nyanko3141592/pendant-recorder/firmware/README.md

# Firmware authority

現行製品ファームの正本は [`stm32/`](stm32/) です。

このディレクトリ直下の `platformio.ini`、`include/`、`src/` は初期XIAO ESP32S3評価用の履歴スタブで、現行PCB、製造書込み、回帰試験の入力ではありません。ビルド、発注、動作判定に使用しないでください。
