nyanko3141592/pendant-recorder/mechanical/rounded-v6/README.txt

丸み付き v6 / 外観・サイズ・持ち心地の印刷試作

外形: 26 x 31 x 14 mm（v5と同じ）
四隅: R5 mm、表裏の縁: R3 mm。紐穴は丸めた縁を避けて内側へ移動。
USBの位置を示す浅い凹み付き。これは完成ケースではなく中実の外観ダミー。

おすすめ印刷:
print/rounded_front_half_print_flat.3mf
print/rounded_back_half_print_flat.3mf
上記2点を100%・mmで印刷。モデルは分割面をベッド側、Z=0に配置済み。
0.2mm積層、3周程度の壁、15%程度のインフィルを初期目安に、スライサーで確認。
平面同士を合わせ、紐穴を揃えて薄い両面テープ等で仮固定する。
2枚の厚さ合計14mm。テープ厚は追加される。嵌合ピン・爪はない。
USB凹みの上面はブリッジになるのでスライサーで確認。

一体版: print/rounded_whole_26x31x14.stl / .3mf
一体版は下側の丸みにサポートが必要になる場合がある。
3MFは形状データで、プリンター固有の印刷設定やG-codeは含まない。

収納検討:
公称0.8mm壁を想定した簡易断面包絡のチェックでは、電池とUSB以外の部品包絡は内側。
ただし現行24x27mm基板の角は最大約1.46mm侵入する。USBは専用開口が必要。
基板の角丸化には銅箔・配線の再設計とDRC再検証が必要で、このv6では回路を変更していない。
包絡チェックは完成部品STEPによる厳密干渉検査ではない。
このモデルには電池・基板を収納できない。v5の収納模型と混同しない。
16時間駆動、電池NTC/ハーネス、部品公差、固定方法は従来どおり未確認。

比較画像: 青が今回のv6、灰が旧v5。同じ26x31x14mm。
STL3点の閉メッシュ、接続成分1、正体積、面向き、寸法、Z=0を検証済み。
実印刷、全三角形の自己交差検査は未実施。
