nyanko3141592/pendant-recorder/mechanical/compact-ab/README.md

# A/B SolidCraft study — not a production release

See [review](../../docs/compact-ab-review.md). Run `python3 mechanical/compact-ab/generate.py` then `analyze.py` from the repository. Render JSON using solidcraft-cli run/snapshot. STEP and solidcraft files are generated models, not supplier component CAD. All 75 KiCad footprint envelopes are represented.
