nyanko3141592/pendant-recorder/hardware/rev-e/README.md

# Rev E0 — XE完成電池への回路・配置変更

発注不可。D1.1から別版を作成。J2をMolex0781710003の3ピンに変更（1 BAT、2 BAT_TS、3 GND）。基板NTC TH1を除き、完成電池DTP401525-XEのNTCを利用する回路ドラフト。NTC定数、充電温度適合が未解決であり、BQ25101を採用確定したものではない。

25×31×0.8mm、6層を仮継承、75フットプリント。主要部品はD1.1の配置を基板中心座標へ変換して継承した初期案。**未配線**。回路図はERC0、配置DRC0（未接続を別集計）。配線完成や電気品質の保証ではない。J2の実装調達・全品番の受理・USB帰路・発振・電源を継続レビューする。製造ファイルは出力していない。

`generate.py`はこのE0を再生成し、Eの手編集・配線を上書きする。D1.1は変更しない。生成にはKiCad同梱Pythonを使用する。現時点でEを製造リリースへ昇格させない。
