nyanko3141592/pendant-recorder/mechanical/structure-d1/README.md

# D1 円形ケース・円形基板の構造モデル

2026-10-24。ユーザーの「再設計して再度比較出せ、モデリングも済ませろ」に対応。SolidCraftの組立/分解モデル、STEP、画像を作成した。**製造用筐体の完成ではなく、実配置に基づく構造検討の完成。**

- [同縮尺比較：正面と側面](comparison-scale.png) / [SolidCraft上面比較](comparison.png)
- [分解モデル](exploded.png) / [透過モデル](cutaway.png) / [USB側外観](usb-side.png)
- [実フットプリント配置](placement.png)
- [組立STEP](assembled.step) / [分解STEP](exploded.step)
- [組立SolidCraft](assembled.solidcraft) / [分解SolidCraft](exploded.solidcraft)

## 寸法

| 項目 | 旧C0 | 角丸D0 | 円形D1 | Omi参照 |
|---|---|---|---|---|
| ケース | 23.8×34×14mm | 25.5×25.5×14.5mm | **直径25.5×厚14.5mm** | 直径25.5×厚15mm |
| 基板 | 21×31mm | 23×23mm | **直径23mm** | 今回は比較対象外 |
| 外形体積概算 | 11.28cm³ | 9.28cm³ | **7.41cm³** | 円柱近似7.66cm³ |

D1はD0比約20.2%減、C0比約34.4%減。Omiと直径が同じで厚さは0.5mm小さい設計枠。Omiの実際の曲面/装着部形状とは異なるため「実製品より小さい」とは断定しない。比較図の500円玉は径26.5mmのスケール参照。

## 構造と仮定

基板の全部品位置は `hardware/omi-fit-d1/placement.json` と共通。旧案を円形に切り取った絵ではなく、全76参照を再配置した。U9を小型UQFNへ変更し、USB-Cボディを基板端から張り出させた。USB開口と簡略ソケット口もモデルに含む。

金色はD17×6.1mmの**完成パック目標包絡**。メーカー保証済み完成品ではない。オレンジは保護回路/配線の予約、青緑の小片はPCB実装NTC用の絶縁熱伝導パッド候補。線材予約とC15が当たる配置を修正し、予約位置を(9.4,4.0)mmへ移した。完成ハーネス全体の配線経路は未確定。

基板下面9.1mm/上面9.9mm、電池上面7.3mm、蓋下面13.5mm。裏面部品1.5mmとしたとき電池との名目隙間0.3mm、USB高さ3.2mmとしたとき蓋まで0.4mm。部品は簡略包絡で、全品のメーカーSTEP/公差/はんだフィレットを再現していない。モデルのPCBに全穴を彫り込んだものでもない。

固定爪/ねじ、装着部、マイク音道、LED導光、ボタン延長、実際の電池膨らみ・線材・嵌合は未検証。従って装着部込みの製造外形は未確定、STLをそのまま発注できる段階ではない。

## 電池持ち

[感度分析](runtime.png)は前案と同じ150mAhの仮定。使用可能容量70%・平均5mAで21h、6mAで17.5h。円形化そのものを省電力効果として加算しない。電池・ファーム実測、SPICE、熱シミュレーションは未実施。

## 再生成

`generate.py` → SolidCraft CLIで `assembled.json` / `exploded.json` をrunし、`.solidcraft`とSTEPを保存。`compare.py`は比較CAD、`plots.py`は配置・同縮尺図・稼働時間感度を生成。現状は `hardware/omi-fit-d1/order-status.json` に従い発注不可。
