nyanko3141592/pendant-recorder/mechanical/xe-minimal/home-case-slice-review/README.txt

角丸接着ケース候補・PLA造形検討用（完成設計ではありません）
A1 mini / 0.4mm / Generic PLA / 0.16mm。上下別々、開口を上に配置。
公式プロファイル継承を展開してスライス成功。実際のフィラメント銘柄とプレート設定は使用前に確認。
STLと3MFは現行候補の形状確認用。マイク筒の押出経路、接着面、電池の元配線とプラグ、実物公差は未確認。
上下合計のスライサー推定使用量約2.95g。実測ではありません。プリンタ送信・印刷はしていません。
