nyanko3141592/pendant-recorder/hardware/compact-b/routing-v2/README.md

# Rejected route-only trial

Original placement, longer routing pass budget. Final KiCad9violations,6unconnected,0parity. Not promoted. See electrical-placement-v3 for the improved result.
