nyanko3141592/pendant-recorder/hardware/omi-fit-d1/routing/README.md

# D1配線試行 — 発注不可

2026-10-24。配置だけのD1から4層の配線を試行。現在の正本は上位の `omi-fit-d1.kicad_pcb`。Freerouting 2.5.0の最初の試行を採用し、0.1mm未満のネックダウンを0.1mmに修正した。後続refine試行は未接続が増えたため不採用。

KiCad 10で回路図等価性を含めDRCを実施：未接続53件、違反8件（USB NPTHとの銅箔間隔4件、末端配線4件）、等価性問題0件。`../order-status.json` はPCBハッシュを含む。876というtracks値はビアを含むKiCadオブジェクト数で、完成率ではない。

プロジェクトの最小線幅/クリアランスを0.10/0.10mmへ変更した。検査除外は追加していない。穴クリアランス0.20mmは維持し、現状0.1944mmのUSB違反を残した。JLCPCBの公開多層板能力は0.09/0.09mmだが、この設計のPCBA受理・歩留まりを保証するものではない。

出典（確認2026-10-24）：https://jlcpcb.com/capabilities/Capabilities

自動配線が通った部分も、電源電流・デカップリング経路・USB差動対・水晶・マイククロック・GND帰路をレビューしていない。単なるDRC通過を設計完了にしない。回路の機能検証も未了。現在の部品配置は幾何的収納を優先したもので、電気的な再配置が必要になる可能性がある。

`route.py` のexportは旧試行条件を書き戻すため、正本に無条件で再実行しない。`place.py` も配線を失う。試行ファイルは再現・比較用で製造入力ではない。

孤立ビア4個を除去した結果、接続先を持たない末端配線4件が残る。未接続の経路を確定してから処理する。
