nyanko3141592/pendant-recorder/hardware/xe-minimal/preorder-20261029/release-review-20261029-aligned/first-prototype/README.md

# 初号試作の入口 — 2026-10-29

**採用する設計は一つ。回路・基板は b3cdfc064b43…の27.5mm角4層、固定DTP401525-XE 110mAh、保存MKDV8GIL-AST。C30のみ同定格のFH 0402CG500J500NT/C501830へBOM変更。ケースは配線端部を広げた約30.8×37.5×14.2mm。** 注文・支払・製造upload・業者連絡・実印刷は実施していない。

## 1. 成立見込みと手配判断

[部品別の計算値と感度](performance.json)では、室温の条件付き平均3.863mA、110mAhの70%使用可能という仮定で19.93時間、60%なら17.09時間。MCUは16MHzで常時Runの典型1.3mAを使用し、Sleep dutyによる有利な削減を入れない。周辺回路0.5mAとその他0.05mAは設計上の仮定。コア典型値を実ファームの保証値と呼ばない。

保存電流40mA/standby0.13mAは**採用部品自身のSD4wire/50MHz/25℃の値**であり、SPI4MHzへ適用できるとの保証はない。10秒周期の活動時間0.35秒を置く。このうちpayloadの線上時間は0.162344秒、残り0.187656秒をFAT・directory・busy等へ見込む。活動0.5秒なら約4.461mA/17.26時間、1秒なら約6.454mA/11.93時間（いずれも70%容量仮定）。0.35秒でも周辺回路が見積りより1mA多ければ約15.84時間。**16時間を狙う試作には合理性があるが、達成確率や最悪条件を証明したものではない。** 平均4.4mAは配分目標で、机上合格に置き換えない。

保存は10秒81,172byte、30時間payload876,657,600byte。FAT32/4KiB・3session端数・最大TMP/次ファイル等を含む必要data領域929,787,904byte。FAT等は別領域。合成媒体の現FatFs試験は既存証拠を利用し、実媒体容量は初回format時に読んで検査する。

[5台費用・購入先・数量](cost-and-supply.json)：部品と計画予備分約$375.34、全体予算**$695～1,045（換算仮定154円/USDで約10.7～16.1万円）**。正式見積ではない。全36電子部品行に単価を割り当て、工程、基板小径孔加算、書込み/format/治具/X-ray、税送料、5個の開発用電池、ケース材料、接着・絶縁材、紐を別枠で含めた。手持ち測定器・PC・プリンタを使用する想定。人件費と新規測定器は含まない。販売価格5,000円の達成は主張しない。

U1/U12/J1はJLCの通常Pre-orderを採用する。初期計画数は7/11/12個、最終必要数は実装ロス計算で置換する。部品支給・個別交渉・購入者のはんだ付けを前提としない。在庫/価格/納期は確約ではなく、**必要部品の入庫を確認してから基板注文**という実行条件。C30は在庫不足だったYAGEOから同じ50pF/50V/C0G/±5%/0402へ変更し、公開実装可能45,731個を確認した。新部品の外形上限をゲージへ追加した。

製造は一般4層・0.8mm・両面Standard PCBA・通常through via。0.15mm孔6本は公開多層能力内の追加料金対象として残す。**初号試作には有償の全経路90Ω認定を要求せず、90Ωを配線目標にした非認定試作**を選ぶ。根拠とリスクは[電気・製造判断](electrical-and-execution.md)。量産USB適合とは別。

## 2. ケースと組立

[同版機構](../mechanical-first-prototype/)に編集用生成スクリプト、STEP/STL、5物体3MF、組立/分解STEP、分解図、組立手順を揃える。旧30.8mm角ケースは保全し、純正配線を除外した旧結果を現物の完成証拠には使わない。

今回の配線モデルは12/15/18mmを対象に、半径約2.89mmのU字通路と根元の直線部分を確保。被覆外径0.8mm・片側余裕0.2mm、線出口/嵌合位置は保守的な**設計仮定**でありメーカー保証値ではない。15±3mmを全て自由曲げ長さにしていない。赤い複数曲線は通路のサンプルで、全長の線を同時に入れるものではない。公式ヘッダの無効STEPは使用しない。

電池は面で底受けし、側方ガイドとキャリアで保持。キャリア裏へ総厚0.10mmの絶縁材を工場貼付し、最大パック上に0.4mmの成長予約を残す。膨張を許容する安全認定値ではない。蓋は6か所の深さ0.15mm接着ポケットと既存の位置決め/停止面を併用し、接着層によって蓋を持ち上げない。PETGと接着剤の実強度はダミーケースで試験する。

## 3. 同期・検証と残条件

[検証結果](verification.json)に基板hash、回路/ERC/DRC、ファーム40試験の現source一致、BOM一致、CAD干渉、3MF寸法、slice結果を集約する。ファームは未変更なので40試験を無目的に繰り返さない。既存ARM出力はNOT-FOR-FLASH fixtureのまま。

| 区分 | 判定 |
|---|---|
| 採用構成・条件付き性能・費用範囲 | 設計判断を記載済み。仮定の実機確認は試作後 |
| 回路/基板/CAM/BOM/CPL | 同版。C30のBOM置換を反映。業者placement preview/DFMは注文時の実行条件 |
| 配線込み機構設計・接着方法・実寸キット | 一案に具体化。寸法仮定内のCAD確認。純正現物の適合は未確認 |
| 実機・安全・16h・30h・3OS・装着・強度 | 未測定。初号試作の評価項目 |
| 書込み済み完成品/製造開始 | **未完**。正式USB ID、初期通電とcutoff設定、実媒体format/identity、工場工程の確定が必要 |

したがって、**条件付きの初号試作設計パッケージであり、直ちに発注できる書込み済み製品パッケージ、物理性能保証、量産releaseではない。** 足りない実物やIDを捏造して全体完成とはしない。必要な次工程は[実行手順](electrical-and-execution.md)にまとめた。

同縮尺の[Omi比較](../mechanical-first-prototype/omi-reference-comparison.png)と比較STEPも同梱。公開2.5×1.5cmから直径25×厚さ15mmと解釈した参考包絡で、製品CADや付属ケース込み寸法は確定していない。本案は平面寸法でOmiより大きい。
