nyanko3141592/pendant-recorder/docs/validation/2026-10-24-rev-c0-design.md

# Rev C0設計検証記録 — 2026-10-24

対象: USB-C、連続録音16h以上、小ささ優先、無線なしの再設計。V1はdocs/v1-scope.md。

|確認|結果|
|---|---|
|KiCad回路図と接続表|76参照、232接続ピン、22 NC、49ネット一致|
|ERC|0|
|PCBと回路図のKiCad等価性|差分0（ネット階層名と基板接点BOM属性を同期）|
|PCB物理パッド所属|260パッド、254論理ピン一致|
|配置|実フットプリント、21×31×0.8mm、4層両面|
|配線|未完了。DRC 5、未接続67。発注不可|
|収納|23.8×34×14mmのCAD案。PH嵌合/未加工線材/音道/NTC/固定/公差は未検証|
|16h録音・36h保存|未実施|
|充電・温度・電源断|未実施|
|暗号化・3 OS同期|本番ファーム/CLI未実装|
|JLC実装受理・購入|未実施|

`hardware/tools/verify_design.py <kicad-cli> rev-c` と KiCad Pythonの `check_rev_c.py` を実行。後者は未達のためexit 2で発注不可を返す。結果・原本SHA256はhardware/rev-c/order-status.json。図面ができたことを実機試験合格と扱わない。

配線試行2回目はルータが違反を報告したため原本へ取り込まず、初回配線＋GND整備・孤立銅除去の版を保持。完全性確認前のGerber/CPLの発注ZIPは出力していない。

次の改版は、USB/電源とデカップリングを手動で再配置・配線、全ピン/公差/部品受理、完成パック・治具・ケースの実寸収納を確認してから進める。現Rev Bと比較して面積を減らした代わりに厚さを増やしたことを残す。
