nyanko3141592/pendant-recorder/hardware/xe-minimal/fabrication-review-d0c7ca1c4a31/drill-report.txt

Drill report for pendant-xe-minimal.kicad_pcb
Created on 2026-10-28T17:00:15

Copper Layer Stackup:
    =============================================================
    L1 :  F.Cu                      front
    L2 :  In1.Cu                    in1
    L3 :  In2.Cu                    in2
    L4 :  In3.Cu                    in3
    L5 :  In4.Cu                    in4
    L6 :  B.Cu                      back

Drill file 'pendant-xe-minimal-PTH.drl' contains
    plated through holes:
    =============================================================
    T1  0.150mm  0.0059"  (220 holes))
    T2  0.200mm  0.0079"  (7 holes))
    T3  0.600mm  0.0236"  (4 holes)  (with 4 slots)

    Total plated holes count 231

Drill file 'pendant-xe-minimal-NPTH.drl' contains
    unplated through holes:
    =============================================================
    T1  0.650mm  0.0256"  (2 holes))
    T2  0.800mm  0.0315"  (1 hole)

    Total unplated holes count 3
