nyanko3141592/pendant-recorder/hardware/omi-fit-d1/manufacturing-review/drill-report.txt

Drill report for omi-fit-d1.kicad_pcb
Created on 2026-10-25T00:14:27

Copper Layer Stackup:
    =============================================================
    L1 :  F.Cu                      front
    L2 :  In1.Cu                    in1
    L3 :  In2.Cu                    in2
    L4 :  In3.Cu                    in3
    L5 :  In4.Cu                    in4
    L6 :  B.Cu                      back

Drill file 'omi-fit-d1-PTH.drl' contains
    plated through holes:
    =============================================================
    T1  0.150mm  0.0059"  (121 holes))
    T2  0.600mm  0.0236"  (4 holes)  (with 4 slots)

    Total plated holes count 125

Drill file 'omi-fit-d1-NPTH.drl' contains
    unplated through holes:
    =============================================================
    T1  0.600mm  0.0236"  (1 hole)
    T2  0.650mm  0.0256"  (2 holes))
    T3  0.991mm  0.0390"  (3 holes))

    Total unplated holes count 6
