nyanko3141592/pendant-recorder/hardware/mini-rect-v15/input-control-pa2-pb5/manufacturing-review/drill-report.txt

Drill report for usb-reference-power.kicad_pcb
Created on 2026-10-26T14:46:47

Copper Layer Stackup:
    =============================================================
    L1 :  F.Cu                      front
    L2 :  In1.Cu                    in1
    L3 :  In2.Cu                    in2
    L4 :  In3.Cu                    in3
    L5 :  In4.Cu                    in4
    L6 :  B.Cu                      back

Drill file 'usb-reference-power-PTH.drl' contains
    plated through holes:
    =============================================================
    T1  0.150mm  0.0059"  (5 holes))
    T2  0.200mm  0.0079"  (131 holes))
    T3  0.600mm  0.0236"  (4 holes)  (with 4 slots)

    Total plated holes count 140

Drill file 'usb-reference-power-NPTH.drl' contains
    unplated through holes:
    =============================================================
    T1  0.650mm  0.0256"  (2 holes))
    T2  0.800mm  0.0315"  (1 hole)
    T3  0.991mm  0.0390"  (3 holes))

    Total unplated holes count 6
