nyanko3141592/pendant-recorder/hardware/xe-minimal/electrical-panel-candidate-v3/fabrication-review-09330db63317/drill-report.txt

Drill report for panel.kicad_pcb
Created on 2026-10-27T08:34:01

Copper Layer Stackup:
    =============================================================
    L1 :  F.Cu                      front
    L2 :  In1.Cu                    in1
    L3 :  In2.Cu                    in2
    L4 :  In3.Cu                    in3
    L5 :  In4.Cu                    in4
    L6 :  B.Cu                      back

Drill file 'panel-PTH.drl' contains
    plated through holes:
    =============================================================
    T1  0.150mm  0.0059"  (1518 holes))
    T2  0.600mm  0.0236"  (24 holes)  (with 24 slots)

    Total plated holes count 1542

Drill file 'panel-NPTH.drl' contains
    unplated through holes:
    =============================================================
    T1  0.500mm  0.0197"  (72 holes))
    T2  0.650mm  0.0256"  (12 holes))
    T3  0.800mm  0.0315"  (6 holes))
    T4  2.000mm  0.0787"  (3 holes))

    Total unplated holes count 93
