nyanko3141592/pendant-recorder/hardware/xe-minimal/preorder-20261029/release-review-20261029-aligned/drill-report.txt

Drill report for pendant-review.kicad_pcb
Created on 2026-10-29T13:47:25

Copper Layer Stackup:
    =============================================================
    L1 :  F.Cu                      front
    L2 :  In1.Cu                    in1
    L3 :  In2.Cu                    in2
    L4 :  B.Cu                      back

Drill file 'pendant-review-PTH.drl' contains
    plated through holes:
    =============================================================
    T1  0.150mm  0.0059"  (6 holes))
    T2  0.200mm  0.0079"  (139 holes))
    T3  0.600mm  0.0236"  (4 holes)  (with 4 slots)

    Total plated holes count 149

Drill file 'pendant-review-NPTH.drl' contains
    unplated through holes:
    =============================================================
    T1  0.650mm  0.0256"  (2 holes))
    T2  0.800mm  0.0315"  (1 hole)

    Total unplated holes count 3
