nyanko3141592/pendant-recorder/hardware/xe-minimal/preorder-20261029/release-review-20261029-aligned/evidence/xe-integrated-16h-budget.md

# DTP401525-XE 統合16時間電流予算

状態: **配分値は未実測。初号試作の条件付き見積りは first-prototype/performance.json。実機性能合格とは別。**

## 配分値の扱い（初号試作判断は別の部品別見積りを参照）

DTP401525-XE（110mAh）と要件は維持する。最終機の録音中平均電池電流を **4.4mA以下**、かつ本体充電後から録音停止電圧までに使える容量を **70.4mAh以上**にできれば16時間に届く。ただし現状の2.8mA非ストレージ値は配分仮説で、完成品の保守的上限計算はない。CPUをMSIS 16MHz、SPIをPCLK2へ移して録音中の不要なHSI16常時動作を削除したが、削減量と16時間は未実測である。

| 境界 | 値 | 扱い |
| --- | ---: | --- |
| 公称容量だけの理想上限 | 6.8750mA | 劣化・低温・終止電圧等を含まず設計値にしない |
| 70%使用可能仮定の上限 | 4.8125mA | 計画上限、未保証 |
| 採用する平均電流目標 | 4.400mA | 16hで70.4mAh |
| 完成パック瞬時電流上限 | 110mA | パルス超過を認めない |

## 録音・暗号化・保存

16kHz・モノラル、10秒ごとにage v1で暗号化し、現行codec実行で81,172byte/10秒を確認。30時間の暗号化payloadは876,657,600.0byte。選定MKDV8GIL-ASTは8Gbit＝1GB公称。3 sessionの端数・4KiB割当・ディレクトリ・中断/次ファイル余裕を含む必要data領域は929,787,904byteで、FAT等は別に必要。実媒体の全容量・電流・起動ピークは未認定。旧20%余裕の数値は現設計の合格条件に使わない。

## 4.4mAの配分

| 負荷 | 配分/下限 (mA) | 証拠の強さ |
| --- | ---: | --- |
| 非ストレージ基礎枠 | 2.800000 | 配分仮説、未実測 |
| └ 公開最大値を明示できたマイク・充電IC・比較器 | 0.386500 | 各資料の限定条件。完成品全条件の上限ではない |
| └ MCU・IMA・age・レギュレータ・スイッチ等の残余枠 | 2.413500 | 実ファームで測定必須 |
| 温度guard・BOR | 0.100725 | 回路上の予備枠 |
| 表示LED（通常録音） | 0.000000 | 自動表示無効のリリース構成。故障表示は別状態 |
| ストレージ総枠 | 1.499275 | 完全な10秒周期で積分して判定 |
| └ payload転送だけの条件付き下限 | 未確定 | CSNP32は別部品のため現部品の根拠に使わない |
| └ command/metadata/busy等の残枠 | 未確定 | 現MKDV8GIL-ASTの全周期積分が必要 |

2.8mAを実測値として扱わない。最終判定は電池側の全セッション積算を正とし、内訳測定は原因分離に使う。

## 試作合格ゲート

1. 本体充電から開始した完全な16時間録音で電池側積算70.4mAh以下、かつ16時間を通して録音継続。
2. 温度・電池個体・経時条件を含む最悪条件でも16時間合格。満たさなければ平均電流を下げ、容量要件は変更しない。
3. 電池電流は常時110mA以下。保存起動・書込みでリセット、音声欠落、破損なし。
4. 全10秒区間を復号・連結検査し、連番欠落と時刻連続性を確認。
5. 選定保存部品をほぼ満杯・断片化状態でも30時間、電源断復旧を含めて合格。

詳細な機械可読値と出典hashは `xe-integrated-16h-budget.json` に記録した。
