nyanko3141592/pendant-recorder/THIRD_PARTY_NOTICES.md

# Third-party materials

本リポジトリの独自コード・設計ソース・ドキュメントはルートのMITライセンスで公開します。第三者のファイルと権利表示は上書きしません。

- `reference/omi/`: BasedHardware/omiからの参照資料。元の通知は `reference/omi/LICENSE-omi-root.txt`、取得元・対応は `reference/omi/README.md` を参照。改変していない参照資料です。
- KiCad標準フットプリントをPCBへ埋め込み、標準3Dモデルを外部参照しています。ルートMITをKiCadライブラリそのものへ再適用しません。配布時は使用ライブラリのライセンス・例外・必要通知を確認します。
- Whisper実装・モデル重み・将来の要約モデルのライセンスは各配布元に従います。モデル重みは現リポジトリに同梱していません。アプリ同梱・商用配布前にモデルごとに権利と通知を確認します。
- データシートへのリンクは設計根拠です。メーカーの資料・商標をこのプロジェクトのMITで再許諾するものではありません。

依存物全体のライセンス監査は未完了です。新たな第三者素材を追加する際は、出典、バージョン、ライセンス、変更有無をここに追記してください。
