nyanko3141592/pendant-recorder/docs/density-study.md

# 非円形の高密度配置 — 履歴検討

> **履歴資料・発注禁止。** Rev A1、20×34mm、24時間、旧充電設定は失効済み。現行候補は [`requirements.md`](requirements.md) と [`hardware/xe-minimal/active-design.json`](../hardware/xe-minimal/active-design.json)を正本とする。

> 最新: [既製電池の調達を起点に最小化](battery-sourcing.md)。DTP401525(PHR) 110mAhを第一候補とし、外形24×24×14mm・基板21×21mmへの固定を解除。メーカー最大充電55mAに対する現回路50mAの公差確認は未完了。

2026-10-24: ユーザー指示「円形じゃなくてもいいよ、密度上げて」。円形基板・円形ケースの制約を解除する。Omi相当の小ささ、連続24時間録音、USB-C直挿し、充電のみ、全インジケーター、個人での最終組立は維持する。

## 初期配置枠

外観を先に固定せず、角丸四角を第一の配置検討枠とする。以下は寸法予算であり、実部品の配置・配線で成立を確認したサイズではない。

| 比較 | 外形の検討寸法 | 正面面積 | 外形容積の概算 |
|---|---|---:|---:|
| 以前の円形案 | 直径25.5×厚さ15mm | 約511mm² | 約7.66cm³ |
| 第一検討: 角丸四角 | 24×24×厚さ14mm、平面の角R4 | 約562mm² | 約7.87cm³ |
| 比較: 角丸長方形 | 22×26×厚さ14mm、平面の角R3 | 約564mm² | 約7.89cm³ |

四角案は円形案とほぼ同じ外形容積で、幅・高さが24mm、厚さが1mm減る予算。角に基板領域を確保できる。面積は `幅×高さ−(4−π)×角R²`、容積はその面積×厚さ。表面の丸み、紐取付部などは含まない。容積が同程度でも装着感が同じになるとは限らない。

基板の第一検討枠は**21×21mm、角R3、4層、両面実装可**。面積約433mm²で、以前の直径22mm基板の約380mm²に対して約14%多い。これは配線可能面積の保証ではなく輪郭面積の比較。USB・固定・音孔・部品間隔で実際の有効面積は減る。

## 密度を上げる実装方針

1. MCU、SD NAND、電源、マイクを単一基板にまとめ、モジュール間コネクタを設けない。MCUの実装面積は本体だけでなくランド・配線引出しまで含めて比較する。
2. 部品は両面へ配置可能とする。電池下の高い部品を避け、電池のタブ・保護回路・絶縁を含めた立体配置で検討する。
3. USB-Cは一辺に置き、ケーブル根元と固定脚の空間を最初に確保。マイク音孔と音響シール、LED遮光、操作ボタンは残り隙間へ無理に押し込まない。
4. 書込み端子はSWDパッドと外部ポゴ治具。測定点もパッド化し、常設ピンヘッダは装着用に載せない。通電後に測定できる位置を確保する。
5. 抵抗・コンデンサは現回路の0402級を基本に業者実装。0201やHDIで無理に縮める前に配置とパッケージ選択を詰める。MCU小型化は端子・SDMMC・通常ビアでの引出し・業者対応を確認して決定する。
6. ケースはシンプルな3Dプリント。角丸輪郭は内部配置から調整し、固定部と電池の余裕を削って密度を稼がない。

最新目標は連続24時間。平均2.0mA以下・100mAh級を初期候補に80〜150mAhを比較する（[電力予算](runtime-target.md)）。16mm径の既存セル候補を比較基準として残すが、角形パウチも調達・容量・保護付きパック寸法を調べて比較する。**角形にしただけで容量や録音時間が増えるとは扱わない。** 210mAh・24mm径の比較セルはこの24mm外形には収まらないので、旧28mm径案と同様に外形拡大が必要。

## 次の設計ゲート

実部品のフットプリントとパック図面を確定→21×21mm枠で両面配置→USB・音孔・固定部を含む3D干渉確認→配線・DRC→小ロット実装可否の確認。LQFP64の現回路ドラフトがこの枠に収まることはまだ確認していない。

本書は形状制約と配置予算の更新。PCBの配置・配線は未実施であり、実装密度を実測・実CADで改善済みという意味ではない。

## 薄型化の追加要件（2026-10-24）

ユーザー指定により、Omi相当の厚さを上限にする。Omi公式の2.5cm×1.5cm表記に基づき、暫定の完成厚さ上限を15.0mmとする。製品外装・蓋・突出部を含め、旧構造説明モデルの15.2mm案は採用しない。設計目標は12〜13mm、成立未確認。公式: https://www.omi.me/pages/product

薄型化はケースだけを薄くするのではなく、以下の配置変更を検討する。

1. 電池直上の基板裏面を部品禁止領域にし、裏面部品のための高さを削る。部品は表面と電池周囲へ集める。現在の自動配置には適用されていない。
2. PH端子・挿入済みプラグを厚さの支配部品として実寸監査する。電池と重ねず端部に置く案は長さが増えるため、外形容積も比較する。付属100mm配線を省略・切断して成立扱いにしない。
3. LQFP64は本体10mm角でパッドを含め約13.45mm角を使う。SDMMCを備えた小型パッケージへの変更で、デカップリング込みの表面集約を検討。新パッケージの端子・調達・JLC実装受理を確認するまで採用確定しない。
4. 電池最大4.2mm＋基板0.8mm＋表面部品最大高さ＋底/蓋＋絶縁・膨張・組立余裕で厚さを積算する。裏面部品をなくすだけで、現モデルの基板下1.8mmの一部を削れる。ただし電池上の余裕はゼロにしない。

24時間録音と手はんだゼロは維持。12〜13mmは新たな設計目標であり、未配線A1や現3Dモデルが成立した寸法ではない。

### A2モデル追加

[薄型構造モデル](../mechanical/structure-a2/README.md)を作成。PH端子を電池の端に並べ、90部品の表面配置枠を確保する機械案。仮外形24.8×41.5×12.8mm。厚さ15.8%減・外接容積4.9%減、平面面積12.9%増。A1回路・未配線PCBは変更していない。完成厚さや電池プラグ/配線収納の成立は未確認。
