nyanko3141592/pendant-recorder/docs/open-questions.md

# 未決事項

> **履歴資料。** 以下は初期XIAO/ESP32/Rev A検討時の質問で、現行候補の未決一覧ではない。現行の未確認事項は [`validation/xe-release-evidence-matrix.json`](validation/xe-release-evidence-matrix.json) と [`prototype-v1-order-decision.json`](prototype-v1-order-decision.json)を正本とする。
1. 実際の平均電流: ESP32S3で低いクロック＋声の検知にしたとき、平均がいくつになるか（目標30mA以下）
2. 電池の容量と重さ: 何mAh・何gまでなら首から下げて苦にならないか
3. 常時録音か、声の検知か: 検知で言葉の頭が切れないか（前後に1〜2秒残すバッファが必要）
4. マイクの音質: 服にこすれる音、歩くときの揺れ、会議室での相手の声の拾い方
5. USB MSCのコピー速度: 1日分（約1.8GB）にかかる時間。遅ければカードを抜く運用にするか
6. 時刻: Macから時刻を渡す方式で十分か、外付けRTCを入れるか
7. ESP32S3のVBUS検知ピンと、電池電圧を読むピンの有無（XIAOの回路図で確認）
8. nRF52840へ移るかの判断基準（例: 実測で平均40mA超なら移る）
9. 録音の同意とプライバシー: 職場・家族・外出先での扱い、録音中を示す表示
10. SDのデータの暗号化をするか（落としたときの対策）
11. Mac側: どの要約モデルを使うか、Notionのどのデータベースに保存するか

## Omi-cloneパス追加分（2026-10-24）
12. Bパス（XIAO nRF52840 Sense）で録音＋SD書き込み時の平均電流（Omiに公開の実測値なし）
13. 保存形式: WAV か Opus（Omiは32kbps CELT）か。Opusならコンテナ（Ogg）をどうするか
14. Zephyr USB MSC と SPI SD の組み合わせのコピー速度（DK2はSPI 24MHz）
15. T5838のAAD（音で起動）をXIAO構成に後付けするか
16. DK2の「offline storage は実験的」部分の安定性（Omi firmware/readme.md の注意書き）
17. Omi DK1の電池容量・XIAO内蔵マイクの型番（Omi側資料に記載なし）
18. 本番基板: nRF5340を使うか nRF52840 で十分か（BLE/Wi-Fiは不要）

## カスタム基板の追加分（2026-10-24, 要件確定後）
19. STM32U535の録音中の実平均電流（ADF＋LPDMA＋間欠SDMMC）。目標1.5mA、上限3mA
20. nRF52840カスタム基板との差は実測でどれくらいか（差が小さければOmiコード流用のnRF52840へ切替）
21. ADPCM（4bit）が kotoba-whisper の精度に影響するか（PCMと同じ音で比較）
22. USB FS MSC の実効速度（1日分0.46GBが10分以内か）。足りなければUSB HS内蔵のSTM32U5上位品を検討
23. USB接続中の充電電流とシステム電流の配分（BQ25101はパワーパスなし）
24. SD NAND の待機150µAを、ロードスイッチで切って再初期化する方が得か
25. 小型ボタン型LiPo（70〜100mAh）の入手先と重さ
26. T5838 を1個か2個か（こすれ音・相手の声）
27. STM32U5 で ADF の音声検知と T5838 AAD のどちらを使うか
28. ファームを STM32Cube（USBX）で書くか Zephyr で書くか（Zephyr ならOmiの構成知識を流用しやすい）
