nyanko3141592/pendant-recorder/docs/v1-scope.md

# 小型USBレコーダーのV1範囲

現在の要件は[製品要件](requirements.md)へ一本化しました。電池を販売せず、購入者が指定の市販完成電池を別途買い、問い合わせ・配線加工なしで組み立てられることを必須とします。

旧版は[履歴](history/v1-scope-before-user-battery-20261026.md)へ保存しています。旧版を現在の動作・寸法・販売範囲の根拠にしないでください。
