nyanko3141592/pendant-recorder/docs/compact-fit-check.md

# A/B 組立フィット確認キット — FC1 / 2026-10-25

樹脂ダミーを個別に印刷し、ケースへ挿入して取り外し式の蓋を開閉するためのデータ。電気的に動作する試作ではない。元の外形模型は `mechanical/compact-ab/print-size` に保持し、今回のZIPにも `original-size` として同梱する。

成果物: `mechanical/compact-ab/fit-check`。A/B各フォルダの **body・lid・pcb_components・battery** が必須4点。各STLと3MFは同じ形状で、どちらか一方を選ぶ。`harness_reservation` は任意の配線空間ゲージ。組立STEP/PNG、分解STEP/PNG、75部品の寸法CSV、出典スナップショット、検証JSON、再生成スクリプトを添付。

## 寸法と変更理由

|項目 mm|A 横並び|B 積層|
|---|---:|---:|
|元の比較用外形|38×39×8.9|20×39×14.5|
|今回のケース＋閉じた蓋|40×41×10.8|22×41×16.4|
|元との差（幅・長さ・厚さ）|+2・+2・+1.9|+2・+2・+1.9|
|ケース本体高さ|9.6|15.2|
|壁・底・蓋板|1.2|1.2|
|蓋の内側差込みリム高さ／幅|1.2／0.8|1.2／0.8|
|リムとケース内壁の片側隙間|0.3|0.3|
|基板素板|18×33×0.8|18×33×0.8|
|基板下面Z（ケース底外面を0）|3.2|9.0|
|電池ダミー|15.5×27×4.2|15.5×27×4.2|
|電池底Z／上面Z|1.5／5.7|1.5／5.7|
|USB仮包絡の上面Z|7.56|13.36|
|USB包絡〜蓋板下面|2.04|1.84|
|USB包絡〜リム最下面のZ差※|0.84|0.64|

※XYの重なりを無視した保守的な高さ比較。単なる高さ差を最短3D距離とは呼ばない。

FDMで扱える壁、基板を載せる支持部、蓋リム、取り出し隙間を確保するため拡大した。元の外形寸法で収納成立したという結果ではない。蓋は持ち上げて完全に外せる差込み式。爪でロックするスナップ蓋・ヒンジ・首掛け強度の設計ではなく、ケースを水平に置いて繰り返し開閉する確認治具。保持が必要なら外側に仮止めテープを使う。USB開口は包絡を見るための開口で、実ケーブルの樹脂モールド挿入を保証しない。マイク音道、光学部品、紐固定部はこの治具では再現していない。

## 基板と部品の根拠

最新配置 `hardware/compact-b/electrical-placement-v3/compact-b.kicad_pcb` を `source/compact-b-v3.kicad_pcb` に固定コピー。元の基板を変更せず、保存されたPCBからKiCad APIで75フットプリントを再抽出した。`source/provenance.json` にSHA-256、基準コミット6e84b9a、抽出方法を記録。以後の回路改訂を自動追従しない。

部品のXYは `GetBoundingBox(False,False)` の軸平行包絡であり、ランド・図形等を含む。メーカーの樹脂ボディ寸法でもメーカーSTEPでもない。最新配置の両面部品位置を反映するが、高さは全75点とも未資格化の仮定。標準0.6mm、U系1.2mm、U4/U6 1.5mm、J1 3.56mm、J2 1.4mm、SW1 1.6mm、J3/TP系0.05mm。高さ表は `component-envelopes.csv`。はんだ、部品最大公差、嵌合後コネクタは含まない。

基板と75部品の包絡は印刷しやすい一つの連結ダミーへブーリアン結合した。基板と部品間の0.01mm重なりは連結用で、外側の名目高さは増やしていない。基板ダミーをケースや電池と一体化していない。75個の微小部品を別々に印刷するキットではない。

電池の15.5×27×4.2mmは既存調査で確認したDTP401525-XE完成パックの最大寸法。現物測定値ではない。参考資料は既存記録の [XE仕様書](https://www.aska-elt.jp/wp-content/uploads/DTP401525-XE.pdf)。電池ダミーに膨張・ラベル・線の出口・端子の精密形状は加えていない。

## 印刷

単位mm、100%。STLには単位メタデータがないので読み込み時に必ずmmを選ぶ。3MFはmillimeterを指定済みだが、プリンタ別プロファイルやサポート設定は含まない。

- ケース本体: 底外面Z=0を下、開口を上。0.4mmノズル、0.15〜0.20mm層、壁3周以上を出発点とする。USB開口上端は約11.6mmのブリッジになるため、ブリッジ品質が不足する機械では開口だけサポートする。底付き支持柱と電池位置決め部は本体と一体。
- 蓋: 配布姿勢のまま広い外面を下、差込みリムを上。サポート不要を想定。組立時は上下を反転。
- 電池: 15.5×27mm面を下。サポート不要。外周を研磨した場合は再計測する。
- 基板＋部品: 配布形状は両面部品があるので、そのまま平置きでサポートなしに印刷しない。推奨はスライサでX軸90°回転し、Y=0の18mm辺を下にして底面へ配置、5〜8mmブリム、両面の張出し部にサポート。精細ダミー用に0.25mmノズル／0.10mm層を推奨。0.4mmノズルでも概形確認はできるが、0.05mmのTP/J3や細部は再現されない。除去痕で包絡が変わるためノギスで確認する。導電・電気接続用ではない。
- ハーネス予約ゲージ／12・15・18mm長さゲージ: 平面を下。予約ゲージは配線の空間を見るための硬いU字形で、実ハーネスの代用品ではない。

PLAまたはPETGで試す。蓋保持力や素材間の摩擦は未試験。初層の象足はリムと電池を太らせるので、スライサ補正を使い、無理に押し込まない。基準は各部品の重要寸法を±0.10mm以内へ校正すること。リムと電池位置決め部の片側名目0.30mmは、両側がそれぞれ0.10mm内側へずれても0.10mm残る予算。未校正プリンタにこの精度を保証しない。噛む場合は拡大縮小で全寸法を変えず、リムの局所補正と再測定を行う。

## 組立と取り出し

ケースを底面から見た座標はX=幅方向、Y=長さ方向、Z=上方向。USB開口がY=41側。図と厳密な変換は `dimensions-and-assembly.json` を参照。

1. ケース内部のサポート材と糸引きを除き、電池ダミーを金色の図示位置へ入れる。AはX=2/Y=6、BはX=3.25/Y=6。底の0.3mm台へ載せる。
2. 基板ダミーはUSBの大きな包絡を開口側へ向け、真上から挿入。Aは基板左前端X=20/Y=5、BはX=2/Y=5。Bでは電池の上に載る。両側の4支持面で素板下面を受け、部品で支えない。
3. 任意のU字ハーネス予約ゲージを前端側に置いて空間を見る。固定脚はないので、指定Z位置に手で保持するか一時スペーサを使う。これを落とし込むだけで実配線が再現されるわけではない。
4. 蓋を反転してリムを下に向け、真上から差し込む。外面がケースと平行に着座するか、押さえなくても浮かないか確認する。指掛かりから持ち上げて外す。
5. 取り出しは蓋→任意ゲージ→基板→電池の順。Bの電池は先に基板を外す。部品包絡をこじって折らない。

## ハーネスの未確定部分

リード15±3mm、Molex781720003→基板0781710003は既存調査値。基板側はフットプリント包絡だけを再現し、プラグの嵌合体積は未資格化。線出口・線長の測定起点・最小曲げ半径・被覆径・抜差し空間が未確認なので、U字ゲージを「実ハーネスの収納合格」と読まない。

U字ゲージは幅1.2×高さ1.2mmの仮通路を直角に折った空間プローブ。実線の急な90°曲げを指示するものではない。Aの仮出口（電池前端中央）とJ2包絡中心の水平差だけでも13.875mmあり、最短12mmリードより長い。従ってAの無加工接続は引き続き未成立。Bも上下の立上り・実端子起点を含めた接続確認が必要。`gauges` の3本は端から端の長さ比較用であり、実端子や柔らかいリードを再現しない。実ハーネスで張力なく曲げられるかを次の判定に残す。

## 検証と合否の範囲

`mesh-validation.json` は各STLの閉鎖辺、向き、単一連結、正体積、退化三角形、実寸、Z=0、および3MFのmm単位を検査する。A/Bの `interference-results.json` は閉じた組立位置で5つの別体のCAD干渉を確認。`withdrawal-validation.json` は蓋→ゲージ→基板→電池の上方取り出しを、各8位置（0.2/0.5/1/2/5/10/20/40mm）で検査した結果。接触する支持面や蓋の着座面は意図したゼロ隙間接触。

検査済みのモデル範囲と数値は同梱JSONを正本とする。連続移動の掃引体積証明、全三角形の自己交差検査、スライサの実経路、実機印刷、実物収納、材料強度、保持力は未検証。回路の検査0件と、機械的な実物適合を混同しない。樹脂ダミーの確認後にも、部品メーカー最大寸法・完成電池・実ハーネス・最終基板で再検証が必要。

発注・支払い・メーカー送信なし。製造リリースではない。

## FC1 検査結果

2026-10-25: 新規13組のSTL/3MFの閉鎖性・向き・連結性・体積・寸法・底面・mm指定が合格。A/Bそれぞれ5別体の閉じた組立で干渉0件・未検査ペア0。上方取り出し32位置ずつも干渉0件。検査スクリプトは生成物へ実行済み。`verification-summary.json` に集約した。元の外形模型2組は別枠で同梱する。

基板スナップショットSHA-256: `bb008b24a45a0788baf1db2e281330f52219dc80b245e856f60debf003f03427`。

## Bambu用1ファイル版

`fit-check/Pendant_AB_FC1_Bambu_single-plate.3mf` にA/Bの必須各4点、U字ゲージ各1点、12/15/18mm長さゲージを独立した13オブジェクトとして配置。元の外形模型はこのプレートから除外。mm・100%、配置は180×180mm範囲内、全品Z=0、部品XY包絡間5mm以上。基板2点はX90°回転済み。Bambu Studio 02.07.01.62のCLIで13オブジェクトがmanifoldとして読み込めることを確認。実機スライスと印刷は未実施。

使用プリンタ・ノズル・フィラメントを選択し、基板にサポートと5〜8mmブリムを設定してからスライスする。プリンタ固有設定やG-codeを含めていない。部品ごとの設定を維持するため、13点を一つの固体に結合しない。配布先: https://drive.google.com/file/d/1XfIcfcTPnIoFeG9OYn47Z07OAXaiqqtG/view
