nyanko3141592/pendant-recorder/docs/procurement/xe-five-unit-current-estimate.md

# XE prototype v1 — 5台分の現行価格算術

> **正式見積りではない。発注禁止。** 公開部品ページと公開実装料金による部分算術で、完全着地額は未取得。

| 項目 | 5台分 USD | 扱い |
|---|---:|---|
| 実装数×公開単価（部品のみ） | 318.31 | PCBA課金を示す見積りではない |
| 実装数算術＋部分実装 | 463.43～474.14 | 公開単価と36/44 feeder仮定 |
| 部品ライブラリ事前購入＋部分実装 | 723.81～734.52 | 公開最低購入数を全行へ適用した保守シナリオ |
| 完全着地額 | **未取得** | 70mmキャリア5枚、POFV、JLC出荷前パネル除去・エッジ検査、書込み、電池、ケース、送料、税等が未算入 |

| 購入者側候補 | 5台分 JPY（税込） | 扱い |
|---|---:|---|
| RNST04BK safety-breakaway cord ×5 | 1,910～2,905 | 国内3販売経路の公開単価。穴適合・離脱試験前なのでUSD総額へ未算入 |

公開価格の大きい項目:

| MPN | JLC | 実装数 | 公開課金数量 | USD |
|---|---:|---:|---:|---:|
| CSNP32GCR01-BOW | C5440134 | 5 | 5 | 200.83 |
| STM32U585CIU6 | C5271026 | 5 | 5 | 61.42 |
| IM69D130V01 | C536262 | 5 | 5 | 20.43 |
| NCP360SNT1G | C603707 | 5 | 19 | 9.52 |
| BQ25185DLHR | C19725033 | 5 | 6 | 9.31 |
| TLV7042DDFR | C2867856 | 5 | 11 | 9.29 |
| TPS22917DBVT | C2680344 | 5 | 25 | 9.25 |
| B3U-1000P | C231329 | 5 | 49 | 9.20 |

`公開課金数量`は公開ページの最低購入数を反映した保守的算術で、PCBA BOMツールの正式課金とは限らない。RNST04BKは単一候補であり採用済みではない。完全額がnullの間は発注可と解釈しない。
