nyanko3141592/pendant-recorder/docs/procurement/xe-production-readiness-2026-10-28.md

# XE量産準備監査 — 2026-10-28

## 結論

**HOLD（発注不可）**。回路・PCBの電気検査はクリーンだが、上位要件を満たした完成品として発注できる状態ではない。注文、支払い、製造データのアップロード、業者連絡は行っていない。

旧 `fabrication-review-1d4b19d9e46e/order-candidate-2026-10-28` は、削除済みUSB制御部品と旧マイク調達経路を含むため全面的に失効している。再利用・アップロード禁止。

## この監査で確定した変更

- U8を手配前提の `IM69D130V01XTSA1 / C9900015304` から、同じ3.3V PDM・5端子構成の通常カタログ候補 `IM69D130V01 / C536262` へ変更した。2026-10-28観測在庫は246、未予約。
- 抵抗・コンデンサは原則としてJLCの通常在庫型番へ固定した。正確なMPN、LCSC番号、対象リファレンスは `xe-production-bom-2026-10-28.csv` を正本とする。
- J3とTP1/2/3/5/6は実装部品ではなく基板パッドなので、調達対象から除外した。
- 固定電池DTP401525-XEのP2白線が内蔵10kΩ NTCであることを公開仕様から確認し、J2 pin2からハードウェア温度比較器へ直結した。TH1と熱伝導パッドを削除し、ユーザー作業とケース依存の熱経路をなくした。
- D6は通常在庫の `TJ-S1005SW4TGLC9Y-A5 / C273600`、R42は130kΩの `RC0402FR-07130KL / C93946`、R10は30kΩの `RC0402FR-0730KL / C138008` へ固定した。充電電圧と終端電流を安全側へ修正し、さらに `NCP360SNT1G / C603707` をU14としてUSB-C直後へ、`TPS2552DBVR-1 / C140331` をU13としてその後段へ統合した。ILIMはINへ直結し、保証50～100mAのラッチオフ制限とする。U13直近のC31/C32各1µF、NCP360入力C33=`GRT155R6YA105KE13D / C6628588`（1µF、35V）を維持する。6/9/12/20V異常入力遮断、電流制限・過渡応答・発振・熱遮断・復帰は未測定。
- NTC配線の通常B.Cu経路を確保するため基板上端を0.5mmだけ拡張し、正本外形を27.5×27.5mmへ変更した。追加の特殊viaはない。ERC/DRC/未接続/回路図パリティは全0。実温度遮断試験前なので充電既定無効を維持する。
- 現行基板ハッシュからローカルCAMレビュー `fabrication-review-d422d8bd227c` を再生成した。68実装位置、PTH 231穴・NPTH 3穴、USB-C固定スロット4箇所、27.5×27.5mm外形、4 POFVを照合済み。これはレビュー資料であり、ZIP化、アップロード、発注許可は行っていない。
- U10をDSBGA-4の `TPS22916CYFPR` から、リード付きSOT-23-6の `TPS22917DBVT / C2680344` へ変更した。CTは未接続、QODはSD_V3へ接続。正本基板は27.5×27.5mm、ケースはcase v4へ同期済みで、ERC/DRC/未接続/回路図パリティは全0。旧24mmケースと旧パネルは失効し、製造パネルはリリース条件合格後にだけ再生成する。
- 正本BOMを再照合し、基板上74リファレンスのうち68をJLC実装部品、J3とTP1/2/3/5/6を部品不要のPCBパッドとして一意に対応させた。基板部品の購入者調達、部品支給、はんだ、圧着、配線加工、熱伝導パッドは不要。ただし固定電池DTP401525-XEはJLC実装境界外であり、現構成では購入者がその正確なコネクタ付き電池を別途調達して無加工で挿す。購入者最終組立は電池、case v4、2～3mm紐である。`check_production_bom_boundary.py`はこの電池例外を明示し、基板部品が境界外へ出た場合を失敗扱いにする。

## 未解決の発注ブロッカー

0. **充電電圧・電流・USB入力制限はCAD統合済み、実機認定待ち** — BQ25185はR42=130k（4.1V公称、保証上限4.1205V）、R10=30k（9–11mA、終端上限1.1mA）。前段の `TPS2552DBVR-1 / C140331` はILIM=INで保証50～100mA、短絡時ラッチオフ、USB電源再投入復帰とする。C31（IN）とC32（OUT）の1µFをU13直近へ配置した。ERC/DRC/未接続/回路図パリティは全0だが、コンデンサ実効容量、異常入力ピーク、過渡応答、発振、USBサスペンド、空電池復帰、電流制限、ラッチ、熱遮断を実機確認するまで充電有効化、製造リリース、発注を行わない。

1. **MCU実機認定・通常在庫未確認** — 正本は `STM32U585CIU6 / C5271026`。同じ非SMPS UFQFPN48、2MB flash/786KB RAM、JLC Economic/Standard実装対応、ST volume production・10年longevityを確認した。ただし現行JLC公開ページは在庫数非表示・Extended扱いで、過去観測在庫37を現行在庫とはみなさない。U585 RNG/OTG_FS/DWC2を含むfull-moduleとconfigured-applicationの非実機リンク成功、DWC2 vendor hash一致、CAD/BOM/firmware target同期、ERC/DRC/parity 0まで確認した。実機USB/PDM/電力と5台EVTは未確認。
2. **電池NTC実機認定** — 電池自身の10kΩ NTCへ直結済みだが、B定数・公差・ロット差は未公表。0/10/25/35/45℃の受入測定と、open/short、冷温・高温停止、復帰、チャタリングを5台で確認するまで充電を有効化しない。
3. **ケース物理試験・製造パネル未同期** — 正本PCB 27.5×27.5mmとpack-NTC統合モデルに合わせてcase v4を生成し、lower/upper/lugの名目内部交差は全0。USB datumは維持し、完成外形は約29.91×36.35×12.98mm。単体基板のローカルCAMレビューは現行版へ再生成済みだが、実印刷、電池・3極ハーネス・実USB・吊下げ・紐疲労は未確認で、製造パネルは未生成。
4. **在庫スナップショット** — 主要IC、コネクタ、スイッチはカタログ一致済みだが、発注直前の通常在庫・実装種別を全行再取得する必要がある。在庫は保証・予約ではない。USBLC6-2P6とB3U-1000PはEconomic/Standard対象、USB4105-GF-AもEconomic/Standard対象だがJLC表示上の実装難度High。基板NTCのNCU18XH103F60RBは現行BOMから削除済み。
5. **POFV実物受入** — 現正本をKiCadのeffective pad shapeで再監査した結果、hole-over-padはU13.5/VBUS_OVP、U1.40/PDM_DATA、U1.10/VBUS_N、U3.9/CHG_Nの4か所。通常viaへの局所再配線はDRC0を維持できず不採用。4本はいずれも0.15mm drill、0.35mm diameter、filled/capped指定で、JLCPCBが6層ENIG向けに公開する樹脂充填・平坦化・銅キャップPOFVの寸法条件と一致する。公開能力との一致は確認済みだが、実基板の平坦度、はんだボイド、open/short、歩留まりは5台EVTまで未確認。
6. **工場ファーム書込み** — JLCPCBのStandard PCBA Programming optionは公開されており、J3の5-pad SWD interfaceも正本PCBで検査済み。共通ファーム、初回HID公開鍵登録、read-only MSC、検証済みID範囲の本体側削除は非実機試験まで実装済み。正式USB VID/PIDと、DTP401525-XE 5個を4.4mA平均・110mA peak以上の模擬負荷で評価して選定した停止電圧の証拠を両方要求するEVTイメージ生成器を追加した。どちらかが欠けるとBIN/ELF/MAPを生成しない。生成後は同じ最終イメージで完成5台の16時間EVT Cが別途必須。Flash書込み中電源断、BOR4 readback手順の実行証跡、JLCの対応審査、実pogo接触は未確認。購入者書込み、購入者別バイナリ、未書込みPCBAへfallbackしない。

## 物理試験ブロッカー

- DTP401525-XE 110mAhで16時間連続録音：計算上の設計目標のみ。実機で未測定。
- 36時間暗号化保存：合成データ試験のみ。実ストレージ・実機で未測定。
- 充電温度保護：電池内蔵NTCへ直結済み。抵抗閾値計算と論理試験のみで、実NTCのR-T、遅れ、冷温・高温遮断、復帰は未測定。
- USB-C：ケース開口は拡張済みだが、複数の実ケーブル、抜き差し荷重、充電・データ同時利用を未試験。
- 紐受け：穴軸は上面視90度回転済みでlower一体だが、実印刷の引張・疲労・摩耗を未試験。

## 価格スナップショット

現行の機械生成表は [`xe-five-unit-current-estimate.md`](xe-five-unit-current-estimate.md)。2026-10-28再取得時点で、実装数×公開単価の部品算術はUSD 318.31、これに公開実装料金の部分算術を加えたシナリオはUSD 463.43～474.14。全36行で部品ライブラリ事前購入数量を適用する保守シナリオはUSD 723.81～734.52。どちらもPCBA見積りではない。RNST04BK紐は5本JPY 1,910～2,905の公開価格を分離表示したが、穴適合と離脱荷重の実測前なので採用済みではない。PCB、4 POFV、検査、工場書込み、電池、ケース、送料、税等が未取得なので、完全着地額はnullであり発注判断には使用できない。

ストレージが1台約USD 40で原価の最大要因だが、4GB容量は36時間の暗号化音声見積り約1.29GB（20%余裕込み）を満たす。容量を落とす代替は、消費電力・連続書込み・供給性を同じ条件で確認できるまで採用しない。

U11の供給継続候補として、同じ32Gbit・LGA-8（6.2×8mm）・SPI/SD掲載の `CSNP32GCR01-AOW / C2841139`（在庫468、広温度版）と `ZDSD32GLGEAG / C5188571`（別メーカー）を特定した。ただし公開カタログだけではピン互換とコマンド互換を証明できないため、自動代替は禁止する。`xe-storage-second-source-review-2026-10-28.json`のピン配置、ファーム、16時間電流、36時間保存、電源断試験を通した型番だけを同一版のBOMへ採用する。

## 発注許可条件

すべて満たした時だけ新しいCAM/BOM/CPLを同一ハッシュで再生成する。

1. 発注直前にU585が部品支給や個別問い合わせなしで通常在庫にあることを再確認する。
2. 電池内蔵NTCのR-T受入範囲とopen/short故障基準を確定し、5台の実温度遮断・復帰試験に合格する。
3. U10をリード付き通常実装へ置換した版でERC/DRC/接続に合格済み。残る立上り・放電・逆流実測と27.5 mm基板用ケース検査に合格する。
4. 製造データをアップロードする許可が得られた後、JLC自動フローが4本のPOFVと全実装部品を個別問い合わせなしで受理し、5台で実装検査に合格する。
5. 5台EVTで過充電・過放電・短絡・USB異常・温度異常の試験に合格。
6. 5台EVTで16時間連続録音、36時間保存、三OS取り込み・復号に合格。
7. ケース、紐、USB、電池接触、熱応答の物理試験に合格。
8. 回路、BOM、PCB、製造データ、ファーム、ケースの版とハッシュが一致。
9. 製品用VID/PIDを固定し、初回HID公開鍵登録を含む共通reproducible firmwareをJ3 SWDで書込み、flash verify、BOR4 readback、MCU UID、USB列挙、充電既定無効を全5台で記録する。購入者の公開鍵・秘密鍵を製造提出物へ含めない。
