nyanko3141592/pendant-recorder/docs/procurement/preorder-v4.md

# v4 発注準備・金額確認（2026-10-25）

現行対象は `hardware/charge-guard-v4`。発注可能にはまだ到達していない。基板18×33×0.8mm、6層、87フットプリント中80点実装・40種類。ケース別チャットのv3形状原本は変更しない。旧 `preorder.md` / `budget.json` のD1.1/D2予算は本版の見積りではない。

## NTCと電池仕様

[メーカー仕様書（Aska公開）](https://www.aska-elt.jp/wp-content/uploads/DTP401525-XE.pdf) と [千石公開仕様書](https://www.sengoku.co.jp/item/pdf/Spe-01-401525-XE-NTC-110mah-3.7V-en-1.pdf) は2020-07-20 Rev1.0。JOINSET製0603・10kΩの記載だけでは温度を確定できない。R25公差、B値の温度区間/公差、R-T表、現行ロットへの適用は未確認。他製品に使われるJOINSETのB3435等を本品に流用しない。

充電0～45℃、最大110mA、4.20V、終止0.01Cの記載を確認。ただし標準充電「0.2C(2mA)」は110mAhと不整合。4.20V±1%充電器の最大4.242Vと約2.18mA終止が許容されるか、PCMしきい値とDW01+記載の整合もメーカー照会事項。仮のNTC範囲による既存ガード計算は実部品の保証にならない。

[Data Power公式窓口](https://www.dtpbattery.com/contact.html) の info@dtpbattery.com 宛に `../sourcing/dtp401525-xe-inquiry-en.txt` を作成。仕様と完成パック5個/10個の見積り照会。**未送信、送信許可待ち**。住所・決済情報は含めない。

## 調達と見積りファイル

`hardware/charge-guard-v4/quotation/` にGerber/ドリルZIP、BOM CSV、CPL CSV、元位置表とSHA256 manifestを出力。BOMとCPLの実装参照80点が一致。部品候補は `sourcing-current.json`。

- 電池用J2 Molex 0781710003は、先頭0を省く781710003として[LCSC C564183](https://www.lcsc.com/product-detail/C564183.html) に掲載。カタログ候補を解決したが、JLC在庫と実装受理は未確認。
- U12はTLV7032DDFR / C2871498。TLV7042へ自動置換しない（POR時出力方式が異なる）。
- MCU C22454224、ストレージ C5440134、マイク C7230692、レベル変換 C22430532等を含め、80点を全実装する見積りが必要。欠品をDNP扱いして総額を安く見せない。
- J3とTP1～6は基板ランドなので実装BOMから除外。CPLの回転角はKiCad出力で、業者プレビューによる向き確認は未了。
- 手はんだ不要条件を維持。EZ3セットに付属する未実装ヘッダーをユーザーにはんだ付けしてもらう方式は不可。

## 現時点で確認できた金額

JLCPCBの公開見積り画面に寸法/6層/0.8mm/ENIG/0.15mmビア/製造ファイル確認ありを入力。FR4 TG155と4-wire Kelvin testは0.15mm穴で自動適用。日本向けUPS Worldwide Express Saverを選択。Gerberアップロード前の**基板単体の非拘束見積り**で、部品・実装・パネル費等は含まれない。製造8～9日、配送表示2～4営業日。納期保証ではない。

| 項目 | 5枚/5個 | 10枚/10個 |
|---|---:|---:|
| 基板のみ | $102.98 | $118.29 |
| 日本向け送料の表示見積り | $9.75 | $9.75 |
| 確認済みUSD小計 | $112.73 | $128.04 |
| 電池（千石掲載価格、税込¥1,500/個） | ¥7,500 | ¥15,000 |
| 部品・実装・治具・最終送料/諸費用 | 未取得 | 未取得 |
| **支払総額** | **未確定** | **未確定** |

[千石DTP401525-XE商品ページ](https://www.sengoku.co.jp/mod/sgk_cart/detail.php?code=EEHD-5VAC) の税込価格を採用。5/10個の確保可能在庫、送料、現行ロットのNTC保証は未確認。古いセール価格は使わない。外貨の円換算を固定160円で実際の支払額として提示しない。輸入時税・通関手数料・カード為替手数料も最終総額に必要。

証拠は `evidence-v4/jlc-5-bare-pcb.png` と `jlc-10-bare-pcb.png`。機械可読値は `quote-v4.json`。画面の初期送料は米国向けだったため、日本に変更後の金額だけを採用した。最終実装重量/届け先で再計算が必要。

JLCへのアップロードはユーザーが許可し、Gerber取込み成功。18×33mm・6層として認識された。表37点/裏43点の両面実装はStandardが必要で、JLC側は製造用余白を加え70×71mmへ変更。分割済み納品と部品配置確認あり/自動承認なしを選択した。以前の基板単体価格は実装向け余白費を含まない。BOM/CPLは未アップロード、実装総額は未取得。次工程の実装サービス規約同意は確認待ち、アカウントは未ログイン（ログイン画面を保持）。Data Powerへのメールは今回のJLC選択では許可と解釈せず未送信。注文・支払い・予約在庫購入は行っていない。

## 発注前に解決する事項

1. 現行電池のNTC/充電電圧/終止仕様を確定し、ガードしきい値を再計算。比較器の電源範囲・誤差、MOS漏れを含む回路レビューを完了。
2. 80点全実装の品番/在庫/代替禁止条件、実装向き、6層スタックアップ、0.10mm配線/0.15mm穴とUSB加工のDFM受理。
3. はんだ不要の書込み・電源試験治具と、初回起動でCHG_ALLOWをLowに保つファーム/手順。未検証状態で実電池を充電しない。
4. 部品/実装/パネル/予備部品/送料/税/決済費/電池/治具を含む5台/10台の金額と納期を提示し、ユーザーが数量・総額を承認。

## 実機到着後に検証する事項

これらは最初の技術試作基板を注文する前に実測できないため、発注前項目とは分ける。ただし実電池充電の開始・製品完成判定には必要。

- 電流制限電源と電池シミュレータで、起動/瞬断/リセット/NTC断線短絡/温度判定/漏れ/ヒステリシスを測定。波形で確認。
- 実際の充電最大電圧・電流・終止、熱結合と温度遅れを確認してから規定範囲で実パック試験。
- USB挿抜でも録音継続、16時間連続録音、36時間分の暗号化保存、取り出し/復号/完全性検証。
- ケースの嵌合、配線余裕、引張、マイク音道、蓋/紐保持と装着感。

試験条件の詳細は `hardware/charge-guard-v4/bench-plan.md`。ERC/DRCのゼロ件はこれらの実測合格を意味しない。
