nyanko3141592/pendant-recorder/docs/decisions/0008-selection-e.md

# 0008: 次版Eの設計基準と計算結果

2026-10-25。ユーザーから計算・選定・シミュレーションの指示。設計基準として以下を選ぶ。製造用全BOMの確定とは区別する。回路/CADはこの文書だけでは変更されない。

| ブロック | 設計基準 | 理由と残件 |
|---|---|---|
| 電池 | DATA POWER DTP401525-XE（購入セットDTP401525(EZ3)）110mAh | 国内単品販売、保護・NTC・完成3線コネクタ。150mAh海外品より国内調達を優先 |
| 基板側電池接続 | Molex 0781710003 | 業者実装。現SH2ピンとは非互換、JLC調達受理/フットプリント・極性確認前 |
| MCU | STM32U535CEU6維持 | 現設計・低消費電力方針を継承。JLC欠品の解消/調達受理は未確定 |
| マイク/レベル変換 | T5838 / TXS0104ERUTR維持 | 現回路を継承。実効消費電流・波形未測定 |
| 保存 | CSNP32GCR01-BOW、4GB SPI SD NAND維持 | 36h ADPCM本体約1.040GB。アイドル/busy電流が稼働時間の重要条件 |
| USB | GCT USB4105-GF-A維持 | USB-C充電＋同期。ランドDFM残件は継続 |
| 充電 | BQ25101を最終採用扱いにしない | パック温度仕様/NTC定数と45〜60℃充電の整合が未成立。充電IC選定は未完 |
| 外形 | 長方形電池に合わせた角丸形を検討 | 丸形固定解除。完成寸法・層数は未確定 |

## 電池の確認結果

千石のXE品掲載: 15.5×27×4.2mm、Molex781720003、P1赤＋/P2白NTC/P3黒−、NTC10k。マルツのEZ3はXEと0781710003のセット、1個税込1,252円、確認時即納32個。5個6,260円（送料別）。価格/在庫は予約ではない。線長/公差/膨張/NTC B値と熱結合/充電温度・電流は当該版メーカー仕様で照合する。PH版の仕様書をそのまま適用しない。NTC線があることだけで適切な充電停止温度になるわけではない。

- https://www.marutsu.co.jp/pc/i/2228265/
- https://www.sengoku.co.jp/mod/sgk_cart/detail.php?code=EEHD-5VAC
- 比較150mAh: https://tinycircuits.com/products/lithium-ion-polymer-battery-3-7v-150mah

## 稼働時間の感度分析

再現: `python3 hardware/power-study/selection-e/simulate.py`。120条件のCSV、結果JSON、runtime.svgを保存。これは電池容量/平均電流の算術的パラメータ掃引で、SPICE、実機動作、電池放電曲線のシミュレーションではない。

| 電池端平均電流 | 110mAh・使用可能70% | 150mAh・使用可能70% |
|---|---:|---:|
| 3.5mA | 22.0h | 30.0h |
| 4.0mA | 19.25h | 26.25h |
| 4.5mA | 17.11h | 23.33h |
| 5.0mA | 15.4h（未達） | 21.0h |
| 6.0mA | 12.83h（未達） | 17.5h |

110mAhで使用可能率が60%なら4mAでも16.5h、4.5mAでは14.67h。したがって平均4mA以下を開発目標に置く。これは達成予測ではない。現3.3V LDOの終止電圧/ピーク負荷、劣化、温度により実効容量は変わる。

処理負荷の例も計算: 常時0.8mA、CPU増分8mAを10%、SD増分30mAを5%動かす仮定で平均3.1mA。SD稼働率が12%なら5.2mAへ増え、110mAh/70%で14.81hへ低下する。これら電流/稼働率は測定値や部品の保証値ではなく感度を見る入力。都合のよいシナリオを16h成立の証拠にしない。

## 収納計算の限界

電池単体の掲載直方体は1.758cm³。仮に壁各1mm・側方余裕各0.5mmなら電池だけの外形下限は18.5×30mm。基板/USB/線/コネクタ/紐部を含まないため製品寸法に使えない。

厚さの仮積上げは壁2＋電池4.2＋基板0.8＋上部USB包絡3.56＋下部部品1.0＋絶縁/余裕1.0 =12.56mm。NTCが電池内蔵でも実部品・配線干渉、公差、電池膨張を未解決なので、13mm成立を保証しない。最初の配置検討枠を22×34×14mmに置くが、完成寸法ではない。これは旧円形D25.5×14.5mmの包絡約7.4cm³より直方体包絡約10.5cm³で大きい。形を変えるだけで小さくなるとは言わない。

## 費用と選定完了の境界

電池は5個6,260円の市販経路が見えた。その他の部品、PCBA初期費用、層数の正式見積りは未確定。電池変更だけで前の試作費全体が大幅減になるとは計算できない。

今回、次版設計基準の電池と主要録音系を選んだ。充電IC、JLC部品調達、完成配線収納が未解決なので、製造用選定は未完。実施していない電気SPICE/熱/3D干渉解析や新PCB配線を完了扱いしない。D1.1は原本保持、order_ready=false。
