nyanko3141592/pendant-recorder/mechanical/structure-a2/viewer.html

# Pendant Recorder / A2 薄型検討

内部構造の検討モデル · ケース仮寸法 24.8 × 41.5 × 12.8 mm · 基板 22 × 38.5 × 0.8 mm

製造用ではありません。A1の90部品を表面へ再配置、PH端子とNTCを裏面へ。未配線。高さ・嵌合プラグ・配線収納は未検証。

旧案比：厚さ −15.8% / 外形体積 −4.9%。幅 +0.8mm、長さ +3.5mm。薄さを優先した案で、平面の最小化は未達。

🟨 電池 15.5 × 27 × 4.2 mm🟩 両面基板⬜ USB-C / PH電池端子 🟧 配線収納予約（実配線ではない）◼ ケース・蓋

分解 視点を戻す ケース表示

ドラッグで回転、ホイールで拡大縮小。USB側の壁を省いた断面説明用ケースです。完成外形・配線成立・24時間動作を保証するモデルではありません。
