nyanko3141592/pendant-recorder/mechanical/xe-minimal/case-envelope-vs-omi-covers-study.pdf

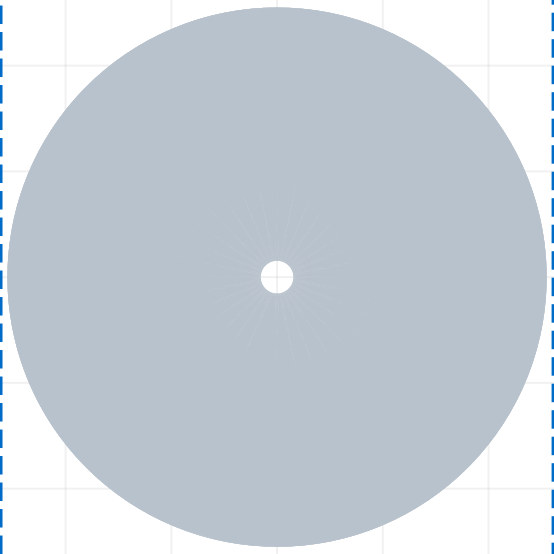
[picture p9: figure]

−15 | −10 | −5 | 0 | 5 | 10 | 15
| | | mm

−15

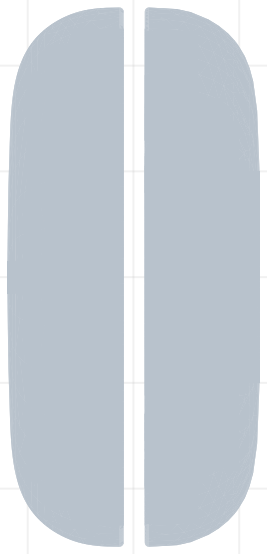
[picture p10: figure]

−10

−5

0

5

10

15

mm

## Front / case envelope overlay

Provisional case: 26.2 x 29.6 mm
−15 | −10 | −5 | 0 | 5 | 10 | 15
| | | mm

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
## Side / case envelope

## Provisional case envelope versus Omi public cover STEP files

Grey: Omi covers centered together by their combined bounds. Blue: centered provisional case envelope. Our envelope includes pack/board/separator but cables, closure and tolerances remain unresolved. Omi file assembly/version association remains unconfirmed; wrapper and attachment excluded.
