nyanko3141592/pendant-recorder/mechanical/xe-minimal/pcb-vs-omi-covers-study.pdf

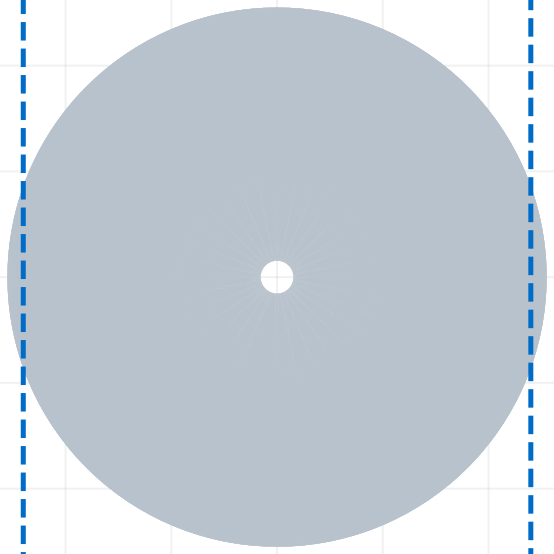
[picture p11: figure]

−15 | −10 | −5 | 0 | 5 | 10 | 15
| | | mm

−15

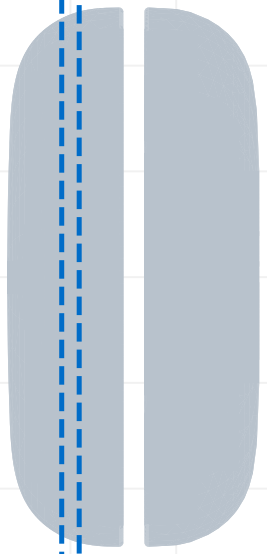
[picture p12: figure]

−10

−5

0

5

10

15

mm

## Front / PCB outline overlay

Current bare PCB: 24 x 27 mm
−15 | −10 | −5 | 0 | 5 | 10 | 15
| | | mm

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
## Side / bare board only

## Design study: current PCB versus Omi public cover STEP files

Grey: Omi cover geometry in source coordinates. Blue: centered bare PCB. Battery, components, leads and our case are NOT included. This is NOT a finished-product comparison. Omi file assembly/version association remains unconfirmed; wrapper and attachment excluded.
