nyanko3141592/pendant-recorder/mechanical/xe-minimal/evidence/DMM-PA12-SLS-rev023.pdf

Design Guideline | REV023

## PA12｜SLS

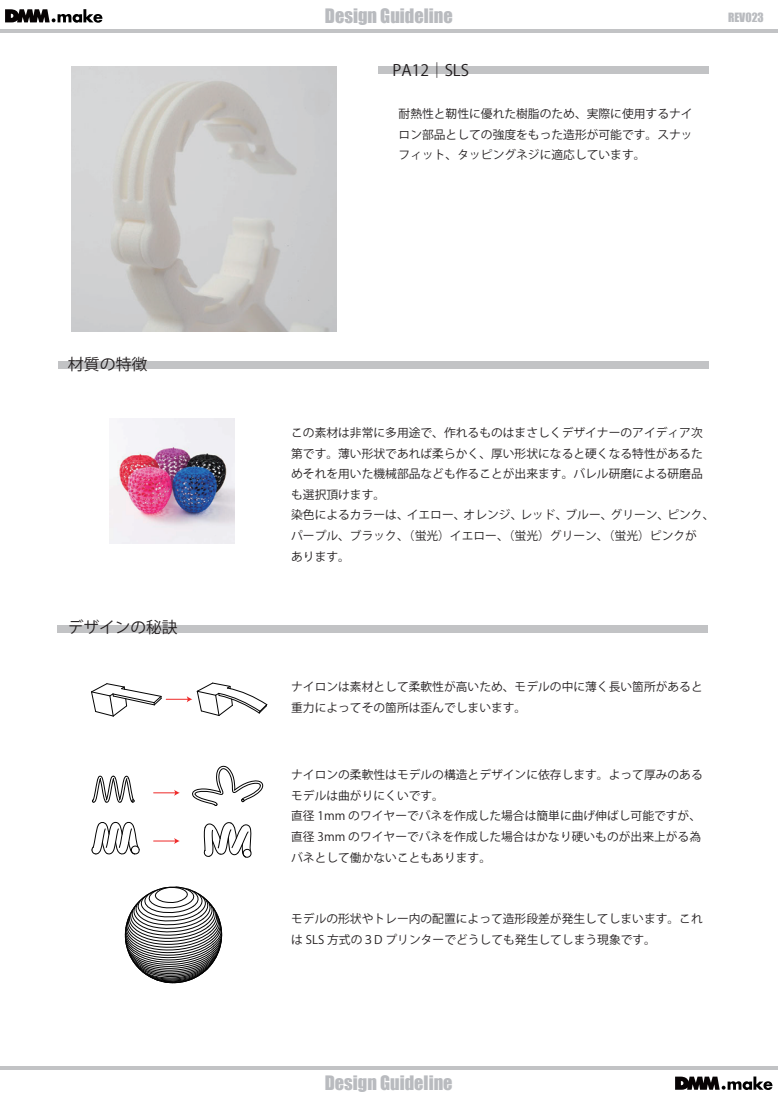
[picture p22: page 1]
Design Guideline; 耐熱性と靭性に優れた樹脂のため、実際に使用するナイ ロン部品としての強度をもった造形が可能です。スナッ フィット、タッピングネジに適応しています。; 材質の特徴; ナイロンは素材として柔軟性が高いため、モデルの中に薄く長い箇所があると 重力によってその箇所は歪んでしまいます。; ナイロンの柔軟性はモデルの構造とデザインに依存します。よって厚みのある モデルは曲がりにくいです。 直径 1mm のワイヤーでバネを作成した場合は簡単に曲げ伸ばし可能ですが、 直径 3mm のワイヤーでバネを作成した場合はかなり硬いものが出来上がる為 バネとして働かないこともあります。; モデルの形状やトレー内の配置によって造形段差が発生してしまいます。これ は SLS 方式の３D プリンターでどうしても発生してしまう現象です。; デザインの秘訣

この素材は非常に多用途で、作れるものはまさしくデザイナーのアイディア次
第です。薄い形状であれば柔らかく、厚い形状になると硬くなる特性があるた
めそれを用いた機械部品なども作ることが出来ます。バレル研磨による研磨品
も選択頂けます。
染色によるカラーは、イエロー、オレンジ、レッド、ブルー、グリーン、ピンク、
パープル、ブラック、（蛍光）イエロー、（蛍光）グリーン、（蛍光）ピンクが
あります。

## デザインの秘訣

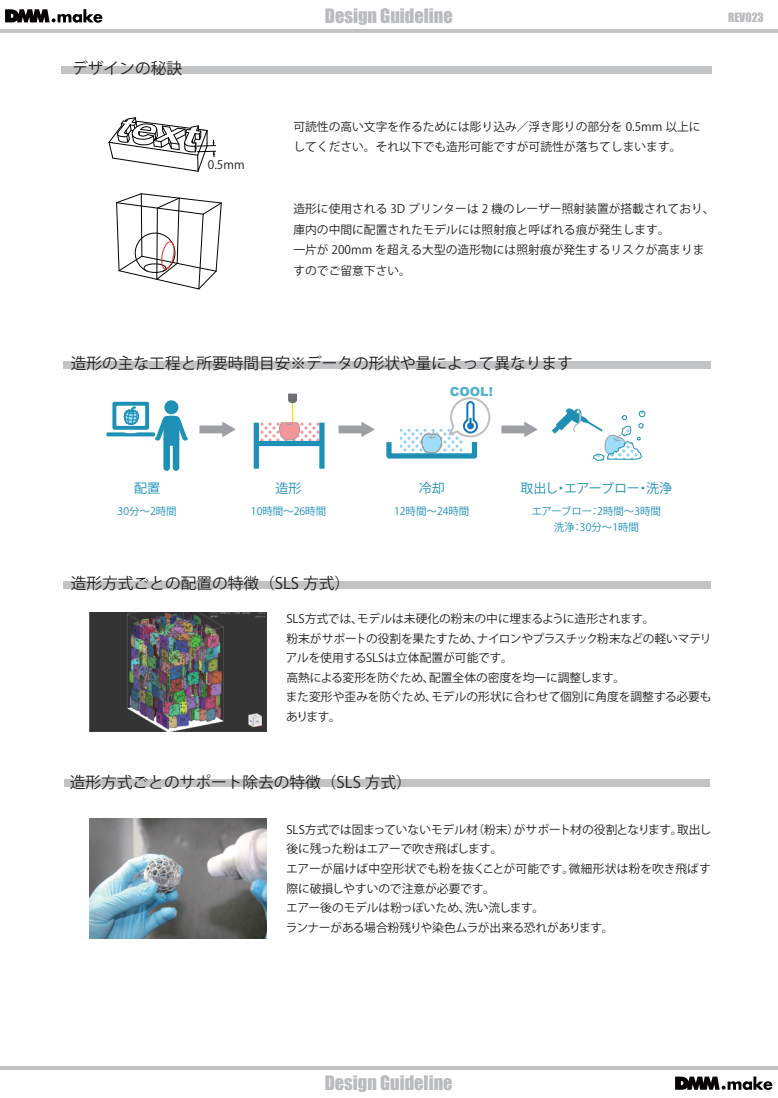
[picture p23: page 2]
造形の主な工程と所要時間目安※データの形状や量によって異なります; SLS方式では、モデルは未硬化の粉末の中に埋まるように造形されます。 粉末がサポートの役割を果たすため、ナイロンやプラスチック粉末などの軽いマテリ アルを使用するSLSは立体配置が可能です。 高熱による変形を防ぐため、配置全体の密度を均一に調整します。 また変形や歪みを防ぐため、モデルの形状に合わせて個別に角度を調整する必要も あります。; 取出し・エアーブロー・洗浄; エアーブロー：2時間～3時間; COOL!

可読性の高い文字を作るためには彫り込み／浮き彫りの部分を 0.5mm 以上に
してください。それ以下でも造形可能ですが可読性が落ちてしまいます。

造形に使用される 3D プリンターは 2 機のレーザー照射装置が搭載されており、
庫内の中間に配置されたモデルには照射痕と呼ばれる痕が発生します。
一片が 200mm を超える大型の造形物には照射痕が発生するリスクが高まりま
すのでご留意下さい。

造形方式ごとの配置の特徴（SLS 方式）

造形方式ごとのサポート除去の特徴（SLS 方式）

SLS方式では固まっていないモデル材（粉末）がサポート材の役割となります。取出し
後に残った粉はエアーで吹き飛ばします。
エアーが届けば中空形状でも粉を抜くことが可能です。微細形状は粉を吹き飛ばす
際に破損しやすいので注意が必要です。
エアー後のモデルは粉っぽいため、洗い流します。
ランナーがある場合粉残りや染色ムラが出来る恐れがあります。

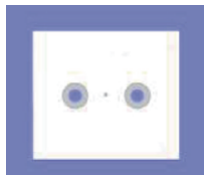
[picture p24: figure]

## 最大造形可能サイズ

## 最小造形可能サイズ

PA12｜SLS
665mm x 355mm x 535mm
PA12カラー｜SLS
200mm x 200mm x 200mm
PA12（磨き）｜SLS
100mm x 100mm x 200mm

ナイロン12（SLS）
X + Y + Z ≧ 7.5mm
ナイロン12（SLS）(カラー) ・（磨き）
X + Y + Z ≧ 25.0mm

PA12｜SLS の最大造形可能サイズはプリンターの造形可能領域で決定されてい ます。
モデルのサイズはこの範囲内に収まっていなければなりません。複数のモデル が１つのファイルに含まれている場合も、すべてのモデルを含めたバウンディ ングボックスのサイズをこの範囲内に収めてください。
もし作成したモデルがこの範囲に入らない場合、「モデルのスケールを小さく変 更する」「不必要な部位を取り除く」等の修正を検討、もしくはより大きなモデ ルが造形可能なマテリアルの使用を検討して下さい。

ナイロン 12（SLS）の最小サイズはプリンターが造形できる最小寸法で決定さ れています。
造形可能とする為にモデルのサイズは最小造形可能サイズより大きくして下さ い。複数のモデルが１つのファイルに含まれている場合も、それぞれのモデル がこのサイズより大きくなければ造形できません。
もし作成したモデルがこの大きさより小さい場合、「モデルのスケールを大きく 変更する」「厚みを増やす」「結合が可能な部位は結合する」「パーツや各部位を 大きくする」などの修正を検討、もしくはより小さなモデルが造形可能なマテ リアルの使用を検討して下さい。

## 当社が定める造形方向と造形方向指定について

造形時の配置方向により製造負荷が高まる場合、装置の寿命低下と歩留まりに大きく影響がございます。その為、当社が 定める造形方向は装置への負担を低下させることを基本としています。 上記条件の中で最大限変形が抑制される配置方向を検討し造形を行なっておりますが、お客様のご利用目的によって本 内容が即さない場合は造形方向指定オプション(有料)をご依頼ください。 造形方向の指定は製造負荷が上がってしまう為、その分の費用をご負担頂く事をあらかじめご了承ください。 造形が不可能な方向でご指定頂いた場合、方向指定をお断りさせていただく可能性がございます。また、お客様のご希望 の方向で造形した場合でも、歪みや変形を起こす可能性がございますことをご了承ください。 造形方向指定を頂いていない場合のサポート箇所に由来する再造形はお受けしておりません。

## SLS 方式の円形状と造形方向について

SLS方式プリンターにおいて、穴形状は楕円になる可能性が 高くなります。
造形方向指定オプションサービスをご利用いただくことで真 円に近づける対応が可能ですが、すべての方向の再現性を 保証するものではないことをご了承ください。
データの形状 | 造形モデルの形状

## 支えられていない壁の最小肉厚

## 支えられた線形状部の最小肉厚

## 支えられていない線形状部の最小肉厚

" 支えられていない壁 " とは１つの側面のみが他の壁に接続されている壁のこ とを言います。
" 支えられていない壁 " の最小肉厚は粉状のサポート材からモデルを取り外し、 クリーニングする際の難易度で決められています。壁が薄すぎるとこの処理中 に破損してしまいます。
また短辺が長辺の 10% 以下の長さになると歪みが大きくなります。 （磨き）は研磨剤の圧力で破損する可能性があります。

" 支えられた線形状部 " とは両端が壁で支えられた " 線形状部 " のことであり、 " 線形状部 " とは長さが幅の 5 倍以上ある部位のことです。
" 支えられた線形状部 " の最小肉厚は粉状のサポート材からモデルを取り外し、 クリーニングする際の難易度で決められています。線が細すぎるとこの処理中 に破損してしまいます。
また短辺が長辺の 10% 以下の長さになると歪みが大きくなります。 （磨き）は研磨剤の圧力で破損する可能性があります。

" 支えられていない線形状部 " とは１つの端のみが壁で支えられた " 線形状部 " のことあり、ナイロン素材における " 線形状部 " とは長さが幅の 5 倍以上ある 部位のことです。
" 支えられていない線形状部 " の最小肉厚は粉状のサポート材からモデルを取 り外し、クリーニングする際の難易度で決められています。線が細すぎるとこ の処理中に破損してしまいます。
また短辺が長辺の 10% 以下の長さになると歪みが大きくなります。 （磨き）は研磨剤の圧力で破損する可能性があります。

## 支えられた壁の最小肉厚

" 支えられた壁 " とは２つ以上の側面が他の壁に接続されている壁のことを言 います。
" 支えられた壁 " の最小肉厚は粉状のサポート材からモデルを取り外し、クリー ニングする際の難易度で決められています。壁が薄すぎるとこの処理中に破損 してしまいます。
PA12｜SLS：t = 0.8mm | また短辺が長辺の 10% 以下の長さになると歪みが大きくなります。 PA12｜SLS（磨き）：t=2.0mm

PA12｜SLS：t = 0.8mm
PA12カラー｜SLS：t = 0.8mm
PA12（磨き）｜SLS：t=2.0mm

PA12｜SLS：t = 0.8mm
PA12カラー｜SLS：t = 0.8mm
PA12（磨き）｜SLS：t=2.0mm

PA12｜SLS：t = 1.0mm
PA12カラー｜SLS：t = 1.0mm
PA12（磨き）｜SLS：t=2.0mm

## 浮き彫りのディティールの最小値

## 彫り込みのディティールの最小値

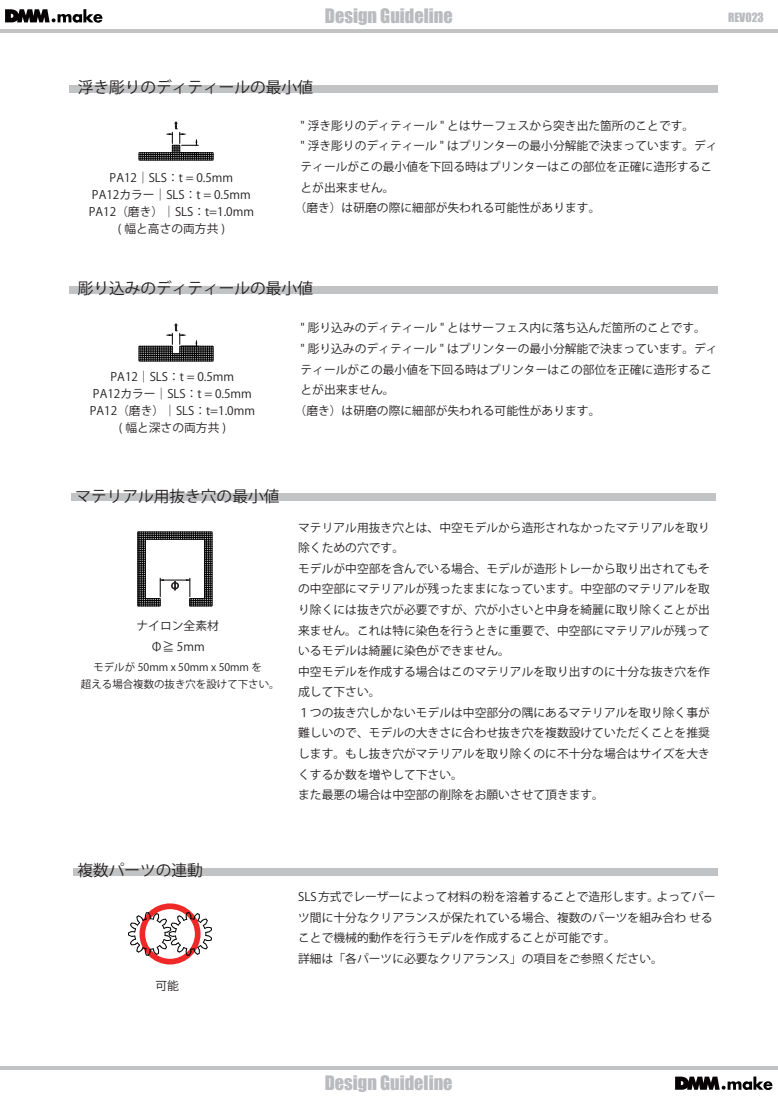
[picture p25: page 5]
マテリアル用抜き穴の最小値; 複数パーツの連動; ナイロン全素材 Φ≧ 5mm モデルが 50mm x 50mm x 50mm を 超える場合複数の抜き穴を設けて下さい。; PA12｜SLS：t = 0.5mm PA12カラー｜SLS：t = 0.5mm PA12（磨き）｜SLS：t=1.0mm ( 幅と高さの両方共 ); PA12｜SLS：t = 0.5mm PA12カラー｜SLS：t = 0.5mm PA12（磨き）｜SLS：t=1.0mm ( 幅と深さの両方共 )

" 浮き彫りのディティール " とはサーフェスから突き出た箇所のことです。
" 浮き彫りのディティール " はプリンターの最小分解能で決まっています。ディ
ティールがこの最小値を下回る時はプリンターはこの部位を正確に造形するこ
とが出来ません。
（磨き）は研磨の際に細部が失われる可能性があります。

" 彫り込みのディティール " とはサーフェス内に落ち込んだ箇所のことです。
" 彫り込みのディティール " はプリンターの最小分解能で決まっています。ディ

マテリアル用抜き穴とは、中空モデルから造形されなかったマテリアルを取り
除くための穴です。
モデルが中空部を含んでいる場合、モデルが造形トレーから取り出されてもそ
の中空部にマテリアルが残ったままになっています。中空部のマテリアルを取
り除くには抜き穴が必要ですが、穴が小さいと中身を綺麗に取り除くことが出
来ません。これは特に染色を行うときに重要で、中空部にマテリアルが残って
いるモデルは綺麗に染色ができません。
中空モデルを作成する場合はこのマテリアルを取り出すのに十分な抜き穴を作
成して下さい。
１つの抜き穴しかないモデルは中空部分の隅にあるマテリアルを取り除く事が
難しいので、モデルの大きさに合わせ抜き穴を複数設けていただくことを推奨
します。もし抜き穴がマテリアルを取り除くのに不十分な場合はサイズを大き
くするか数を増やして下さい。
また最悪の場合は中空部の削除をお願いさせて頂きます。

SLS 方式でレーザーによって材料の粉を溶着することで造形します。よってパー
ツ間に十分なクリアランスが保たれている場合、複数のパーツを組み合わ せる
ことで機械的動作を行うモデルを作成することが可能です。
詳細は「各パーツに必要なクリアランス」の項目をご参照ください。

## 各パーツに必要なクリアランス

クリアランスとは各パーツ間の間隔のことです。
SLS 方式でレーザーによって材料の粉を溶着することで造形します。もし各パー ツ間の距離が近すぎる場合、部分的に溶着した粉がその間で固まってしまいま す。これは機械部品の動きを妨げるか、意図して設けた間を埋めてしまう可 能性があります。
造形不良をさけるためにパーツ間のクリアランスを最小クリアランス以上にし てください。
また、1 ファイル内に複数パーツを配置する場合は「1 ファイル内に複数パー ツを配置する場合の注意事項」をご参照ください。

以下の点にご注意下さい
●防水ではありません。
●食べると危険です。口に含む様な用途としてご利用になれません。 ●リサイクル出来ません。
●耐熱温度は 80℃です。
それ以上の温度になると材質の特性が大きく変わってしまいます。

±0.30mm かつ 長軸方向に ±0.15%
※（磨き）は寸法精度が出ません。
※モデルにより寸法精度は異なるため、上記の公差は精度目安となります。

高い

## 精度の目安

## 購入後の取り扱いについて

## 反り、歪みについて

PA12｜SLS
dim ≧ 0.5mm

冷却時に反り、歪みが生じる場合がございます。
特に板状のモデルで発生しやすい現象ですが、SLS 方式の 3D プリンターでは 発生しうる現象となりますのでご留意下さい。

## １ファイル内に複数シェルを配置する場合の注意事項

シェルの間隔と密度に関して
可動部品以外で1ファイルに複数のシェルが含まれている場合、シェルは最低 5mm以上の間隔を開けてください。
複数のシェルが含まれたモデルは直方体に納めたときのバウンディングボックス 容積とモデル容積の割合を10%未満とさせていただきます。 密度が高すぎる場合 は装置故障の原因となる為、キャンセルさせていただく 可能性があります。

ランナー不可に関して
同一形状のモデルのランナー接続はサポート除去時に不具合や破損を生じる可 能性があるためキャンセルさせて頂く可能性があります。

シェルの重なりに関して
データ作成時はシェル同士が重ならないようにご注意ください。重なっているデー タはシェルが結合した状態で造形されます。

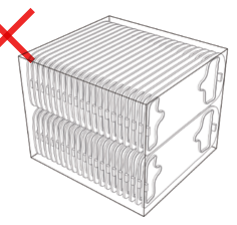
[picture p26: figure]

造形方式ごとの複数シェル配置の方法に関して
造形方式ごとに、モデルを立体的に配置できる方式と平面的にしか配置できない 方式がございます。方式に応じた配置でない場合はキャンセルさせていただく可 能性があります。
詳細は「造形方式ごとの配置の詳細」をご参照ください。

造形方式ごとのサポート除去に関して
造形方式ごとに造形時のサポート方法とその除去方法が異なります。除去不能な 形状の場合はキャンセルさせていただく可能性があります。 詳細は「造形方式ごとのサポート除去の詳細」をご参照ください。

造形時の配置方向に関して
製造時の装置の不具合および造形時の破損を回避するため、お客様がアップロー ドされた際の3Dデータの配置と製造時の配置は異なる可能性があります。 詳細は「当社が定める造形方向と造形方向指定について」をご参照ください。

複数シェル時の納期に関して
大量に配置されている場合等、条件に応じて納期は変動する可能性があります。

t ≧ 5.0mm

t ＜ 5.0mm

## 1 ファイル内の複数シェル

100 シェル

3D プリンター内でモデルが立体的に配置される為、最大造形サイズに収まる範囲で パッキングしてください。
詳細は「1ファイル内に複数パーツを配置する場合の注意事項」並びに「造形方式ご との配置の詳細」をご参照ください。

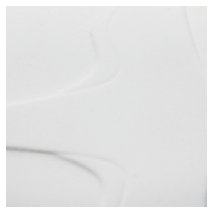
[picture p27: figure]
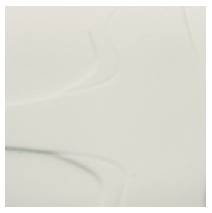
[picture p28: figure]

ナイロン造形は複数の３D データを立体配置し同時に造形して います。
その為、造形時の配置により装置内の温度が均一になりません。 庫内の温度分布によってナイロン造形物は本来の色味である白 から若干黄色に変色する場合がございます。
SLS 方式の３D プリンターでは発生し得る現象となりますので ご留意ください。

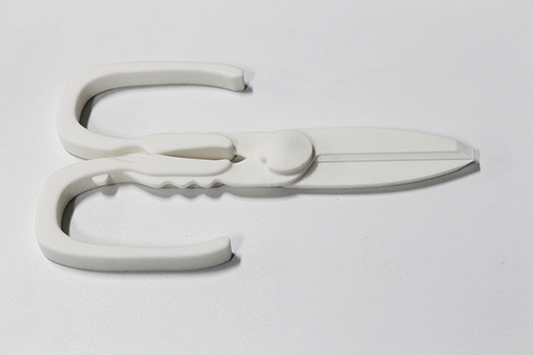
[picture p29: figure]

白い色味が強い状態
同時造形数が少なく、内部温度が低い状況型持たれている場合 は左の画像の様に白い色味となります。

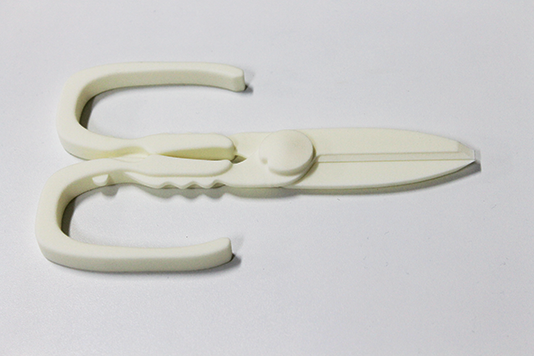
[picture p30: figure]

黄色い色味が強い状態
同時造形数が多く、内部の温度が高い場合は左の画像の様に黄 色い色身となります。

## 色味について

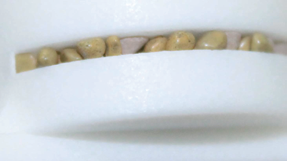
[picture p31: figure]

## うまく磨けるモデルの参考例

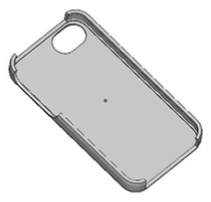
[picture p32: figure]
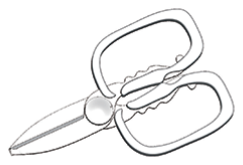
[picture p33: figure]

## うまく磨けないモデルの参考例

t = 1mm

内部は研磨されません

t = 1mm

（磨き）を選択頂く事で SLS 造形特有のざらついた表面を滑らかな質感にする事が可能です。 本素材はバレル研磨機で処理している為、エッジの再現性は低下します。 衝撃に弱い形状、また鋭角な部位や細長い形状は本ガイドラインに記載してある最小肉厚以上でも研磨中に破壊され る可能性があります。
形状によりキャンセルさせて頂く事がある事を予めご留意ください。

※エッジ再現性にこだわりがない場合や破損をご了承頂ける場合はご対応致します。お手数をお掛けしますが、以下 の弊社問い合わせフォームよりご連絡下さい。
https://www.dmm.com/help/-/inquiry/=/category=make/

## 特に注意すべき点

研磨は表面のみとなります。入り組んだ形状や壁に囲まれた内部には研磨用の メディアが入らない為に磨かれません。

高さが1mm以上の浮き彫りは破損のリスクが高くなります。またモデルとモデ ル間を接続する様なランナー形状は破損してしまいます。

円筒形状の中身は磨けません。また最低1mmの厚みが必要です。

中空構造のモデルは研磨時に内部に研磨剤が詰まって除去 できない場合があります。
研磨剤を除去するためには直径10ミリ以上の穴が必要です。 ※形状によって複数箇所必要になります

## 磨きについてご注意いただきたいこと

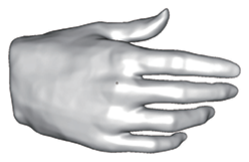
[picture p34: figure]
