nyanko3141592/pendant-recorder/mechanical/README.md

# SolidCraftによる寸法検討

> 最新: [A2 薄型構造モデル](structure-a2/README.md)。24.8×41.5×12.8mmの機械配置案。旧案から厚さ15.8%減、外接容積4.9%減、平面は拡大。未配線・製造不可。

> 現行基板の[Rev A1 内部構造3Dモデル](structure-a1/README.md)を追加。回転・分解ビューア、SolidCraft、STEPを用意。24×38×15.2mmは構造説明用の仮外形。

> 最新追記: 円形制約を解除。Omi相当の小ささで密度を優先し、24×24×14mm角丸外形・21×21mm両面基板を第一の検討枠とする。未配置・未検証。以下の円形寸法は従来の比較案として保持。[最新方針](../docs/density-study.md)。

> v1の外観検討は保留。基板配置と電池確定後に、シンプルな角丸・ネジ留めケースを作る。以下の26mmモデルは将来用の寸法検討として保持する。 詳細: [v1製作方針](../docs/v1-build.md)

SolidCraft公式 v0.21.0 を `/Applications/SolidCraft.app` に導入。CLIは `~/.local/bin/solidcraft-cli`。ダウンロードは https://github.com/tangency-labs/solidcraft/releases/tag/v0.21.0 。APIのSHA-256とローカルファイルが一致した。

- macOS DMG: `f6d0b02e3142e4a966114467c89824a1a42e7042bf92a0f3d1299634244cf68c`
- CLI ZIP: `b86e19b128c0dcffd5e4365beaf991f98d1a176ed1734a3ae5fabba7e750c6ea`

`pendant-fit-study.solidcraft` は編集可能な4ボディのモデル、STEPは交換用、`fit-study.json`は再生成用の履歴。26mm径、12mm厚、1.2mm壁、22×0.8mm基板ダミー、16×4.5mm電池ダミーを配置。USB開口は仮寸法。Omiの円形外形と電池を基板裏に置く構成を参考にしている。

**製造用筐体ではない。** 電池型番と22mm基板は未確定で、Rev AのLQFP64試作は30mm角が前提。このモデルは小型化版の寸法予算だけを示す。マイク底面音孔/シール、ボタン、LED、吊り下げ、蓋の固定、公差、電池膨張余裕、USB実部品との干渉はまだ設計していない。基板配置後にOmiのSTEPも照合して仕上げる。

```sh
solidcraft-cli run mechanical/fit-study.json --save mechanical/pendant-fit-study.solidcraft --out mechanical/pendant-fit-study.step
```

## 外観デザインの候補

Mori/Limitless/Omiを参照した[4案の比較と画像](concepts/README.md)。全案で本体直挿しUSB-Cを維持。まだCADへ反映していない外観コンセプト。
