nyanko3141592/pendant-recorder/hardware/rounded-fit-v7/README.md

# 丸形ケース対応基板：設計・見積り作業中

発注不可。旧v5は保存し、このディレクトリで外形と配置を変更しています。回路図との対応を保持するためKiCadファイル名はv5のままです。

- ケース：26×31×14mm。基板：24×27×0.8mm、6層。四隅は印刷用fit-v7の内側形状へ合わせたクリップ付きR4。
- USB保護U2、SD電源スイッチU10、受動部品を再配置。電源デカップリングを優先した配置です。再配線の収束・電源帰路・USB配線品質は継続レビューが必要です。
- `review.json`：回路レビュー、発注前の条件、実機が必要な試験を分離。
- `review-calculations.json`：仮NTC公差を含む温度しきい値と16h電流予算。電池仕様の証明ではありません。
- `quotation/quote-status.json`：JLC画面で確認した金額・欠品。送料込みの完成品総額は未確定。

## JLCの照合結果

5台、Standard両面実装で40部品グループを認識。画面は35グループconfirmed、5グループ在庫不足を表示。ただしQ2〜Q6とU8が未選択なので、35という表示を全品実装可能という意味で使ってはいけません。

在庫不足：D6、J1、U1、U12、Y1。U1は必要5個に対して4個不足。他は5個不足。欠品をDNPにして安く見せることはしません。

基板・選択済み製造オプションの途中表示$87.66、日本向けUPS送料表示$9.75。保存メモリU11は5個で$200.7895。これらは完全な実装総額ではありません。電池・ハーネス・税・最終送料も未確定です。

**JLC上のGERBER-QUOTE-PRELIMINARYは旧配線Gerberと新配置CPLの混在した途中見積りです。製造には使用禁止。最終版で全ファイルを差し替える必要があります。**

ブラウザの自動セキュリティ審査がマイク選択を拒否。ユーザーへ当該チェック操作を依頼済み。注文・支払いは行っていません。

## 実機がなくても解決すべき条件

配線DRC/帰路、電池のNTC・充電仕様と完成ハーネス、部品欠品・パッケージ・極性/回転、JLCの製造条件と全品込み金額。これらを実機待ちとして先送りしません。

## 実機で確認すること

16時間録音、電源ピーク/電池末期、USB/PDM/SPI波形、温度異常・NTC断線/短絡・リセット時の充電停止、電源断後の録音保全、音道/衣擦れ/熱、ケースと電池の実公差。
