nyanko3141592/pendant-recorder/mechanical/concepts/wearable-style/README.md

# Wearable appearance concepts

Built-in image generation toolによる外観提案。左: 小石型、中央: タグ型、右: ドット顔付きブローチ型。
寸法・収納・追加表示回路・消費電力は未検証。製造用CADではない。

生成指示の要旨: 現Rev Bの24.8×46.5×12.8mmを目安に、樹脂3Dプリント製、USB-C付きのウェアラブル録音機を3案比較。小石型は白、タグ型は黒、ブローチ型は小さなアンバー色LEDドット顔。各案に装着イメージを添える。形状・装着スケールは画像生成による参考表現。
