nyanko3141592/pendant-recorder/docs/history/requirements-before-user-battery-20261026.md

# 現行要件 — V1（追記の最新決定を優先）

## 2026-10-25 最新：5,000円以下のおしゃれな専用レコーダー

ユーザー指定の製品目標は「5,000円以下でおしゃれな専用レコーダー」。価格の対象は未指定のため、当面は完成品の税込販売価格5,000円以下として厳しめに検討する。販売送料の扱いと生産数量は未確定。試作5台の初期費用込み単価、量産時の製造原価、販売価格を混同しない。開発・測定道具・再試作費は別記する。

- USB-Cで充電・有線取出し、接続時のPC自動取込み、連続16時間録音、36時間以上保存、登録鍵による紛失保護、無線なし、専用台なしを維持する。16時間は未実測の必須目標であり達成済みではない。
- 外観は角と辺を丸めたスクエア。落ち着いたマット仕上げ、正面の表示を最小限にし、継ぎ目・固定部・USB開口・マイク穴を一体で設計する。外観案は未製造・未評価。
- 現行23×25×14.4mmの組立模型を比較基準として保持する。薄さ15mm以下を維持しつつ、極端な高密度化より価格・調達性との両立を評価する。大型化を確定した扱いにしない。
- 現行R6の高価な4GB実装メモリを量産前提に固定しない。標準microSD＋ソケットと、安価な実装ストレージを比較する。容量だけでなく待機・書込み・起動電流、完成外形、供給継続性を確認して選ぶ。raw NANDならECC/不良ブロック管理/電源断対策の開発費も計上する。
- 4層化、特殊ビア回避、実装面・部品品種の削減を検討する。成立は未確認。温度監視や電池保護を価格目的で削除しない。
- 量産時の部品・基板実装・電池・ケース・組立検査を合計2,000〜2,500円に収めることを暫定の逆算予算とする。これは見積りではなく設計配分。残額から税、梱包、物流、販売手数料、不良・保証対応、利益を積算し、販売成立性を判定する。

R6は比較用試作候補として保存し、5,000円製品の発注確定版とは扱わない。現行見積りの取得のみでは新価格要件を達成したことにならない。採用部品・新回路・モデルの改版はまだ未実施。

2026-10-24。[V1の範囲と合格条件](v1-scope.md)が現行仕様。方針は**小さく身につけ、音声を録り、USBで自分のPCへ取り出す**。

|項目|必須要件|
|---|---|
|録音時間|充電なし連続16時間以上。無音も保存。実機未達|
|保存量|16kHz mono以上の圧縮音声36時間以上。電池持ちとは別|
|充電・同期|USB-C。接続時は充電のみで録音状態維持。明示操作時だけ同期|
|ローカル取出し|macOS/Windows/Linuxで登録秘密鍵により復号し通常PCM16 WAVを保存|
|紛失保護|本体は公開鍵のみ、平文音声の本体ストレージ保存禁止|
|電源断|標準形式の短い独立区間を逐次確定。確定分を回収。不完全分は検出・保全|
|削除|PC保存・復号・完全性・永続化検証済みの一致録音だけ自動削除。満杯時の未同期上書き禁止|
|表示|概算残量・充電・録音・同期・異常。2 LED＋1ボタン案。画面なし|
|実装|JLC等の業者実装。完成電池・治具を使い手はんだ/リード加工/圧着なし|
|無線|任意。Rev Cは非搭載。将来無線は別基板改版|
|サイズ|上記を満たす範囲で最小化。現収納ドラフト23.8×34×14mm、成立保証ではない|

## 状態遷移の契約

- 電源接続は録音開始/停止、SD所有権を変更しない。充電器でもPCでも同じ。
- 同期の明示要求で録音停止→ファイル確定→FS解放→MSC公開。MSC中はファームがSDに触れない。
- 正常な取外し・USB切断後、MSC要求を止めてからFSを再取得し、同期前の録音状態に戻る。異常抜去時はFSと区間を点検して復旧する。
- 同期先がない電源だけの場合はMSC成立を待ち続けず、安全に元の録音状態へ戻す。タイムアウト/取消操作はファーム設計時に確定。
- 短押しは状態確認のみ。録音/同期を意図せず切り替えない。長押し録音ON/OFF、USB時の2回押し同期は暫定案。
- 概算残量はADC電圧・校正に基づく段階表示。ゲージSOCや正確な残り時間として見せない。CHGだけで満充電と断定しない。
- USB列挙前/suspend/電流制限/異常温度では安全な給電・停止条件を優先し、通常充電中録音の動作と区別して試験する。

## 保存・公開範囲

音声は標準IMA-ADPCM WAV、短区間ごとの標準age v1暗号化を評価。独自音声形式や独自暗号コンテナを新設しない。実装・実機電源断試験前に最大損失秒数を保証しない。詳細はprotocol/配下を参照。

回路・機構・ファーム・最小ホストCLIを公開。文字起こし・要約・Notion・課金・クラウドはV1必須外。独自成果物MIT、第三者ライセンス保持。

## 設計状況と履歴

[Rev C回路](../hardware/rev-c/README.md)、[発注状態](../hardware/rev-c/order-status.json)、[決定0006](decisions/0006-size-first-16h.md)を参照。16h動作・36h保存・暗号同期・無加工組立は未検証。旧24h/無線搭載必須/5 LED/MAX17048要件は撤回済み。[旧要件記録](history/requirements-pre-c0.md)は履歴として保持する。

## ペンダント装着の設計条件（2026-10-24追加）

ユーザーの「ペンダント型にすることも考慮」を明示要件として記録。円形本体を首から下げて使う前提で、次の機構設計へ反映する。

- 紐固定部を含めた完成外形・厚さ・重量でOmiと比較する。現D1のD25.5×14.5mmは装着部未設計の本体寸法であり、ペンダント完成寸法ではない。
- 外付けの大きな耳を足す前に、ケース上部/背面へ紐通しを収める構造を優先検討。電池・基板・絶縁・壁厚との干渉がある場合は外形への影響を数値で示す。現寸法内に収まるとは未検証で保証しない。
- 固定位置を重心より上に置き、正面が安定して身体へ向く構成を検討する。背面の肌当たり、角、揺れ、反転、衣擦れを装着試験で評価する。
- マイク入口は身体/衣服/紐で塞がれにくい位置へ。衣擦れ対策と音道を機構に含め、首掛け状態で録音評価する。
- 紐固定部とUSB-Cケーブルの干渉を避け、充電時に紐を外さなくてよい構成を目指す。USBを下側、紐を上側にする向きを第一候補とし、現基板の回転も含めて検討する。
- 樹脂プリントの積層方向と固定部断面を決め、紐の引張り・繰返し荷重・落下で破損を検証する。首紐には引っ掛かり時に外れる市販部材を候補とする。安全性を未試験で保証しない。
- ケースと紐は工具やはんだ作業なしに取り付けられる完成部材を優先する。

この追記ではCADを改版していない。紐固定部・音道・重心・装着強度の実設計/検証は未完了。

## 2026-10-25 印刷後の優先順位（ユーザー再確認）

最優先の差別化は、本体USB-CでPCと有線接続し、録音を書き出せること。同じ端子で充電する。Bluetooth/Wi-Fi等の無線通信は不要。有線データ通信は必須なので「通信不要」をUSBデータ機能の削除と解釈しない。外観表示は電池インジケーターで十分とされたため、従来の録音/同期等の専用LED数は固定要件から外す。コンパクトなら形状は自由。連続16h、専用充電台なし、厚さOmi以下、電池の調達性/コスト重視は保持する。

Omi充電台のローカル原本reference/omi/hardware-consumer/charger-schematic.pdfではPP1=VOUT_5V、PP2=GNDの2接点。USBデータ転送経路はない。主基板の書込/検査端子と充電接点を混同しない。USBデータ線2本自体の面積より、本体USB-Cコネクタの実寸・固定・開口と配置制約の影響が大きい。無線の省略による消費電流削減量は未測定。現候補も無線ICを搭載していないため、今後無線を削除するだけで小型化するという説明はしない。

## 2026-10-25 小型廉価比較案 mini-usb-v9

今回印刷したfit-v7を比較基準として固定。小型化の比較は旧印刷モデル・新案・Omi寸法目安を同縮尺で行う。USB-C書き出し＋充電/16h/無線なし/電池表示を保持し、機能と部品の削減を優先。設計案は`hardware/mini-usb-v9/README.md`。新案26×28×14mmと68実装点は配置・仮包絡の結果であり配線/実機/調達の成立保証ではない。512MiBへの縮小、PDM低電力モード、4層化は評価候補。16h目標や温度保護を緩和した扱いにしない。

## 2026-10-25 角丸四角を優先

ユーザーは円形の空間効率を疑問視し、四角い外形への変更を希望。Omiの円形を模倣することより、四角い電池と回路の収納効率・小型さを優先する。辺と角は丸める。mini-rect-v10の23×25×14mmは同一部品・電池の未配線配置および仮包絡模型の結果で、製造寸法の確定ではない。

## 2026-10-25 自動取込み・mini-rect-v11（最新）

ユーザーはUSBメモリとしての公開とPC側接続検知による自動取込みを承認。従来の「同期は毎回明示操作」をこの範囲で変更する。USBデータ接続の成立後に録音区間を確定し、ファイルシステムを解放してMSCに渡す。電源だけの充電器接続では録音を続ける。PC側は登録鍵でコピー・復号・完全性確認・永続化を自動実行する。PCがマウントしただけで同期完了とせず、MSC中は本体が同じ保存領域へアクセスしない。取り込み中の録音停止と安全な取り外し後の復帰を明示する。

mini-rect-v10の23×25×14mm角丸スクエアを比較原本に保持し、次版mini-rect-v11を開発する。16h連続録音、36h保存を維持する。512MiB案は36h保存に不足するため修正必須。省電力は無音を捨てず、DMA・まとめ書き・周辺回路休止と処理効率化で追求する。ケースはマイク音道・開口とUSB開口・継ぎ目を設計する。回路と配置配線、ファーム/PC同期、組立モデル、JLC部品照合・製造データ・送料込み見積りを完成させることを作業目標とし、注文支払いは行わない。発注判定正本はhardware/mini-rect-v11/order-status.json。

## 2026-10-26 現行の寸法・電池と発注前後の確認範囲

完成外形の許容上限はユーザー確認済みの **30×32×15mm**。300mAhを使う大型案は比較用に留める。市販・別売り・保護回路と完成コネクタ付き電池を優先し、DTP401525-XE（110mAh）を現行の設計候補とする。配線出口・曲げ・嵌合を含む収まりは未確認で、採用確定ではない。手はんだ・圧着を購入者に要求しない。

最新の基板候補は `hardware/mini-rect-v15/input-control-pa2-pb5/usb-reference-power.kicad_pcb`。ケースは複数の比較案があり、接着パッドを含む案も未採用。角・辺の仕上げ、ペンダント装着、配線、蓋固定、熱接触と音響の条件を一つの組立案にまとめる必要がある。古いV13/V14の寸法・電池・見積りは現行の成立根拠にしない。

発注前には、寸法と電気仕様の整合、採用部品、同じ版の製造データ、組立・検査手順、5台分の費用と残るリスクを揃える。連続16時間、実カードの電流・遅延、USB実機動作、音質・落下等は試作後の合格条件として扱う。これらを未達のまま達成済みとは書かないが、試作する前に実測合格を要求するものでもない。36時間保存と5,000円製品目標は維持し、試作費と販売価格は分ける。

## 2026-10-26 Omiサイズへの再検討（最新）

ユーザーは30×32mm案を大きいと評価し「Omiサイズにはできんか？」と再指定。30×32×15mmは過去の許容回答として保持するが、現在の設計目標達成とは扱わない。形状自由の既決定を維持し、完成外形の小型化を電池選定から再検討する。16h連続・36h暗号化保存・本体USB-Cデータ/充電・専用台なし・無線なし・別売り保護/完成コネクタ付き電池・購入者のはんだ/圧着/線切断なしを維持。

Omi公式mechanical資料は直径25.5mmと記す一方wrapper OD28.61mmも併記しており、完成品全体の実寸検証は未完。25.5mmは比較目安で、円形必須とも完成外形保証とも扱わない。V15/XE110案は比較原本として残し、小型案の成立根拠に転用しない。最新候補比較はdocs/sourcing/omi-size-battery-rescreen.json。基板実装メモリーへの変更は検討候補で、採用/容量/消費電流未確定。
