nyanko3141592/pendant-recorder/docs/decisions/0004-hardware-first-v1.md

# 0004 — ハードウェア中心のv1と同期後の自動整理

2026-10-24。最新ユーザー指定。以前の「自動削除は初期値オフ」「無線MCUは比較のみ」を、以下の範囲で更新する。

## 提供する価値

小型で装着しやすく、長時間の音声を欠落しにくい形で記録し、登録鍵を持つPCへ取り出せるハードウェアを販売する。回路・機構・ファーム・相互運用仕様を公開する。AI機能や用途別アプリを囲い込まない。公式は最低限の同期/復号/音声出力CLIと互換性試験を提供し、第三者アプリを使えるようにする。

## v1の仕様案（測定済み製品仕様ではない）

| 項目 | 要件/目標 |
|---|---|
| 電池 | 無充電で連続24時間超を必須合格条件。30〜36時間は努力目標。既製保護付き110mAhを維持してまず評価 |
| 保存 | 圧縮音声36時間以上。4GBを第一候補。16kHz mono IMA-ADPCMで36h約1.04GB＋標準暗号化/ファイル管理分 |
| 同期 | USB-C。接続直後は充電のみ、明示操作で録音を止めてMSCへ。鍵付きPCで復号し通常PCM WAVへ出力 |
| 暗号 | 既存形式・既存実装。標準WAV＋age v1の独立短区間を評価。難読化/拡張子変更を保護の代替にしない。未実装 |
| 自動削除 | 正式な同期処理でPC側保存/復号/検証が完了した対象だけ本体から自動削除。失敗/未完了/未検証は残す |
| ファイル区切り | 電源断対策の短区間保存と、利用者向けの無音区切りを分離。無音で区切れなくても上限時間で分割。無音保存省略は既定にしない |
| 状態表示 | 電源/録音状態と概算残量を簡潔に表示。充電/同期/異常は必要時に同じ表示で識別する。LED数は再検討、既存5点を必須固定しない |
| 外観 | スタイリッシュで小型、厚さ15mm上限・12〜13mm目標。樹脂3Dプリントで初期から装着検討。現モデル外形は確定値ではない |
| 本体に載せない処理 | 文字起こし、要約、ノイズ除去、クラウド/API連携、録音の意味解釈 |

## Bluetoothと新回路

ユーザーはBluetooth対応MCUへの設計変更を許可。新Rev BはnRF52840を第一候補にUSB/PDM/SPI SD/暗号化を設計する。具体パッケージと電源構成は部品調達・必要端子・電流・面積の照合で確定する。STM32 Rev Aを上書きして同じ回路と扱わない。

アンテナ方針は[決定0005](0005-integrated-antenna.md)で更新。v1ハードからアンテナ内蔵Bluetoothモジュールを実装する。ソフトv1は無線停止・USB同期、ソフトv2で同じハード上のBluetooth同期を目指す。無線動作・通信距離・同期速度は未検証。

新回路への変更で、SDMMC→SPI、クロック、電源、書込み治具、マイク接続、暗号実装、RAM/Flashを再監査。既存の2mAは目標であり、nRFで達成した電流ではない。既存A1のERC合格をRev Bへ流用しない。

## 同期後削除の条件

1. 対象の録音ID・元暗号文ハッシュ・サイズを記録してPCへコピーする。
2. 登録鍵で標準形式の認証/復号を完了し、有効サンプル数を含むWAV検査を行う。
3. PCの最終出力へ確定し、読み戻し/ハッシュ確認、OSの永続化処理の成功を確認して受領記録を保存する。保存先が平文であることを説明する。PC自体の故障まで保護する独立バックアップではない。
4. 現在マウントしている正しい本体上で、録音ID・内容が一致するファイルだけ削除する。ディレクトリ一括削除・名前だけの一致・サイズだけの一致・シェルワイルドカード削除は禁止。
5. MSC中はホストだけがFSを操作。FWが同時に削除しない。切断後に容量とFS状態を再取得し、同期前の録音状態へ戻す。

中断時は保存記録と内容を再照合し、再実行で安全に続ける。復号鍵なし、改ざん、ディスク満杯、未完了録音は自動削除しない。全件削除/古い順上書きは今回の許可に含めない。満杯では表示して停止し、未同期録音を勝手に上書きしない。手動ファイルコピーでは受領を確認できないため、自動削除しない。公式CLIと第三者ツールに同じ条件を公開する。

## 区切りと録音継続

無音で区切る目的は、後段で扱いやすい音声にすること。無音と判定した音を捨てることではない。録音中は前後サンプルを保持し、区切り境界で欠落/重複がないことを検証する。短い電源断対策区間は従来通り独立して確定し、PCへの取出し時に無音区切りのWAVへまとめる方式を第一評価案にする。区切りの判定は軽量でよく、ノイズ除去や意味解析は行わない。

区切り長・無音閾値・無音継続時間・最大出力長は未確定。検証用の固定時間分割を必ず残す。PC側での無音区切りは取り出し時の任意設定とし、複雑な処理を必須にしない。
