nyanko3141592/pendant-recorder/docs/decisions/0002-encryption-and-industrial-design.md

# 0002 — 紛失時の録音保護と初期からの外観設計

> 最新指定: 独自保存形式を作らない。[既存形式と電源断回収](../protocol/power-loss-recovery.md)を優先。独自暗号コンテナ案は撤回。短い標準WAV＋独立した標準ageファイルを評価候補にする。未実装・未採用確定。

日付: 2026-10-24 / 状態: 要件確定、方式は実装・検証前

## 紛失時の最低限の保護

登録したPC側に復号鍵がなければ、拾った本体や内蔵ストレージから録音内容を読み出せないことをv1要件にする。端末名・USB識別子の照合、アプリだけのパスワード画面では代用しない。秘密鍵を本体に恒久保存しない公開鍵方式を第一案とする。

基本フロー:

1. 初回USB接続でMacアプリが鍵を生成。秘密鍵はMacのKeychainに格納し、本体には公開鍵と鍵IDのみ登録。初回登録には本体ボタンで物理的な確認を要求する。無線ペアリングではない。
2. 本体は録音ファイルごとに乱数から一時的なデータ鍵を生成。音声と詳細メタデータを認証付き暗号で逐次暗号化し、SDには暗号文だけ保存。データ鍵はMacの公開鍵で包み、ファイルと共に保存。平文データ鍵はRAMに限り、ファイル終了時に消去する。
3. USB接続直後は従来通り充電のみ。明示同期時にMSCを公開するが、中身は暗号化ファイル。未登録PCでも暗号文をコピーできる可能性はあるが、録音内容は復号できない設計とする。
4. Macは暗号文をコピー/検証し、Keychainの鍵で復号してローカル文字起こしする。平文の恒久保存は初期値オフを目標とし、処理中の一時ファイル・文字起こし・要約も保存先と保持方針を明示する。OSのスワップやバックアップまで無条件に保護できると主張しない。
5. 未登録・鍵異常・乱数異常時は平文録音へフォールバックしない。録音不可を表示する。鍵のバックアップ/復元手順を初回セットアップに含める。鍵紛失時に過去録音を復旧できる管理者用の裏口は作らない。

Macを第一対象にする。将来のモバイル/別PCは鍵移行・追加登録で対応を検討するが、v1でスマホ連携やBLEを追加しない。

## 方式候補と未確定項目

既存ライブラリの認証付きストリーム暗号＋公開鍵による鍵包装を使い、独自暗号を作らない。例としてlibsodiumのsecretstreamとsealed boxを評価するが、STM32への移植性・RAM/Flash・乱数初期化・電力・速度を確認してから採用する。sealed box単体では送信者の真正性を証明しないため「正規本体で録音された証拠」には使わない。

ファイル形式はバージョン付き暗号化コンテナを新たに定義する。復号後はADPCM/PCM WAV。ファイルヘッダー・鍵ID・ブロック順序・終端を認証対象にし、改ざん/誤鍵を拒否する。途中電源断では認証済みの完結ブロックまで回復可能にし、欠けた終端は未完了と表示する。欠落を正常終了扱いにしない。nonce/鍵再利用を起こさない。ファイル名は識別子を使い、詳細時刻は暗号化する案を評価するが、ファイル数・サイズ・FAT更新時刻等のメタデータは残り得る。

公開鍵はUSB上のファイルを置くだけで勝手に更新できない設計にする。鍵変更は既存鍵による認証付き手続き＋本体操作を基本とし、認証プロトコルは未設計。鍵喪失時の再登録は物理操作と警告を必要とし、過去暗号文は消去せず保持する。新規登録で過去録音が読めるようになってはならない。追加PCへの過去録音アクセスは既存Macから安全に鍵を移行する方式を先に評価する。

MSC上で従来のWAVを直接再生する仕様は取り下げる。専用OSSアプリか公開仕様に沿った復号ツールが必要。TIME.TXTは制御入力として分離し、厳密な形式検証を行う。時刻改変への耐性は録音内容の暗号化とは別の課題。

## 保護範囲とv1試験

最初の対象は紛失後のUSB読出し・SDのコピー。専門的なRAM解析、録音中の物理攻撃、改造ファーム、登録Macの侵害、悪意ある販売者に対する完全な保護は保証しない。MCUデバッグ保護・ファーム更新検証は開発時SWD復旧との両立を設計してから導入し、開発中に不可逆なロック設定を行わない。

- 正しい鍵で復号、誤鍵/未登録PCで失敗。バイナリの全SDイメージに平文音声や平文鍵が残らないことを確認。
- 暗号文の変更・ブロックの並替え・切詰め・誤ったヘッダーを検出。
- 録音中の電源断から完結済みブロックを回復し、未完了を明示。
- 再起動・連続録音で鍵/nonce再利用を防止。乱数源故障時は録音停止。
- 鍵のバックアップ/復元、別Macへの移行、再登録後の旧録音保持を確認。
- 暗号化を有効にして24時間連続録音し、電池端平均電流とRAM/Flash使用量を測定。従来の2mAは目標のまま、達成を仮定しない。

旧ファーム/hostスタブは平文WAV前提であり、この保護を実装していない。実装・試験完了までは機密録音に使用できる製品と表示しない。

## 外観と開発順序

初期から装着時の見た目・薄さ・触感を主要要件にする。「外観の磨き込みを後回し」は撤回。ただし外観モデルで電気的成立を偽装しない。

二つを並行して進める: (a) 業者実装基板で暗号化録音/同期/充電の挙動を成立させる、(b) 実電池・コネクタ・配線・音路・LED・ボタン・首紐/固定を含めた、装着して比較できる樹脂3Dプリント外装を初期から作る。外装とPCBの位置関係を固定する前に、両者を擦り合わせる。

v1は樹脂3Dプリント製ケース。内部保持部（基板/電池/絶縁/NTC接触/マイクシール）と外装の役割を分離し、将来金属外装に変更できる構造を目指す。部品数増加や厚さ増大が大きければ一体化を比較し、二重殻を必須にはしない。

金属化は同じSTLの材質変更だけでは済ませない。製法ごとの肉厚・公差・支持/粉抜き・ネジ・後加工・表面仕上げを再設計し、重量、熱伝導による電池/NTCへの影響、導電外装の絶縁・ESD・USBシールド、音響、皮膚に触れる表面を検証する。金属造形業者/材質は未選定。樹脂段階で内部の固定基準・外装境界・音孔位置を文書化して移行を容易にする。

## 参照

- https://libsodium.gitbook.io/doc/secret-key_cryptography/secretstream
- https://libsodium.gitbook.io/doc/public-key_cryptography/sealed_boxes
- https://developer.apple.com/documentation/security/keychain-services

## 後続決定: ホストの最小範囲

ユーザーが公式ツールの責務を同期して音声を取得するまでに限定したため、通常syncは登録鍵で復号したWAVを指定PCフォルダへ保存する仕様に更新。上記の「平文の恒久保存は初期値オフ」の案は、この明示同期によるWAV出力について置き換える。本体は暗号化保存を維持し、PC上の平文音声の保存先を説明する。文字起こし・要約は必須機能から外す。
