nyanko3141592/pendant-recorder/docs/decisions/0005-integrated-antenna.md

# 0005 — アンテナ内蔵モジュールとソフトの段階分け

2026-10-24、ユーザー指定「アンテナ内蔵がいいな」。0004のアンテナ省略許容を撤回する。

## 確定した方針

- v1ハードはBluetooth MCUとアンテナを内蔵したモジュールを業者実装する。外付けアンテナの差込み、ケーブル引回し、手元のRF部品実装は不要とする。
- ソフトv1は無線を停止し、録音・暗号化保存・USB-C充電・登録鍵を持つPCへの有線同期を検証する。
- ソフトv2は同じ基板でBluetooth同期を実装する計画。無線プロトコル、速度、電流、更新方法は未実装であり、ソフト更新のみでの成立は試験前に保証しない。
- 24時間超の録音、36時間以上の保存、厚さ15mm以下、手はんだゼロの条件は維持する。無線停止時の消費電流も実測する。

## 回路設計の第一候補

Raytac **MDBT50Q-1MV2**。nRF52840、チップアンテナ内蔵、メーカー公称 **10.5 × 15.5 × 2.05mm**。USB・PDM・SPIを備える。これはモジュール単体の寸法で、アンテナ周囲の必要空間や完成ケース寸法ではない。

内蔵アンテナ方式は確定。具体品番は、全端子・電源・USB・必要部品・推奨配置・JLCでの調達/実装受理を照合して確定する。類似名のATファーム製品や外付けアンテナ版を同等品として置換しない。メーカー販売リンクはJLCでの実装受理の証明ではない。

## 配置・検証条件

1. アンテナ端を基板外周側に向ける。メーカーの設計ガイドに従い、全層の銅箔、配線、部品の禁止領域をPCBに設定する。具体的な禁止寸法は資料照合後に確定する。
2. 電池、電池線、USBシールド、留め具、金属外装がアンテナ周囲を覆わない構造とする。電池直上への重ね置きで小型化したと扱わない。
3. 樹脂ケースで装着状態の通信を検証する。将来の金属ケースにはアンテナ位置の樹脂窓等が必要となる可能性があり、全面金属への単純置換を前提にしない。
4. ソフトv1が無線停止でも、試験用ファームで初回基板のRF動作を確認する。無線部の不良や配置問題をソフトv2まで放置しない。
5. 書込み治具とファーム更新経路をnRF用に選定する。Rev AのSTM32用治具をそのまま流用可能とは扱わない。

## 現状

Rev Bは設計入力段階。回路図、配線、モジュール実装受理、筐体寸法、電池持ち、RF性能は未確定。既存Rev AのERC結果や構造モデルはRev Bの検証結果ではない。

## 出典

- [Raytac MDBT50Q-1MV2 製品仕様・データシート・設計ガイド](https://www.raytac.com/product/ins.php?index_id=24)（2026-10-24確認）。モジュール認証の記載を完成製品の認証完了とは扱わない。
