nyanko3141592/pendant-recorder/docs/procurement/preorder.md

# D1.1 / D2 発注準備台帳

2026-10-25。5台の技術試作を予算の基準とする（数量の購入確定ではない）。**まだ発注不可。** 支払いだけで進められる状態には達していない。費用は [cost.md](cost.md)。

## 照会へ渡すファイル

- 回路・基板: `hardware/omi-fit-d1/`。D23mm、6層、0.8mm、69実装参照。
- Gerber / drill / BOM / CPL: `hardware/omi-fit-d1/DFM-REVIEW-NOT-FOR-ORDER.zip`。照会用のみ。
- ケース: `mechanical/structure-d2/` の STEP / SolidCraft。D25.5×14.5mmの予約外形、電池未確定。
- 電池照会: `docs/sourcing/grepow-inquiry.txt`。未送信。
- 基板照会: `docs/sourcing/jlc-inquiry.txt`。未送信。
- 電気指摘: `docs/d1-electrical-review.md`。

## リリース判定表

| ID | 完了させること | 必要な証拠 | 現在 |
|---|---|---|---|
| E1 | 電源、USB帰路、発振、デカップリングのレビュー | 指摘ごとの修正/根拠、最新ERC/DRC/等価性検査 | 接続検査0のみ。品質レビュー未完 |
| B1 | 完成保護パック、SHハーネス極性、最大外形の確定 | メーカー品番・完成図面・充電温度・MOQ・正式見積り | 未回答 |
| B2 | BQ25101の温度制御と電池条件の整合 | 45〜60℃の充電可否。不可なら回路改版と再レビュー | 未解決 |
| P1 | 6層0.8mm、0.35/0.15mmビア、USBランドの製造受理 | 業者DFM、確定積層、パネル/分割仕様 | 未受理 |
| P2 | 全69部品の調達、フットプリント、極性・回転 | 品番固定、CPLプレビュー確認、欠品/ロス数量・代替承認 | 候補37品種、未確定 |
| M1 | 完成電池・実部品高さを含むケース干渉確認 | 公差込み断面、印刷材料、固定・音道・ボタン/光路 | 未完 |
| J1 | 無はんだ組立・書込み・測定セット | 購入品番、完成ハーネス、保持治具図、挿入空間 | 未完 |
| Q1 | 費用と納期の確定 | 基板/実装/電池/ケース/輸送の正式見積り | 予算枠のみ |
| R1 | 最終出力の一致と製造承認 | 基板ハッシュ一致、上記証拠、組立図・受入検査手順 | 未リリース |

基板だけ先に発注すると、電池の温度条件や外形によって改版が必要になり得る。B1/B2を先に解決する。照会回答の前に「充電ICはこのままでよい」「ケースが成立」「無はんだで揃う」と確定しない。

## JLC入力条件の転記用メモ

Standard PCBA / 両面 / 5台を基準、10台との差額も照会。円形23mm、6層、厚さ0.8mm、最小線幅/間隔0.10/0.10mm、最小ビア径0.35mm・穴0.15mm。表面処理、銅厚、インピーダンス、積層、パネル、分割方法、治具穴は業者受理後に確定する。クーポンや最低価格広告を製造費に採用しない。全69実装参照を業者実装し、J3/TP1〜6の7接点群は部品実装から除外する。

部品位置確認ではUSB、電池ヘッダ、MCUの1番、マイク音孔、DSBGA、ダイオード、LEDの極性を表裏で照合する。基板内へのメーカー識別印・治具穴の自動追加は小型基板の音道/接点/配線と衝突しないことを確認する。

## 受領後の最初の試験

電池を付ける前に外観/極性/短絡を検査し、電流制限付き給電で3.3V/1.8VとSWD疎通を確認。充電試験は確定した電池条件と温度測定の下で行う。その後、マイク→圧縮→暗号化→保存→USB取出しのファームを実装・試験する。16h連続録音、36h保存、電源断復旧、OS別同期は実機合格まで未達。組立品が届いた時点で完成録音機になるわけではない。

照会送信・購入・支払いは行っていない。外部回答が得られたらこの表に回答資料と日付を追記し、回路/CADを反映してから最終製造ファイルを生成する。
