nyanko3141592/pendant-recorder/mechanical/structure-a1/viewer.html

# Pendant Recorder / Rev A1

内部構造の検討モデル · ケース仮寸法 24 × 38 × 15.2 mm · 基板 20 × 34 × 0.8 mm

製造用ではありません。部品位置はA1基板から取得、形状・高さは簡略化。付属電池配線・固定・音響経路は未検証。

🟨 電池 15.5 × 27 × 4.2 mm🟩 両面基板⬜ USB-C / PH電池端子◼ ケース・蓋

分解 視点を戻す ケース表示

ドラッグで回転、ホイールで拡大縮小。USB側の壁を省いた断面説明用ケースです。完成外形・配線成立・24時間動作を保証するモデルではありません。
