nyanko3141592/pendant-recorder/docs/procurement/xe-q3-land-comparison.png

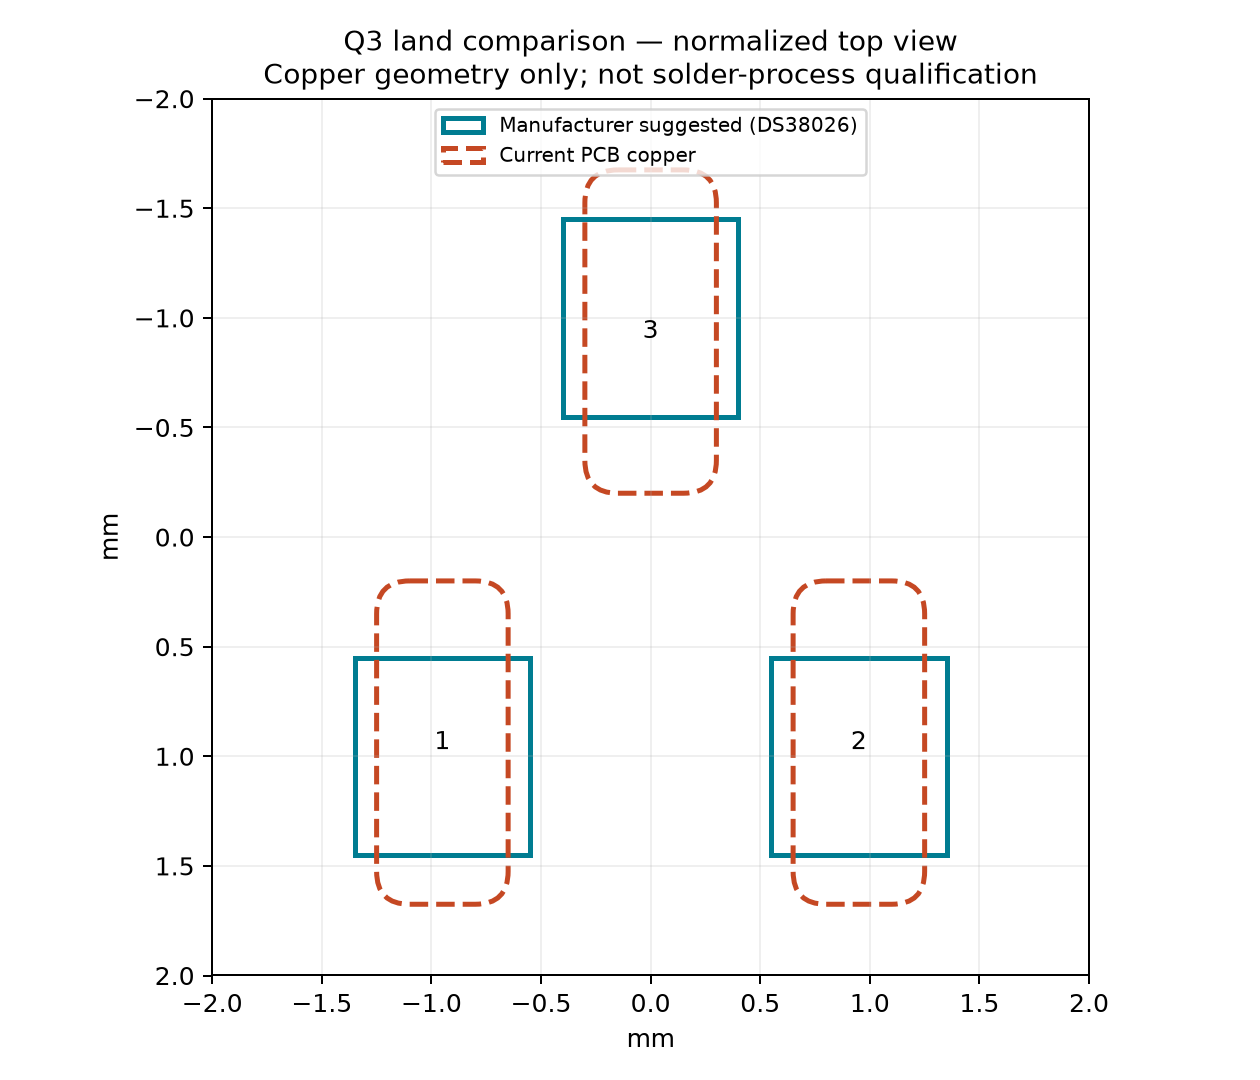
docs/procurement/xe-q3-land-comparison.png
