nyanko3141592/pendant-recorder/hardware/power-study/xe-charger/evidence/NCU18XH103F60RB-2023-page1.png

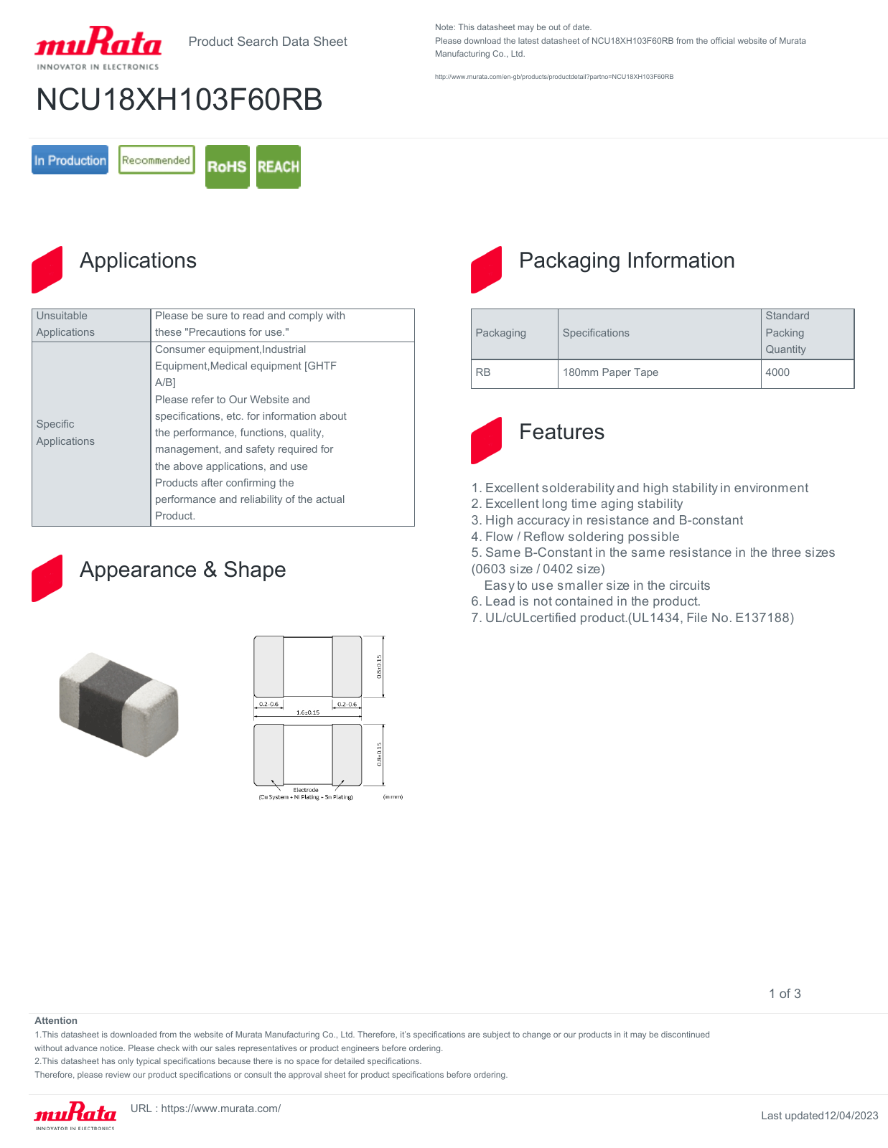
hardware/power-study/xe-charger/evidence/NCU18XH103F60RB-2023-page1.png
