nyanko3141592/pendant-recorder/hardware/rounded-fit-v7/MIC_WAKE-obstacles.png

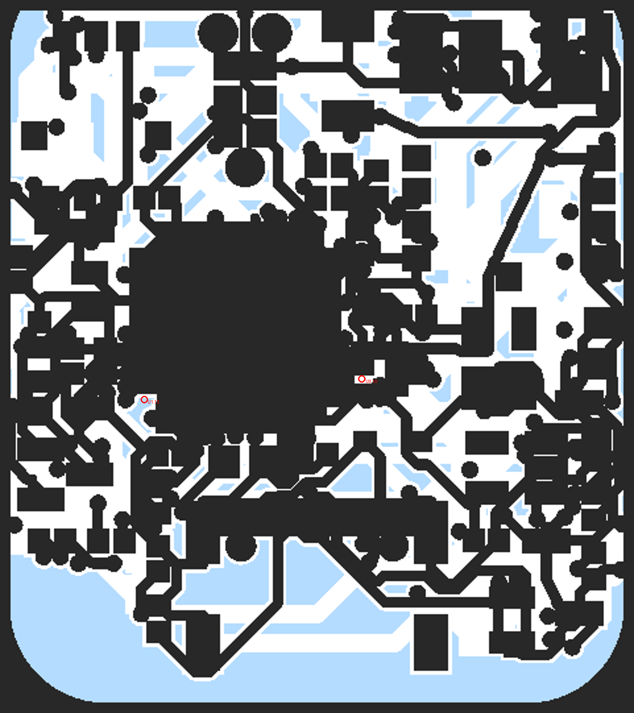
hardware/rounded-fit-v7/MIC_WAKE-obstacles.png
