nyanko3141592/pendant-recorder/hardware/xe-minimal/costdown/HW-V1.4-EVT-4LAYER-27P5/route/hw-v1.4-4layer-top.png

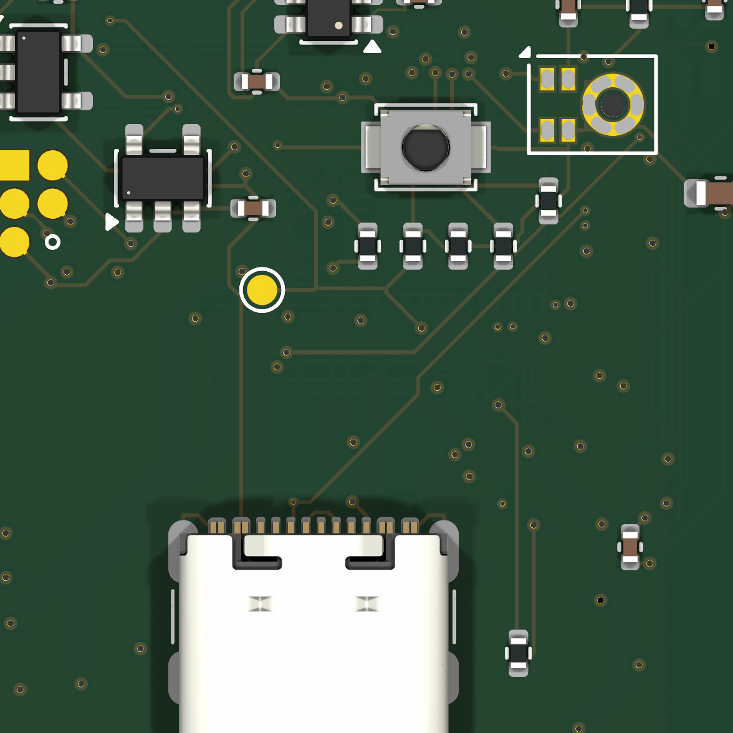
hardware/xe-minimal/costdown/HW-V1.4-EVT-4LAYER-27P5/route/hw-v1.4-4layer-top.png
