nyanko3141592/pendant-recorder/hardware/xe-minimal/electrical-panel-candidate-v3/fabrication-review-ac715808f9dc/silk-cleanup-proposal/panel-B_Silkscreen.png

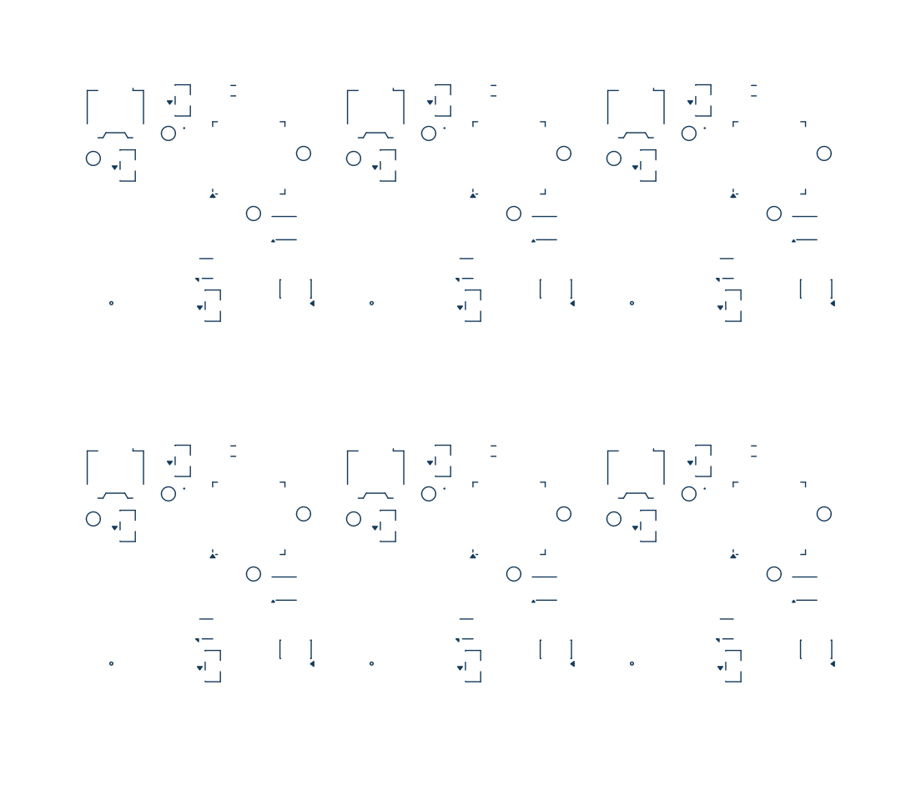
hardware/xe-minimal/electrical-panel-candidate-v3/fabrication-review-ac715808f9dc/silk-cleanup-proposal/panel-B_Silkscreen.png
