nyanko3141592/pendant-recorder/hardware/xe-minimal/evidence/DMN52D0U-page1.png

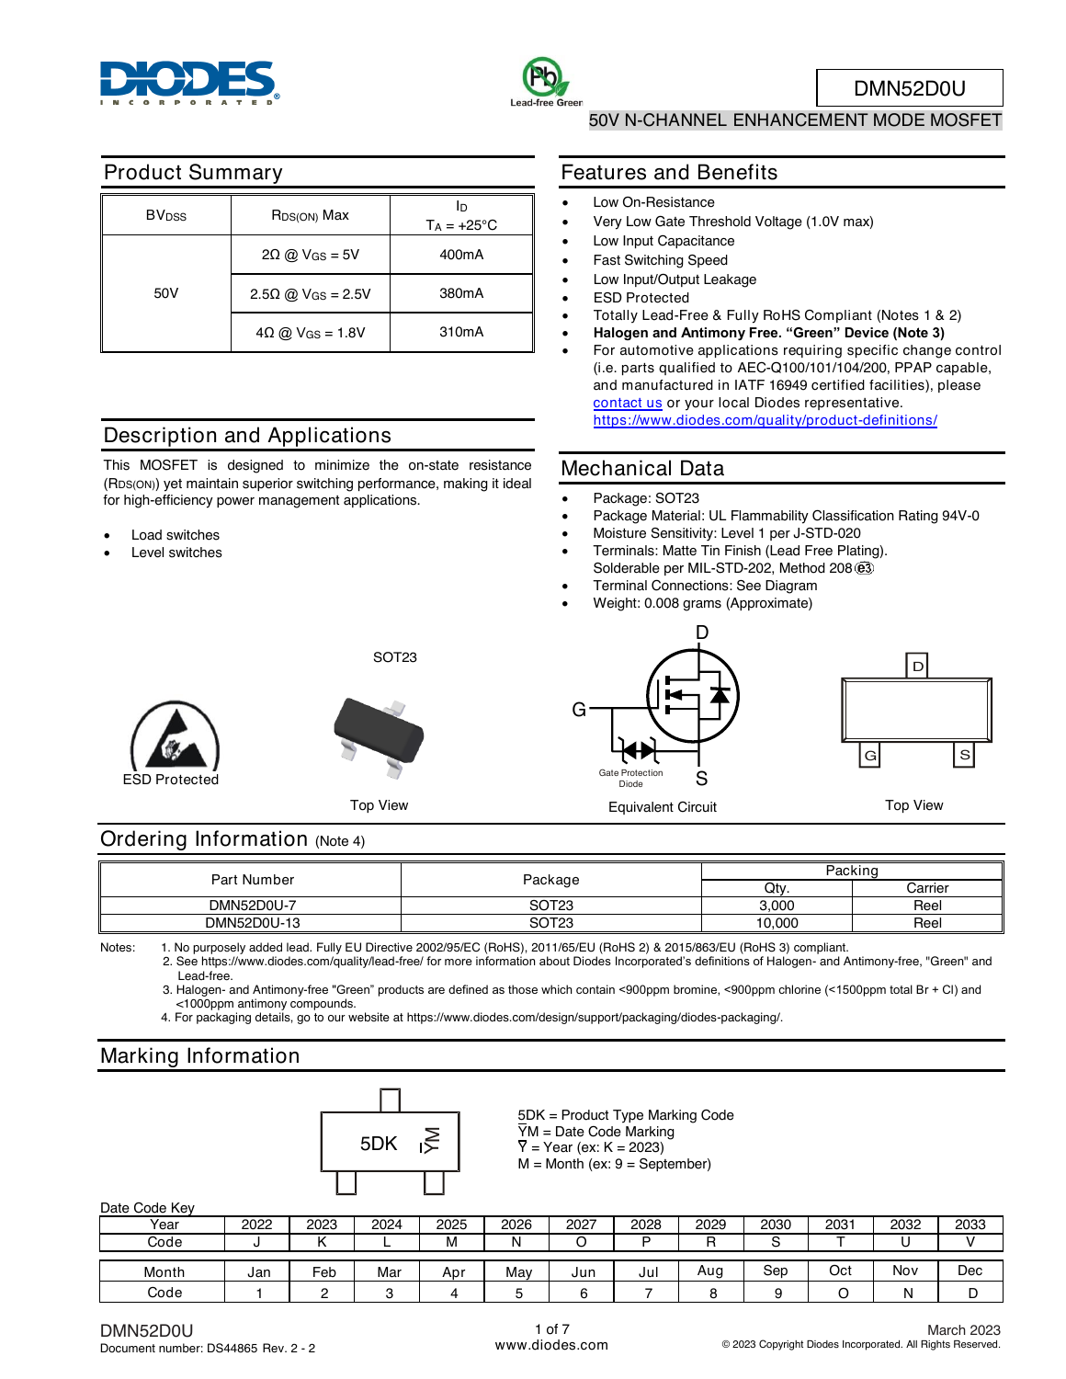
hardware/xe-minimal/evidence/DMN52D0U-page1.png
