nyanko3141592/pendant-recorder/hardware/xe-minimal/evidence/DMN52D0U-page2.png

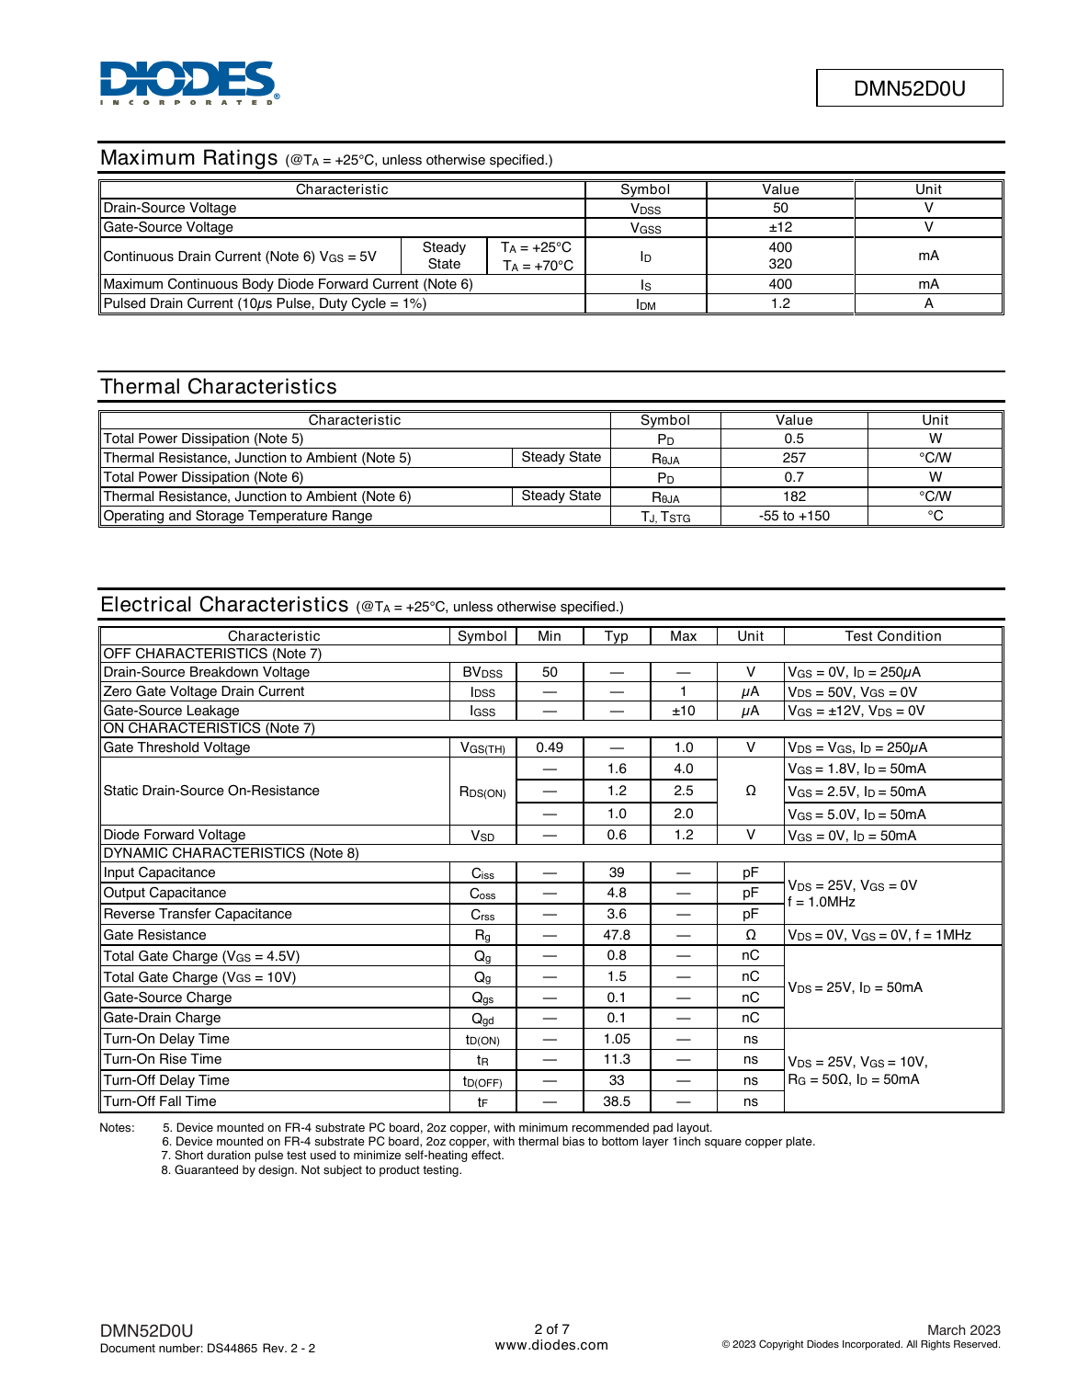
hardware/xe-minimal/evidence/DMN52D0U-page2.png
