nyanko3141592/pendant-recorder/hardware/xe-minimal/evidence/DMN63D8L-page1.png

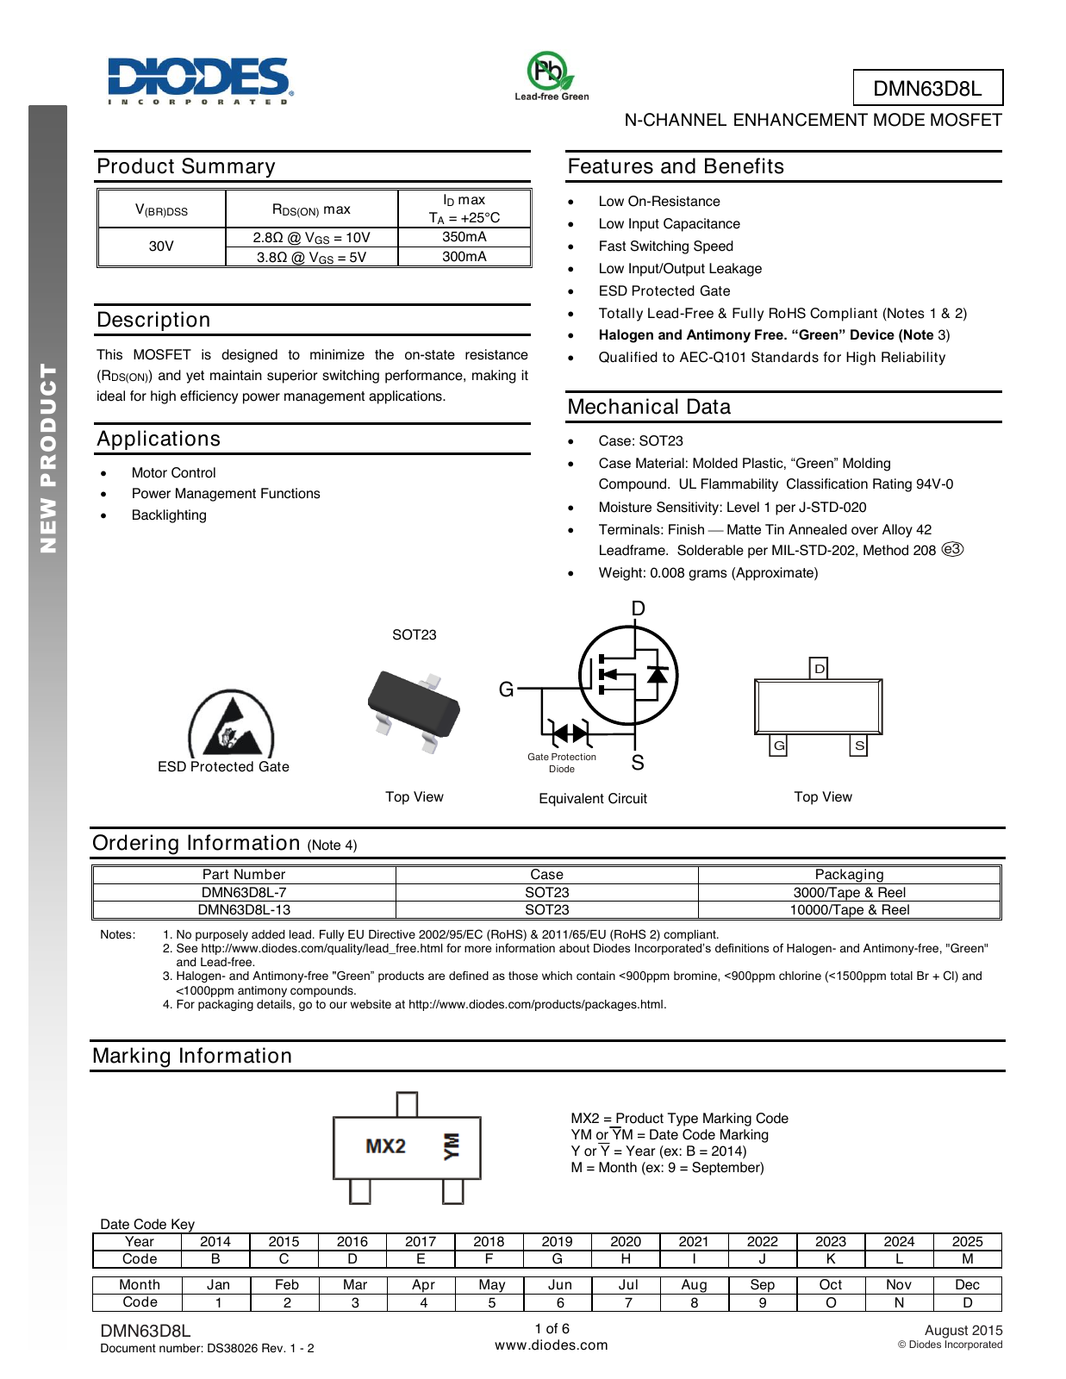
hardware/xe-minimal/evidence/DMN63D8L-page1.png
