nyanko3141592/pendant-recorder/hardware/xe-minimal/evidence/TLV7042-SLVSE13J-page9.png

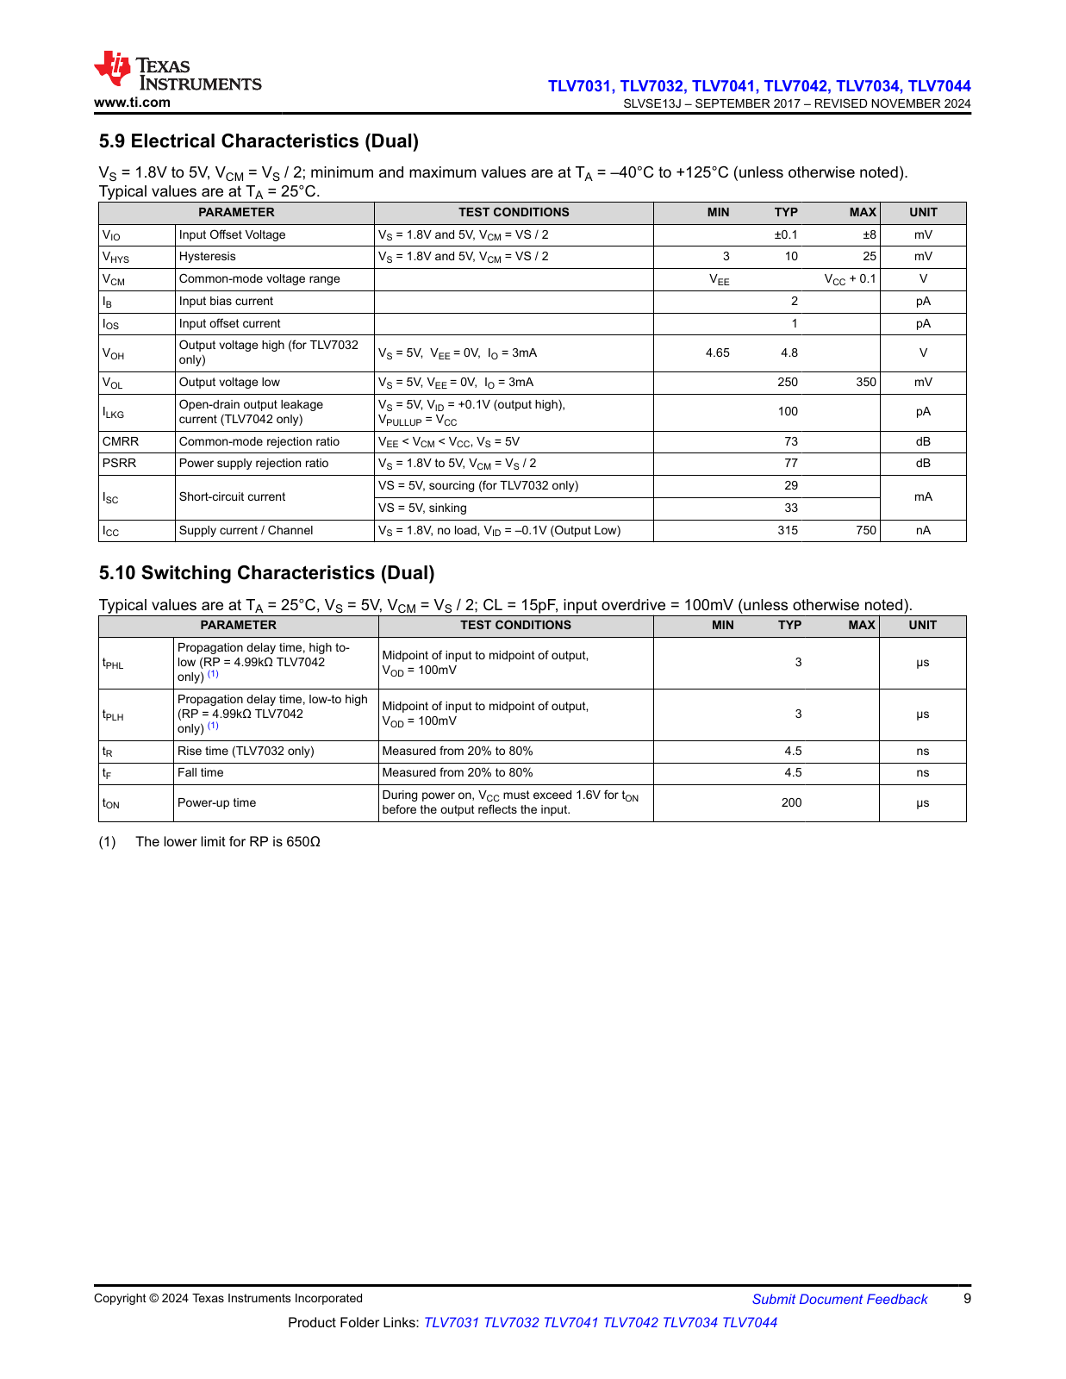
hardware/xe-minimal/evidence/TLV7042-SLVSE13J-page9.png
