nyanko3141592/pendant-recorder/hardware/xe-minimal/evidence/TPS22916-mask-page25.png

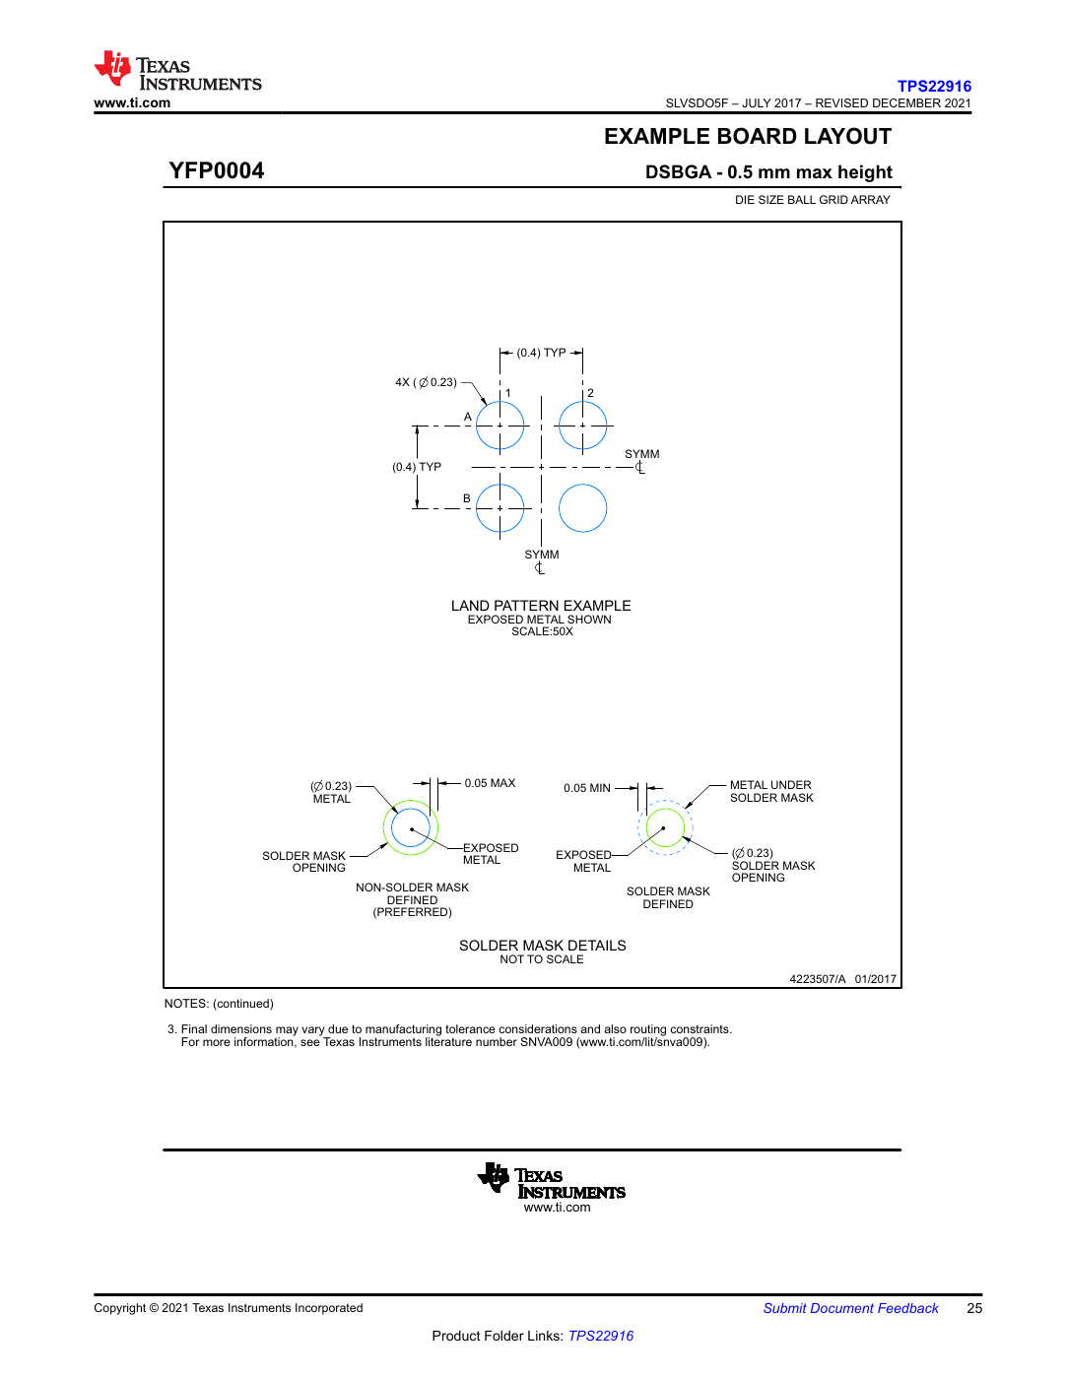
hardware/xe-minimal/evidence/TPS22916-mask-page25.png
