nyanko3141592/pendant-recorder/hardware/xe-minimal/evidence/TPS22916-stencil-page26.png

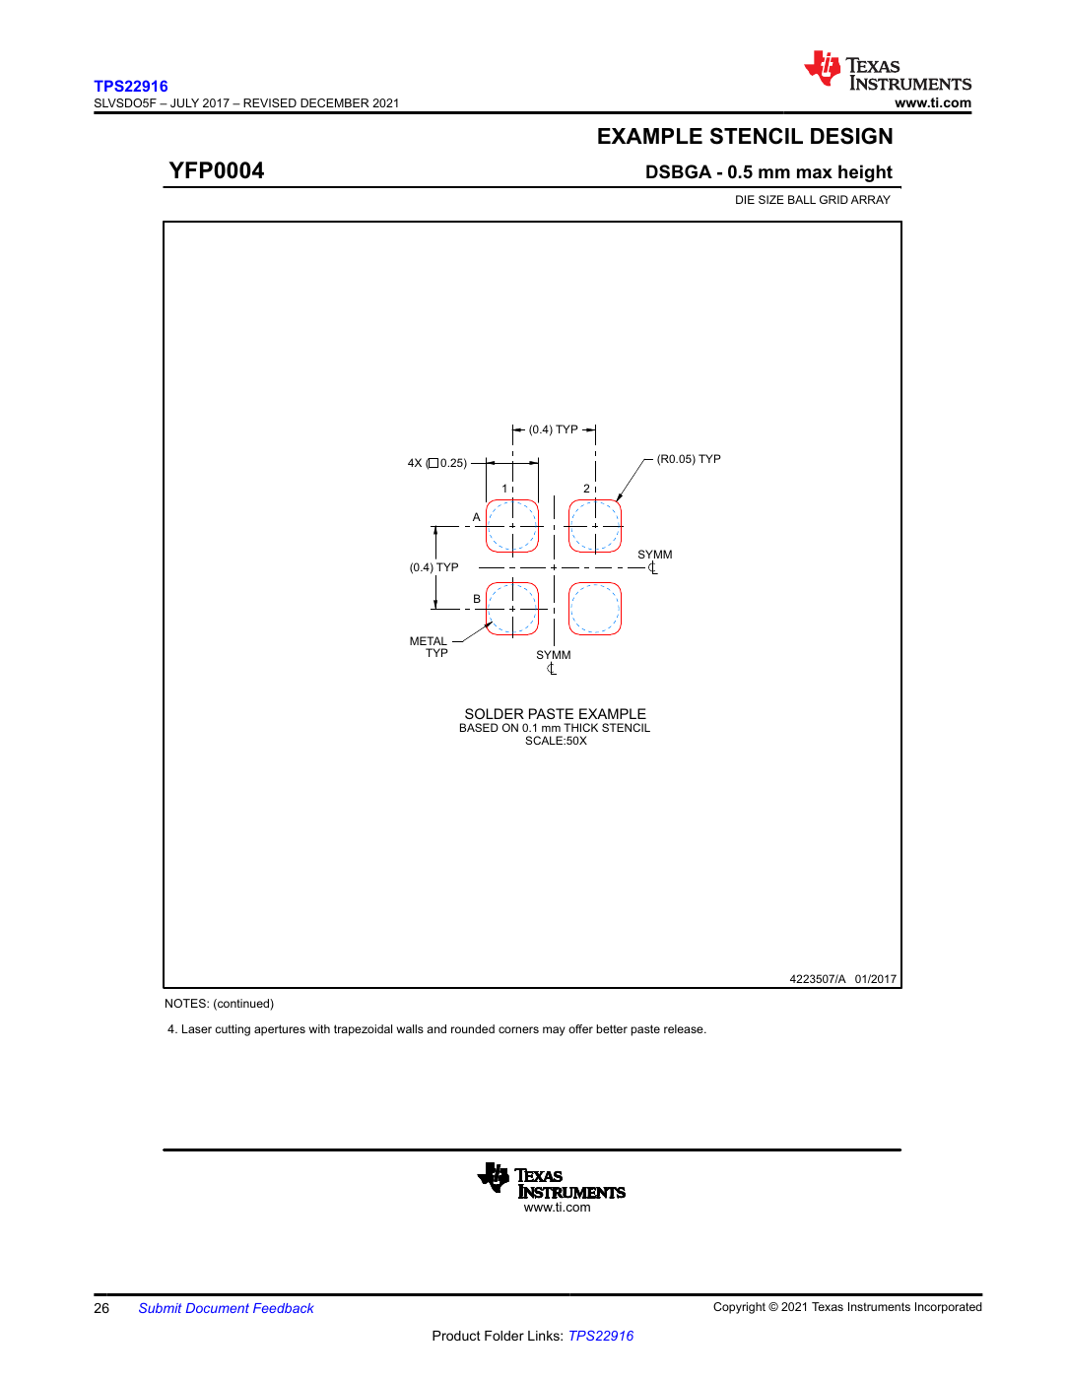
hardware/xe-minimal/evidence/TPS22916-stencil-page26.png
