nyanko3141592/pendant-recorder/hardware/xe-minimal/film-lap-pad-placement-study-1/guarded-power-reference-review.png

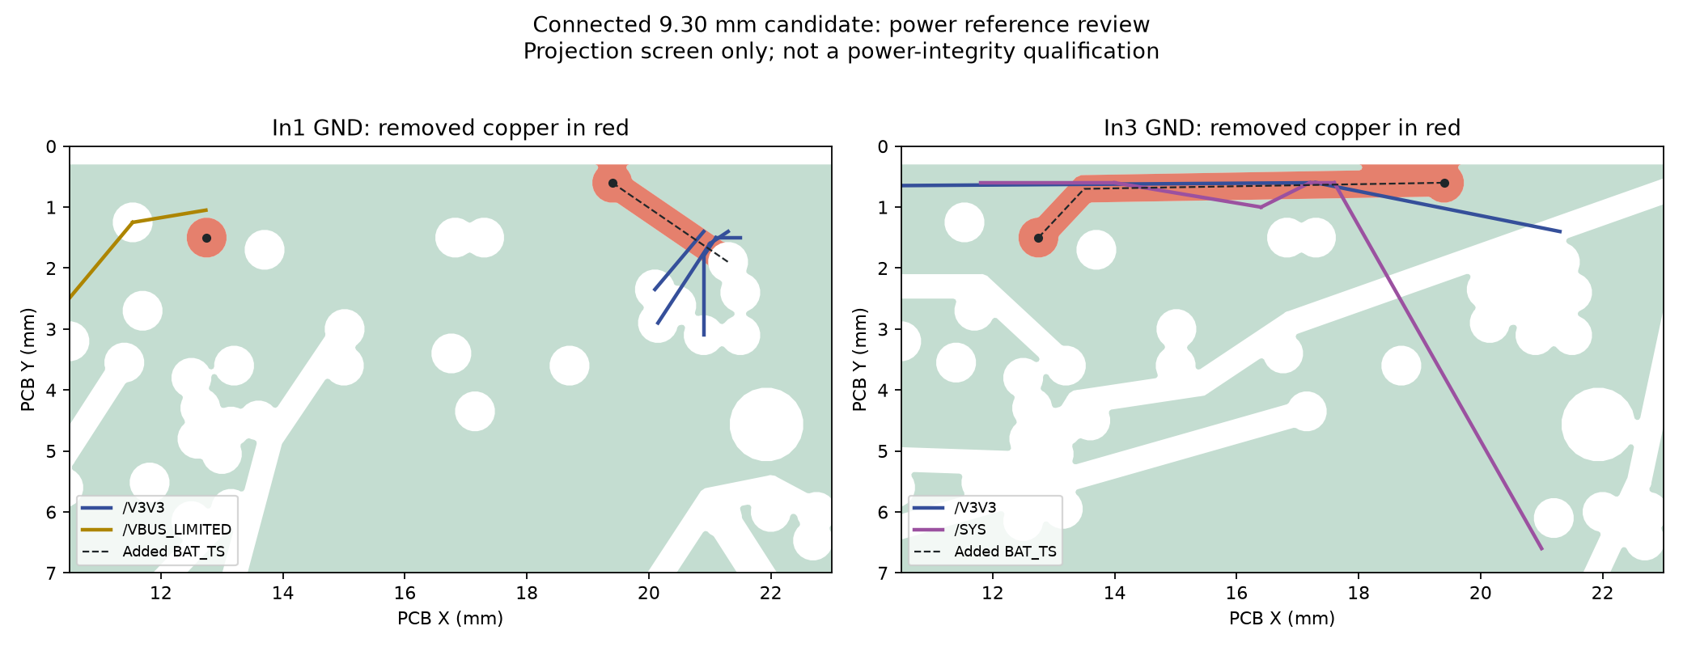
hardware/xe-minimal/film-lap-pad-placement-study-1/guarded-power-reference-review.png
