nyanko3141592/pendant-recorder/hardware/xe-minimal/film-lap-pad-placement-study-1/reference-plane-delta-review.png

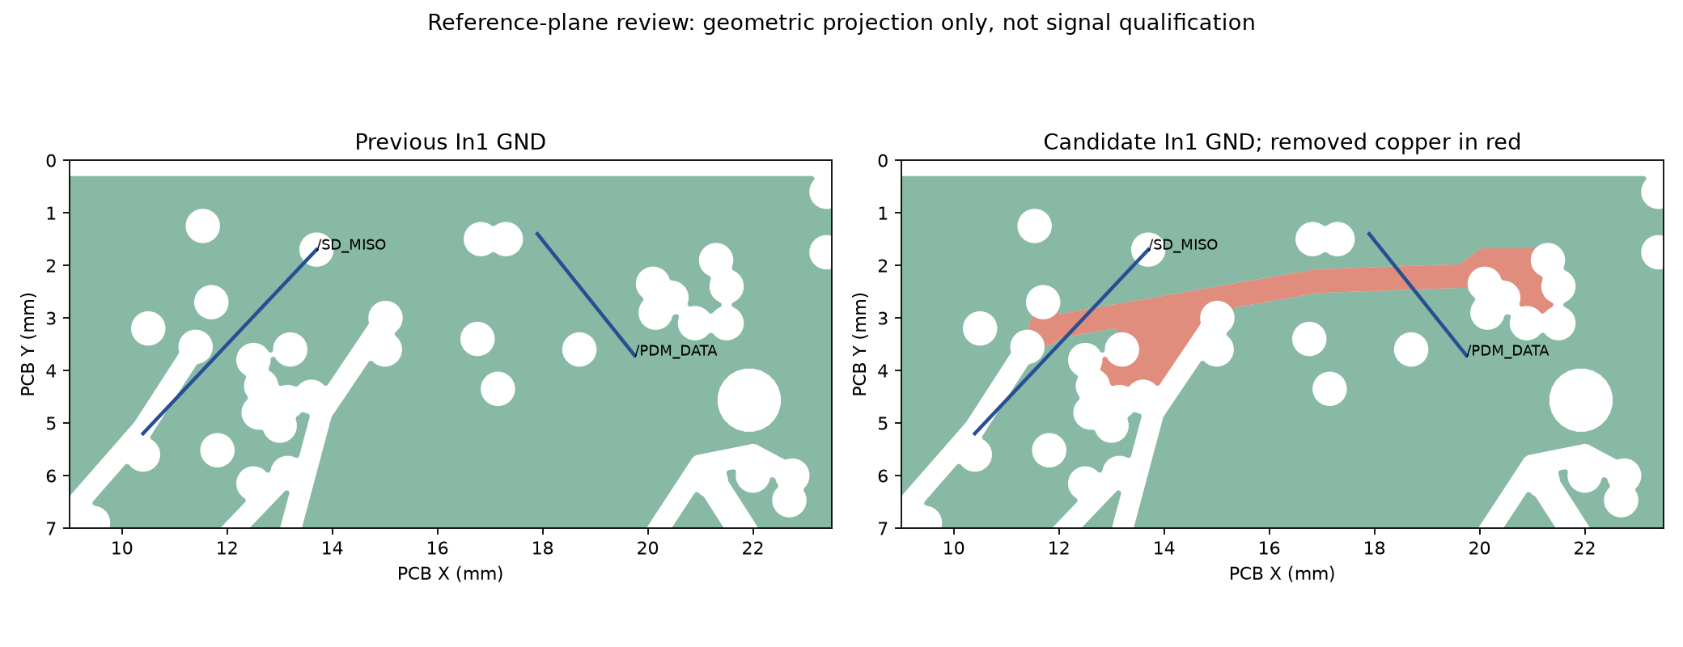
hardware/xe-minimal/film-lap-pad-placement-study-1/reference-plane-delta-review.png
