nyanko3141592/pendant-recorder/hardware/xe-minimal/fixed-usb-limit-trial/usb-reference-region.png

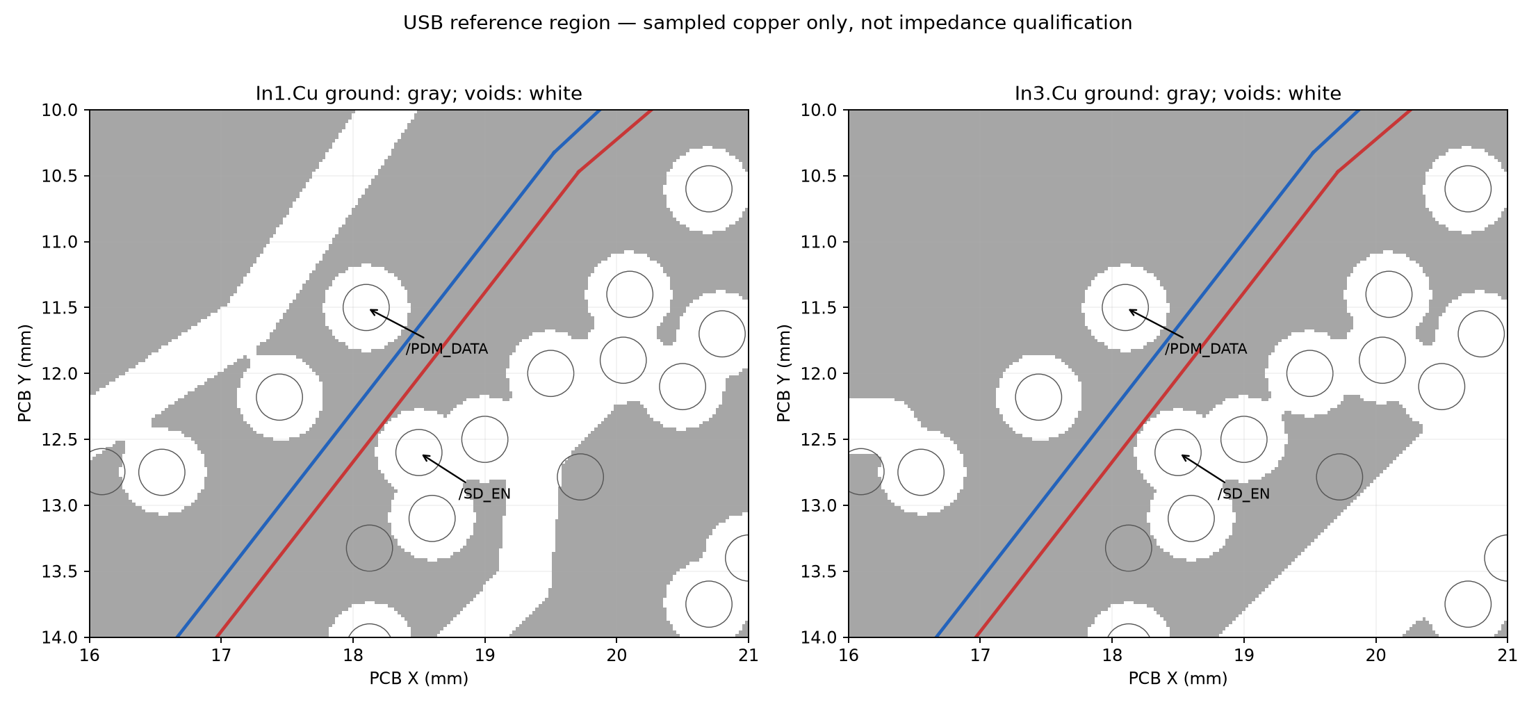
hardware/xe-minimal/fixed-usb-limit-trial/usb-reference-region.png
