nyanko3141592/pendant-recorder/hardware/xe-minimal/preorder-20261029/escape-miso.png

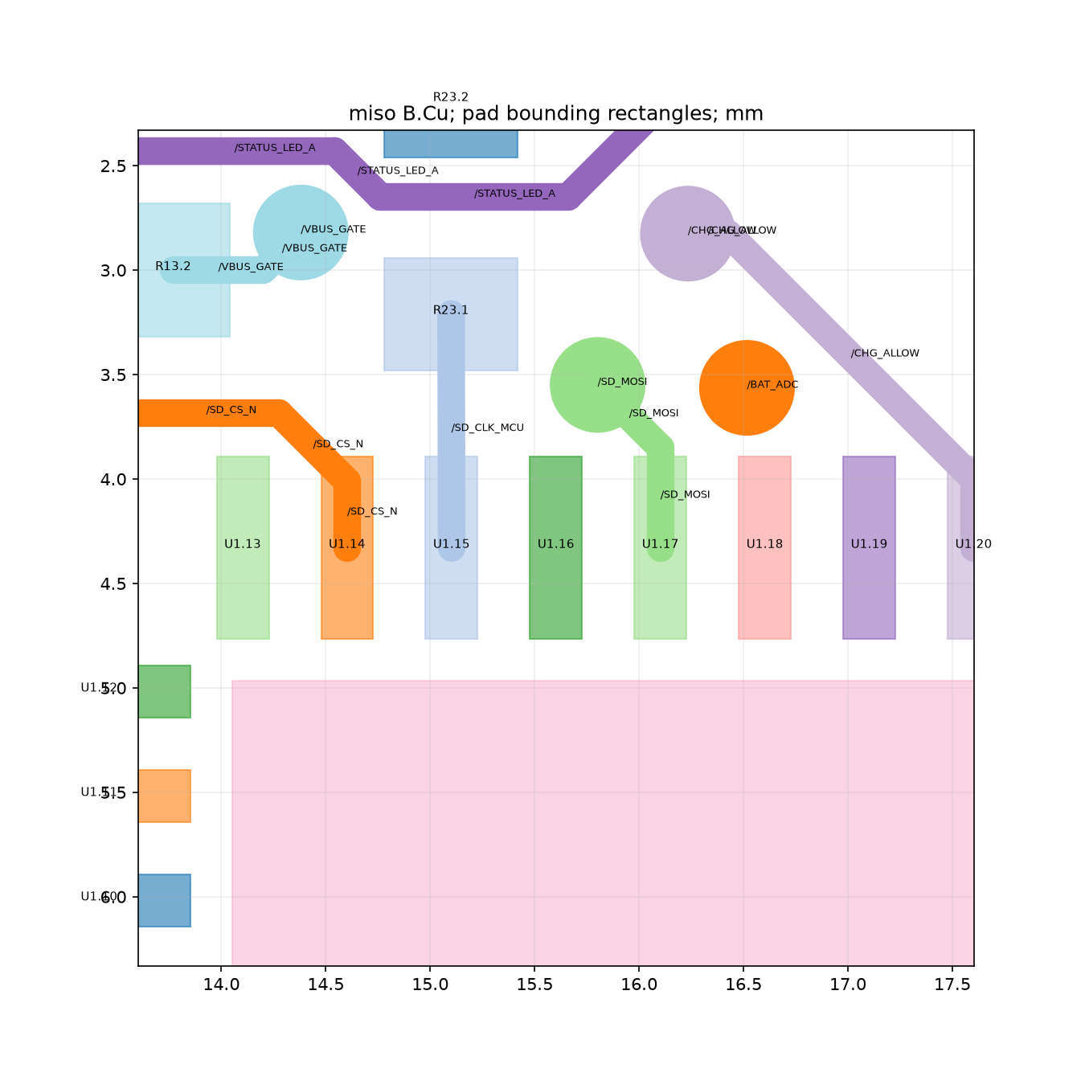
hardware/xe-minimal/preorder-20261029/escape-miso.png
