nyanko3141592/pendant-recorder/hardware/xe-minimal/preorder-20261029/release-review-20261029-aligned/fit-kit/j2-drawing-sheet2.png

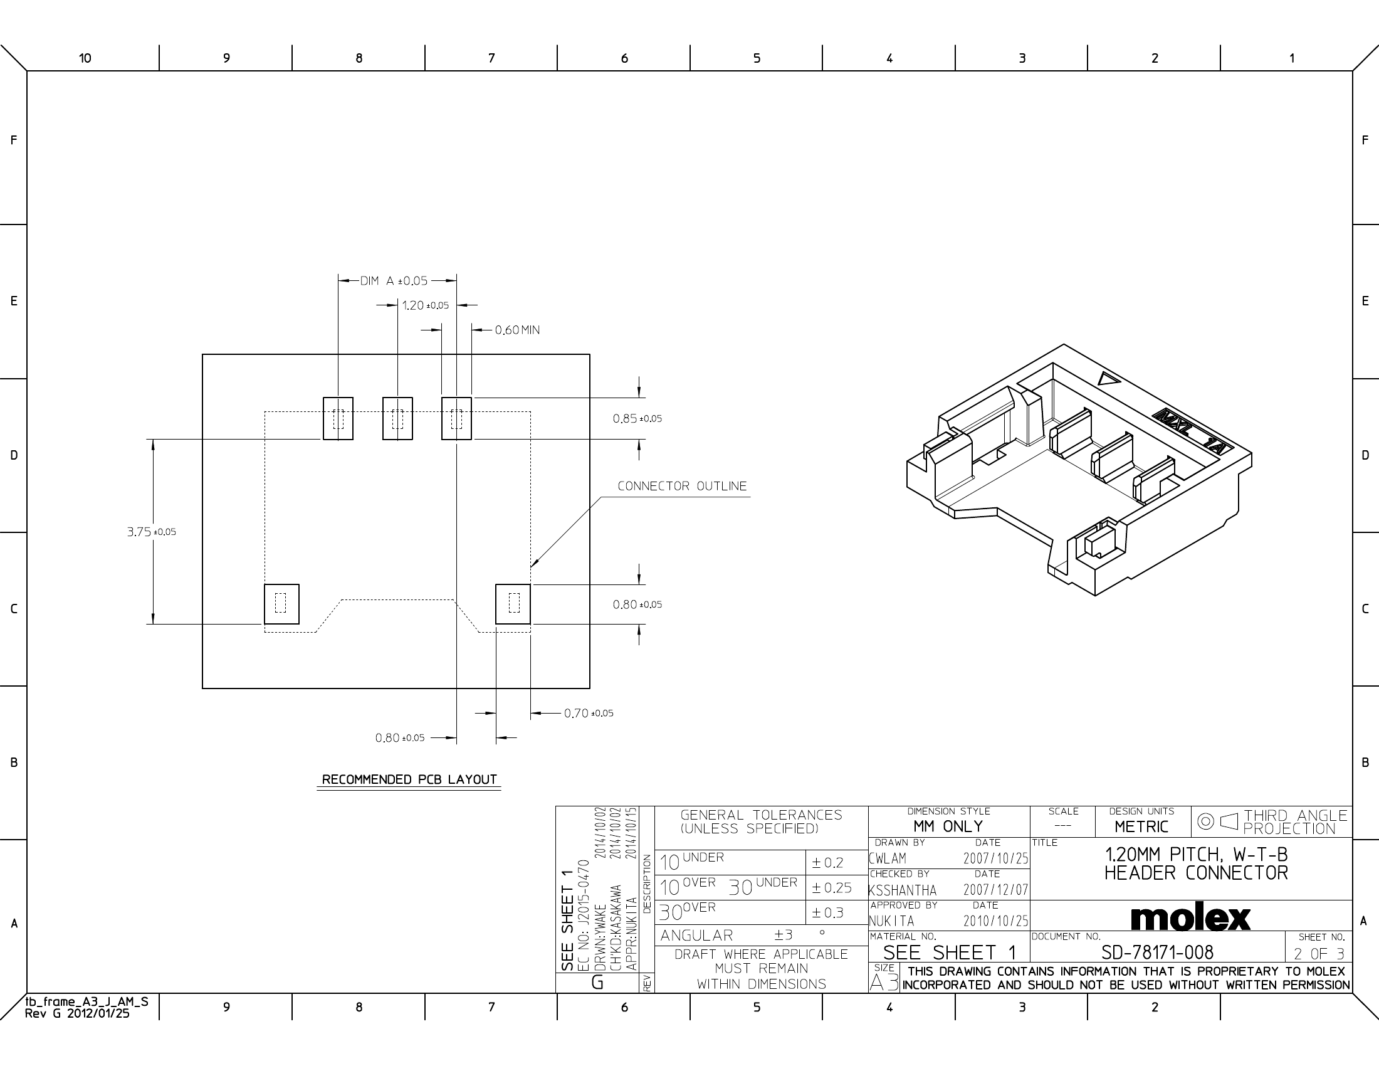
hardware/xe-minimal/preorder-20261029/release-review-20261029-aligned/fit-kit/j2-drawing-sheet2.png
