nyanko3141592/pendant-recorder/hardware/xe-minimal/preorder-20261029/usb-island-map.png

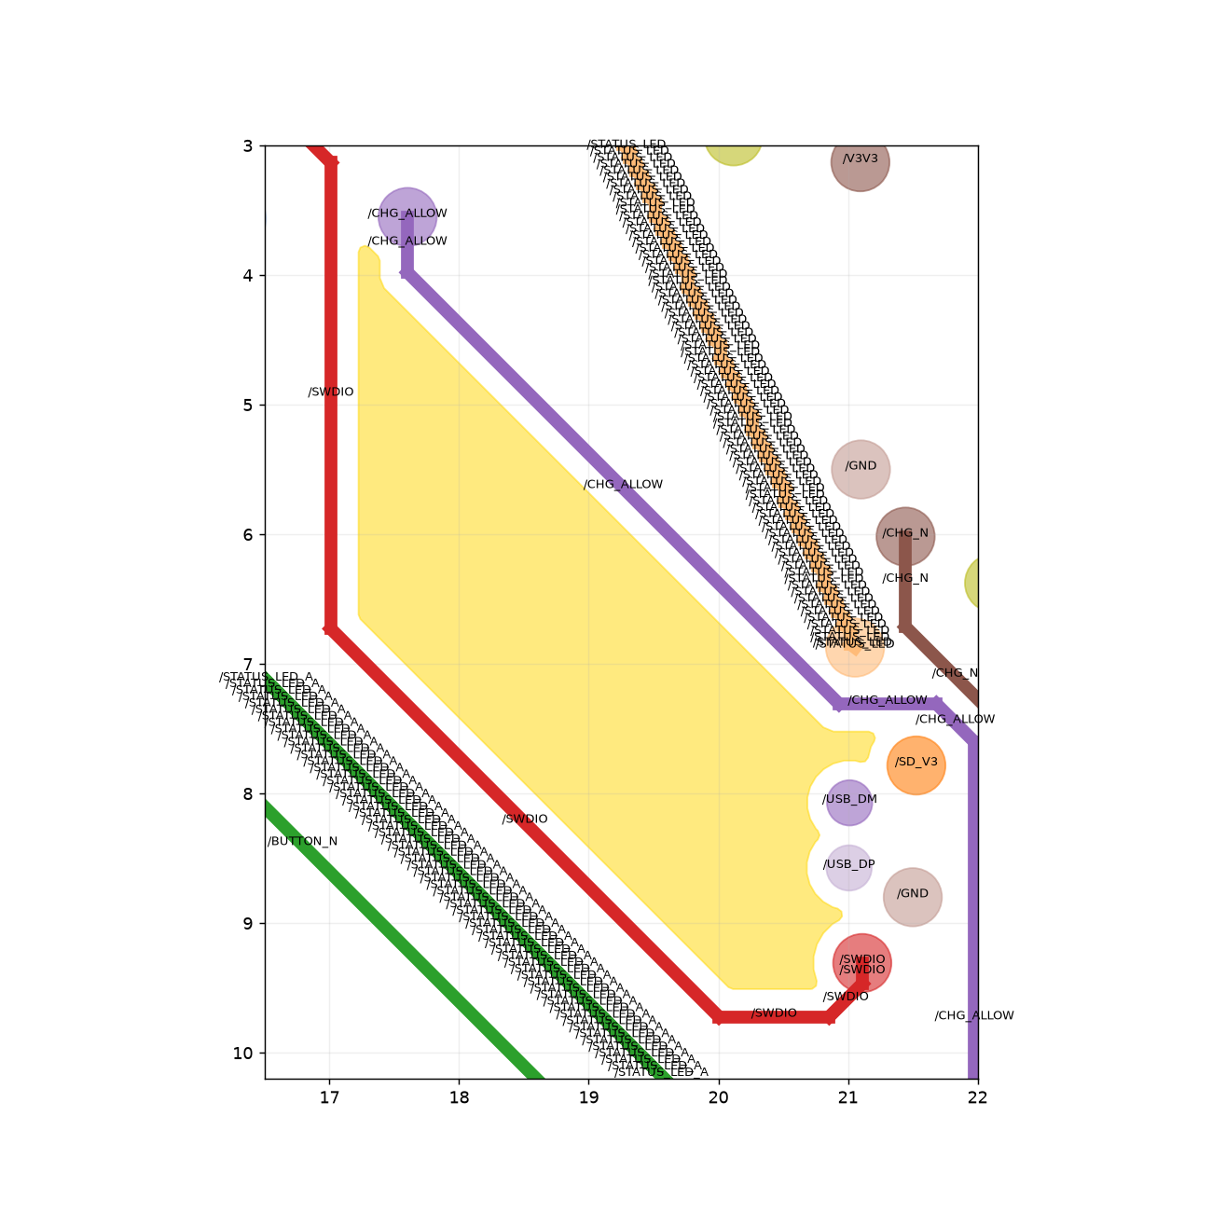
hardware/xe-minimal/preorder-20261029/usb-island-map.png
