nyanko3141592/pendant-recorder/hardware/xe-minimal/single-unit-carrier-study.png

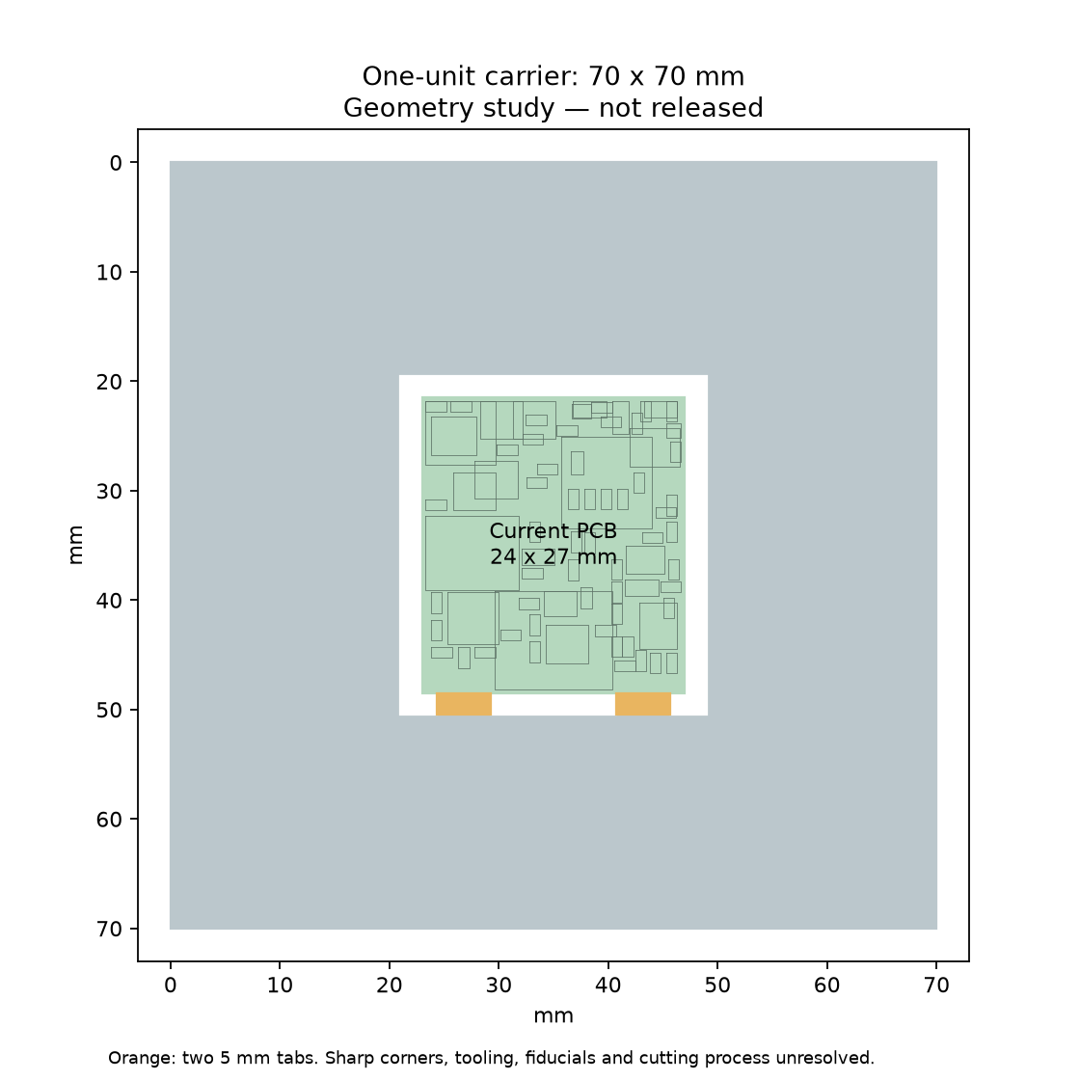
hardware/xe-minimal/single-unit-carrier-study.png
