nyanko3141592/pendant-recorder/hardware/xe-minimal/supported-panel-topology-study.png

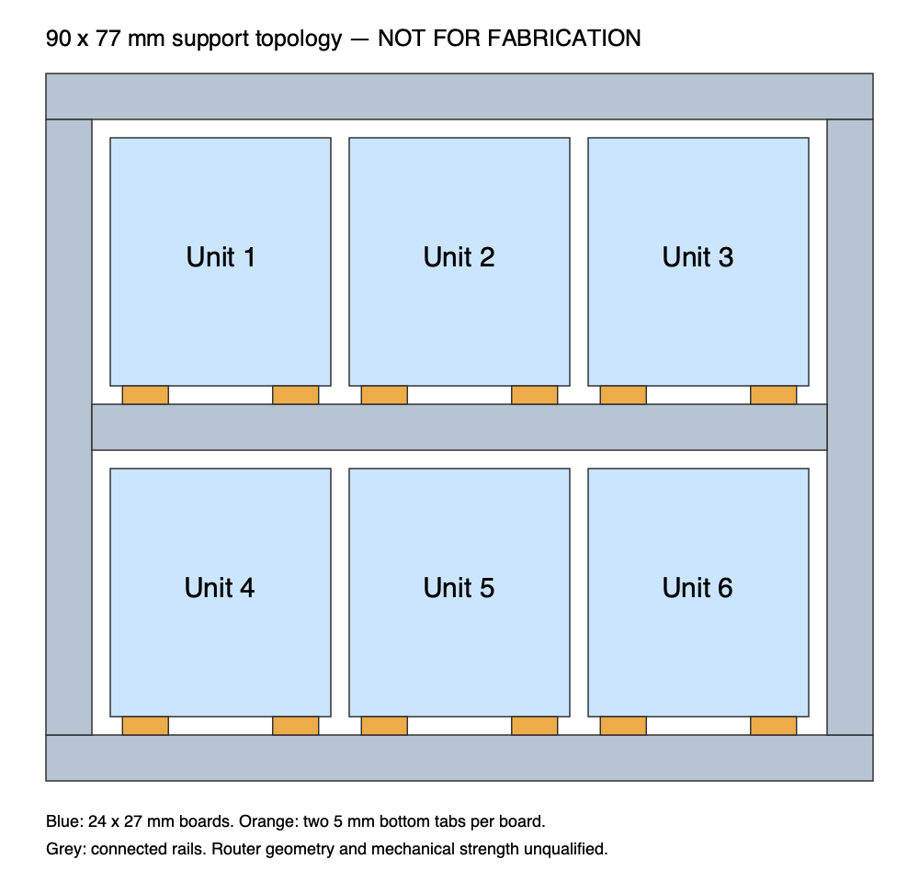
hardware/xe-minimal/supported-panel-topology-study.png
