nyanko3141592/pendant-recorder/hardware/xe-minimal/u10-sot23-candidate/adopted-bottom.png

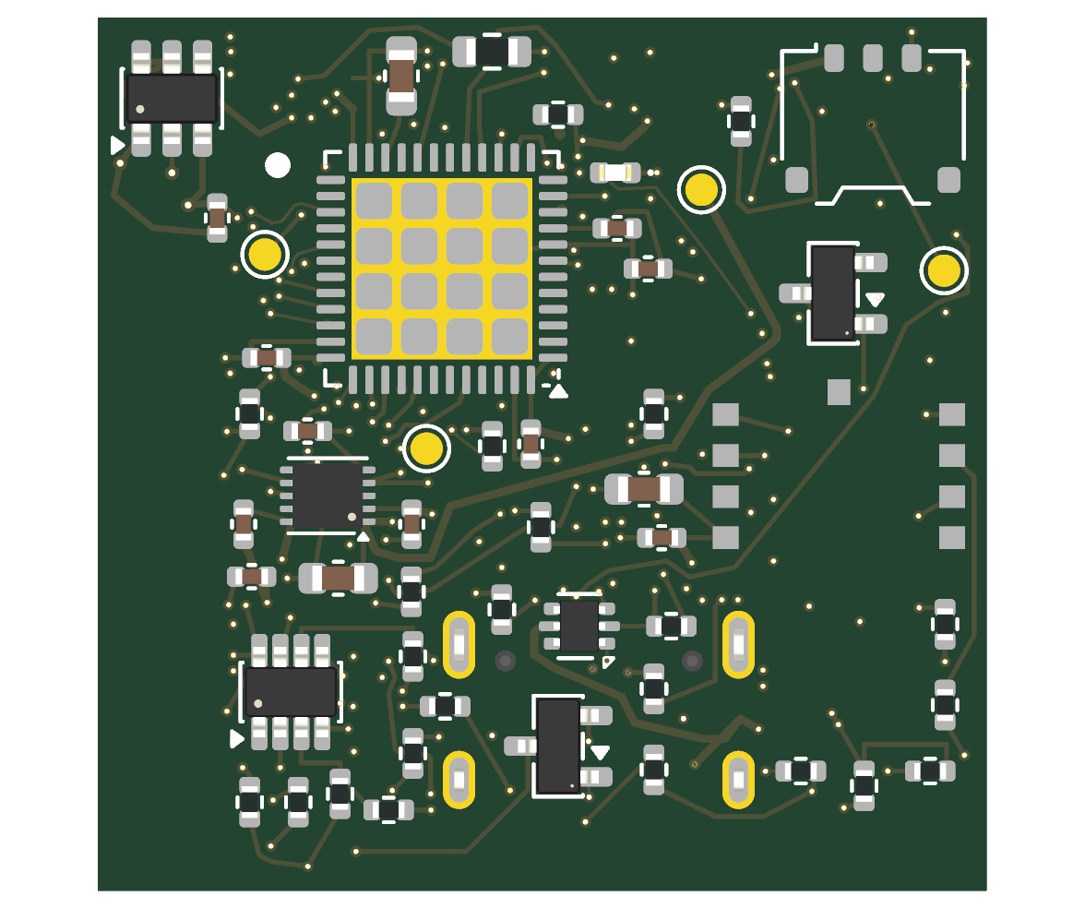
hardware/xe-minimal/u10-sot23-candidate/adopted-bottom.png
