nyanko3141592/pendant-recorder/hardware/xe-minimal/u10-sot23-candidate/layout.png

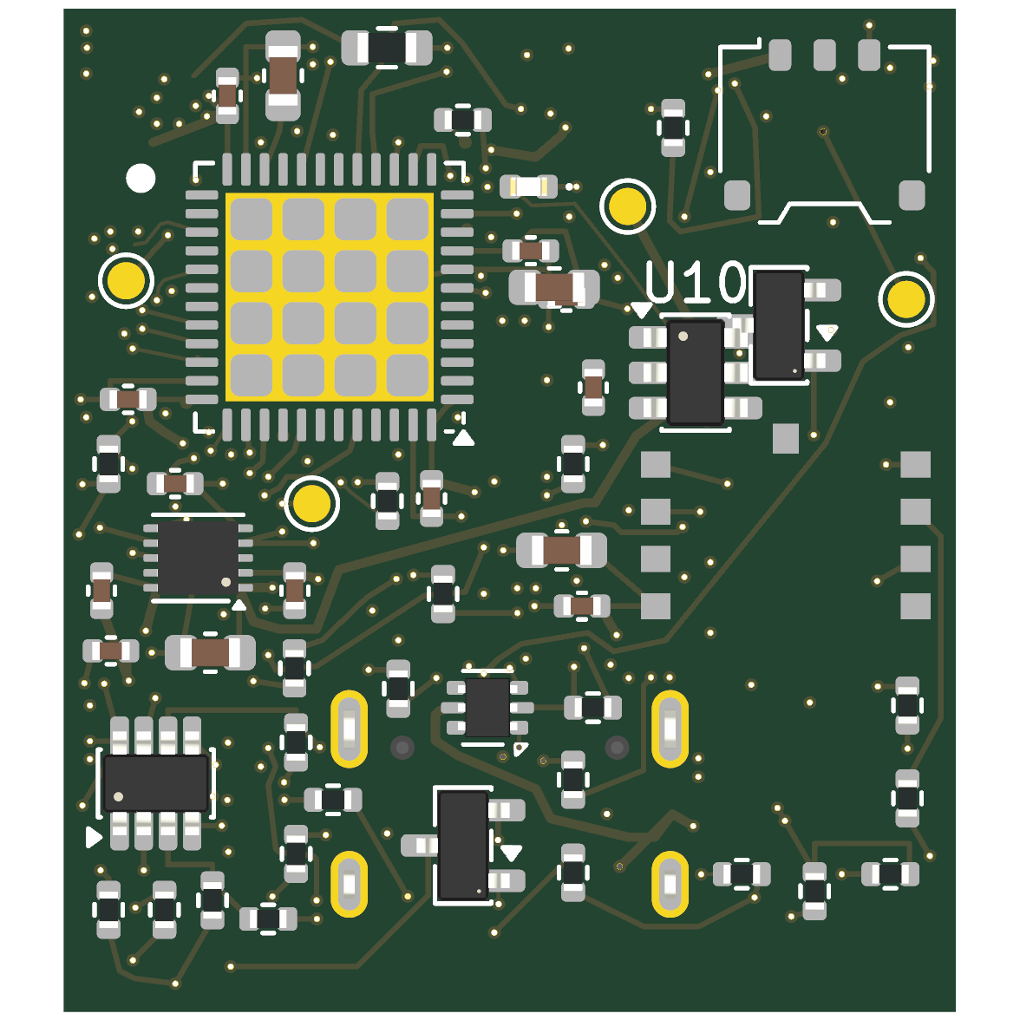
hardware/xe-minimal/u10-sot23-candidate/layout.png
