nyanko3141592/pendant-recorder/mechanical/compact-100-v5/exploded.png

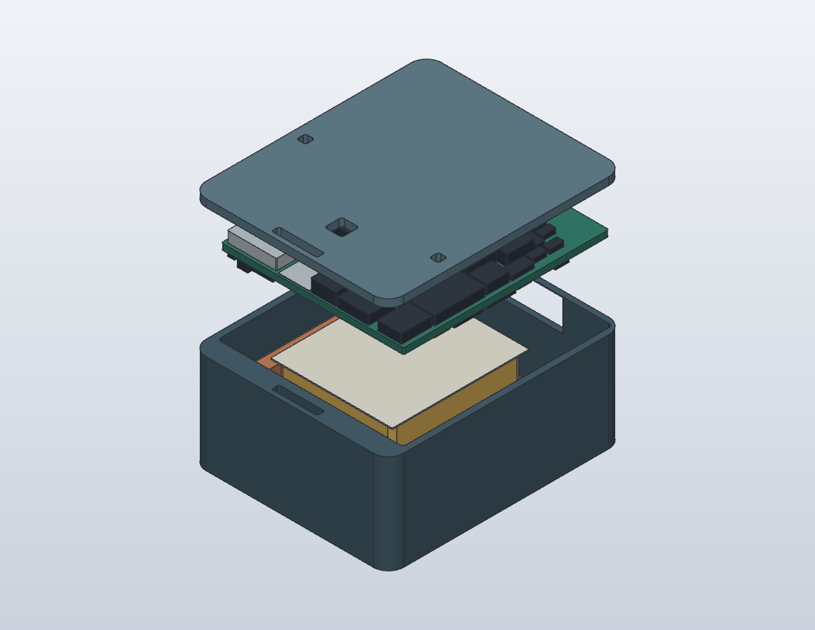
mechanical/compact-100-v5/exploded.png
