nyanko3141592/pendant-recorder/mechanical/compact-ab/fit-check/A/exploded.png

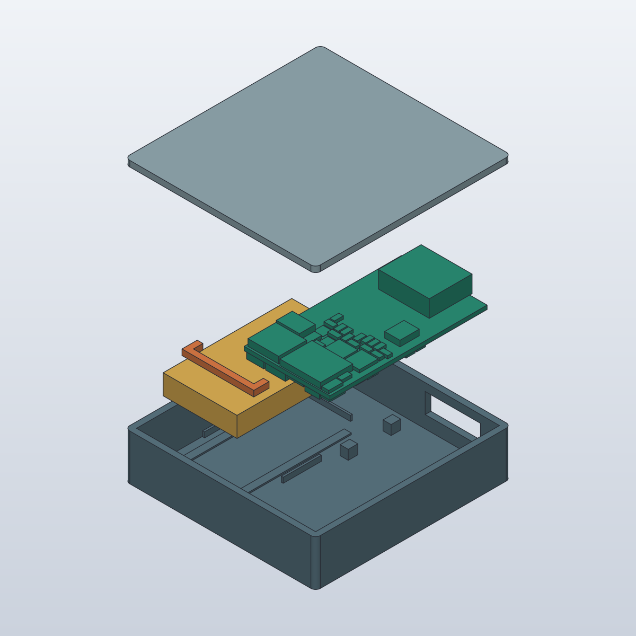
mechanical/compact-ab/fit-check/A/exploded.png
