nyanko3141592/pendant-recorder/mechanical/compact-ab/fit-check/B/exploded.png

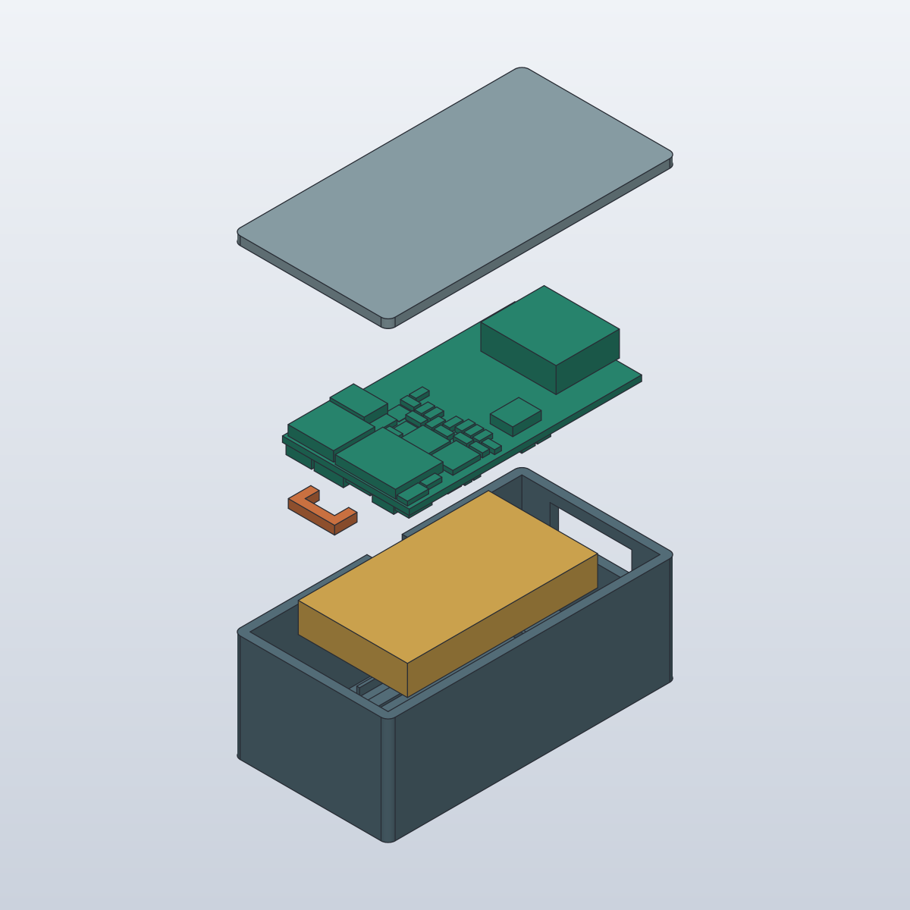
mechanical/compact-ab/fit-check/B/exploded.png
