nyanko3141592/pendant-recorder/mechanical/concepts/wearable-style/three-concepts.png

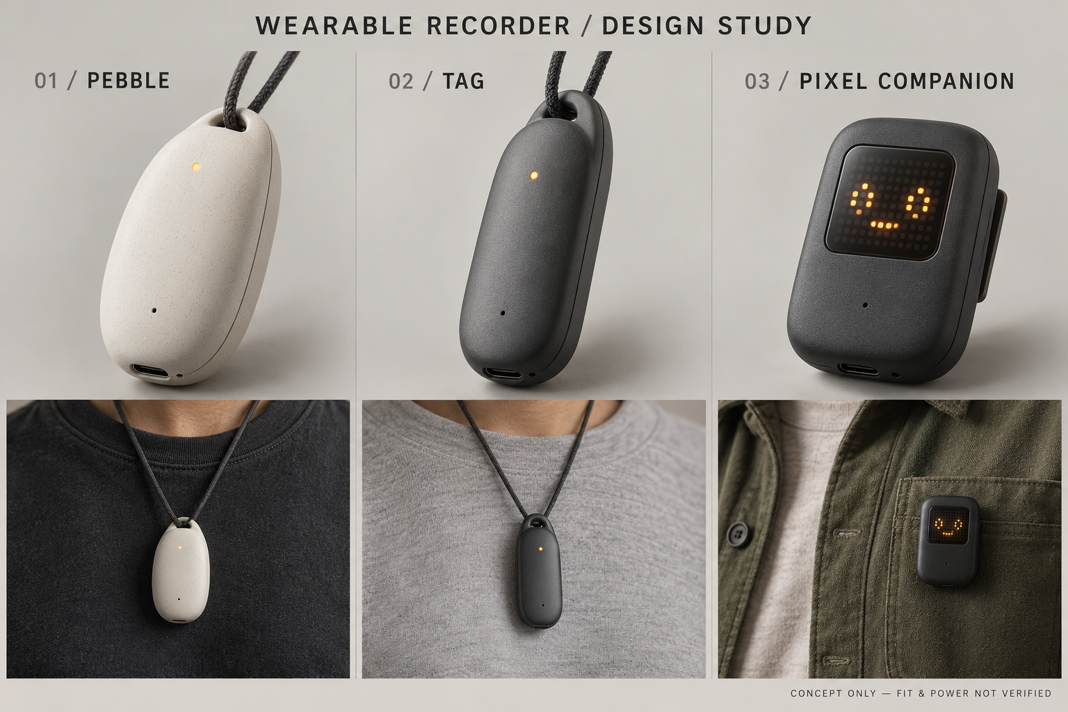
mechanical/concepts/wearable-style/three-concepts.png
