nyanko3141592/pendant-recorder/mechanical/fit-study.png

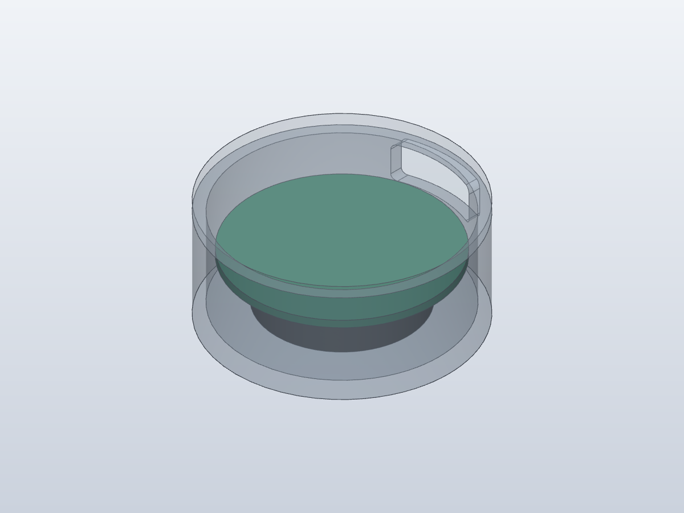
mechanical/fit-study.png
