nyanko3141592/pendant-recorder/mechanical/mini-rect-v15/evidence/Molex-SD-78171-008-RevG-sheet1.png

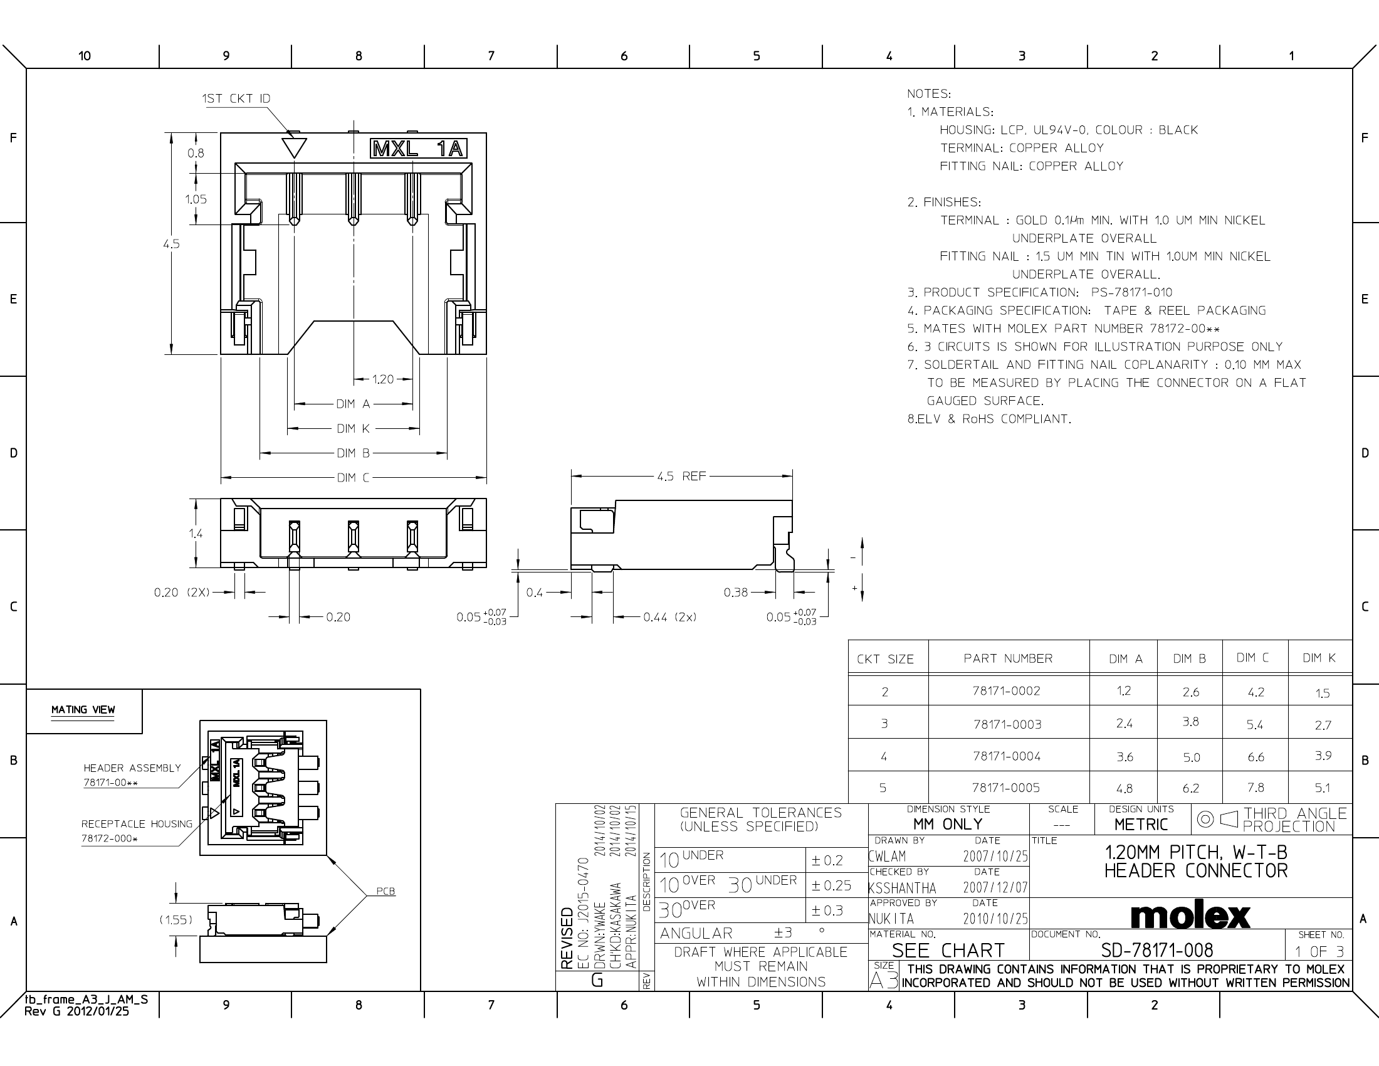
mechanical/mini-rect-v15/evidence/Molex-SD-78171-008-RevG-sheet1.png
