nyanko3141592/pendant-recorder/mechanical/mini-rect-v15/evidence/XE-pack-drawing-page9.png

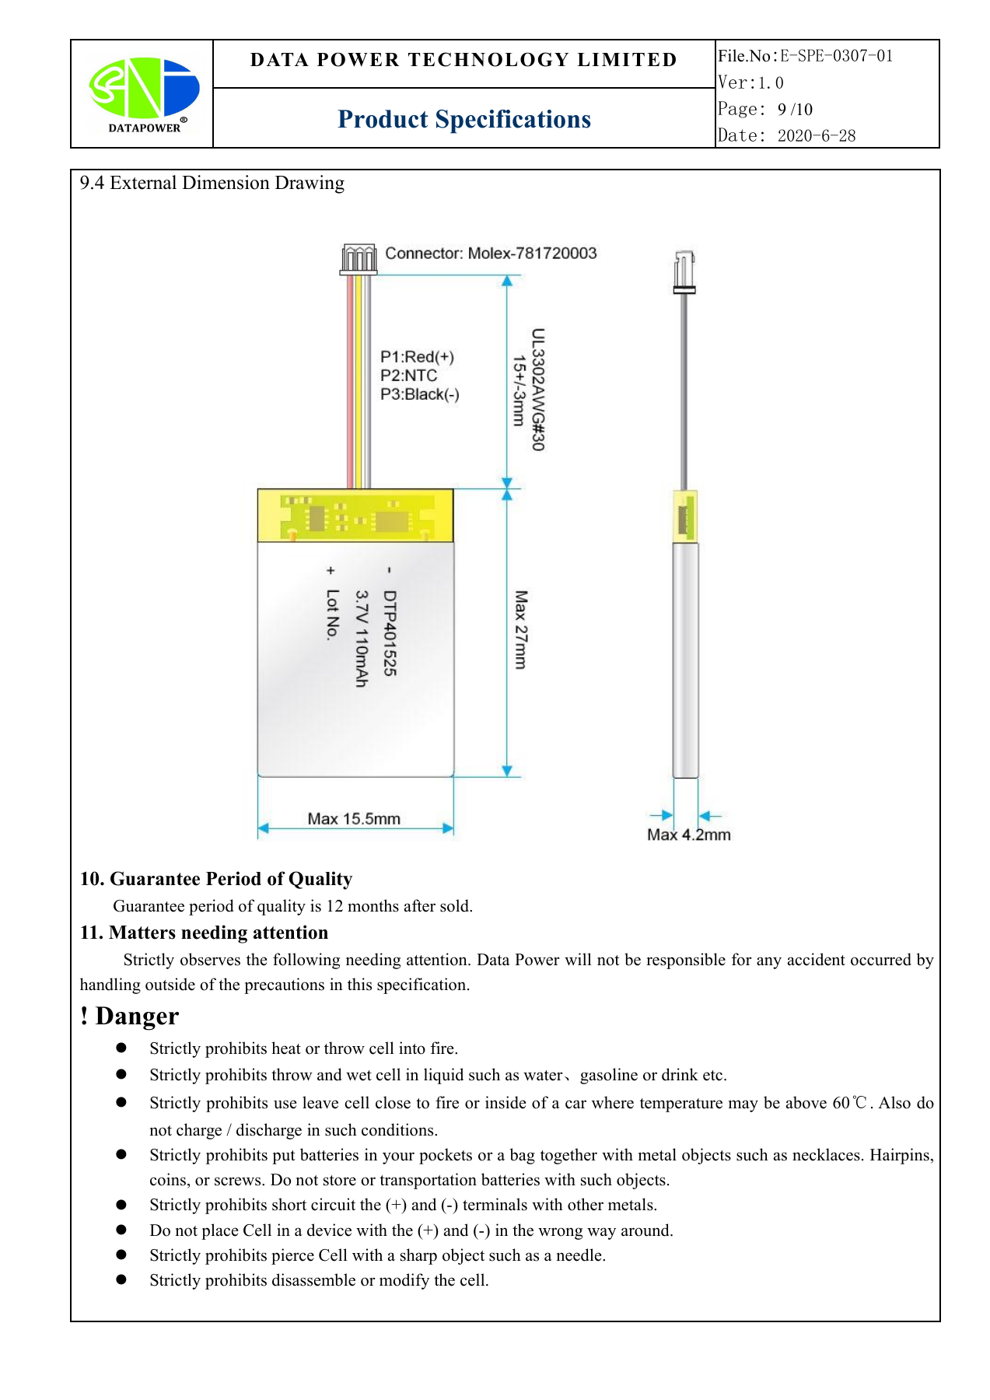
mechanical/mini-rect-v15/evidence/XE-pack-drawing-page9.png
