nyanko3141592/pendant-recorder/mechanical/rounded-v6/comparison.png

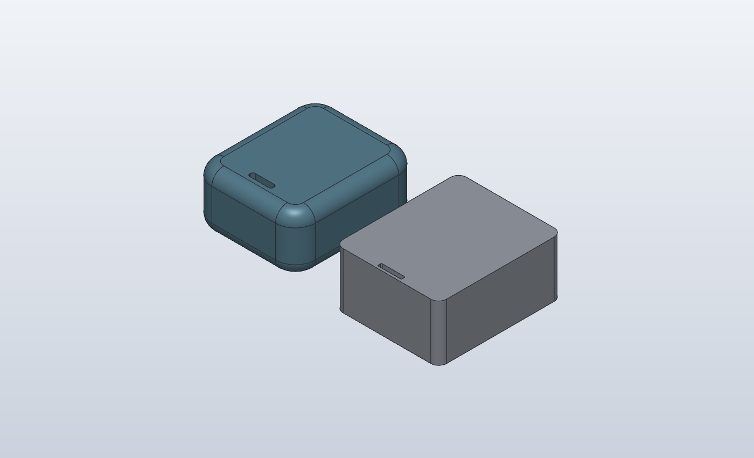
mechanical/rounded-v6/comparison.png
