nyanko3141592/pendant-recorder/mechanical/rounded-v6/rounded.png

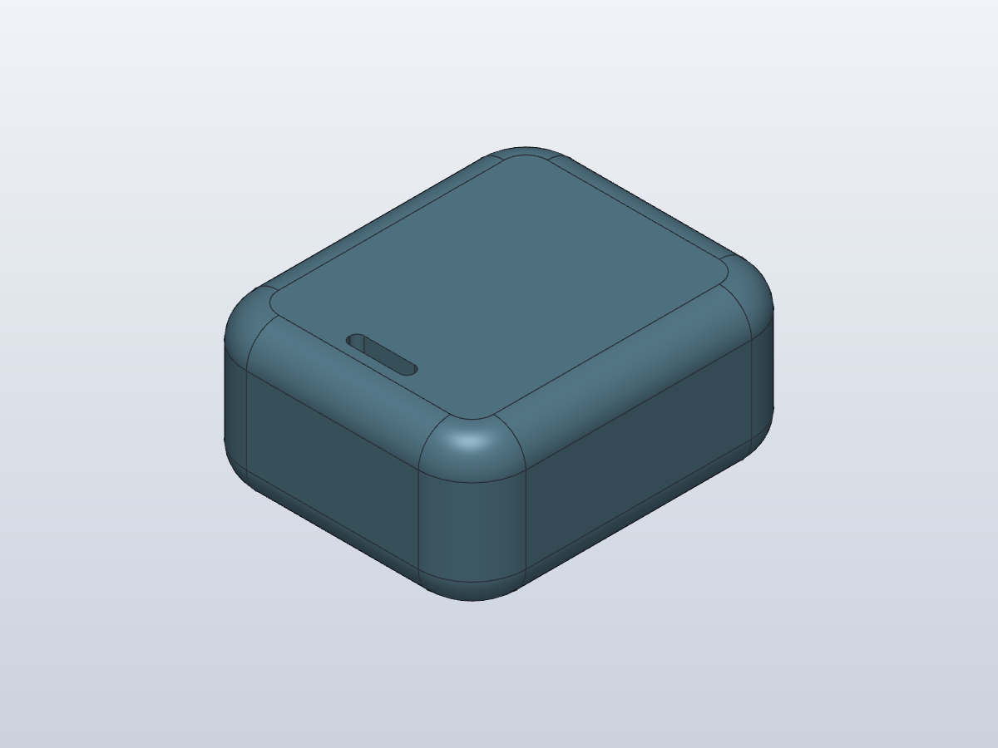
mechanical/rounded-v6/rounded.png
