nyanko3141592/pendant-recorder/mechanical/size-comparison-c0/top.png

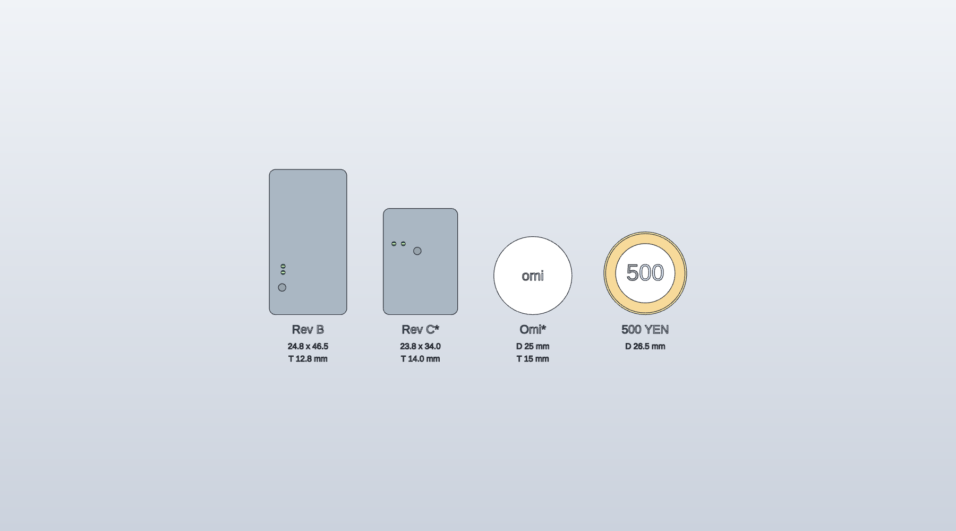
mechanical/size-comparison-c0/top.png
