nyanko3141592/pendant-recorder/mechanical/structure-b0/interior.png

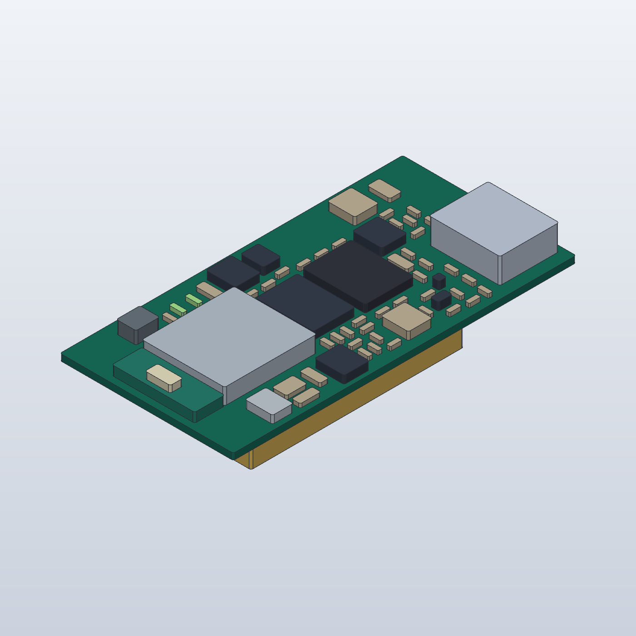
mechanical/structure-b0/interior.png
