nyanko3141592/pendant-recorder/mechanical/structure-d1/comparison-scale.png

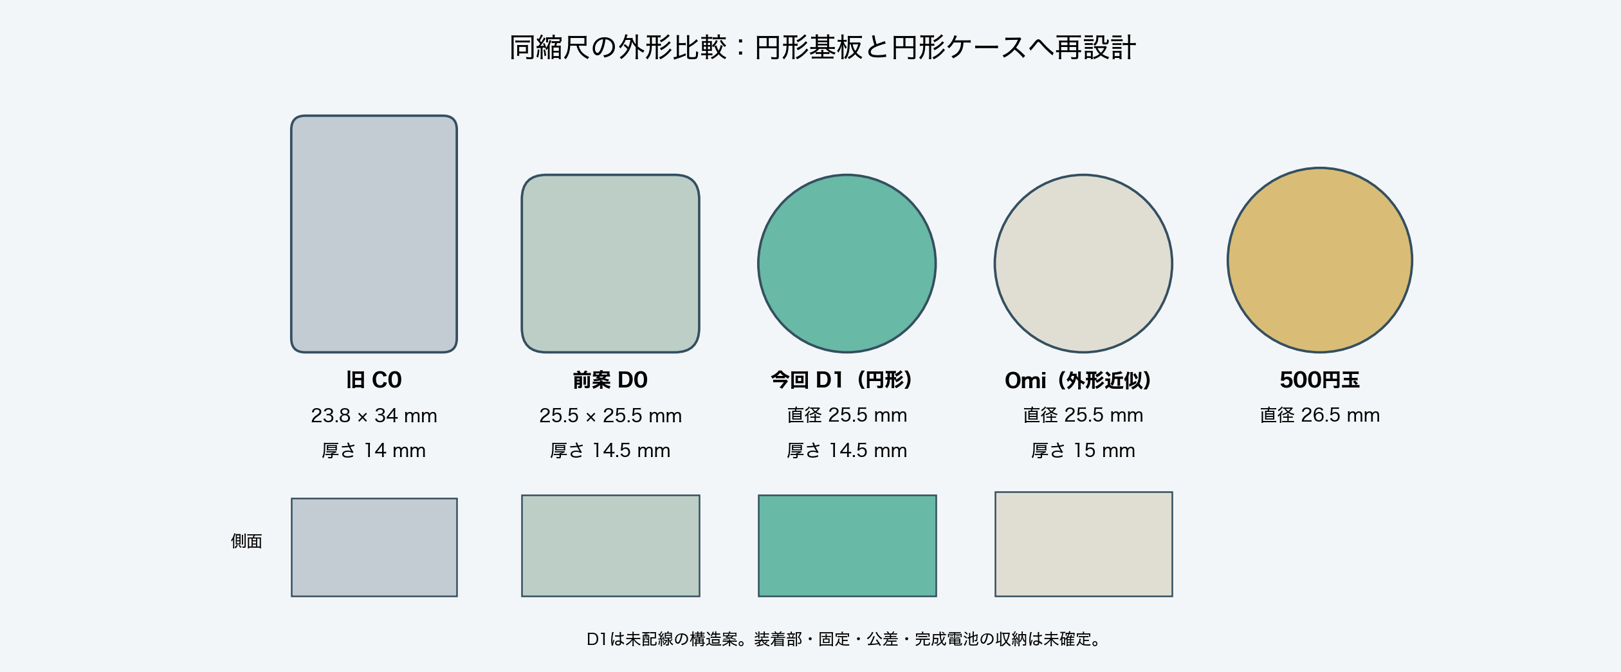
mechanical/structure-d1/comparison-scale.png
