nyanko3141592/pendant-recorder/mechanical/structure-d1/comparison.png

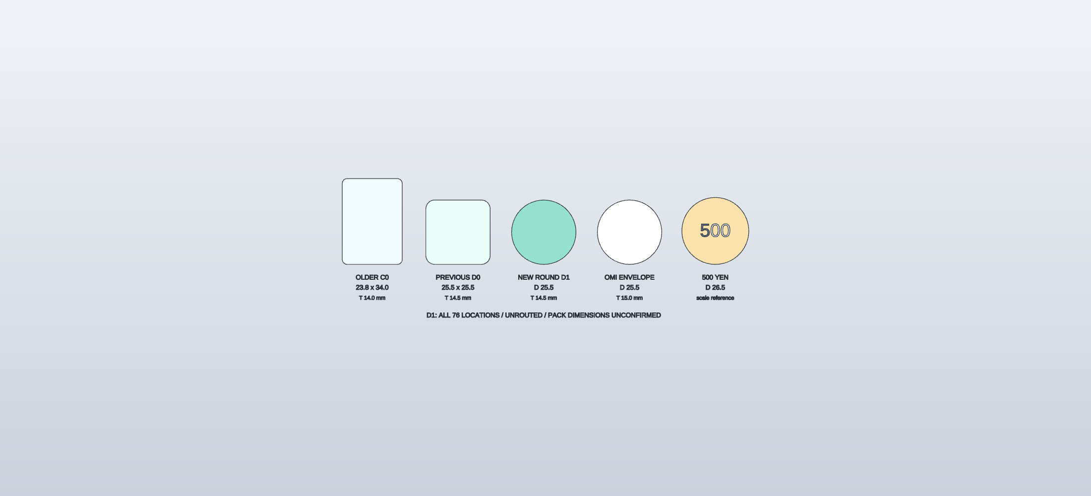
mechanical/structure-d1/comparison.png
