nyanko3141592/pendant-recorder/mechanical/structure-d1/cutaway.png

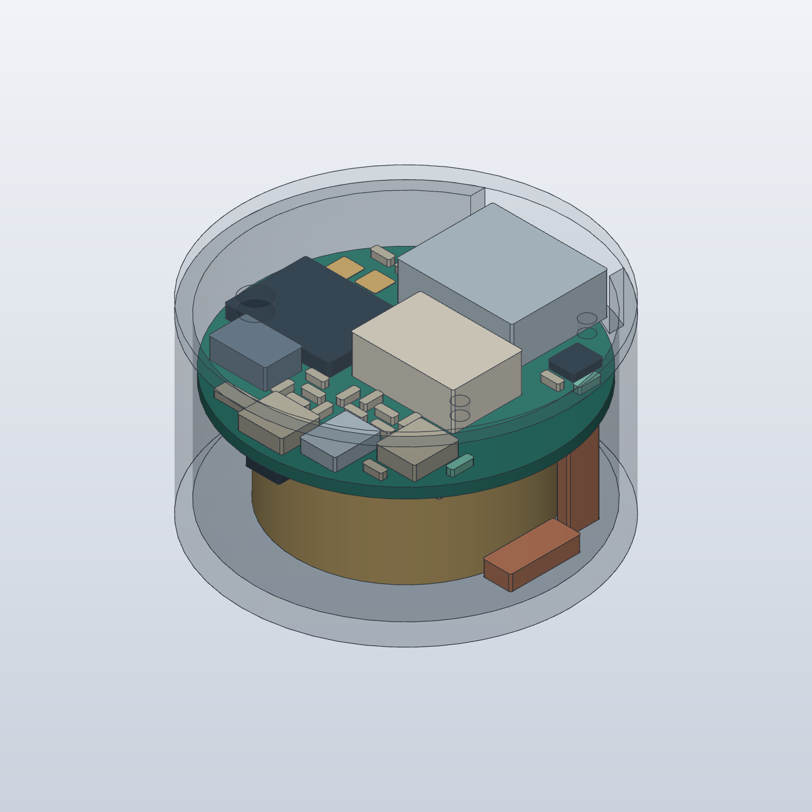
mechanical/structure-d1/cutaway.png
