nyanko3141592/pendant-recorder/mechanical/structure-d1/exploded.png

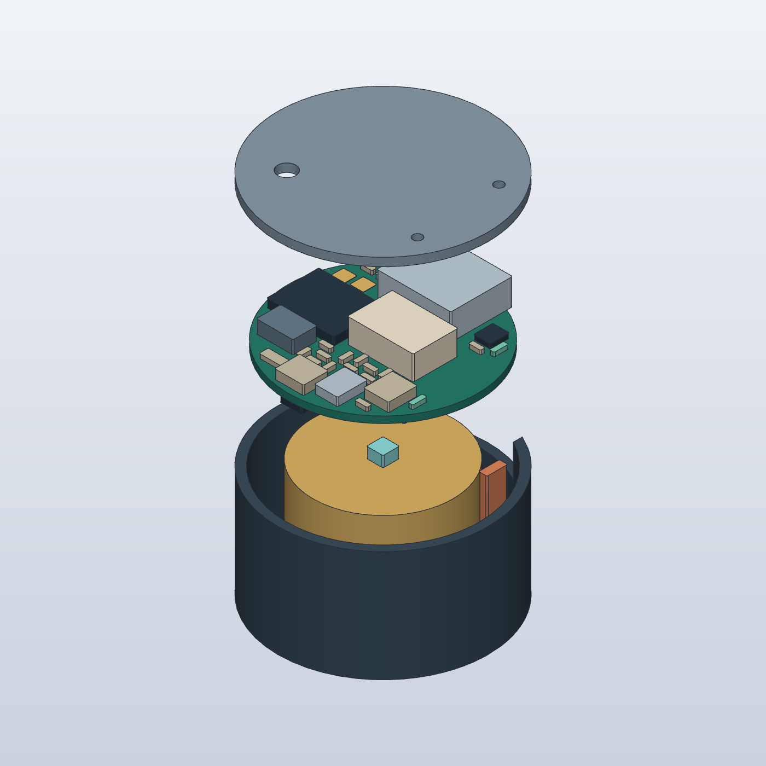
mechanical/structure-d1/exploded.png
