nyanko3141592/pendant-recorder/mechanical/structure-d1/exterior.png

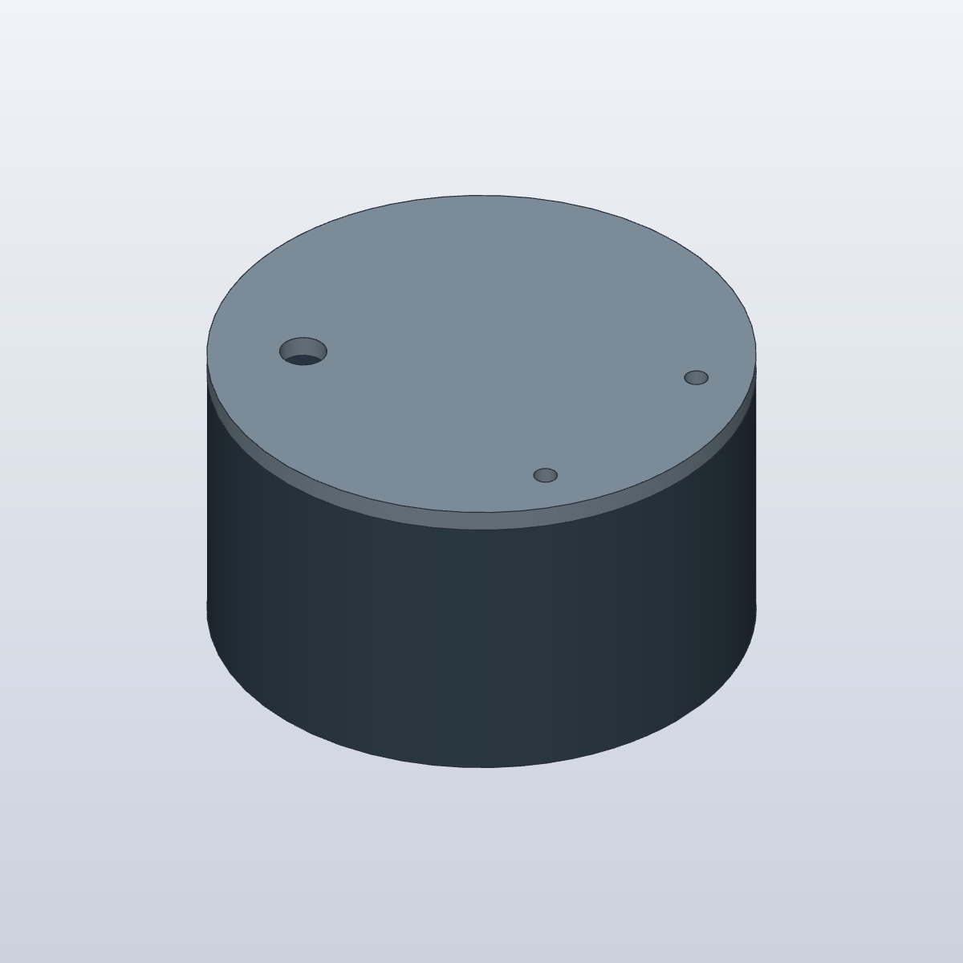
mechanical/structure-d1/exterior.png
