nyanko3141592/pendant-recorder/mechanical/structure-d1/placement.png

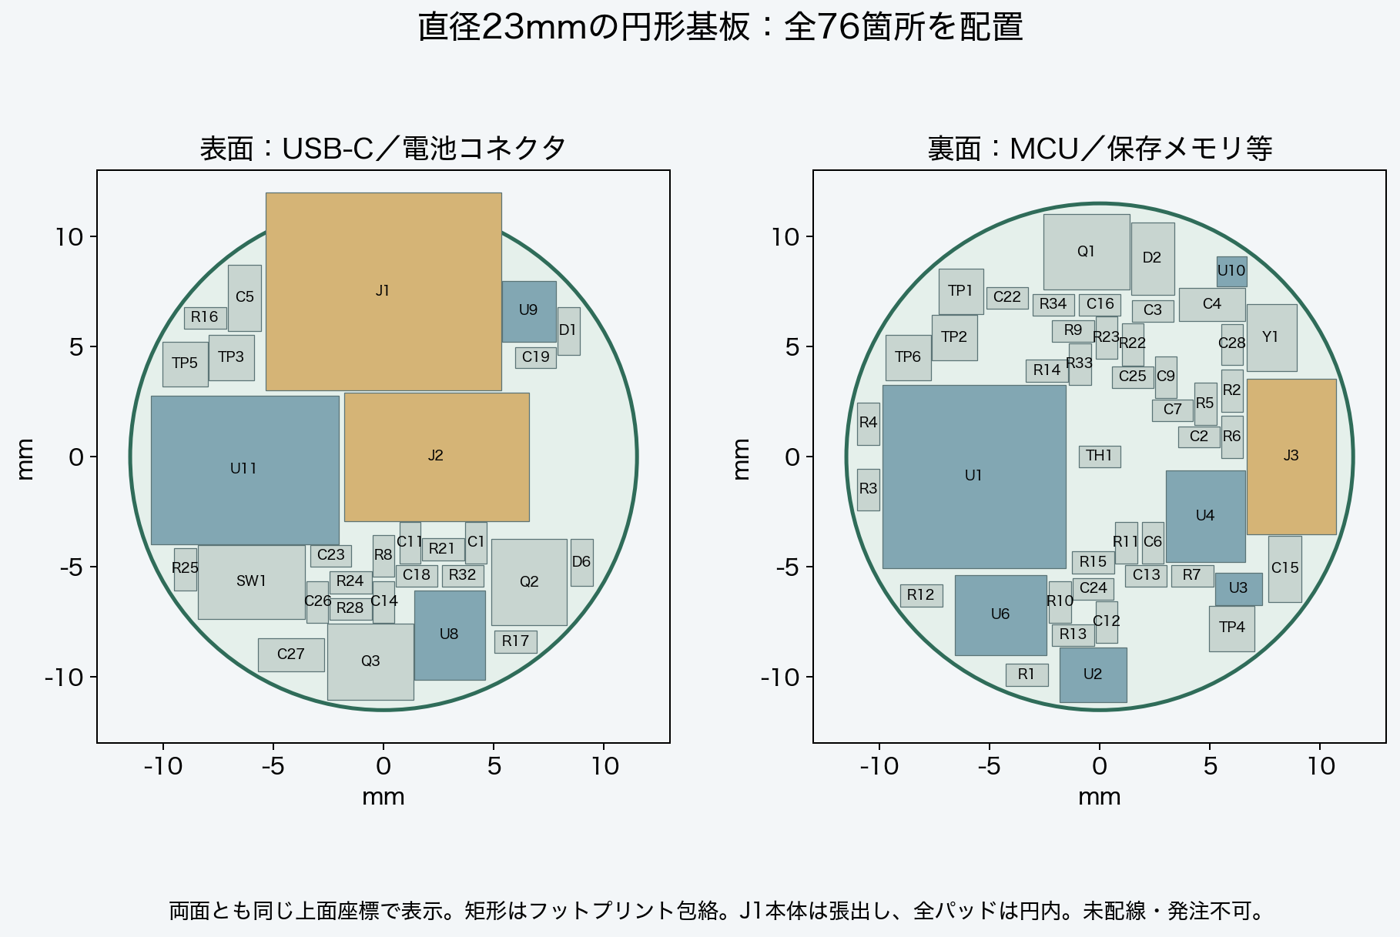
mechanical/structure-d1/placement.png
