nyanko3141592/pendant-recorder/mechanical/structure-d1/runtime.png

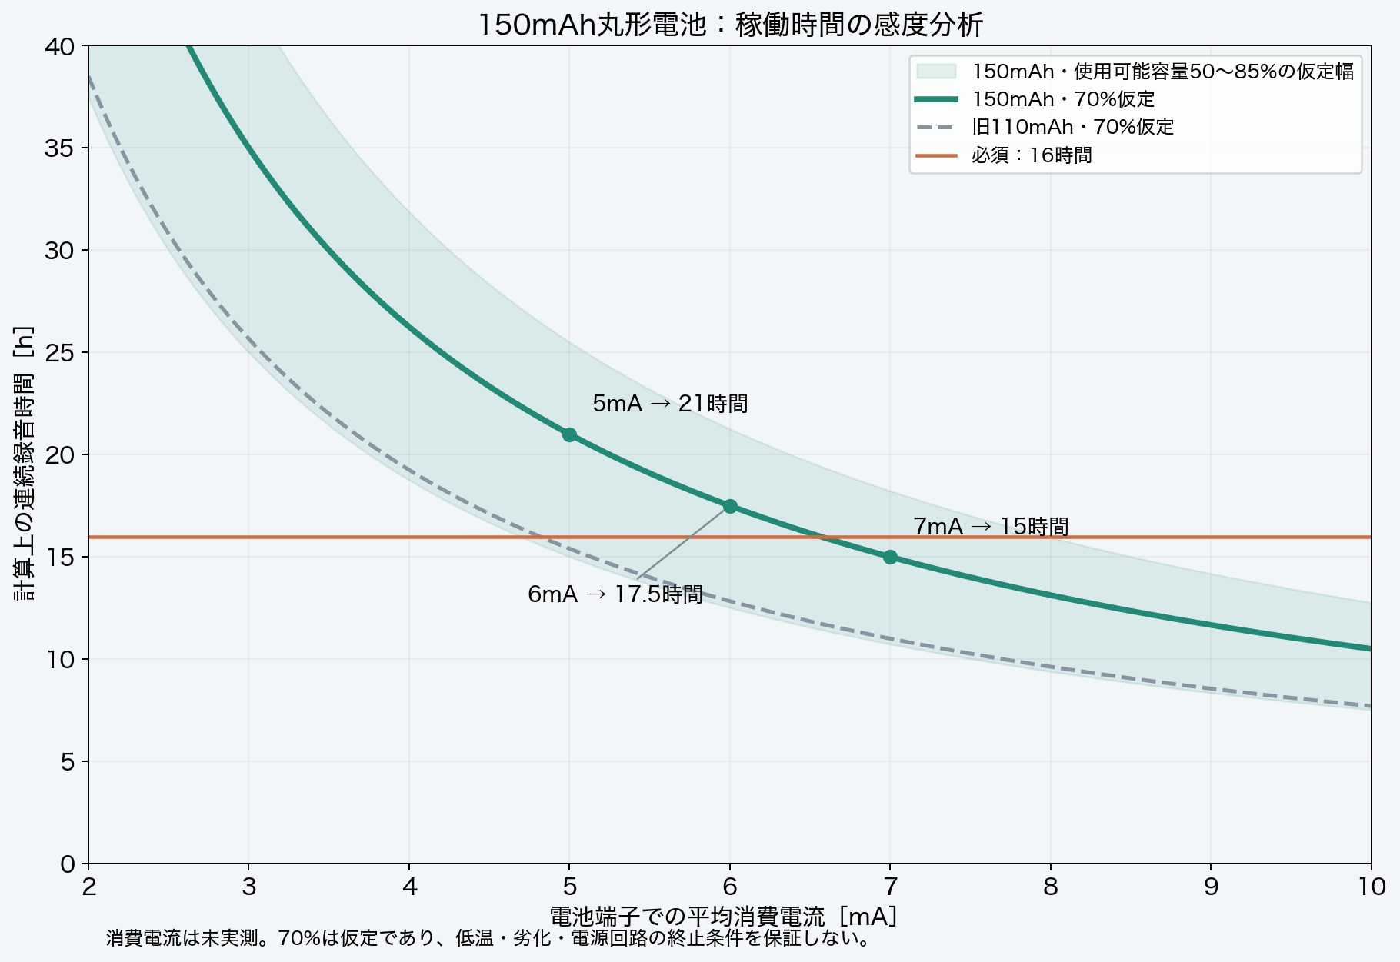
mechanical/structure-d1/runtime.png
