nyanko3141592/pendant-recorder/mechanical/structure-d1/usb-side.png

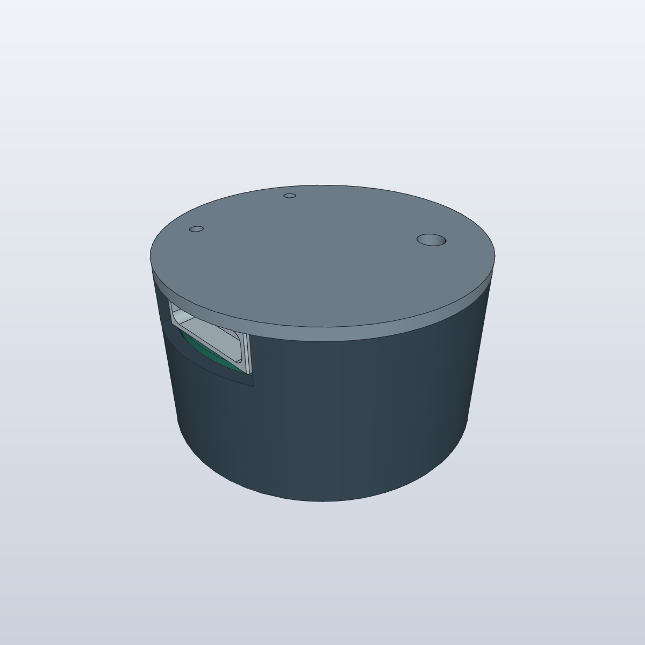
mechanical/structure-d1/usb-side.png
