nyanko3141592/pendant-recorder/mechanical/structure-d2/cutaway.png

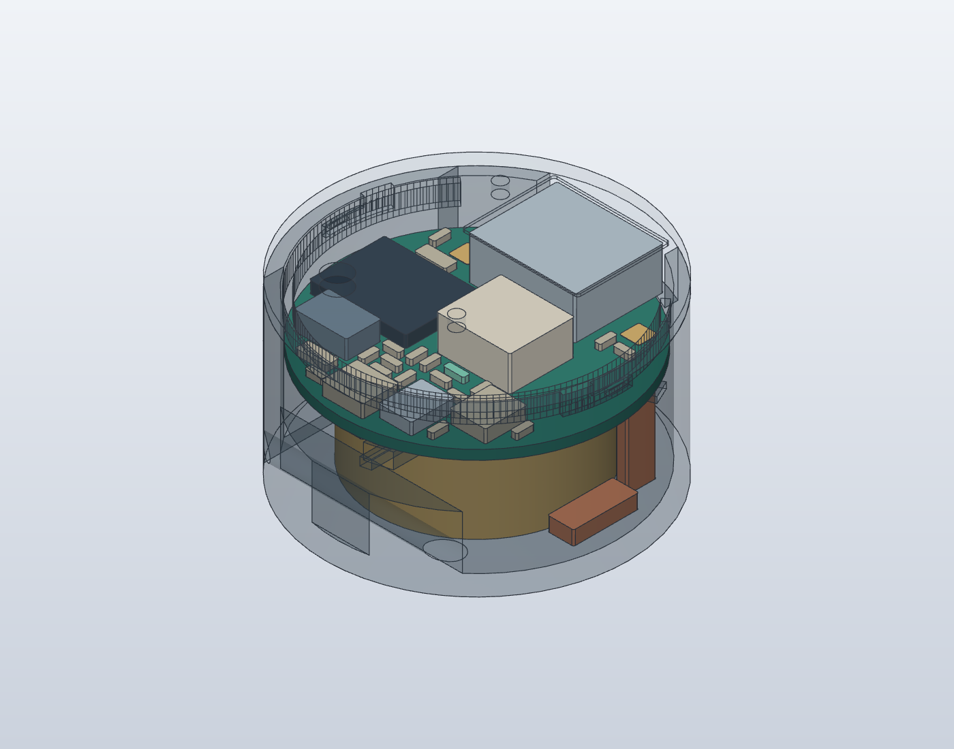
mechanical/structure-d2/cutaway.png
