nyanko3141592/pendant-recorder/mechanical/structure-d2/exploded.png

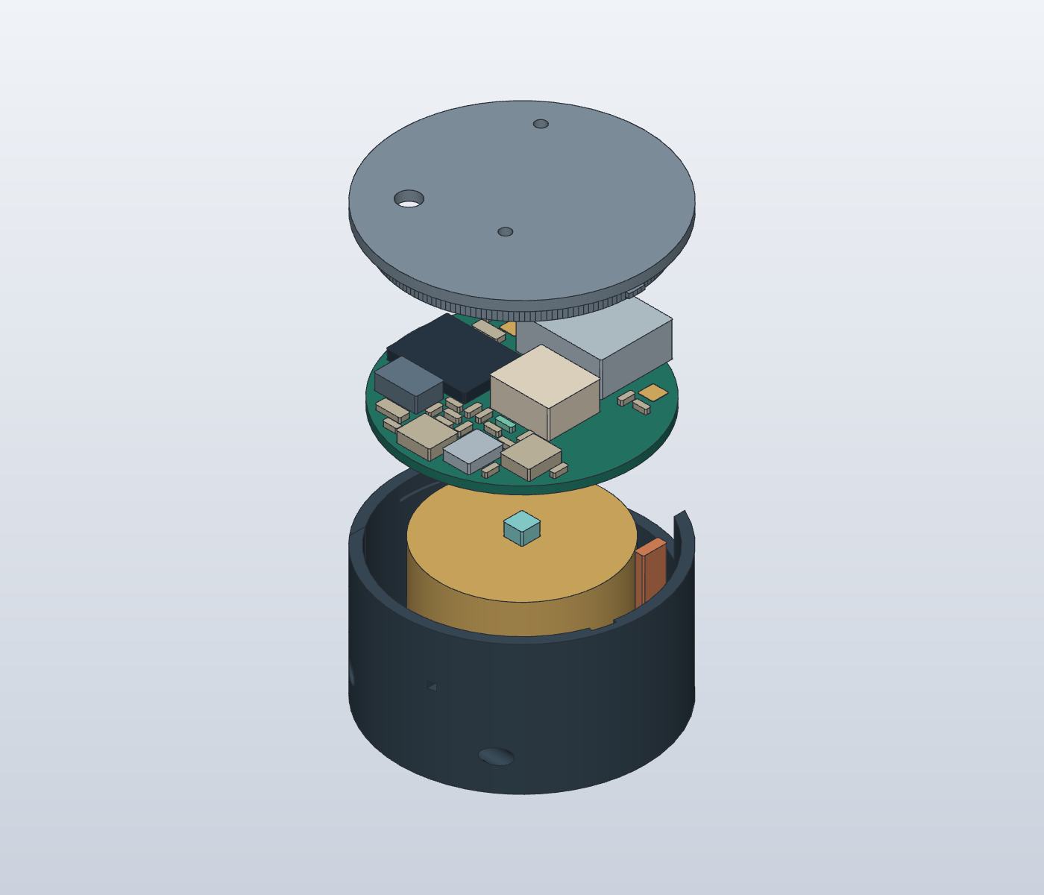
mechanical/structure-d2/exploded.png
