nyanko3141592/pendant-recorder/mechanical/xe-minimal/battery-stack-sections.png

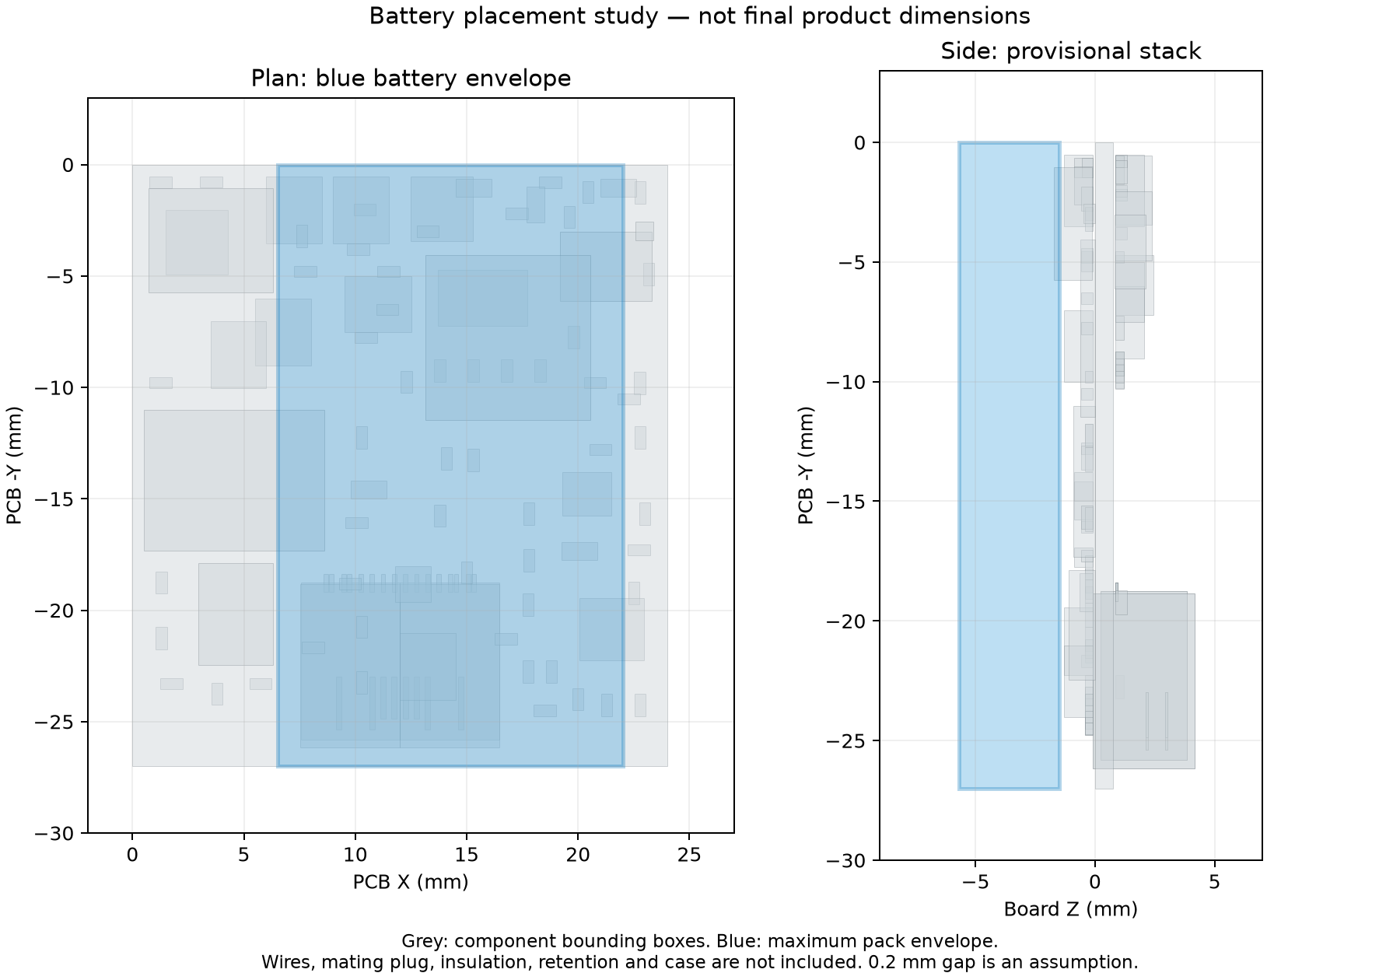
mechanical/xe-minimal/battery-stack-sections.png
