nyanko3141592/pendant-recorder/mechanical/xe-minimal/buttonless-candidate-exploded-review.png

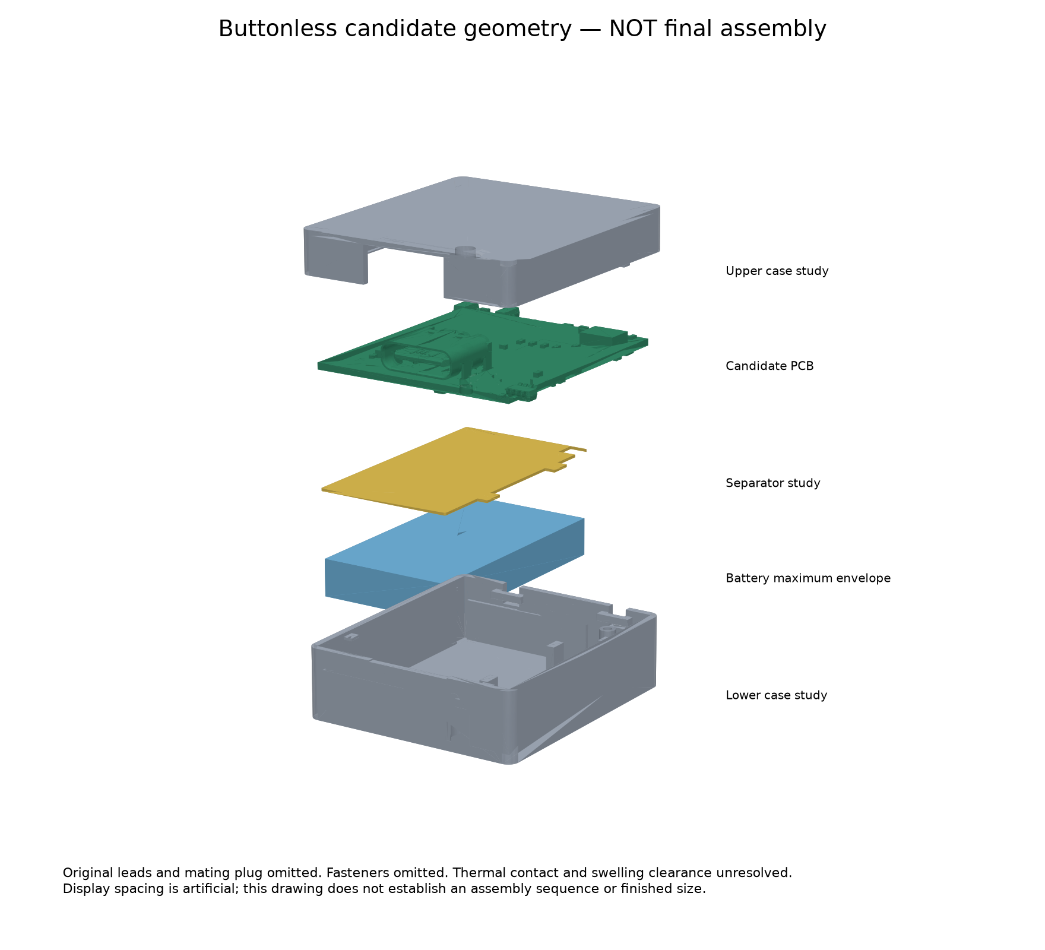
mechanical/xe-minimal/buttonless-candidate-exploded-review.png
