nyanko3141592/pendant-recorder/mechanical/xe-minimal/buttonless-dimension-comparison.png

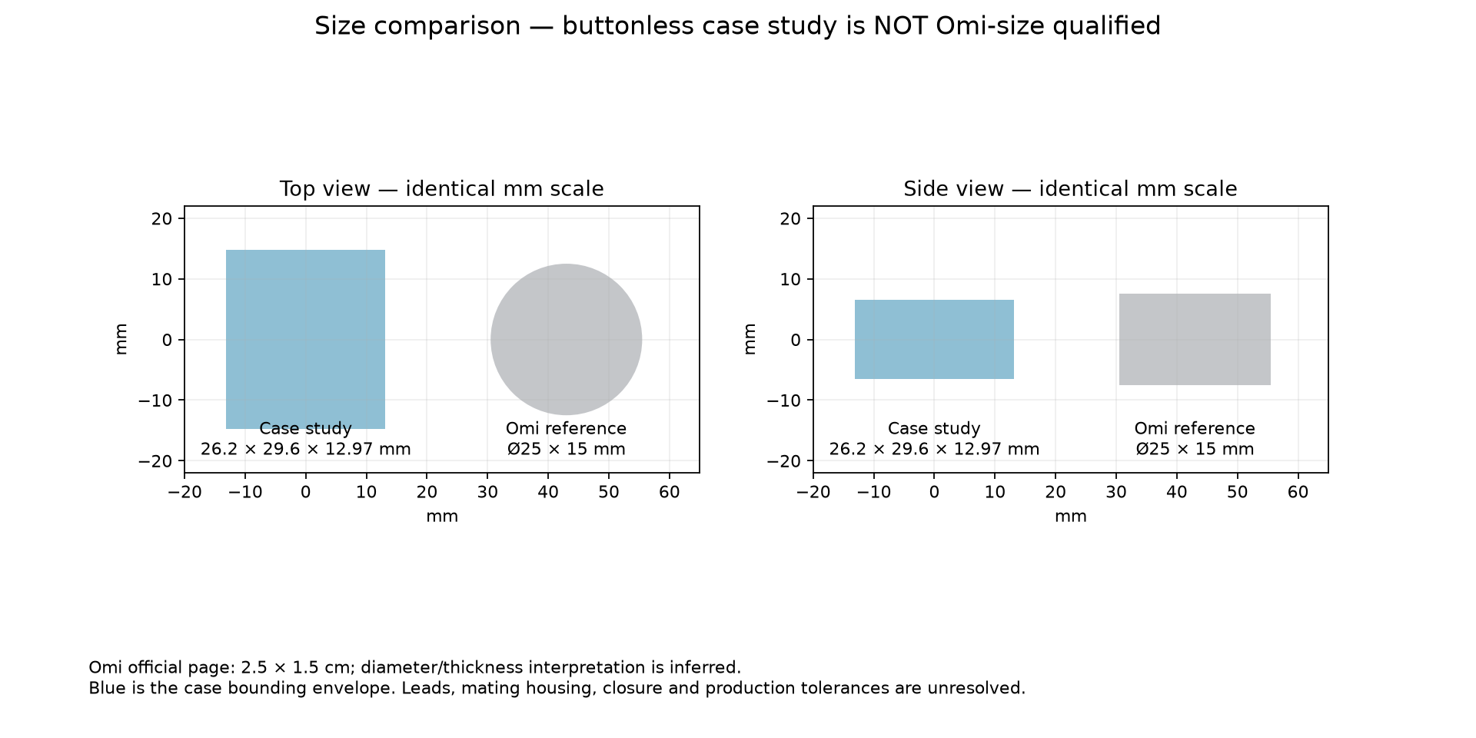
mechanical/xe-minimal/buttonless-dimension-comparison.png
