nyanko3141592/pendant-recorder/mechanical/xe-minimal/case-envelope-vs-omi-covers-study.png

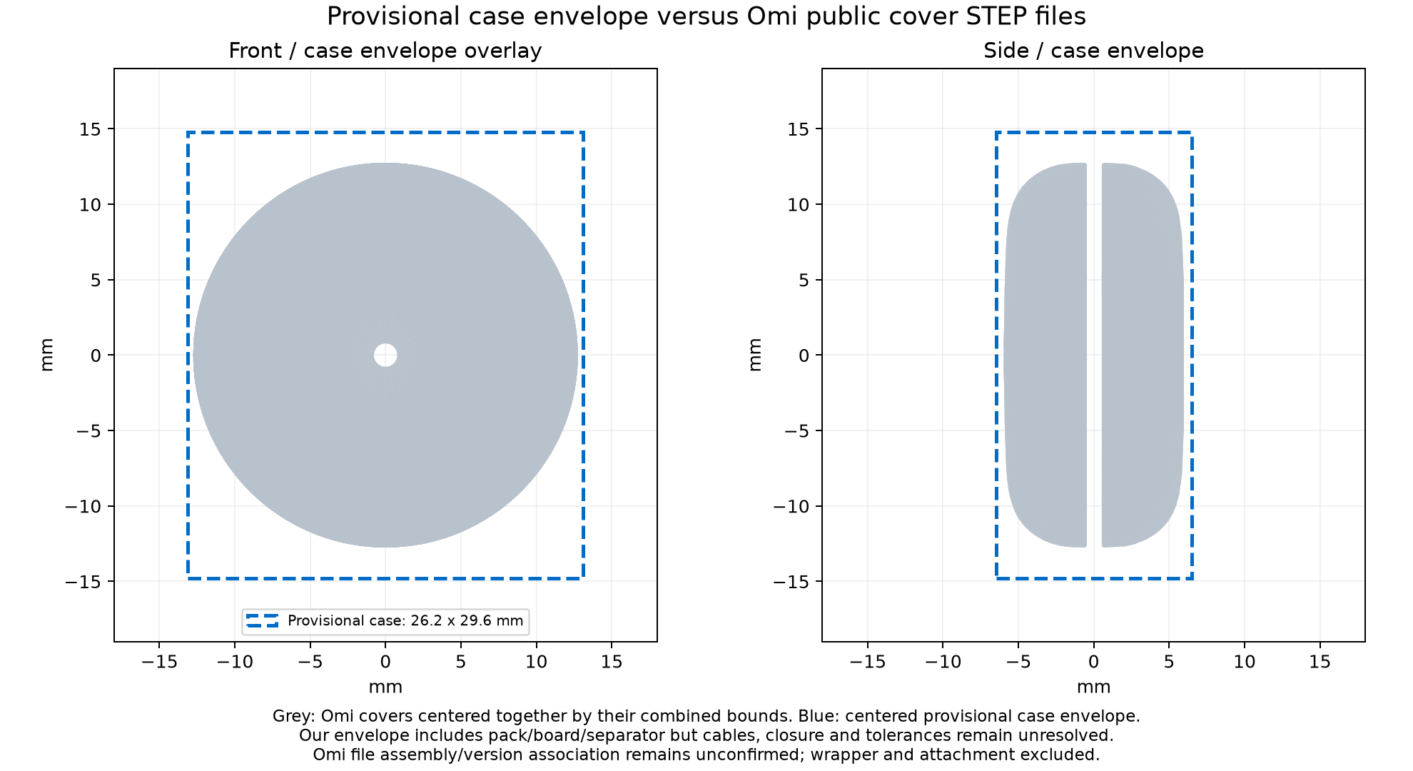
mechanical/xe-minimal/case-envelope-vs-omi-covers-study.png
