nyanko3141592/pendant-recorder/mechanical/xe-minimal/diagonal-retainer-design-review.png

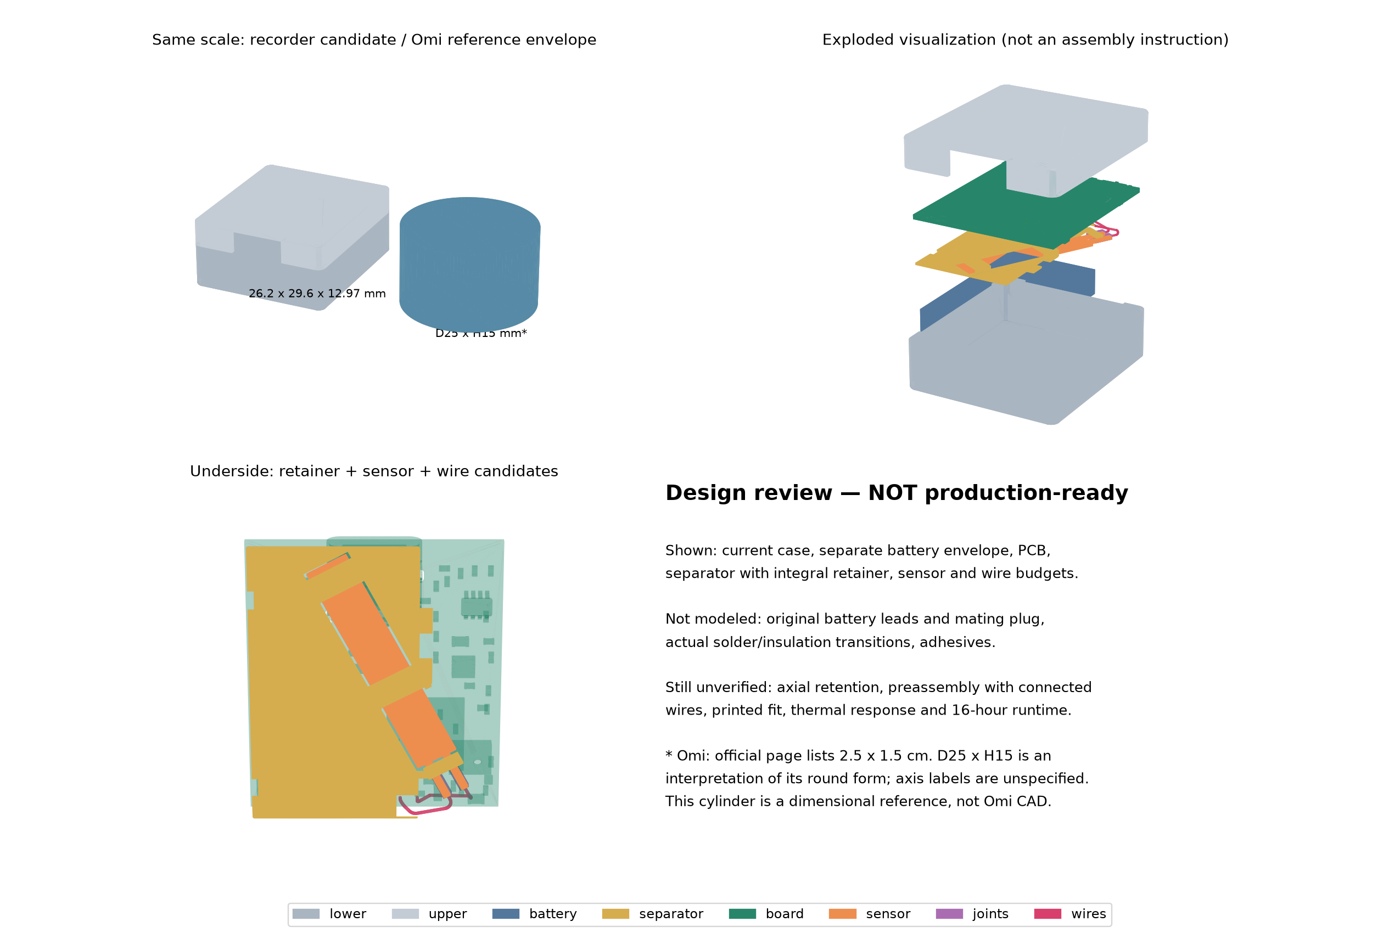
mechanical/xe-minimal/diagonal-retainer-design-review.png
