nyanko3141592/pendant-recorder/mechanical/xe-minimal/film-current-integration-design-review.png

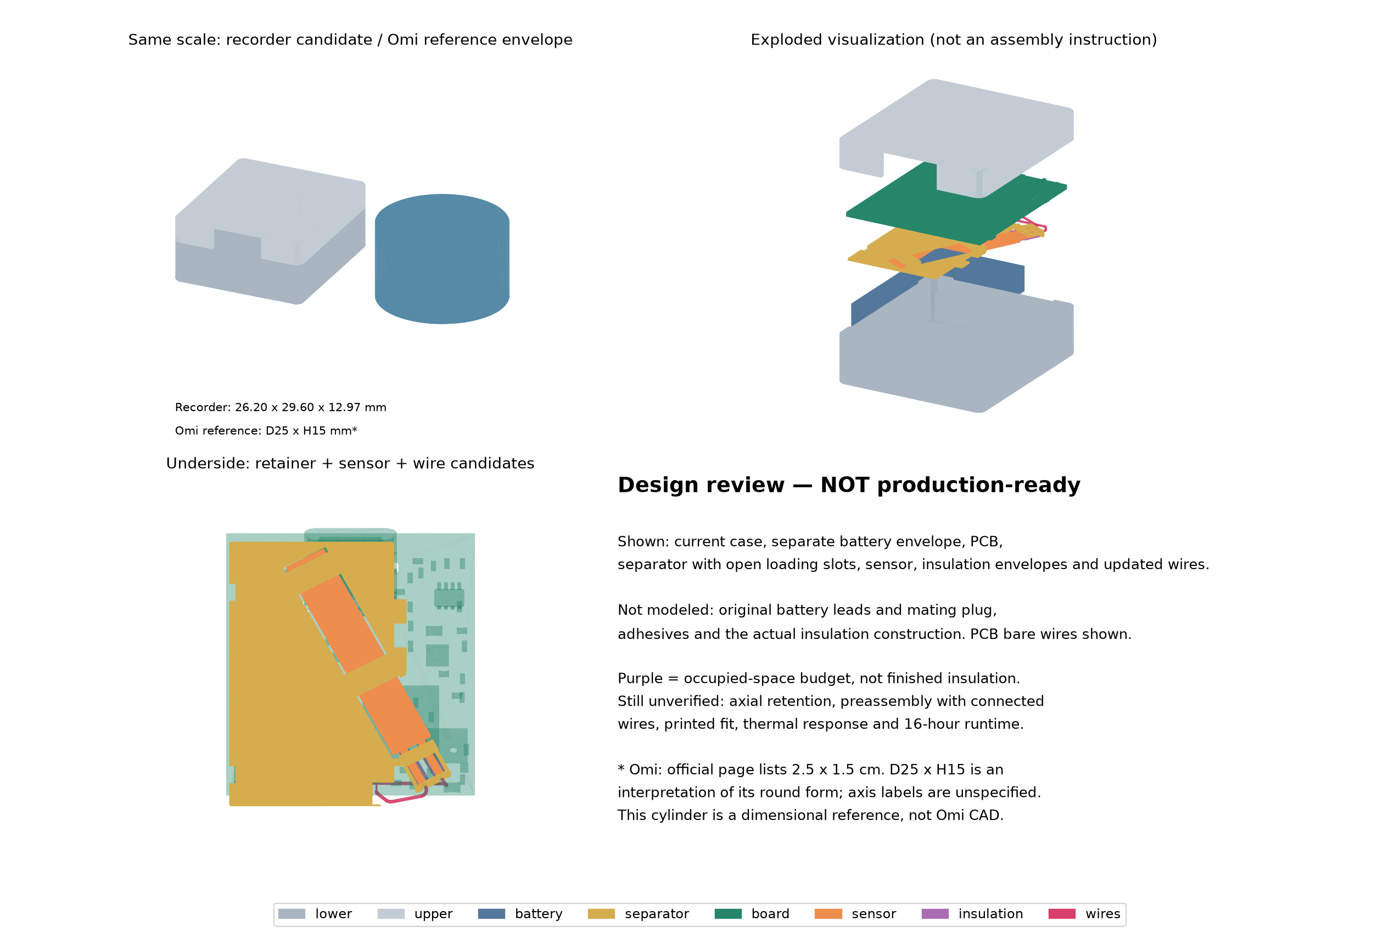
mechanical/xe-minimal/film-current-integration-design-review.png
