nyanko3141592/pendant-recorder/mechanical/xe-minimal/film-slot-separator-review.png

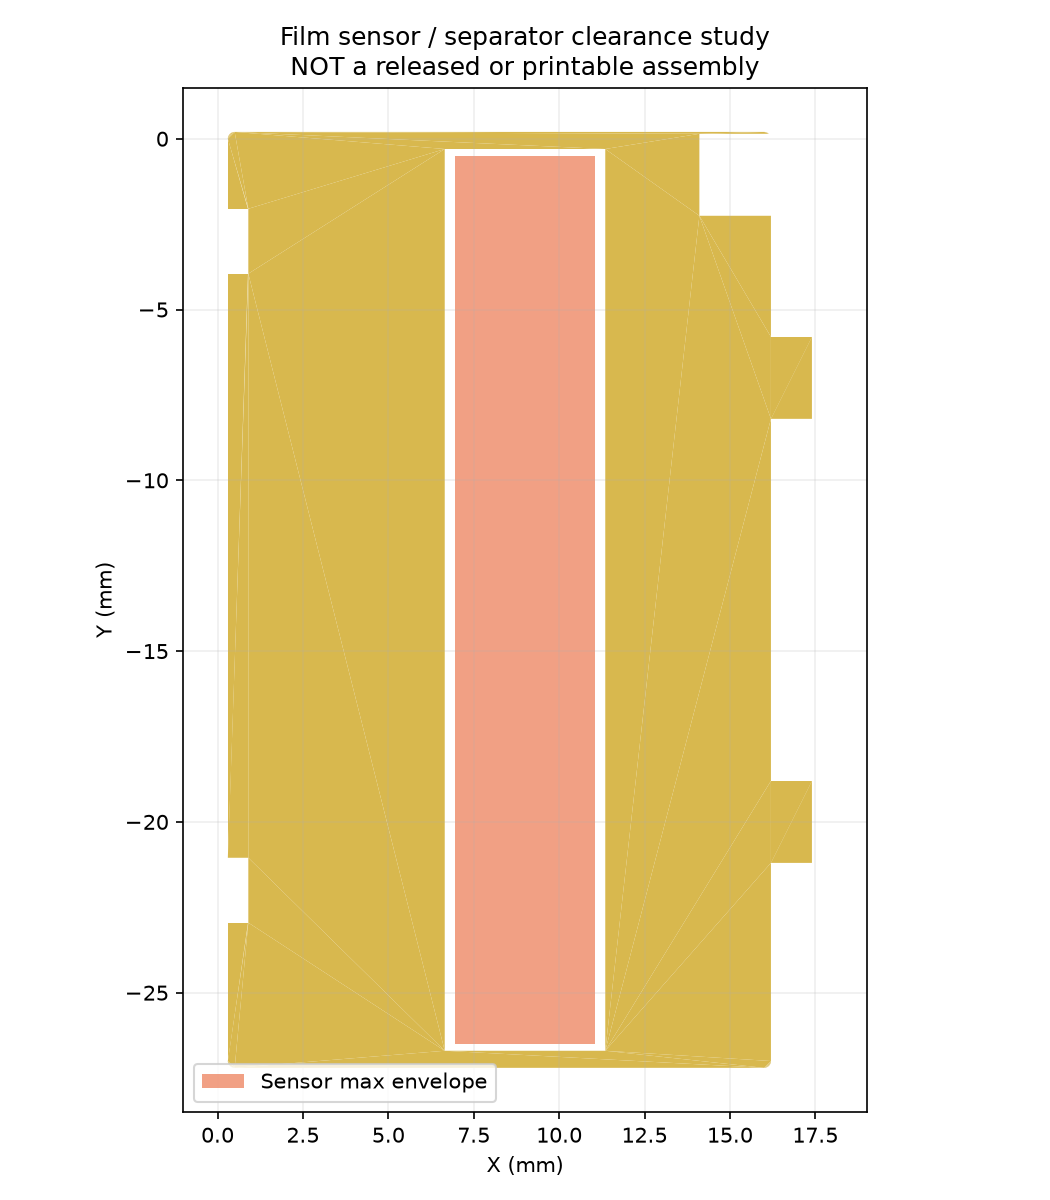
mechanical/xe-minimal/film-slot-separator-review.png
