nyanko3141592/pendant-recorder/mechanical/xe-minimal/home-case-slice-review/adhesive-pocket-aligned/top-layers.png

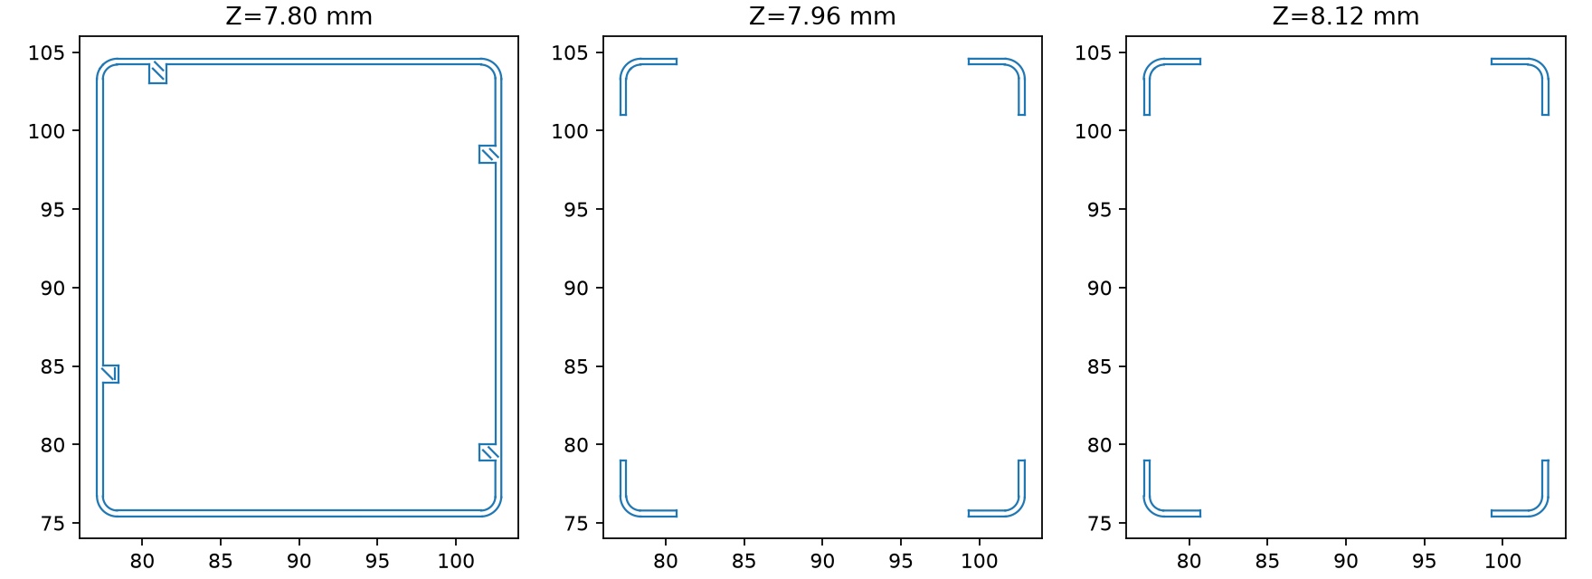
mechanical/xe-minimal/home-case-slice-review/adhesive-pocket-aligned/top-layers.png
