nyanko3141592/pendant-recorder/mechanical/xe-minimal/home-case-slice-review/arachne-four-wall-lower/cross-section-review.png

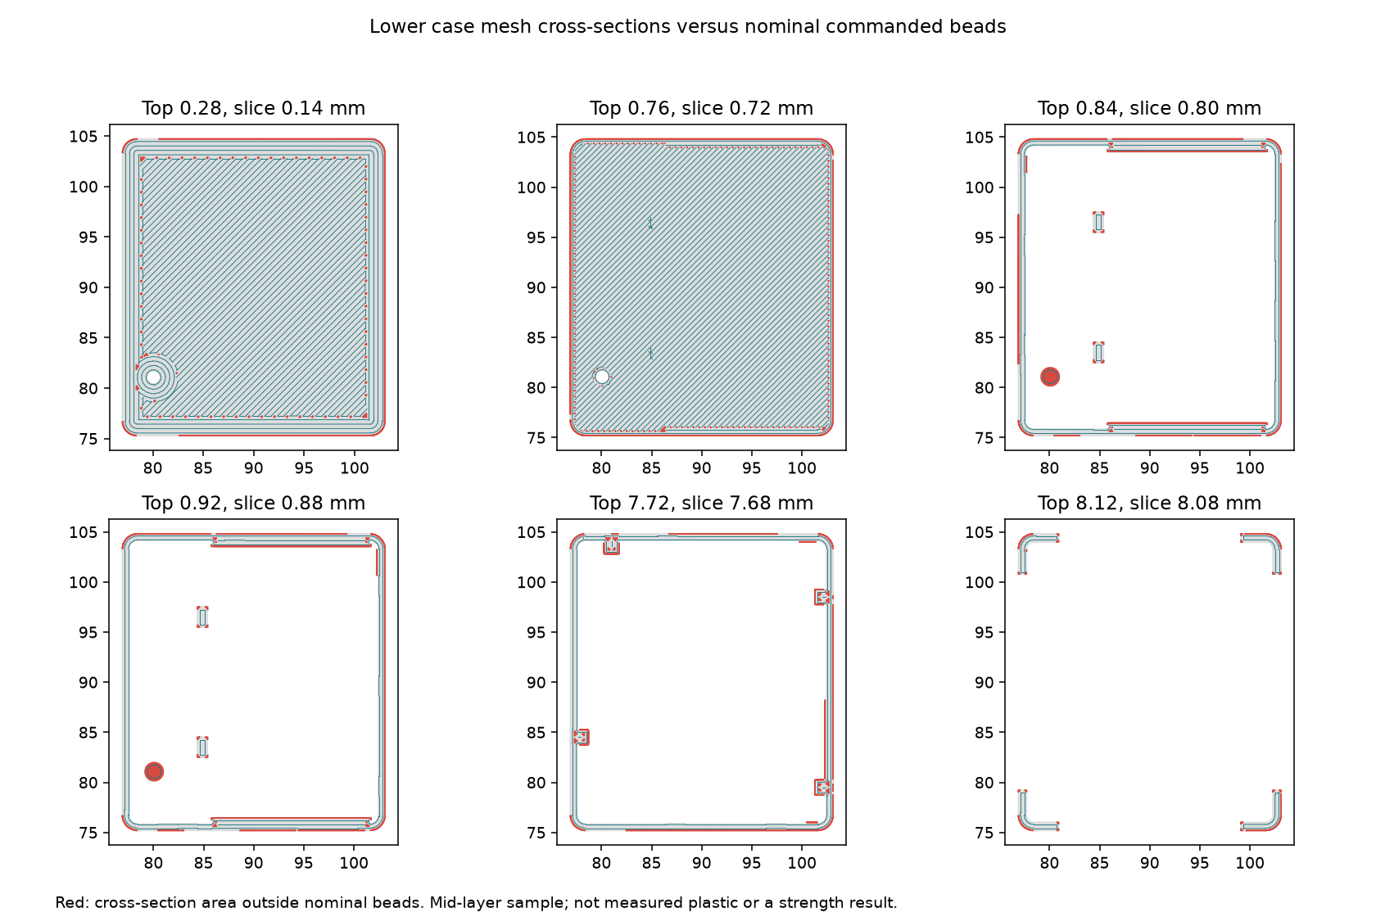
mechanical/xe-minimal/home-case-slice-review/arachne-four-wall-lower/cross-section-review.png
