nyanko3141592/pendant-recorder/mechanical/xe-minimal/home-case-slice-review/current-lower/cross-section-review.png

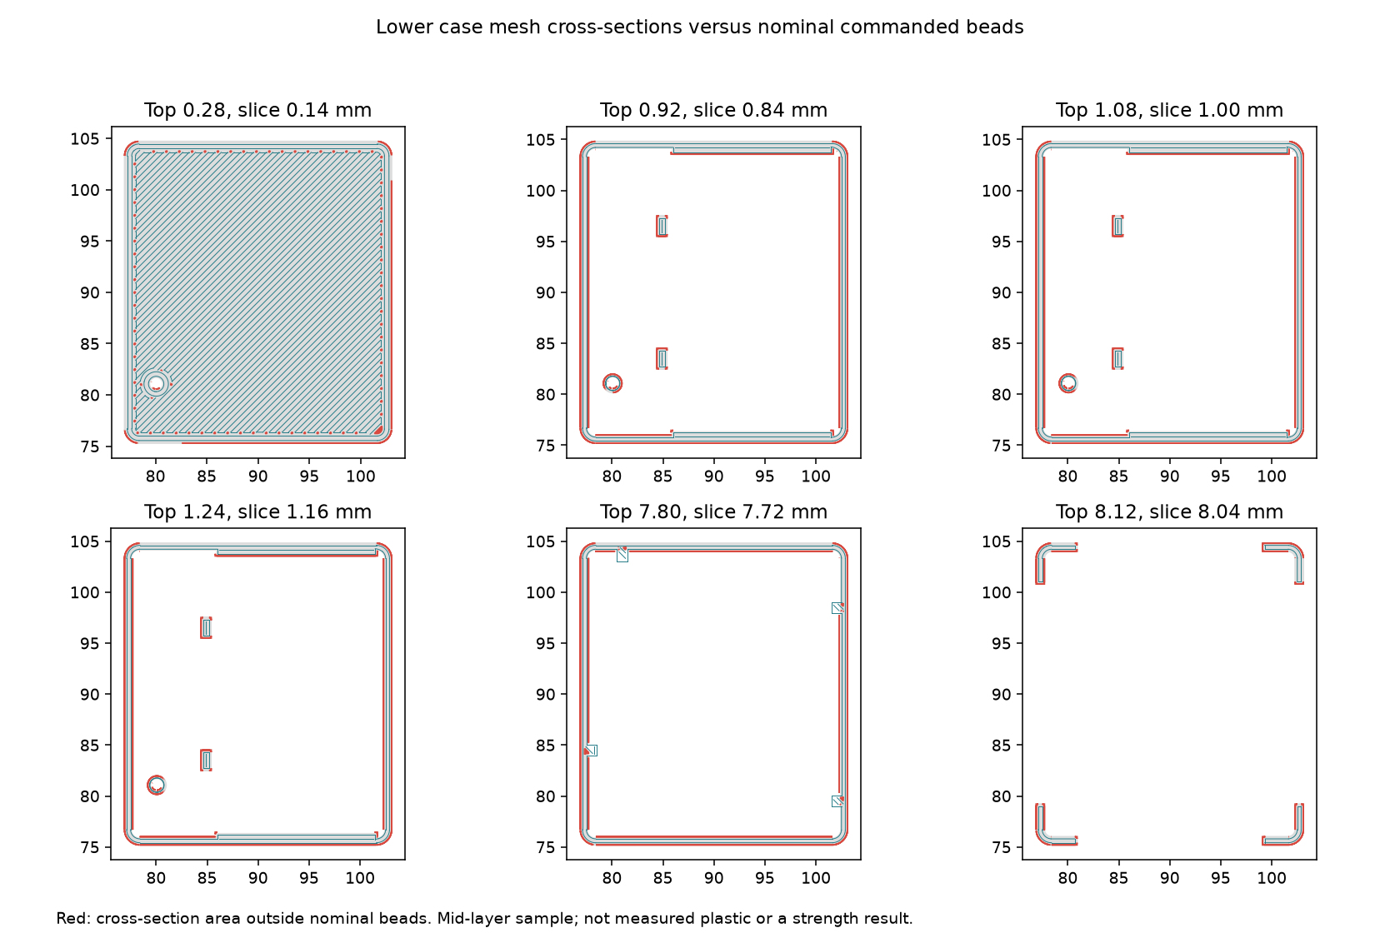
mechanical/xe-minimal/home-case-slice-review/current-lower/cross-section-review.png
