nyanko3141592/pendant-recorder/mechanical/xe-minimal/home-case-slice-review/current-lower/wall-toolpath-review.png

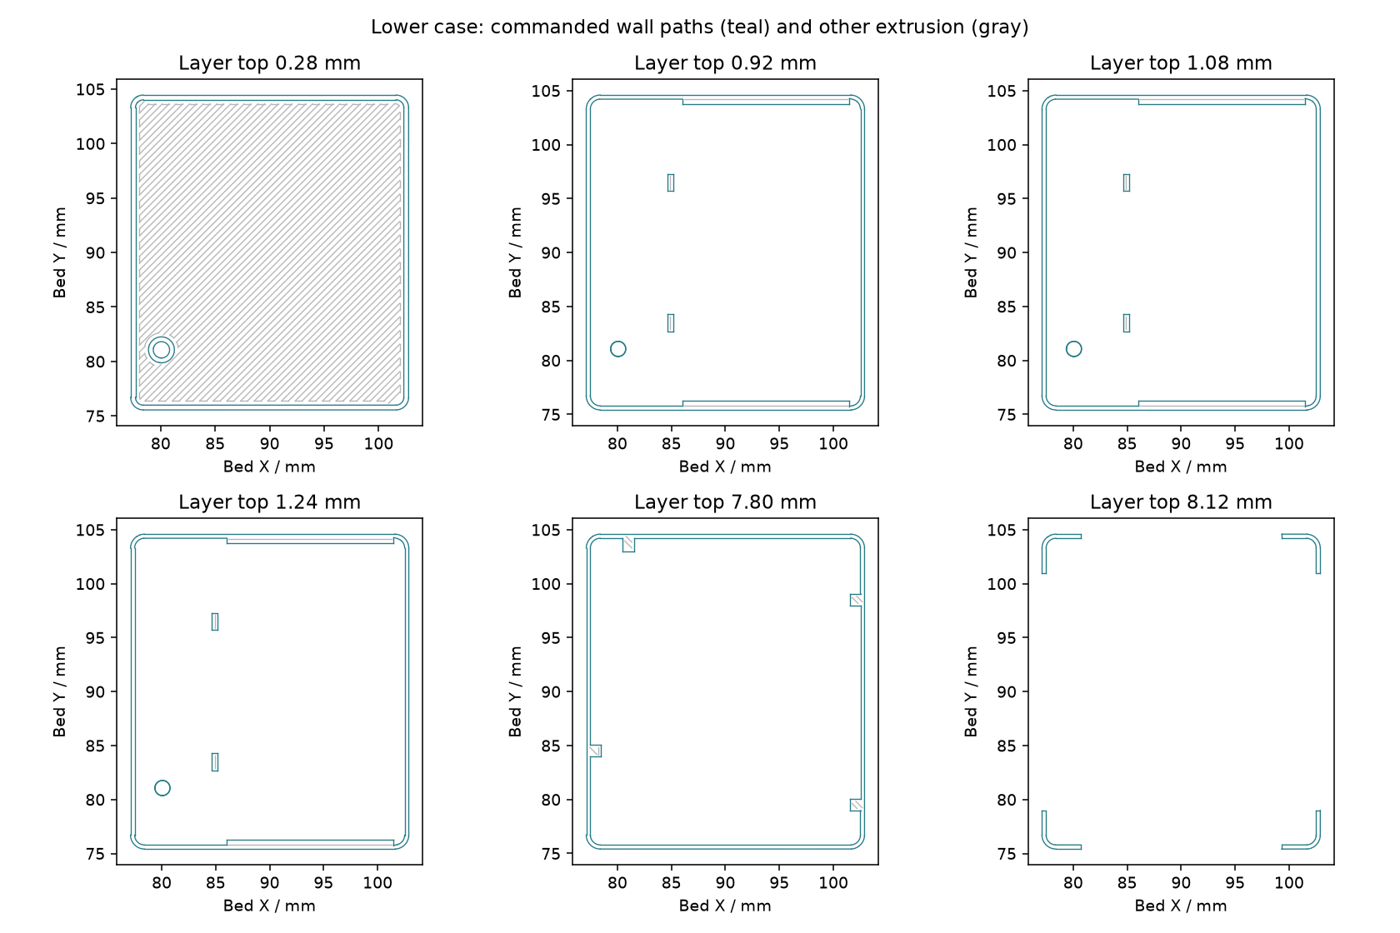
mechanical/xe-minimal/home-case-slice-review/current-lower/wall-toolpath-review.png
