nyanko3141592/pendant-recorder/mechanical/xe-minimal/home-case-slice-review/current-separator/toolpath-review.png

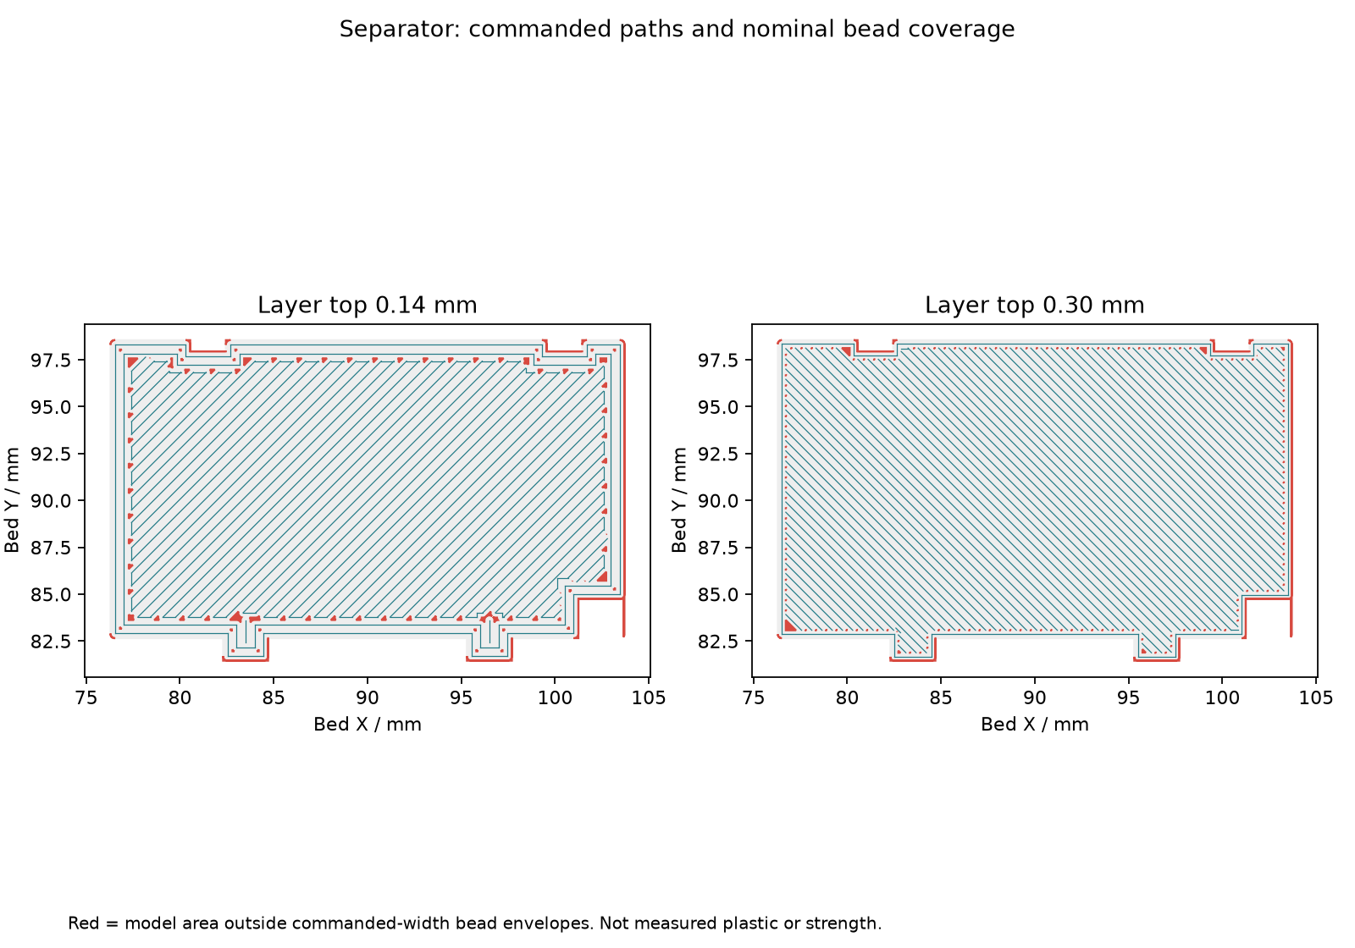
mechanical/xe-minimal/home-case-slice-review/current-separator/toolpath-review.png
