nyanko3141592/pendant-recorder/mechanical/xe-minimal/home-case-slice-review/diagonal-bridge-separator/rib-toolpath-review.png

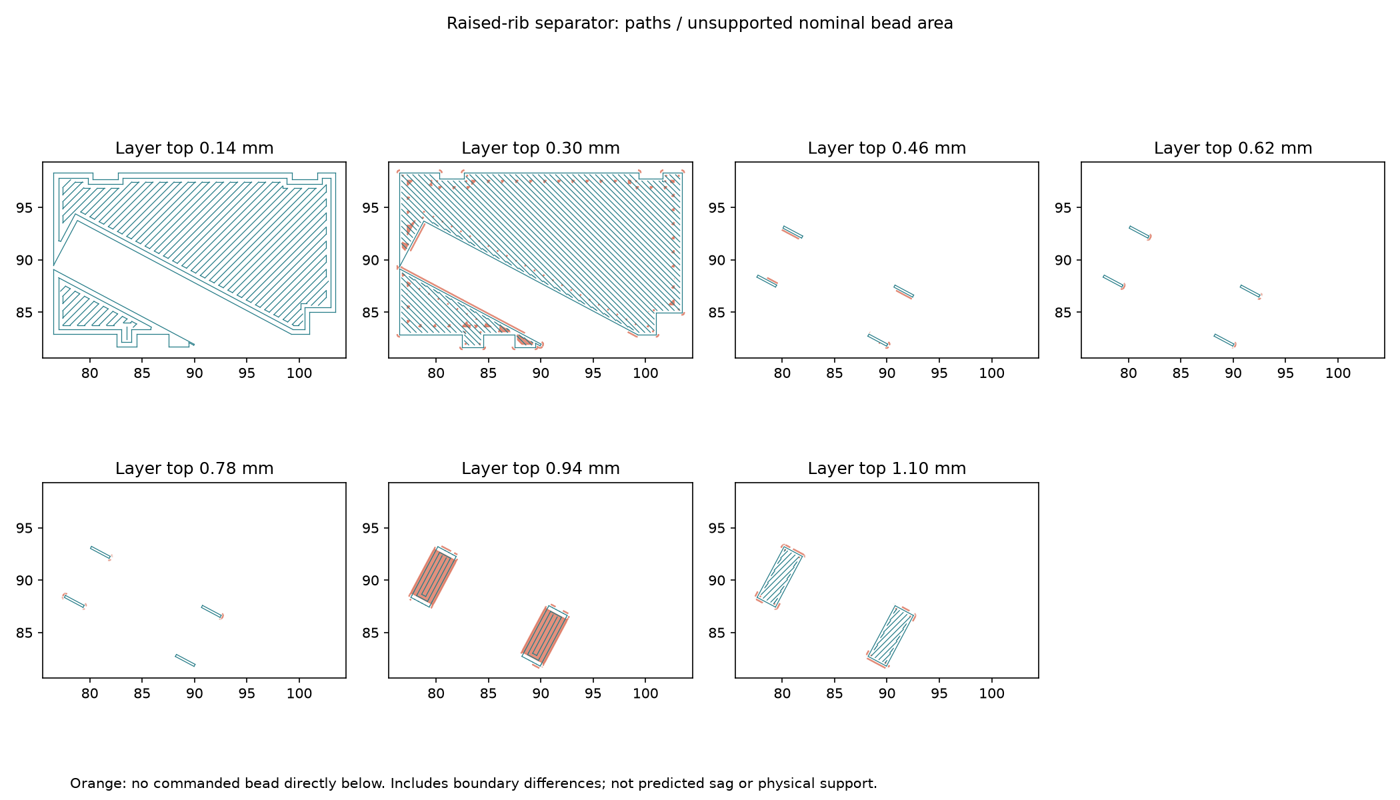
mechanical/xe-minimal/home-case-slice-review/diagonal-bridge-separator/rib-toolpath-review.png
