nyanko3141592/pendant-recorder/mechanical/xe-minimal/home-case-slice-review/diagonal-integral-retainer-separator/rib-toolpath-review.png

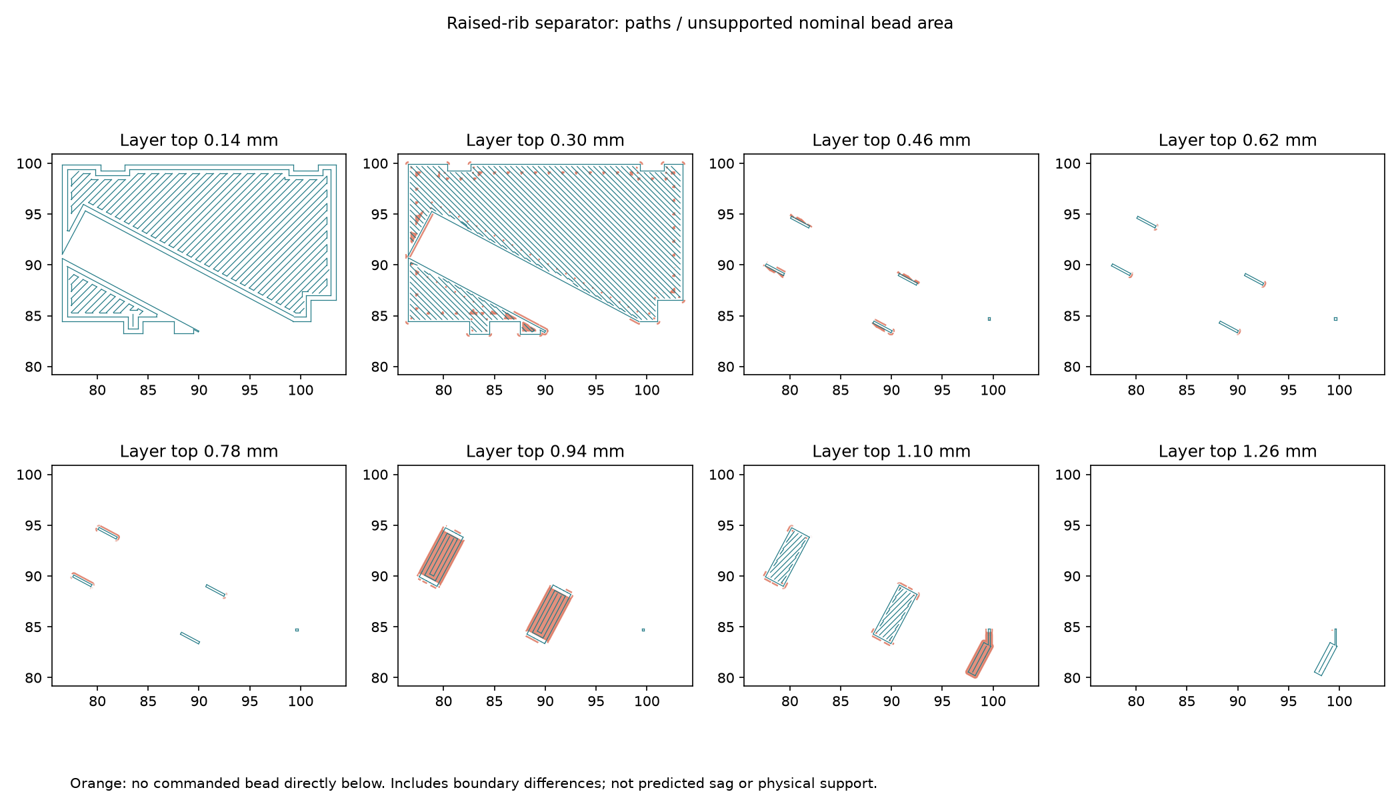
mechanical/xe-minimal/home-case-slice-review/diagonal-integral-retainer-separator/rib-toolpath-review.png
