nyanko3141592/pendant-recorder/mechanical/xe-minimal/home-case-slice-review/diagonal-recessed-cap-lower/recess-toolpath-review.png

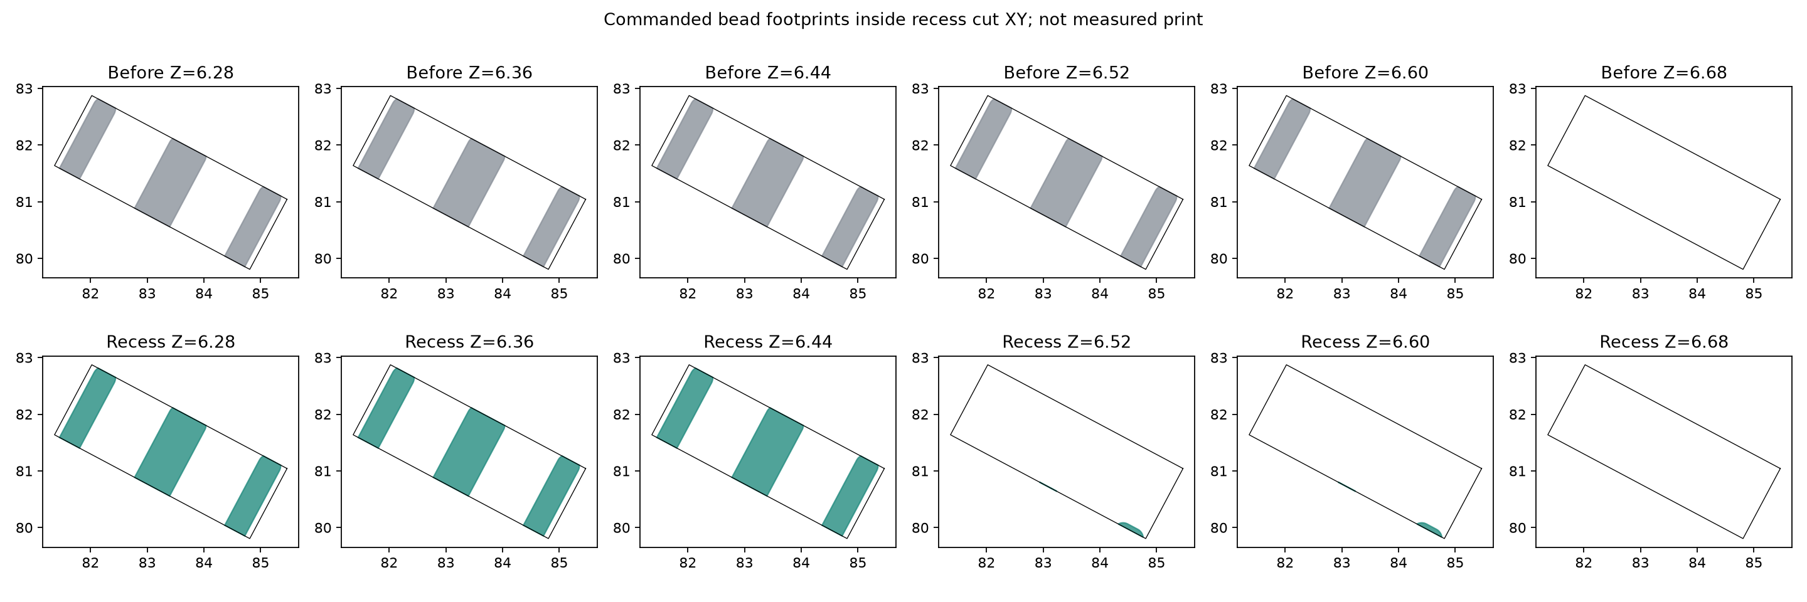
mechanical/xe-minimal/home-case-slice-review/diagonal-recessed-cap-lower/recess-toolpath-review.png
