nyanko3141592/pendant-recorder/mechanical/xe-minimal/home-case-slice-review/diagonal-tapered-tray-lower/tray-transition-review.png

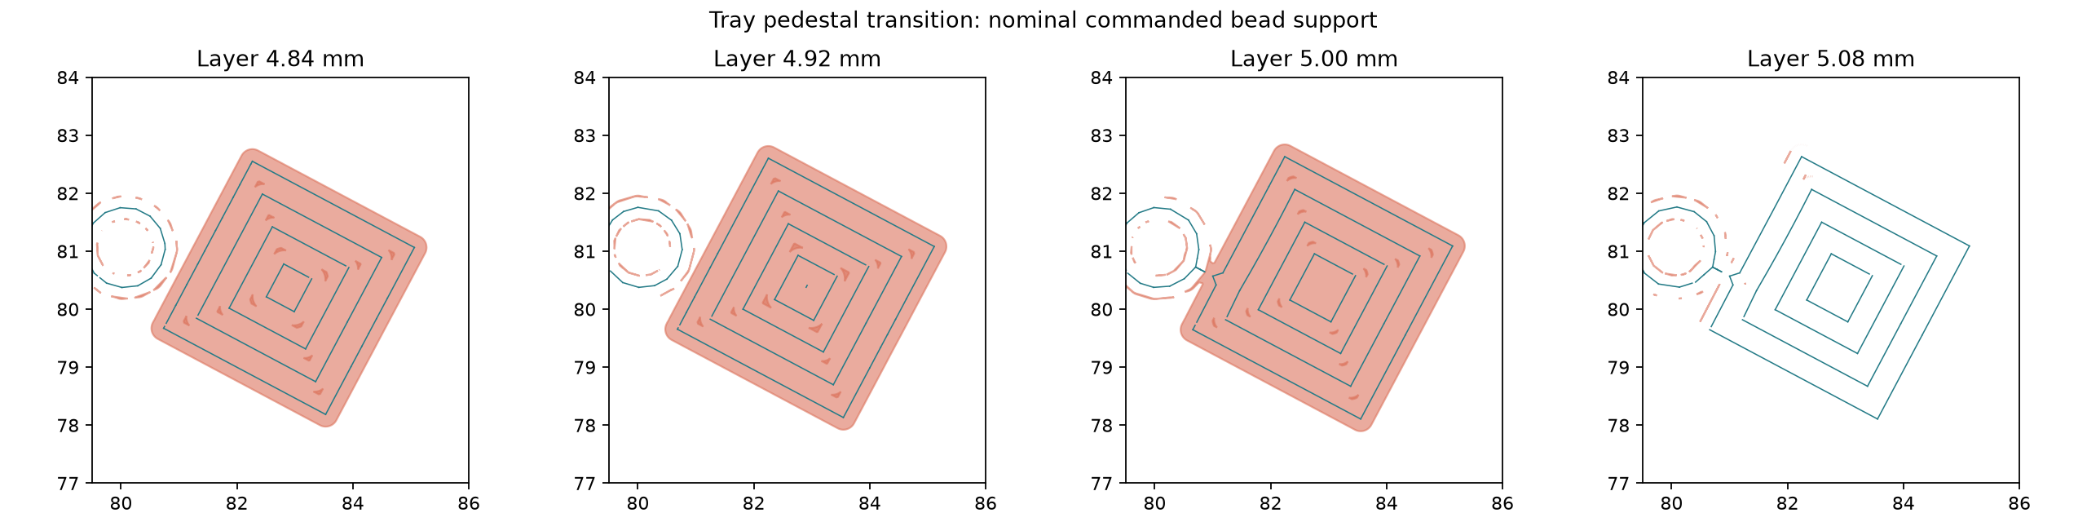
mechanical/xe-minimal/home-case-slice-review/diagonal-tapered-tray-lower/tray-transition-review.png
