nyanko3141592/pendant-recorder/mechanical/xe-minimal/home-case-slice-review/duct-toolpaths.png

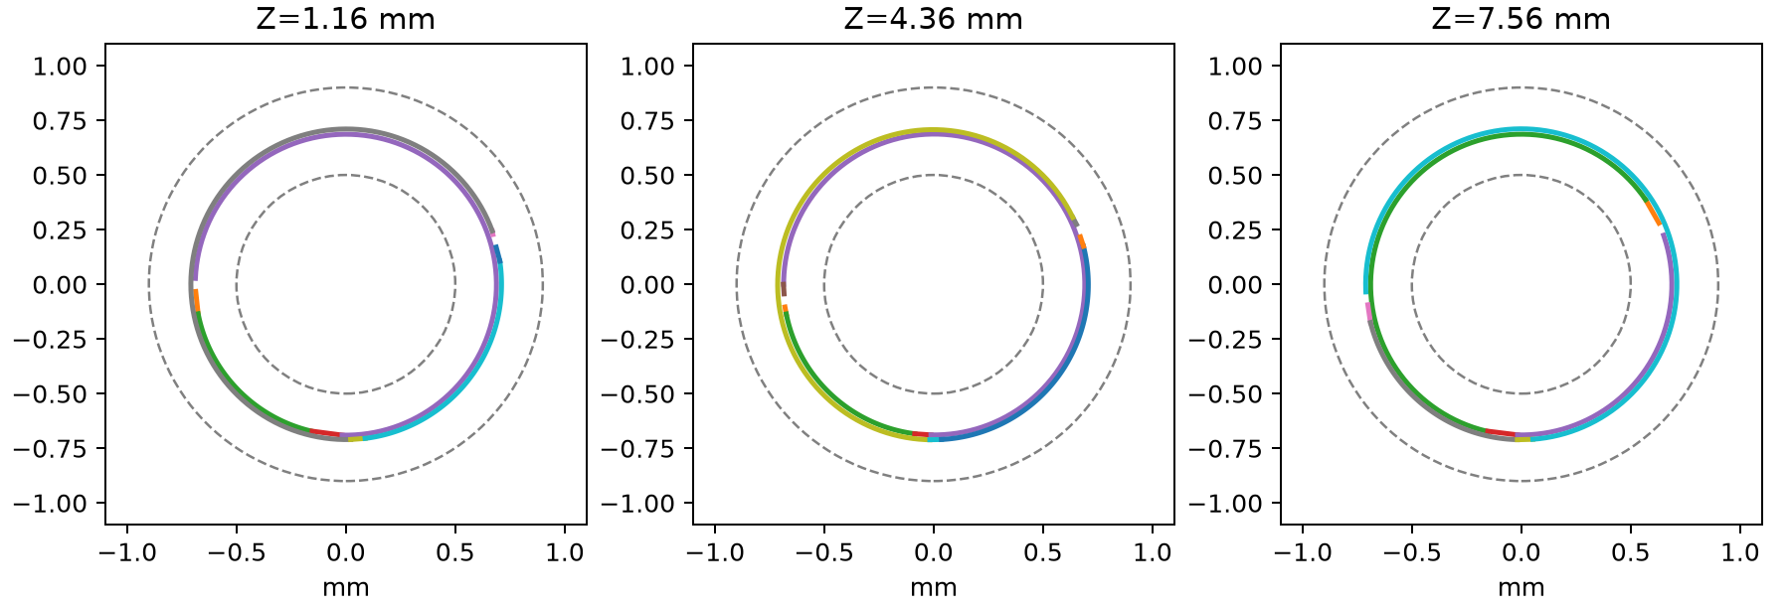
mechanical/xe-minimal/home-case-slice-review/duct-toolpaths.png
