nyanko3141592/pendant-recorder/mechanical/xe-minimal/home-case-slice-review/film-axial-stop-relieved-supported-separator/rib-toolpath-review.png

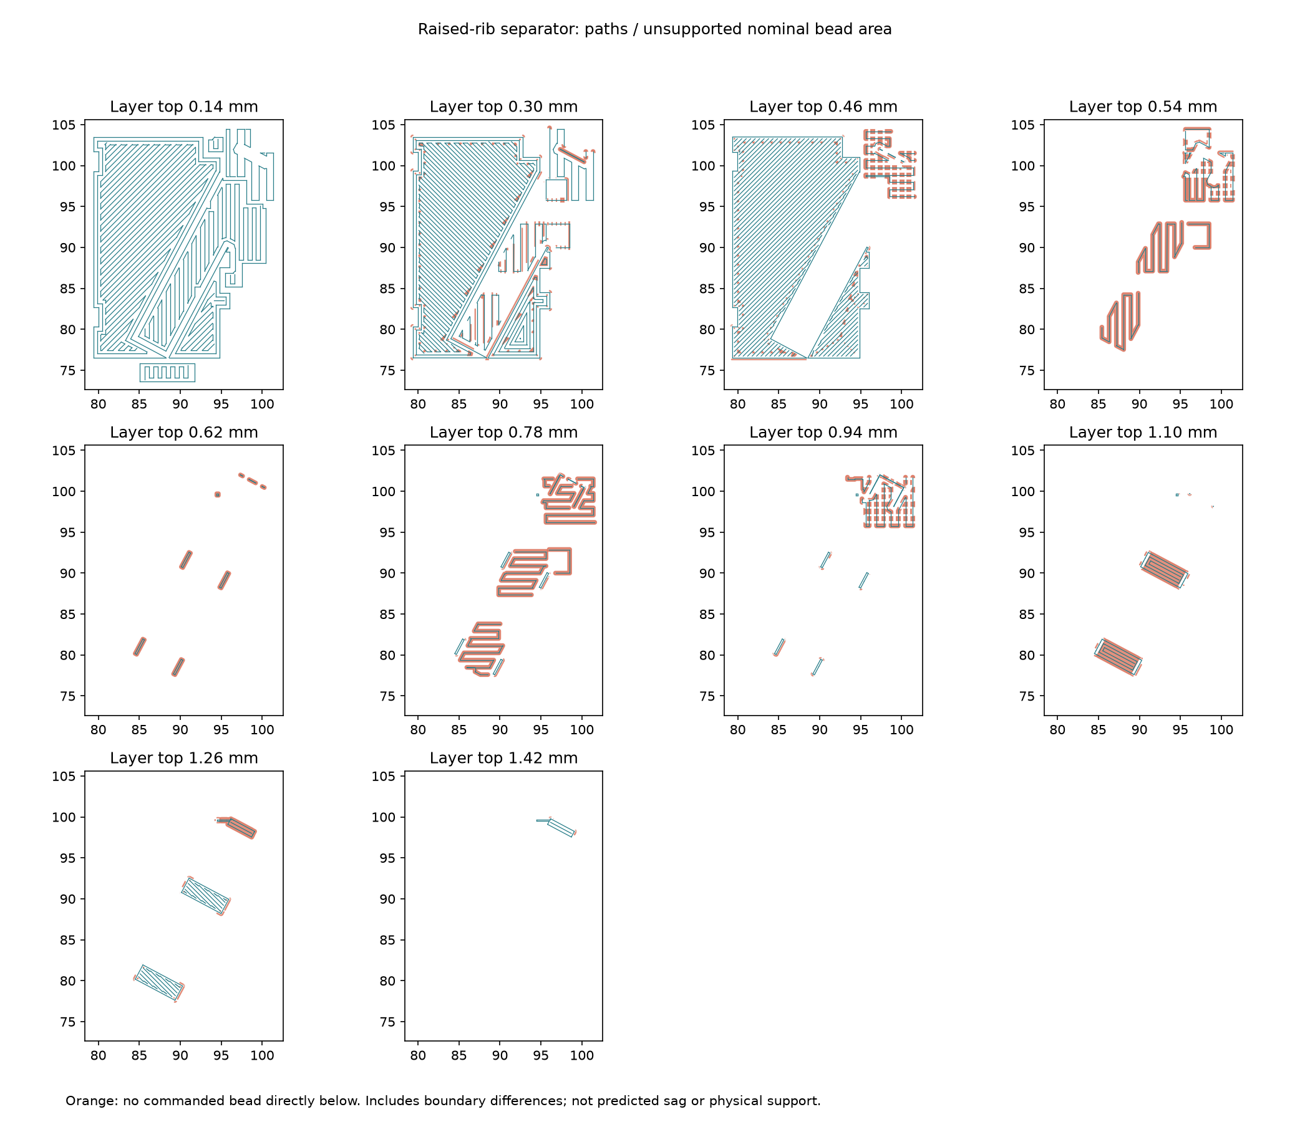
mechanical/xe-minimal/home-case-slice-review/film-axial-stop-relieved-supported-separator/rib-toolpath-review.png
