nyanko3141592/pendant-recorder/mechanical/xe-minimal/pcb-vs-omi-covers-study.png

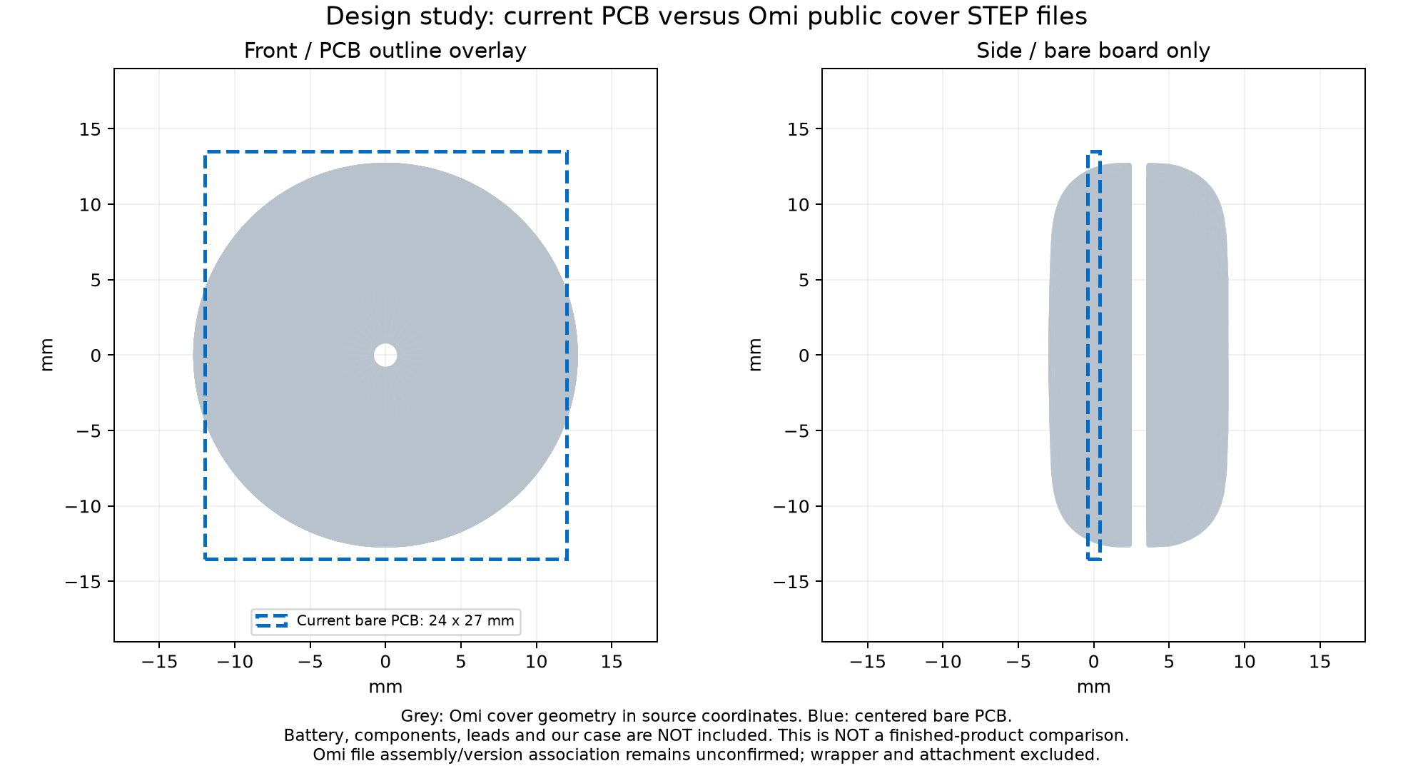
mechanical/xe-minimal/pcb-vs-omi-covers-study.png
