nyanko3141592/pendant-recorder/mechanical/xe-minimal/preorder-20261029/fit-kit-a1mini/plate-preview.png

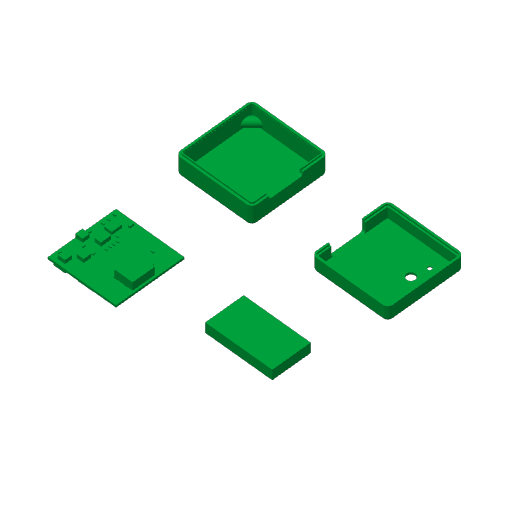
mechanical/xe-minimal/preorder-20261029/fit-kit-a1mini/plate-preview.png
