nyanko3141592/pendant-recorder/mechanical/xe-minimal/preorder-20261029/retained-battery-case/review.png

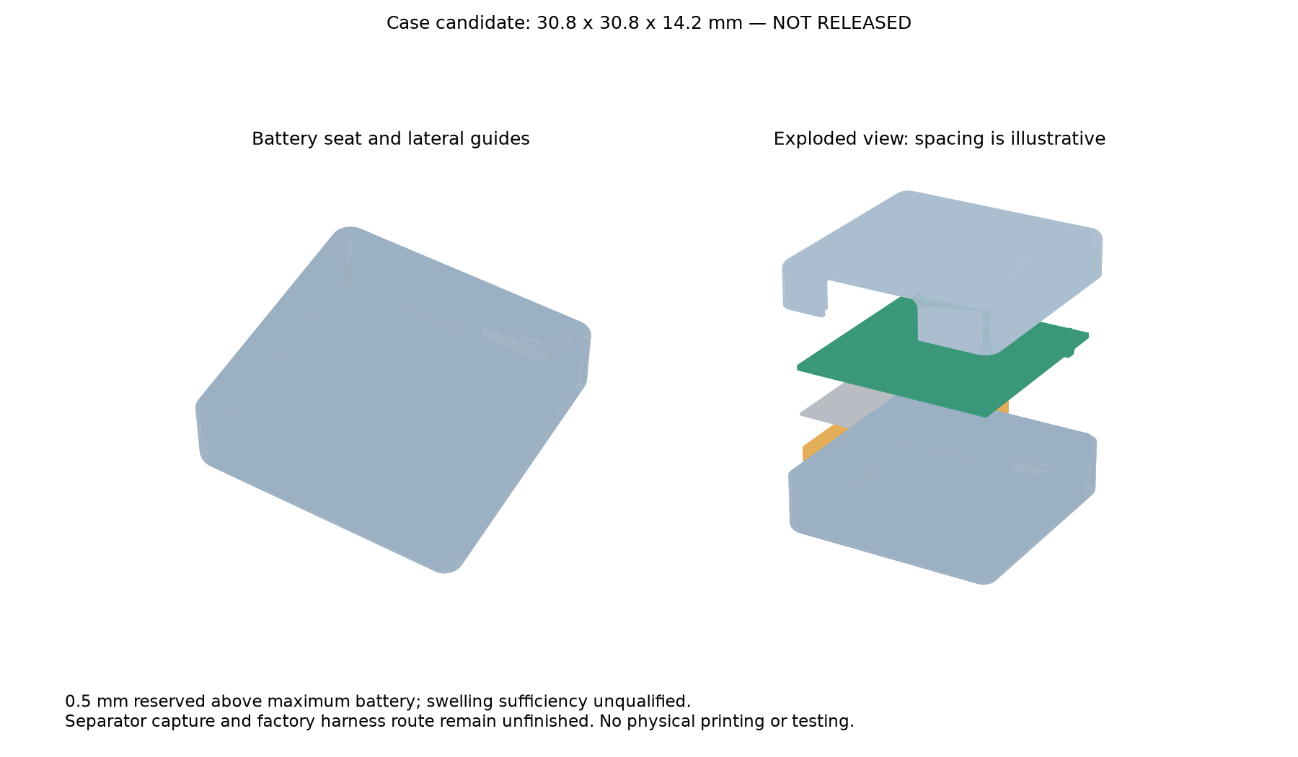
mechanical/xe-minimal/preorder-20261029/retained-battery-case/review.png
