nyanko3141592/pendant-recorder/mechanical/xe-minimal/prototype-v1/actual-30mm-prototype/actual-30mm-prototype-preview.png

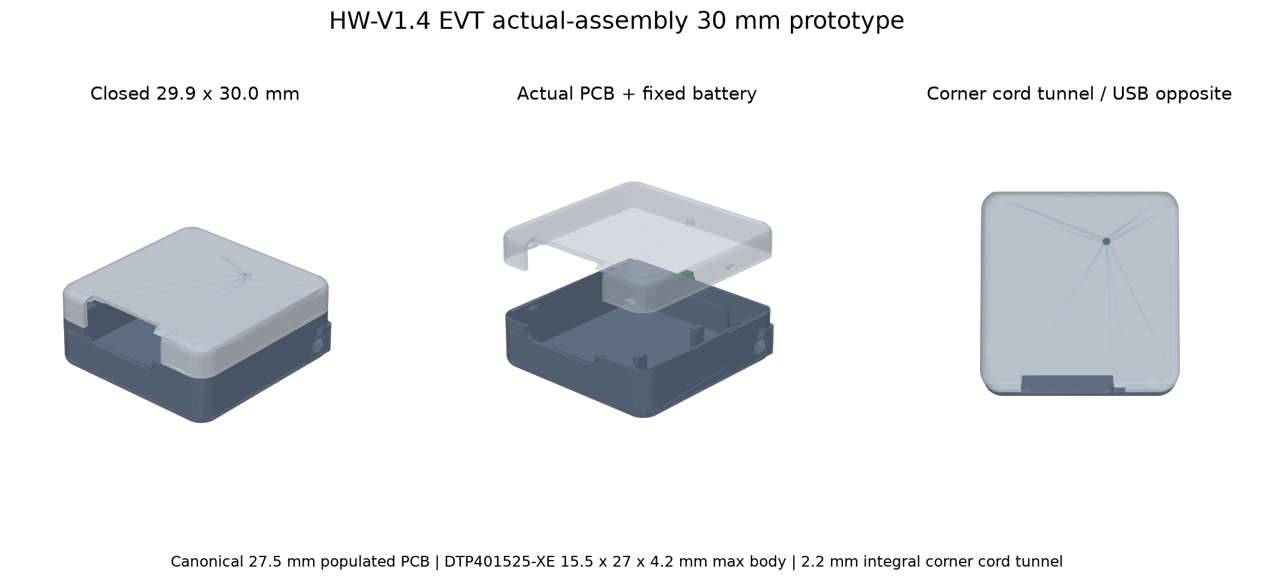
mechanical/xe-minimal/prototype-v1/actual-30mm-prototype/actual-30mm-prototype-preview.png
