nyanko3141592/pendant-recorder/mechanical/xe-minimal/prototype-v1/actual-fit-case-v3/case-v3-preview.png

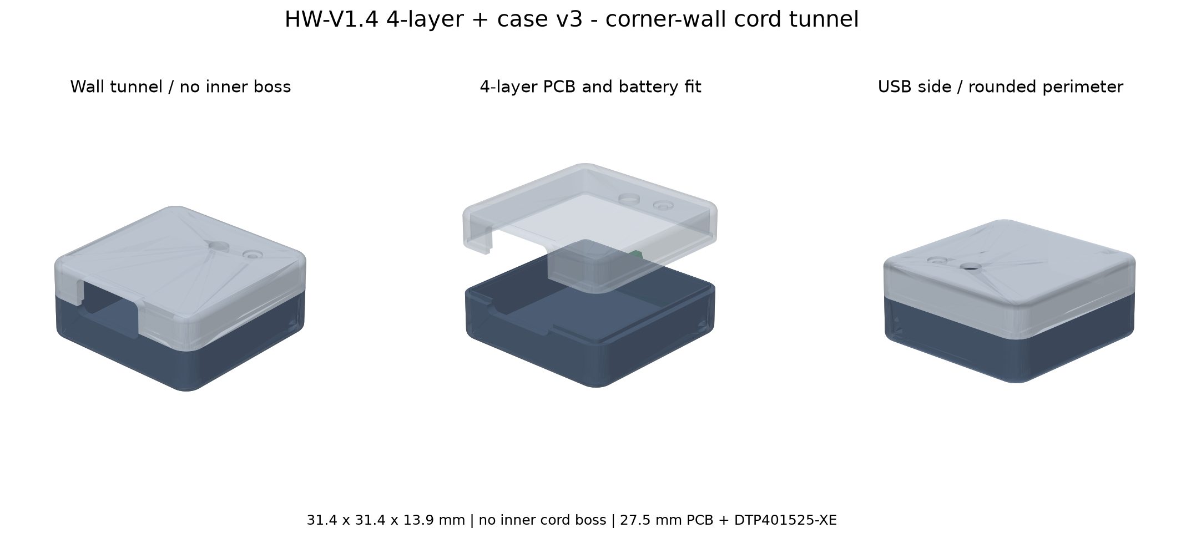
mechanical/xe-minimal/prototype-v1/actual-fit-case-v3/case-v3-preview.png
