nyanko3141592/pendant-recorder/mechanical/xe-minimal/prototype-v1/case-candidate-v1.png

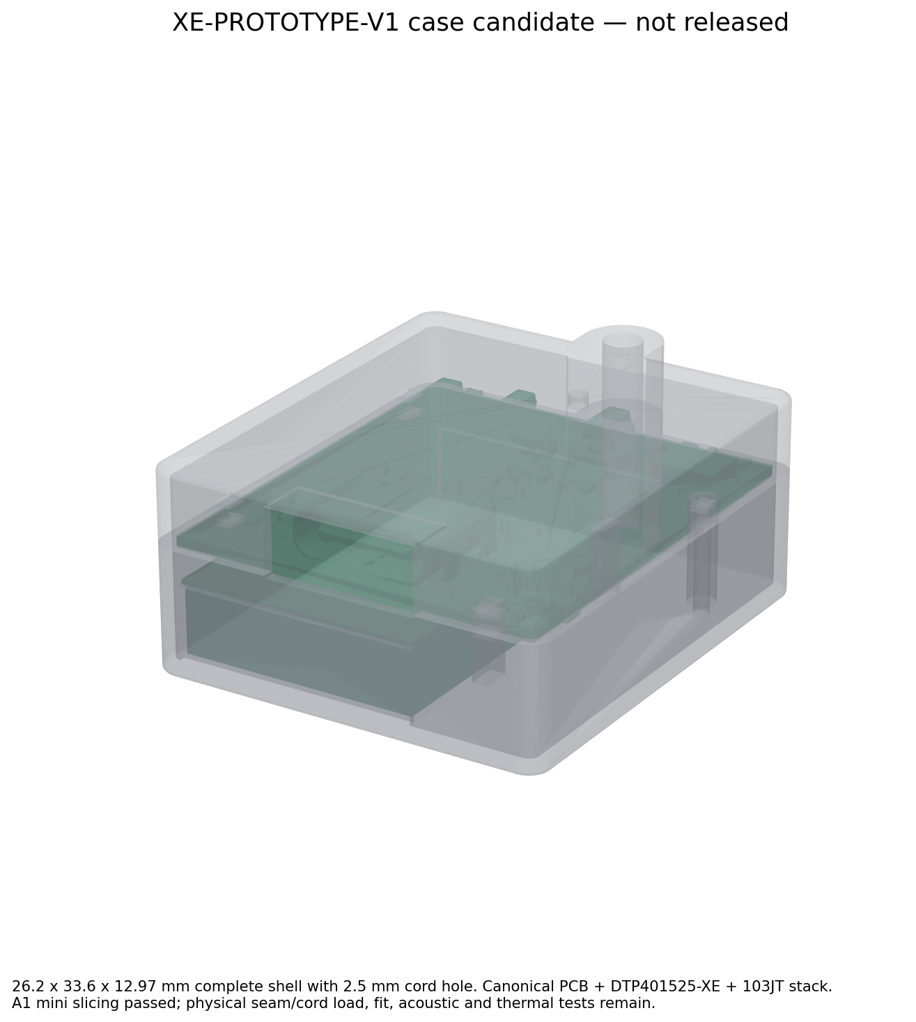
mechanical/xe-minimal/prototype-v1/case-candidate-v1.png
