nyanko3141592/pendant-recorder/mechanical/xe-minimal/prototype-v1/hw-v1.3-physical-mockup/hw-v1.3-physical-mockup-preview.png

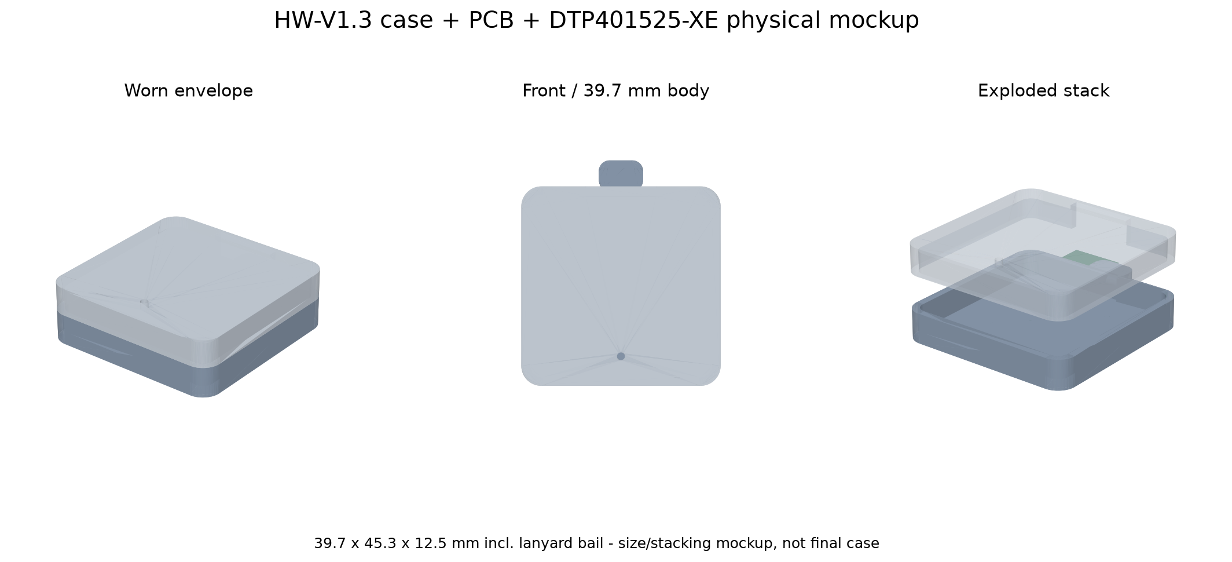
mechanical/xe-minimal/prototype-v1/hw-v1.3-physical-mockup/hw-v1.3-physical-mockup-preview.png
