nyanko3141592/pendant-recorder/mechanical/xe-minimal/prototype-v1/pcb-costdown-comparison-kit/pcb-size-comparison.png

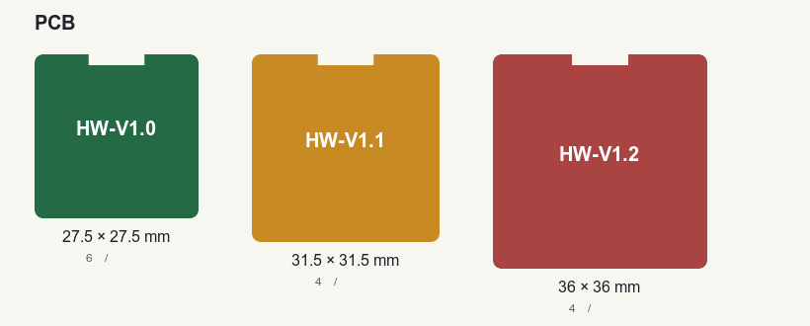
mechanical/xe-minimal/prototype-v1/pcb-costdown-comparison-kit/pcb-size-comparison.png
