nyanko3141592/pendant-recorder/mechanical/xe-minimal/prototype-v1/pebble-case-v2-review.png

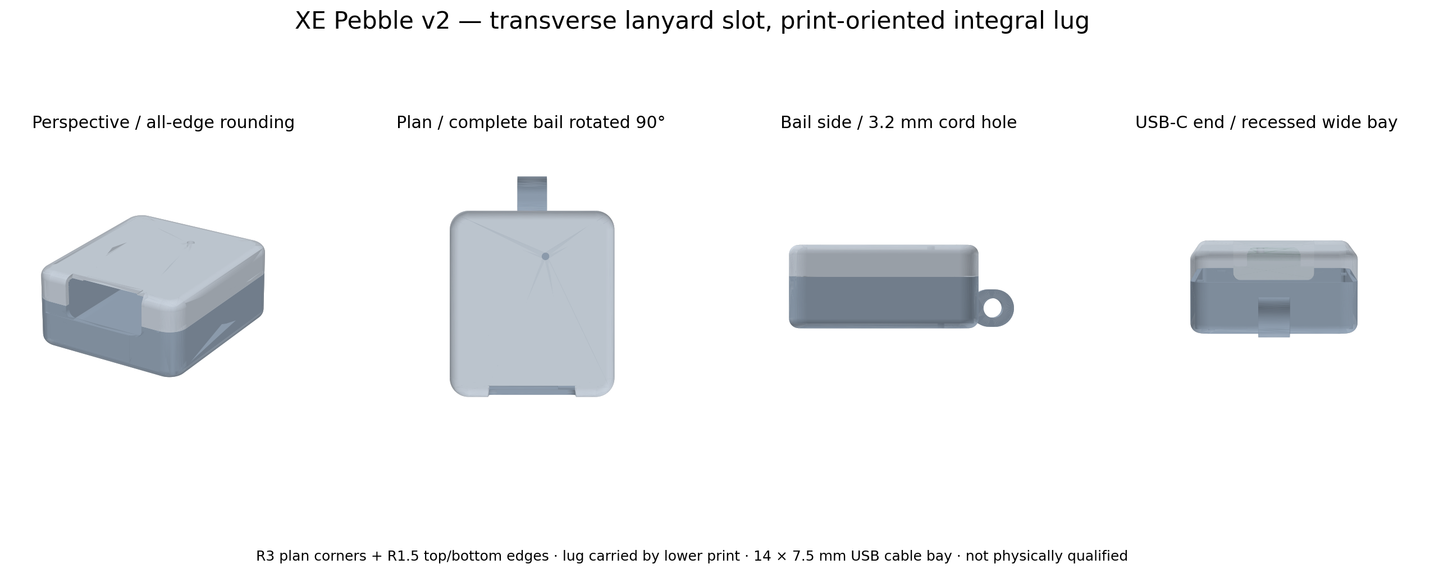
mechanical/xe-minimal/prototype-v1/pebble-case-v2-review.png
