nyanko3141592/pendant-recorder/mechanical/xe-minimal/prototype-v1/placement-compact-study/stack-comparison.png

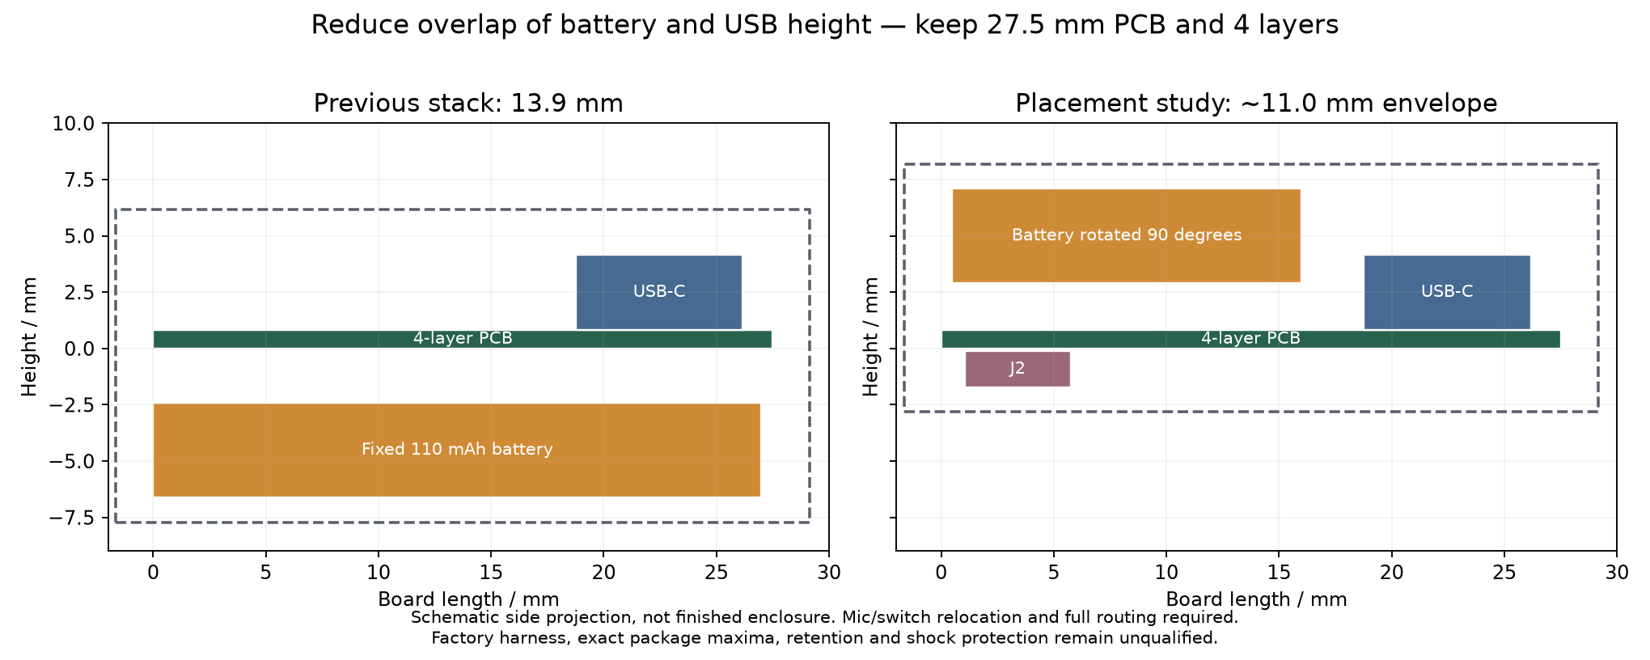
mechanical/xe-minimal/prototype-v1/placement-compact-study/stack-comparison.png
