nyanko3141592/pendant-recorder/mechanical/xe-minimal/prototype-v1/styled-case-comparison.png

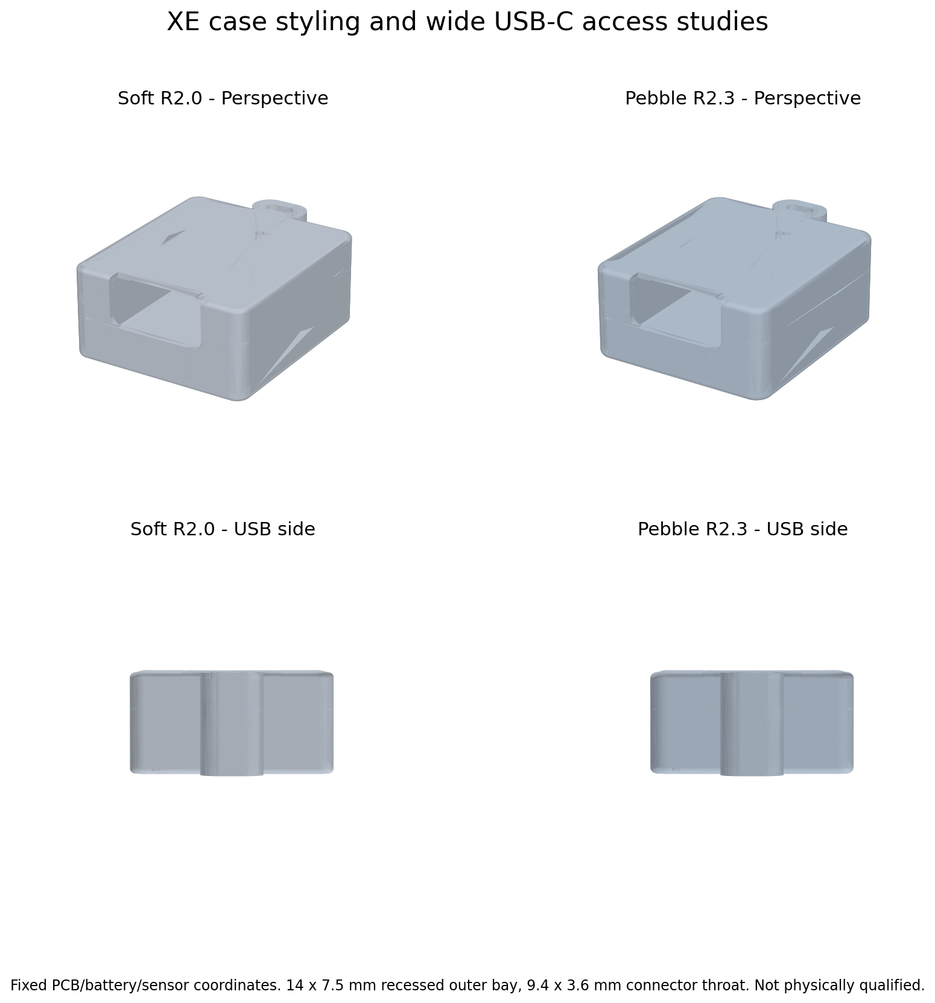
mechanical/xe-minimal/prototype-v1/styled-case-comparison.png
