nyanko3141592/pendant-recorder/mechanical/xe-minimal/rounded-glue-exterior-review.png

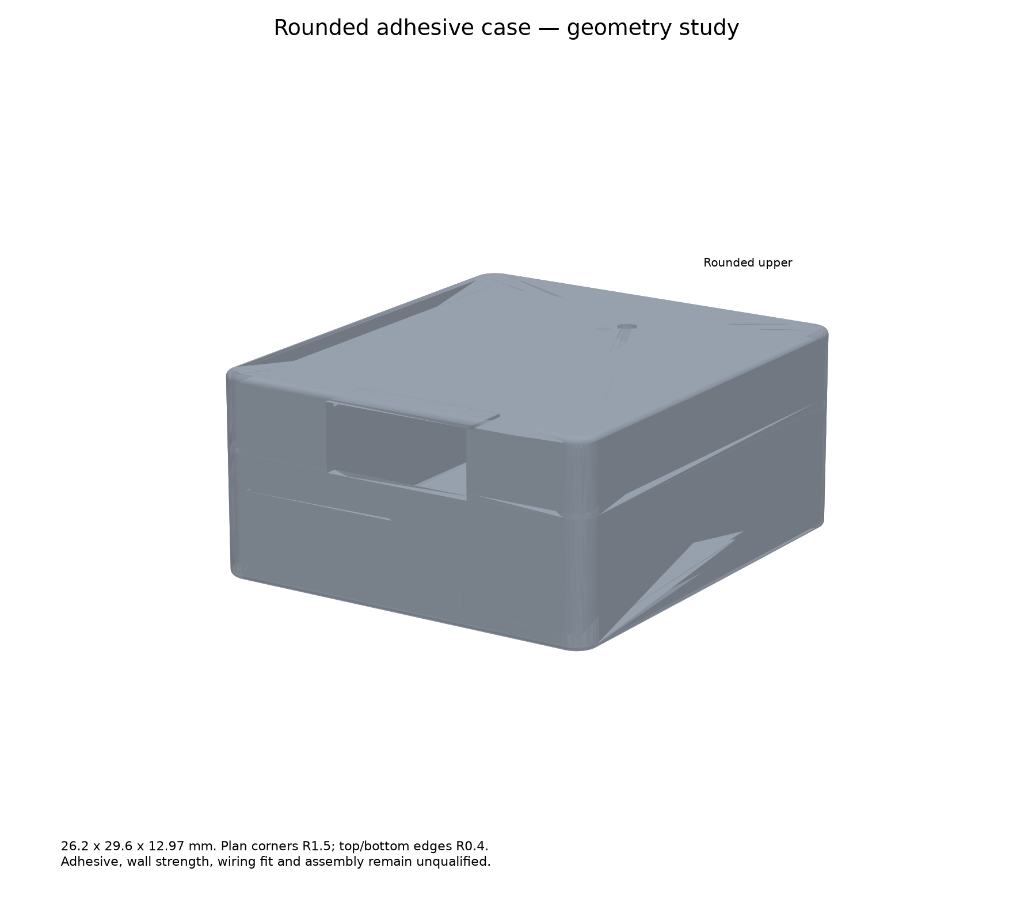
mechanical/xe-minimal/rounded-glue-exterior-review.png
