nyanko3141592/pendant-recorder/mechanical/xe-minimal/tab-clearance-stack-exploded-review.png

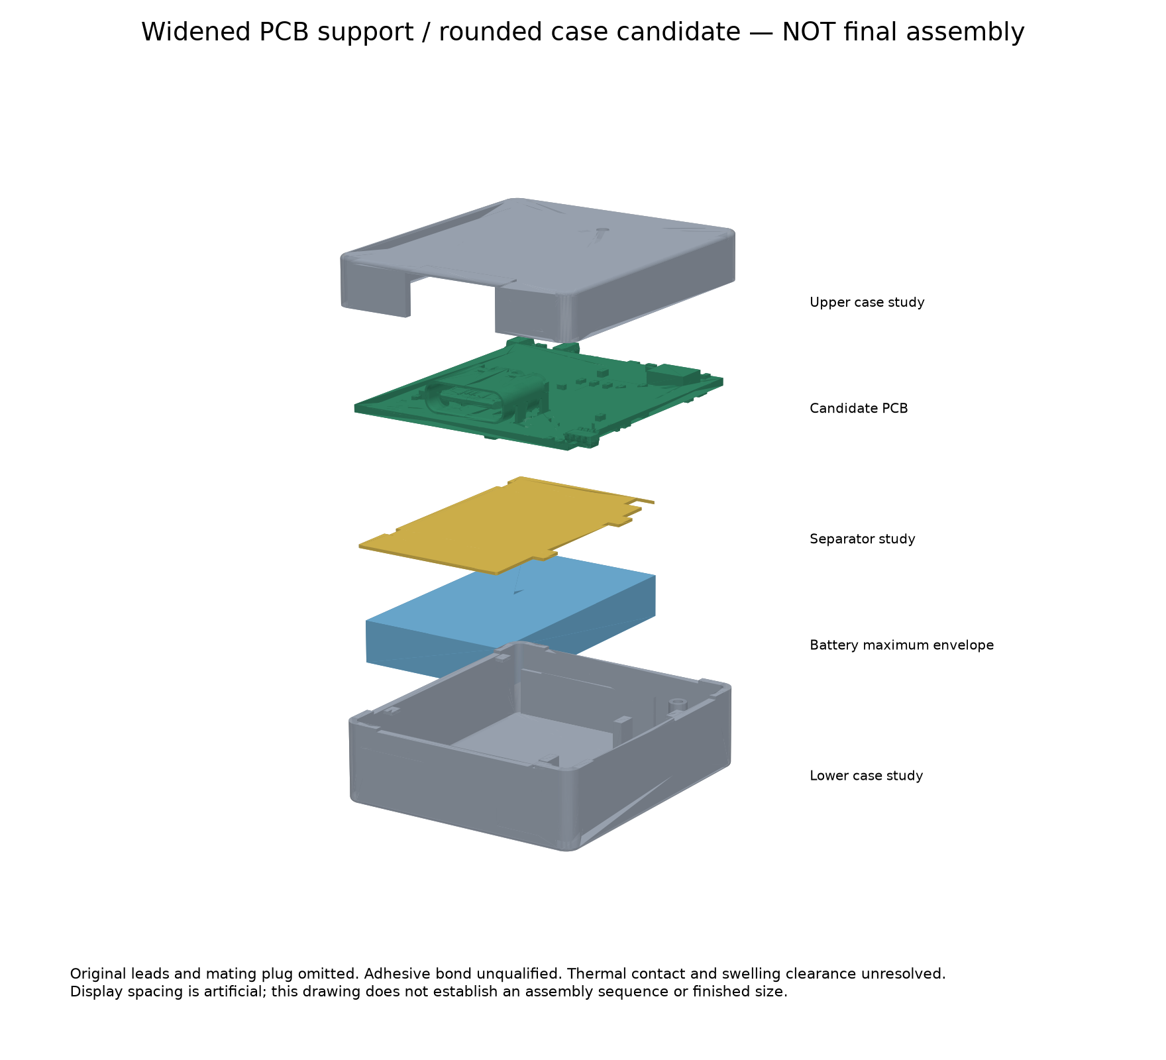
mechanical/xe-minimal/tab-clearance-stack-exploded-review.png
