nyanko3141592/pendant-recorder/mechanical/xe-minimal/thermal-reference-documents/semitec-jt.png

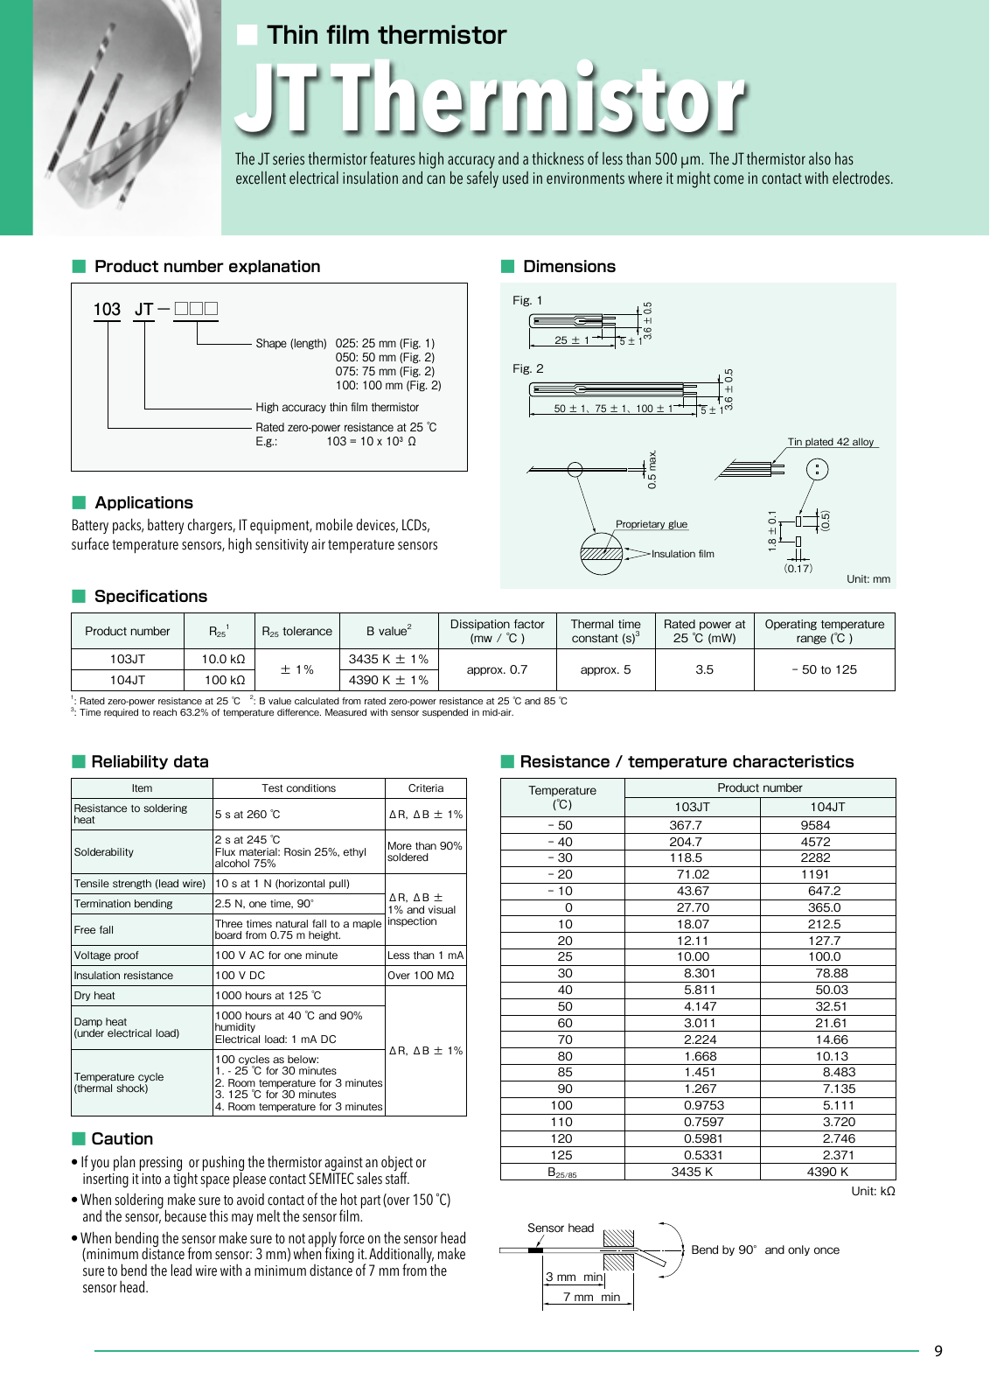
mechanical/xe-minimal/thermal-reference-documents/semitec-jt.png
