nyanko3141592/pendant-recorder/mechanical/xe-minimal/tmux-candidate-exploded-review.png

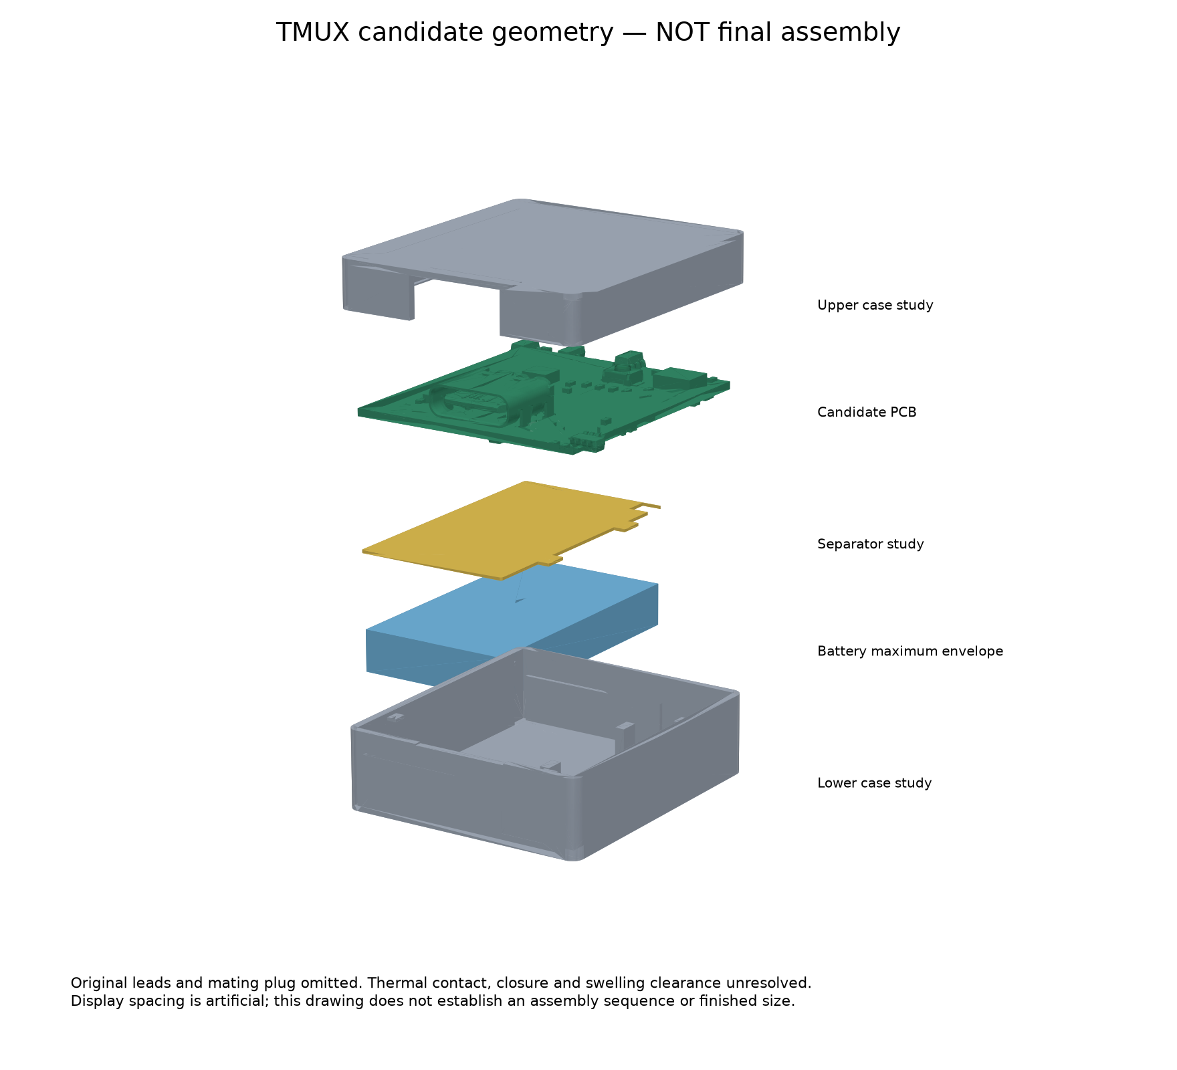
mechanical/xe-minimal/tmux-candidate-exploded-review.png
