nyanko3141592/pendant-recorder/docs/battery-sourcing.md

> **履歴調査。** 採用電池は現在DTP401525-XE 110mAhに固定済み。正本仕様は [`sourcing/dtp401525-xe-purchase-specification.json`](sourcing/dtp401525-xe-purchase-specification.json)。以下の候補順位、24時間、Rev A、採用未確定という記述は失効済み。

# 電池の調達から決める最小サイズ

> 最新優先（2026-10-24）: [小ささ最優先・16時間以上・USB-C・無線任意](decisions/0006-size-first-16h.md)。以下の24h必須/無線搭載必須は旧条件。圧縮音声36h保存、暗号化、有線取出し、無はんだ組立は維持。新MCU/電池/外形は未確定。

> Rev A1の20×34mm・21.8mA構成は履歴であり、現行製造入力へ使用しない。

調査日: 2026-10-24。最新指示に従い、既製の電池パックを先に絞り、連続24時間を実測で満たす最小の本体を設計する。外形24×24×14mm、基板21×21mmは固定条件から外す。特注セル・裸セルだけのカタログ値をv1の出発点にしない。

> 組立条件追記: 手元の手はんだゼロを優先。付属リード・PHコネクタを保持し、実装済み基板コネクタへ挿す。小型化のための電池リード加工を前提にしない。[実装方針](jlcpcb-assembly.md)。

## 結論

**第一候補はDATA POWER TECHNOLOGY DTP401525(PHR)、110mAh。** 国内で1個から販売され、メーカー完成パック図面・充放電条件が読める。小型化の基準はセルの15×25×4mmではなく、**保護回路込み最大15.5×27×4.2mm**。付属の100±3mmリードとJST PHR-2コネクタはこの本体寸法の外にある。

国内販売経路と仕様の確かさを含めての第一候補であり、市場全体で最小と証明したものではない。購入・取り置き・問い合わせ送信はしていない。

## 候補を絞った結果

| 優先 | 販売品 | 電池本体の寸法 mm | 調達状況（確認時点） | 判断 |
|---|---|---|---|---|
| 1 | DTP401525(PHR)、110mAh | 最大15.5×27×4.2、PCM込み、配線・コネクタ別 | 千石電商: 1個〜税込1,190円、秋葉原/大阪の在庫拠点表示。数量・出荷日は未確認 | 電気・寸法仕様が明確。配置と24時間試験の基準にする |
| 2 | Gexa GA-010、150mAh | 約20×25×4、本体。配線・コネクタ別 | ブランド公式通販: 在庫あり、税込1,540円、個数指定可 | 保護内蔵、1.25mmピッチ。ただし充電上限電圧・許容電流・寸法公差が未掲載。確認するまで採用しない |
| 保留 | 札幌貿易 kei-738、約80mAh | 販売題名12.6×24.8×3.7 | 国内販売経路あり | 関連販売説明で容量・寸法が異なる記載、USB5V入力の内部回路の扱いも要確認。裸の1Sパックとして扱えず、現回路には採用しない |
| 除外 | Adafruit 1570、100mAh | 11.5×31×3.8 | 公式在庫表示あり、$5.95。日本への単体配送未確認 | 長く、国内での調達確度も第一候補に劣る |
| 今回は除外 | Grepow GRP1654M1、150mAh | 裸セル16径×5.4 | メーカー仕様あり、少量の保護付き完成品の国内入手先は未確認 | 裸セルの小ささだけでケース寸法を確定しない |

スイッチサイエンスのDTP401525は再取得した現行ページで**販売終了**。SparkFun PRT-13853は同系統の比較品だが、DigiKeyでは航空便不可・陸送のみの表示があり、日本から直ちに買える代替ルートとは扱わない。千石の販売ページとメーカーPDFにも仕様差があるため、次の条件を優先する。在庫・価格は発注時に再確認する。

## 第一候補の確定できた条件

メーカー仕様書 E-SPE-0120-01 Ver2.0、2023-04-19、p4/p9を画像で確認。

- 公称/最小容量110mAh、定格3.7V、充電上限4.20V、最大連続放電110mA。
- 標準充電22mA、**最大連続充電55mA（0.5C）**。p2で上限改定を明記。販売ページの110mAを採用しない。
- 現回路の50mA設定は上限に近い。充電IC係数・抵抗公差・温度を含めた最大値が55mA以下か確認するまで充電設計を確定しない。標準22mA付近への変更も比較する。現回路の抵抗値はまだ変更していない。
- 仕様書の容量測定終止電圧は2.4V、販売ページには2.8Vの記載差。本体は3.0V LDOとSD電圧条件に制約されるので2.4Vまで公称容量を使えるとは計算しない。
- 保護回路はパック内蔵。2線式でNTC端子なし。温度検知は外付けNTCをセルへ密着させる既存方針。
- JST PHという呼び名だけで極性を決めない。受入時に電圧・極性を確認し、基板のコネクタピンを合わせる。

## 24時間の判定

暫定使用可能率70%で、110×0.70÷24=**3.21mA以下**が24時間の条件。電池端平均2.0mAなら計算上38.5時間、3.0mAなら25.7時間。使用可能率は仮定であり、24時間達成の保証ではない。全表示灯、SD内部busy、LDO、保護回路を含めて測定する。

80mAhを使えるのは平均2.33mA以下という計算条件に加え、正確なパック仕様・国内調達・終止電圧での実容量が確認できた場合に限る。小さいが仕様不明の電池へ先に合わせない。150mAhへ増量する前に110mAhでの24時間検証を行う。

## 電池から逆算した本体予算

第一候補は細長いパックなので、本体も角丸長方形を検討する。**20×32×12mmを攻める配置枠**とし、コネクタ・配線を無理なく収めるため22×33×13mm程度までの比較枠も用意する。これは成立確認前の予算で、最小サイズの確約ではない。USB-C、発光窓、マイク音響経路、ボタン、紐穴を含めて決定する。

- 壁厚1.2mmなら20×32mm外形の内側は17.6×29.6mm。15.5×27mmパックに対し左右合計2.1mm、上下合計2.6mmしか余らず、角R・配線引出し・固定部によっては成立しない。
- PCBの配置検討枠は約17×28mm。電池と重ねる。旧21×21mmに固定せず、部品・配線・四隅のクリアランスから変更する。現LQFP64回路の配置成立は未確認。
- 厚さ予算: 壁上下2.4＋電池4.2＋基板0.8＋両面部品合計3.0＋絶縁/組立余裕1.0=11.4mm（部品高等は仮）。12mmは残り0.6mmだけで、電池膨張、NTC、コネクタや重なりが必要なら厚くする。
- **付属100mmリードとPHコネクタは省略せず3D配置する。** 電池本体へ直接はんだ付けしたり、保護基板や外装を剥いだりして収めない。短いリードの既製バリエーションが入手できれば別候補として扱うが、未確認のカスタム供給を前提にしない。
- 20×32×12mmの直方体包絡体積は7.68cm³で、旧Omi基準の直径25.5×15mm円柱約7.66cm³と近い。幅は狭く、長さは伸びる。角丸分・紐部は別。小ささは容積だけでなく厚さと装着感でも比較する。

## 採用を確定する順序

1. DTP401525(PHR)の現行販売ロットがVer2.0図面と一致するか、単品在庫・同一仕様の再購入性を確認する。現時点は公開情報まで。
2. 実パックの外形・極性・配線とコネクタ寸法を測り、基板と立体配置する。データシートにない膨張余裕は供給元条件を確認する。
3. 充電電流上限の公差確認、USB時の負荷分離、NTC、SDピーク負荷時の電圧を検証する。
4. 電池端電流と24時間の連続音声ファイルを実機で確認し、そのパックで成立する最小の外形へケースを詰める。

この段階では回路・PCBの製造データを確定しない。パック調達前の寸法だけを最小サイズの実績として扱わない。

## 出典

- 千石電商（販売・在庫拠点・価格）: https://www.sengoku.co.jp/mod/sgk_cart/detail.php?code=EEHD-53KN
- Data Powerメーカー仕様書（千石配布、Ver2.0、p2/p4/p9）: https://www.sengoku.co.jp/item/pdf/SPE-DTP401525%28PHR%29-3.7V-110mAh-en-2.0ver.pdf
- スイッチサイエンス（販売終了）: https://www.switch-science.com/products/3166/
- Gexa公式（在庫・パック仕様）: https://www.onsquare.info/SHOP/1010005459ga0100.html
- 札幌貿易: https://store.shopping.yahoo.co.jp/sapporo-boueki/kei-738.html / 比較説明の差: https://store.shopping.yahoo.co.jp/sapporo-boueki/kei-722.html
- Adafruit: https://www.adafruit.com/product/1570
- DigiKey（輸送制限）: https://www.digikey.com/en/products/detail/sparkfun-electronics/PRT-13853/6605197
- Grepow: https://www.grepow.com/button-cell-battery/grp1654.html
