nyanko3141592/pendant-recorder/docs/prototype-v1-order-decision.md

# XE-PROTOTYPE-V1 発注判断

Decision: **HOLD — アップロード、支払い、発注を行わない。**

## 現行の単一ベースライン

- PCBは27.5 × 27.5 mm、6層。ERC、DRC、未接続、回路図パリティは全0。
- JLC実装対象は68リファレンス。外付けTH1はなく、DTP401525-XEの内蔵10kΩ NTCをJ2から使用する。U14=NCP360SNT1Gの後段にU13=TPS2552DBVR-1を置き、50～100mA保証のラッチオフ入力制限を行う。
- 電池はDTP401525-XE 110mAh固定。JLC実装境界外なので、購入者が正確なコネクタ付き電池を別途調達して無加工で挿す。基板部品の支給、手はんだ、圧着、配線加工は不要。
- 現行CAMレビューは`hardware/xe-minimal/fabrication-review-d0c7ca1c4a31`。68部品、4 POFV、PTH 231穴・NPTH 3穴、USB-C固定スロット4箇所を照合済み。ZIP、アップロード用アーカイブは作成していない。
- 部品は表裏に実装されるためJLCPCB Standard PCBAが必要。公開最小寸法70 × 70 mmに対し、完成外形を変えずに1台ずつ外せる70 × 70 mm搬送キャリアを現行正本から生成した。キャリアDRC・未接続は0、逆移動後の回路・配線・ゾーン直列化比較は一致。旧版キャリアは正本不一致のため流用しない。
- ケースは`XE-PROTOTYPE-V1-CASE-PEBBLE-V4-PACK-NTC`。完成外形は約29.91 × 36.35 × 12.98 mm。PETG、0.16 mm、6 walls、40% gyroidでスライス成功したが、物理印刷と強度試験は未実施。
- ファームウェアは39本の非実機回帰試験に合格し、343ソースのハッシュを固定した。実基板動作ではない。

## 発注保留理由

1. NCP360SNT1Gの保証OVLO上限5.9 VからTPS2552DBVR-1の絶対最大7.0 Vまでは1.1 Vの余裕を確保した。ただし公称1.5 usの遮断時間は、必要な出力側1 uFを付けない条件の値である。6/9/12/20 V、0.1/1/10 V/usの全条件で、`/VBUS_OVP`と`/VBUS_CHARGER`のピーク実測値に測定不確かさを加えても推奨上限6.5 V未満、電流制限50～100mA、短絡時ラッチオフ、USB電源再投入まで復帰しないことを確認できていない。不合格時は免除せず回路を再設計する。
2. 68部品・36 MPN行すべての発注直前在庫、実装可否、置換、MOQ、attrition、正式見積りが未取得。
3. 6層stackupと4箇所のfilled/planarized/copper-capped POFVがJLC自動フローで受理されるか未確認。今回の条件ではアップロードや問い合わせを行わない。
4. 70 × 70 mm搬送キャリアのDFM受理、両面リフロー後の反り・タブ保持、業者側ルータ分割、分割後の27.5 ± 0.2 mm外形・0.15 mm以下のタブ残り・バリ／クラックなし・ケース再適合が未実施。
5. 製品用VID/PID、DTP401525-XE 5個の模擬負荷特性から選定する電池停止電圧、共通flashable EVT image、工場書込み受理、実pogo接触、flash verify、BOR4 readbackが未完了。停止電圧の物理根拠なしにはイメージ生成器が失敗し、生成後はその最終イメージで完成5台の16時間EVT Cを最初から実行する。
6. EVT A～Fはすべて`NOT_RUN`。安全性、110mAhでの16時間連続録音、30時間暗号化保存、三OS USB、ケース・紐耐久を実測していない。
7. DTP401525-XEはJLC側で一括調達・実装できず、購入者の別途調達が残る。

## 発注許可条件

`docs/validation/xe-current-five-unit-evt-plan.json`のA～Fすべてに、機体ID、版、計測器、原データパス、SHA-256、時刻、判定を記録して合格させる。さらに正本一致の搬送キャリア、全68部品・36 MPN行のライブ調達確認、工場書込み受理、JLC DFM受理、同一版ハッシュ確認を完了した時だけ発注判断を再生成する。

この文書は発注許可ではない。注文、支払い、製造データアップロード、業者連絡は行っていない。
