nyanko3141592/pendant-recorder/docs/compact-order-refinement.md

# A/B印刷と回路の発注準備 — 2026-10-25

発注不可。サイズ比較用STLは完成。配置改善版はERC/DRC/未接続/等価性が全て0。ただし充電温度適合を満たしておらず、製造用ではない。

## 印刷

`mechanical/compact-ab/print-size` にA 38×39×8.9mm、B 20×39×14.5mmのSTL/3MFとZIP、印刷説明を保存。mm・100%・広い面を下・サポート不要を想定。メッシュの閉鎖性、単一連結、面方向、体積、寸法、底面Z=0を機械確認した。実機印刷・全三角形自己交差検査は未実施。

中身を入れるケースではなく、首掛け時の大きさを比べる一体形状。重量・重心は再現しない。電池や基板を収納しない。外形は配置改良中も固定して比較基準にする。Google DriveへのSTL2点とZIP等の格納・一覧再読込を確認済み。

## XE固有資料で判明した差分

[メーカー仕様書（販売店掲載）](https://www.aska-elt.jp/wp-content/uploads/DTP401525-XE.pdf)、E-SPE-0307-01 Ver1.0を確認。PH版の数値をそのまま転用しない。p9完成図は最大15.5×27×4.2mm、リード15±3mm、Molex 781720003、1赤BAT+／2NTC／3黒GND。p4充電0〜45℃、最大連続110mA。標準充電の0.2Cと括弧内2mAは矛盾するため、22mAと無断で確定しない。p7 NTCは10K JOINSET 0603でB値・公差なし。現行ロット仕様、保護しきい値の記載も要照会。PDFは第三者資料のためリポジトリへ転載しない。

Aの現在の電池出口〜J2中心の直線概算約13.3mmに対しリード最短12mm。実端子の測定起点は未確認で、Aの無加工接続は保証できない。J2または電池の移動と実ハーネス確認が必要。Bも曲げ・張力・抜差し空間は未検証。

## 充電回路の変更条件

[BQ25101資料](https://www.ti.com/lit/ds/symlink/bq25101.pdf)のJEITA温度制御は45℃以上でも条件付き充電を継続するため、パックの0〜45℃条件と一致しない。現回路をそのまま製造へ出さない。

[BQ25170資料](https://www.ti.com/lit/ds/symlink/bq25170.pdf)を変更候補として評価。2×2mm WSON8でピン互換ではない。27kΩ VSETで4.2V、13.7kΩ ISETで約21.9mAを検討するが、50mA未満の追加RC推奨、終止電流、充電電圧公差、供給状況を未解決。直接NTC接続の公称0〜45℃だけで適合扱いしない。

`hardware/power-study/xe-charger/temperature_corners.py` は仮のNTC公差を用いた解析的感度計算。ICの上下限と組み合わせた結果は保証範囲から外れる。XEのB値を取得して内側にマージンを設け、NTC開放/短絡・電源投入時も含むハード停止を設計・検証する。回路置換はまだ実施していない。

`docs/sourcing/dtp401525-xe-inquiry.txt` に必要事項をまとめた未送信照会文を保存した。

## 発注解放条件

1. XE現行仕様とNTC曲線を取得し、全公差で許容充電温度・電圧・電流に収める。
2. 最終回路・PCBのERC/DRC/未接続/等価性を全て0にし、USB・水晶・電源帰路をレビューする。
3. 最終配置でA/B内部CADを更新し、実寸部品・最短リード・組立公差と無はんだ治具を確認する。
4. JLCへ最終BOM/CPL/積層/実装面/調達を照合し見積りを取得する。在庫確保は未実施。
5. 試作の検証手順・書込み経路を確定する。16h動作・録音・暗号化は実機合格前に保証しない。

過去のGerber照会ZIPを今回の製造ファイルとして流用しない。発注・支払い・照会送信は行っていない。

## 配置・配線の結果

`hardware/compact-b/electrical-placement-v3` に共通基板の改善試行を保存。18×33×0.8mm、6層、75部品を維持。最終KiCad ERC0・DRC0・未接続0・等価性0。0.10mm線幅/間隔を緩めず、R22付近の電源配線を0.06mm移動して最後のクリアランス違反を解消した。

C1〜C3のMCU供給端子までの直線距離は16〜18mm→約1.5mm、水晶負荷C11/C12は約14.1/10.5mm→1.6/1.7mm。帰路を含むループ長・信号品質は未検証。元のA/Bケース内部CADへはまだ反映していない。充電回路変更後に再配線・内部CAD再生成が必要。配線だけを長く回したv2は9違反/6未接続で不採用。
