nyanko3141592/pendant-recorder/docs/d1-order-gates.md

# D1/D2 発注までの残件

2026-10-24。**発注不可。** D1は円形基板の6層配線、D2は装着・固定を追加するケース試作設計。製造承認用ZIPは未発行。DFM-REVIEW-NOT-FOR-ORDER.zipは業者照会専用で、発注には使わない。

| 対象 | 現状 | 発注前の完了条件 |
|---|---|---|
| 配線 | 未接続0、DRC0、ERC0、回路図等価性0（2026-10-25） | 未接続0、未承認DRC0、電源/USB/水晶/マイク配線レビュー |
| 電池 | GRP1654M1裸セル150mAhが候補。完成パック未確定 | 保護回路・絶縁・完成SHハーネスを含む最大寸法、極性、少量購入条件の書面確定 |
| 実装 | 69実装部品すべてにカタログ品番候補、7接点群 | 全品番/代替品/フットプリント/実装方向、両面実装とパネル仕様をJLCで受理 |
| 筐体 | D25.5×14.5mm設計枠 | 実部品高さ・はんだ・電池膨らみ・ハーネス・嵌合公差を反映し干渉0 |
| 装着 | 内蔵紐通し、支持部、蓋固定、音道を検討 | 紐荷重/蓋保持/USB挿抜/落下/衣擦れ/音道の試作評価、仕上げと材料確定 |
| 組立 | 業者実装＋コネクタ接続の方針 | 完成電池・完成書込みケーブル・支持治具・接触材を購入だけで揃え、手はんだ0 |
| 電源/録音 | 算術見積りのみ | 電源回路レビューと試作の測定計画。16h連続録音は実測合格まで未達扱い |
| 製造出力 | DFM照会用Gerber/drill/BOM/CPLを生成。未リリース | 最終基板と同一ハッシュのGerber/drill/BOM/CPL、業者DFM、組立図、検査手順 |

発注前の机上レビューと、発注後の実機合格を区別する。16h稼働・録音品質・電源断復旧は最初の試作発注前に実証できないため、試験項目と合格条件を先に固定する。v1は販売完成品ではない。

## 電池メーカーへ渡す確認事項（未送信）

- 試作用5個を想定。GRP1654M1等、150mAh、3.7V公称/4.2V充電の完成保護パックを少量供給可能か。裸セル単体の寸法で回答しないこと。
- 保護基板、絶縁被覆、タブ、出線部、最大膨らみを含む寸法図/3D、容量試験条件、充放電電流と温度範囲、必要な輸送資料、MOQ/単価/納期。
- 工場で加工済みのJST SH 2ピン完成ハーネス。基板J2の1番BAT、2番GNDに一致する相手側極性図と現物確認を必須とする。線長・曲げ半径・出口方向は寸法図確定後に合わせる。
- 現CADのセル側予約はD17×6.1mm、別途横にPCM2.2×5.5×1.2mmと配線空間がある。**全体がD17内に入ると要求/保証したものではない**。供給可能な完成外形を先に示してもらい、ケースを確定する。
- 本体側NTCは絶縁熱伝導材で電池へ接触させる案。セル表面に接触可能な位置と被覆構造を確認し、応答試験を行う。充電保護を省略しない。

候補のメーカー一次情報：https://www.grepow.com/button-cell-battery/grp1654.html （2026-10-24確認、150mAh/16mm径/5.4mm厚は裸セルの掲載値）。完成パックがこの厚さになるという意味ではない。メーカーへの送信・発注・支払いは実施していない。

2026-10-25追記：充電ICの45〜60℃におけるJEITA動作と完成電池の許容条件、USBの専用GNDランド（長さ1.12mm）、6層0.8mm/0.35mmビア・0.15mm穴、部品の実効容量/水晶/USB配線品質をレビューする。[電気レビュー](d1-electrical-review.md)、[品番候補](../hardware/omi-fit-d1/sourcing-candidates.json)。照会文はdocs/sourcingに準備済み、送信未承認・未送信。

2026-10-25 費用・準備台帳追記: [発注準備台帳](procurement/preorder.md)、[5台試作の費用](procurement/cost.md)。正式見積り未取得、電池MOQ/加工費未確定。発注可否は引き続きfalse。
