nyanko3141592/pendant-recorder/docs/procurement/hw-v1-one-off-cost-target.md

# HW-V1.0 ワンオフ試作費用目標

これは正式見積りではない。1個だけ動作確認できればよい試作として、JLCPCB Standard PCBAで1枚だけ実装し、同一基板の未実装予備を最低製造数量として受け取る想定。

| 費目 | 予想 USD | 根拠・不確定点 |
|---|---:|---|
| 両面Standard PCBA固定費 | 139〜150 | setup 51.12、stencil 16.42、rigid fixture 16.42、36前後のfeeder 55.08、その他少額 |
| 1台分の既知電子部品（NAND以外） | 24〜35 | 現行5台分の実装数量算術から1台分へ換算。最低購入数量による上振れあり |
| 1GB NAND事前調達 | 5〜60 | MKDV8GIL-ASTの価格・MOQ未取得。最大の不確定要素 |
| 基板製造・POFV | 15〜80 | 70×70 mm carrier、特殊via工程。オンライン正式見積り未取得 |
| 電池・ケース・紐 | 10〜30 | DTP401525-XE、PETG印刷、breakaway cord |
| 送料・税 | 30〜70 | 配送方法と課税で変動 |
| **予想合計** | **223〜425** | **約3.4〜6.5万円（1 USD = 154円仮定）** |

## 判断

- 3〜4万円は不可能とは言えないが、上記レンジの最安側でのみ到達する。
- 現設計の安全回路、16時間録音、30時間保存、JLC実装完結は維持する。
- 価格を下げるための自己はんだ、自己ファーム書込み、POFV削除、片面再配置は採用していない。
- 1GB NANDの事前調達価格と基板特殊工程価格が判明するまで、4万円以内は保証しない。
- 注文、アップロード、支払い、業者連絡は実施していない。
