nyanko3141592/pendant-recorder/docs/procurement/xe-30mm-costdown-order-strategy-2026-10-28.md

# XE 30 mm基板 コストダウン・発注戦略

## 固定条件

- 完成ケース29.91 x 29.99 x 12.98 mmを拡大しない。
- DTP401525-XE、USB-C、16時間録音、安全回路、1 GB保存を維持する。
- ユーザーの微細部品はんだ、圧着、配線加工を要求しない。
- 注文、支払い、製造データのアップロード、業者連絡は本検討では行わない。

## 現行基板

- 27.5 x 27.5 mm、6層、両面実装。
- 74 footprints（F.Cu 23、B.Cu 51）。JLC実装対象は68 references、約36 MPN。
- 4箇所の0.15/0.35 mm hole-over-pad viaをfilled/capped POFVとして指定。
- Standard両面PCBAの既知固定費モデルは setup $51.12、stencil $16.42、
  fixtures $16.42、36 feeder loads $55.08、合計$139.04。接合・手はんだ
  代理費を含む部分実装算術は約$145～156で、部品・基板・送料・税は別。

## 製造方式の比較

| 案 | 固定実装費の目安 | 30 mm維持 | 新規部品/故障点 | 設計リスク | 判断 |
|---|---:|---|---|---|---|
| 現行1枚・Standard両面 | $145～156（部分実装算術） | 可 | なし | 最小 | 基準案 |
| 1枚・Economic両面 | 最低$9.71＋Extended fees＋handling | 可 | なし | 部品適格性 | 最優先で適格性確認 |
| 1枚・Standard片面 | 現行より概ね$40前後低下 | 未確認 | なし | 74点全面再配置・再配線 | ワンオフでは非推奨 |
| 2枚へ分割 | 2基板、複数design panel、接続部品分が増加 | 厚み方向も困難 | board-to-board/FPC追加 | 接触、電源、信号、組立 | 不採用 |

片面化はsetup/stencil差で約$33.77下がる一方、fixtureとfeederは残る。
27.5 mm角片面へ74点を集めるには、USB、PDMマイク、ボタン、電池コネクタの
機構位置を固定したまま残りを全面再配置する必要がある。節約額に対して再設計、
SI/PI、熱、音響、歩留まりの再認定が大きい。

分割案は片面実装できても、異種2基板のpanel fee、銅板・ステンシル面積、接続部品、
実装点数、検査点数が増える。ケース厚12.98 mm内では電池と2枚目基板の積層空間も
不足する。コスト、小型性、安全性の全てで現行1枚基板より不利。

## 採用戦略

**27.5 mm単板・両面実装を維持し、Economic適格化を第一経路、Standardを確実な
フォールバックとする。** 片面化・分割は採用しない。

### コストダウン順序

1. 現行36 MPNをJLC BOM toolでBasic / Preferred / Extended / Standard-onlyへ分類する。
2. MKDV8GIL-AST 1 GBを事前調達し、Standardフォールバックで確保する。同容量Economic
   候補は、単価が約$40かつ未認定なので安さ目的では置換しない。
3. 安全閾値、USB、クロック、音声、充電設定に関係しない受動部品だけを統合する。
   StandardではMPNを1種減らすごとにfeeder約$1.53削減。5～8種統合が現実的上限。
4. 4個のPOFVを個別にdogbone化する。単純一括移動はDRC違反済みのため、各net周辺を
   局所再配置し、DRC/ERC/parity/unconnectedとUSB/PDM/電源経路を毎回再検証する。
5. POFVを0にできた場合だけ、通常6層と4層の正式見積差を比較する。価格根拠なしに
   4層へ落とさない。
6. Economic不適格部品の置換総額がStandard固定費削減を上回る場合、Standardへ戻す。

## 発注シナリオ

### A: 最安候補

- 27.5 mm単板、両面Economic PCBA。
- 全電子部品をJLC実装。1 GB NANDはEconomic適格な同等品が電気・FW・耐久・消費電力を
  通過した場合のみ使用。
- 電池、ケース、紐のみ購入者が最終挿入。

### B: 確実性優先フォールバック

- 現行27.5 mm、6層、両面Standard PCBA。
- MKDV8GIL-ASTをJLC事前調達し、ユーザー支給・手はんだなし。
- 1台実装、同一製造ロットの未実装基板は最低製造数量として受領する想定。
- 現時点の完成品概算は$223～425（送料・税・電池・ケース込み、正式見積ではない）。

## 発注前ゲート

- BOM toolで全MPNの在庫、実装可否、Basic/Extended区分、最低購入数量を確認。
- Gerber/BOM/CPL viewerで両面、極性、pin 1、USB位置、外形27.5 mmを確認。
- 6層および4 POFVの自動DFM受理と価格を確認。
- 実装済み1台、予備基板、POFV/X-ray、プログラミングを含むlanded quoteを保存。
- ERC 0、DRC 0、parity 0、unconnected 0、版hash一致を再実行。
- 注文実行は、ユーザーが価格と上記未確認項目を確認した後に限る。

## 現時点の判断

片面化より現行両面のEconomic適格化の方が、30 mm、回路安全性、手離れを維持したまま
大きく下げられる可能性が高い。分割基板は安くならない。次の設計作業は受動部品統合と
4 POFVの局所dogbone化であり、片面全面再配置ではない。
