nyanko3141592/pendant-recorder/docs/procurement/xe-one-off-4layer-cost-2026-10-29.md

# XE 4層ワンオフ試作コスト再計算（2026-10-29）

正式quoteではなく、27.5 × 27.5 mm・4層・両面Standard PCBA候補の発注前予算。
注文、upload、支払い、業者連絡は未実施。1台実装でも基板製造の最低枚数分は発生する。

## 結論

| 費目 | 4層版 USD予算 | 6層旧予算との差 | 根拠・注意 |
|---|---:|---:|---|
| Standard両面PCBA固定・実装 | 145～157 | ほぼ同じ | 層数ではなく両面setup、stencil、fixtures、feederが支配 |
| 電子部品（1 GB NAND以外） | 24～35 | 同じ | 回路・部品表は変更していない |
| 1 GB NAND事前調達 | 5～60 | 同じ | MOQ・在庫・調達経路が最大の不確定要素 |
| 4層基板・通常貫通ビア・予備基板 | 2～15 | **13～65削減見込み** | 6層15～80ドル枠とPOFVを廃止。正式自動見積は未取得 |
| プログラミング・X-ray等 | 8～30 | 同じ | QFN等の検査範囲で変動 |
| 送料・税 | 25～65 | ほぼ同じ | 配送方法と課税で変動 |
| **JLC関連小計** | **209～362** | **旧222～426から約13～64削減** | 項目連動あり。正式quoteで置換する |
| 電池、PETGケース、紐 | 10～30 | 同じ | JLC外 |
| **完成試作予算** | **219～392** | **約3.4～6.0万円** | 1 USD=154円の比較用仮定 |

現実的な支払目標は **$245～310（約3.8～4.8万円）**。4層化で削れるのは主に
基板製造と特殊ビアで、両面実装の固定費と部品費は残る。したがって総額が半額に
なる変更ではない。

## 公開料金を用いた固定費の確認

JLCPCBの2026-09-09公開Standard PCBA料金は、両面setup $51.12、両面stencil
$16.42、Standard feeder $1.53/種類、1～29枚の剛性基板fixture $16.42、X-ray
1～10個 $1.64/個など。現候補の部品種類数では、基板層数より両面実装固定費の
影響が大きい。

- https://jlcpcb.com/help/article/pcb-assembly-price
- https://jlcpcb.com/ads/pcb-prototype

## 4層化で成立済みの範囲

- 基板外形27.5 × 27.5 mm、厚さ0.8264 mm、全footprint pose、USB-C poseを維持。
- KiCad幾何DRC 0、未接続0、hole-over-pad via 0。
- Case V3は31.4 × 31.4 × 13.9 mmの外形を維持し、内部への紐ボス追加量0 mm³。
- USB差動対、電源幅、GND return/plane continuityは発注前の電気レビューが残る。
- ケース紐穴は実印刷後の引張・疲労試験が必要。計算やsliceだけで強度合格とはしない。
