nyanko3141592/pendant-recorder/docs/procurement/xe-one-off-prototype-cost-2026-10-29.md

# XE ワンオフ試作コスト（2026-10-29）

正式なJLC見積ではなく、現行27.5 mm・6層・両面Standard PCBAを1台だけ実装する
発注前予算。最低製造数量の未実装予備基板を含む想定。

| 費目 | USD予算 | 備考 |
|---|---:|---|
| Standard両面PCBA固定・実装作業 | 145～156 | setup、stencil、fixtures、36～43 feeder、接合代理費 |
| 電子部品（1 GB NAND以外） | 24～35 | 最低購入数量で上振れあり |
| MKDV8GIL-AST 1 GB事前調達 | 5～60 | 価格・MOQ・在庫が最大の不確定要素 |
| 6層基板・4 POFV・予備基板 | 15～80 | 自動DFM受理と正式価格は未確認 |
| プログラミング・検査 | 8～30 | 工数、X-ray、記録内容で変動 |
| JLC送料・税 | 25～65 | 配送・課税で変動 |
| **JLC関連小計** | **222～426** | 重複/連動項目があるため正式quoteで置換する |
| DTP401525-XE、PETGケース、紐 | 10～30 | JLC外で購入・印刷 |
| **完成試作予算** | **232～456** | 1 USD=154円仮定で約3.6～7.0万円 |

## 現実的な支払目標

- 目標：$260～325、約4.0～5.0万円。
- $350を超える場合：Economic適格性、NAND事前調達価格、POFV費、配送を再比較する。
- 安全回路削除、未実装部品、購入者の微細はんだで価格を下げない。

## 発注前にJLC画面で確定する項目

1. STM32U585CIU6、MKDV8GIL-AST、BQ25185、IM69D130の在庫・実装可否。
2. 6層、ENIG、0.15/0.35 mm filled/capped POFV 4箇所のDFM受理。
3. 両面68 placementsのBOM/CPL認識、極性、rotation、USB位置。
4. 1台実装、予備基板、プログラミング、X-ray、送料・税を含むlanded total。
5. 正式quoteが本書のレンジ外なら注文前に停止して差額理由を確認する。

注文、upload、支払い、業者連絡は実施していない。
