nyanko3141592/pendant-recorder/docs/procurement/cost.md

# D1.1 技術試作の費用

2026-10-25。**正式見積りは未取得。以下は5台試作の予算枠で、発注金額・上限保証ではない。** 完成電池のMOQ/初期費用が不明のため総額はまだ確定できない。

5台分の製作・送料・税等の予備枠は **約6.0万〜13.2万円**。初回の書込み・測定用品も新しく揃えるなら **約8.2万〜18.2万円** を仮置きする。これは量産原価や販売価格ではない。電池の専用加工費/MOQ超過、設計変更・再試作は別枠で、この範囲を超え得る。

## 5台分の積算（円）

為替は相場ではなく予算計算専用に **1 USD = 160円** と仮定。下表の「予算仮置き」は販売店の提示価格ではない。積算は `budget.json` と `calculate_budget.py` で再現できる。

| 費目 | 下側 | 上側 | 根拠/未確定条件 |
|---|---:|---:|---|
| 6層基板5枚・パネル加工 | 6,000 | 15,000 | 予算仮置き。0.8mm/微小穴/分割の正式見積りが必要 |
| 電子部品5台分・調達ロス枠 | 15,000 | 30,000 | 予算仮置き。69部品/台、37品種。全BOMの見積り未取得 |
| 両面PCBA初期費用・装填 | 19,864 | 19,864 | 公開料金による参考計算。最終課金ではない |
| 実装従量・X線・治具等の追加枠 | 4,000 | 12,000 | 予算仮置き。対象数、実装方法、治具数未確定 |
| 完成保護電池5個 | 5,000 | 15,000 | 予算仮置き。5個購入可を仮定。MOQ/初期加工費は除外 |
| ケース5組・紐・絶縁/音道/固定材 | 5,000 | 15,000 | 予算仮置き。材料/公差/購入品未確定 |
| 複数業者送料・税等予備枠 | 5,000 | 25,000 | 見積りではない。電池輸送条件/配送先/税は未確定 |
| **製作小計** | **59,864** | **131,864** | **1台換算11,973〜26,373円（初期費用配賦）** |

PCBA公開料金の計算: 両面setup $51.12 + 両面stencil $16.42 + 37品種 × feeder $1.53 = $124.15 = 19,864円。BOMの37品種を各1装填と仮定し、表裏・工程の扱いは業者確認待ち。X線等は追加枠に含め、無料とはみなさない。[JLC公式料金表](https://jlcpcb.com/help/article/pcb-assembly-price)（2026-10-25閲覧）。

## 初回だけの道具（5台製作費とは分離）

| 費目 | 下側 | 上側 | 根拠 |
|---|---:|---:|---|
| Tag-Connect TC2030-CTX-NL-STDC14 | 6,880 | 6,880 | メーカー掲載$43。送料別、予算為替換算 |
| STLINK-V3MINIE候補 | 4,165 | 4,165 | ST掲載$26.03を円単位切上げ。最終嵌合/付属品確認前 |
| 支持治具・完成測定ハーネス・USBケーブル | 3,000 | 10,000 | 予算仮置き。購入セット未確定、手はんだで代用しない |
| 電流測定器・電流制限電源等 | 8,000 | 25,000 | 予算仮置き。既有品なら重複購入不要。機種未確定 |
| 道具の送料等予備枠 | 0 | 4,000 | 予算仮置き |
| **道具小計** | **22,045** | **50,045** | 全て新規購入する場合 |
| **初回合計** | **81,909** | **181,909** | 電池NRE/MOQ増分、再試作を除く |

価格の一次情報: [Tag-Connect](https://www.tag-connect.com/product/tc2030-ctx-nl-stdc14-for-use-with-stm32-processors-with-stlink-v3)、[ST公式ストア](https://estore.st.com/en/products/development-tools/hardware-development-tools/hardware-debugger-and-programmer-tools-for-stm32/stlink-v3minie.html)（2026-10-25閲覧）。価格掲載は互換性・国内配送・在庫確保の証明ではない。

## 見積りで必ず分けてもらう項目

5台/10台それぞれの基板、部品、部品余剰/ロス、実装初期費用、装填、ステンシル、治具/パネル、X線、調達手数料、送料、納期。電池は完成パックの単価に加えMOQ、加工初期費用、輸送費。ケースは上下1組の費用と最低注文額を分ける。

最初は5台を基準にする。10台へ増やす判断は追加5台の実費とMOQ回答が出てから行う。小型化のための6層化や両面実装を価格だけで無断変更しない。
