nyanko3141592/pendant-recorder/hardware/rounded-fit-v7/quotation/jlc-bom-match.txt

Browser tab: 174550528, Title: "PCB Prototype & PCB Fabrication Manufacturer - JLCPCB", URL: "https://cart.jlcpcb.com/smt-order/?pcbFileNo=37eb154efd2b4a8f9535f1477972cb45".
There has been no change in the accessibility tree.
The focused UI element is 0 AXWebArea PCB Prototype & PCB Fabrication Manufacturer - JLCPCB, URL: cart.jlcpcb.com/smt-order/?pcbFileNo=37eb154efd2b4a8f9535f1477972cb45
