nyanko3141592/pendant-recorder/docs/procurement/xe-purchase-quantity-review.csv

MPN | Side | References | Installed for 5 | Assembly attrition (unknown) | Assembly minimum (unknown) | Purchase quantity (unknown)
781710003 | B | J2 | 5
APHHS1005LSYCK/J3-PF | F | D6 | 5
BQ25185DLHR | B | U3 | 5
CC0402JRNPO9BN500 | B | C30 | 5
CC0402KRX5R6BB105 | B | C25 C7 | 10
CC0402KRX5R6BB105 | F | C16 | 5
CC0402KRX5R6BB225 | B | C13 C14 | 10
CC0402KRX7R7BB104 | B | C1 C2 C26 C3 C32 C6 C9 | 35
CC0402KRX7R7BB104 | F | C22 C29 C33 | 15
CC0402KRX7R9BB103 | F | C28 | 5
CC0603KRX5R6BB106 | B | C15 C4 | 10
CC0603KRX5R6BB475 | B | C27 C5 | 10
CL05A105KP5NNNC | F | C31 | 5
CSNP32GCR01-BOW | B | U11 | 5
DMN2056U-7 | B | Q6 | 5
DMN2056U-7 | F | Q7 | 5
DMN63D8L-7 | B | Q3 Q4 | 10
ERJ2RKF1303X | B | R42 | 5
IM69D130V01XTSA1 | F | U8 | 5
NCU18XH103F60RB | B | TH1 | 5
RC0402FR-07100KL | B | R13 R15 R22 R3 R36 R37 R38 R40 R49 | 45
RC0402FR-07100KL | F | R12 R50 | 10
RC0402FR-0710KL | B | R35 | 5
RC0402FR-0710KL | F | R2 R47 R48 | 15
RC0402FR-071ML | B | R14 | 5
RC0402FR-071ML | F | R33 R34 | 10
RC0402FR-0720KL | B | R11 R39 | 10
RC0402FR-0722RL | B | R21 R23 | 10
RC0402FR-0747KL | B | R28 | 5
RC0402FR-0747KL | F | R24 R25 | 10
RC0402FR-074K7L | B | R43 | 5
RC0402FR-075K1L | B | R6 R7 | 10
RC0402FR-076K8L | B | R10 | 5
RC0402FR-076K8L | F | R32 | 5
RC0402FR-077K5L | B | R41 | 5
RC0402JR-070RL | B | R1 | 5
SN74HCS74DYYR | B | U14 | 5
STM32U535CEU6 | B | U1 | 5
TLV7042DDFR | B | U12 | 5
TLV803EB29DBZR | F | U15 | 5
TNPW040219K1BEED | F | R44 | 5
TPS22916CYFPR | B | U10 | 5
TPS22950YBHR | F | U13 | 5
TPS7A0233PDBVR | F | U4 | 5
USB4105-GF-A | F | J1 | 5
USBLC6-2P6 | B | U2 | 5
