nyanko3141592/pendant-recorder/outputs/prototype-v1-order-readiness/prototype-v1-procurement-estimate-2026-10-28.xlsx

Sheet: Summary
Prototype v1 発注準備・概算（5台）
基準日 | 2026-10-28T00:00:00.000Z
台数 | 5
実装点/台 | 75
BOM品種 | 39
USD/JPY（編集可） | 155.00
消費税率（編集可） | 10.0%
判定 | 見積アップロード可能／決済前にDFM・実装プレビュー確認必須
区分 | 通貨 | 下限 | 上限 | 円換算（採用値） | 根拠・注意
部品（既知価格のみ） | JPY |  |  | 34151.70 | 旧参照価格＋2026-10-28再確認値。未価格行は0円扱い
JLC実装費（公開料率モデル） | USD | 151.54 | 163.78 | 24437.30 | JLC公開料率による151.54–163.78 USD。正式見積ではない
PCB製造・特殊ビア（ライブ解析） | USD | 103.81 | 103.81 | 16090.55 | Gerber解析済: 6層27×24mm、0.8mm、ENIG、0.15mmビア、エポキシ充填＋銅キャップ、JLC06081H-2116
JLC部品最低数量・不足品手配 | USD | 0.00 | 0.00 | 0.00 | 在庫、部品購入最小数、損耗、支給受入費用を見積時に反映
送料（ライブ表示） | USD | 9.75 | 9.75 | 1511.25 | UPS Worldwide Express Saver表示。配送先ログイン後に再確認
小計（税抜） | JPY |  |  | 76190.80 | 未入力費用を含まない
税込総額 | JPY |  |  | 83809.88 | 暫定。発注総額ではない
発注前ゲート
1 | JLC CAM/DFM | 指定14ビア（うちパッド重複13）の充填・平坦化・銅キャップを製造確認 | 未完
2 | BOM/CPL | 75実装点、Bottom反転、回転、Pin 1をプレビューで確認 | 未完
3 | 部品 | 支給・事前購入対象の受入可否と余剰数量を確定 | 未完
4 | 実機 | 初回ケース印刷、USB-C干渉、極性、吊下げ荷重を確認 | 未完

Sheet: BOM detail
Route | MPN | JLC/LCSC | References | Footprint | Qty/device | Qty/5 | Buy qty | Unit price | Currency | Line total JPY | Source | Status
JLC_STOCK_SMT | 781710003 | C564183 | J2 | Connector_Molex:Molex_Pico-EZmate_78171-0003_1x03-1MP_P1.20mm_Vertical | 1.00 | 5.00 | JLC quote | 68.00 | JPY | 340.00 | https://www.digikey.jp/ja/products/detail/molex/0781710003/2754172 | REFERENCE_PRICE_RECHECK_AT_CHECKOUT
JLC_STOCK_SMT | B3U-1000P |  | SW1 | Button_Switch_SMD:SW_SPST_B3U-1000P | 1.00 | 5.00 | JLC quote | 195.00 | JPY | 975.00 | https://www.digikey.jp/en/products/detail/aratas-formerly-omron-components/B3U-1000P/1534338 | REFERENCE_PRICE_RECHECK_AT_CHECKOUT
JLC_STOCK_SMT | BQ25185DLHR | C19725033 | U3 | Package_DFN_QFN:Texas_DLH0010A_WSON-10-1EP_2.2x2mm_P0.4mm_EP0.9x1.5mm | 1.00 | 5.00 | JLC quote | 422.00 | JPY | 2110.00 | https://www.digikey.jp/ja/products/detail/texas-instruments/BQ25185DLHR/21769368 | REFERENCE_PRICE_RECHECK_AT_CHECKOUT
JLC_STOCK_SMT | CC0402JRNPO9BN500 | C576707 | C30 | Capacitor_SMD:C_0402_1005Metric | 1.00 | 5.00 | JLC quote | 17.00 | JPY | 85.00 | https://www.digikey.jp/ja/products/detail/yageo/CC0402JRNPO9BN500/11490475 | REFERENCE_PRICE_RECHECK_AT_CHECKOUT
JLC_STOCK_SMT | CC0402KRX5R6BB105 |  | C16 C25 C7 | Capacitor_SMD:C_0402_1005Metric | 3.00 | 15.00 | JLC quote | 17.70 | JPY | 265.50 | https://www.digikey.jp/ja/products/detail/yageo/CC0402KRX5R6BB105/2833604 | REFERENCE_PRICE_RECHECK_AT_CHECKOUT
JLC_STOCK_SMT | CC0402KRX5R6BB225 |  | C13 C14 | Capacitor_SMD:C_0402_1005Metric | 2.00 | 10.00 | JLC quote | 16.00 | JPY | 160.00 | https://www.digikey.jp/ja/products/detail/yageo/CC0402KRX5R6BB225/5195095 | REFERENCE_PRICE_RECHECK_AT_CHECKOUT
JLC_STOCK_SMT | CC0402KRX7R7BB104 |  | C1 C2 C22 C26 C29 C3 C32 C33 C6 C9 | Capacitor_SMD:C_0402_1005Metric | 10.00 | 50.00 | JLC quote | 4.62 | JPY | 231.00 | https://www.digikey.jp/ja/products/detail/yageo/CC0402KRX7R7BB104/2103122 | REFERENCE_PRICE_RECHECK_AT_CHECKOUT
JLC_STOCK_SMT | CC0402KRX7R9BB103 |  | C28 | Capacitor_SMD:C_0402_1005Metric | 1.00 | 5.00 | JLC quote | 16.00 | JPY | 80.00 | https://www.digikey.jp/ja/products/detail/yageo/CC0402KRX7R9BB103/2103087 | REFERENCE_PRICE_RECHECK_AT_CHECKOUT
JLC_STOCK_SMT | CC0603KRX5R6BB106 |  | C15 C4 | Capacitor_SMD:C_0603_1608Metric | 2.00 | 10.00 | JLC quote | 34.00 | JPY | 340.00 | https://www.digikey.jp/en/products/detail/yageo/CC0603KRX5R6BB106/5195191 | REFERENCE_PRICE_RECHECK_AT_CHECKOUT
JLC_STOCK_SMT | CC0603KRX5R6BB475 |  | C27 C5 | Capacitor_SMD:C_0603_1608Metric | 2.00 | 10.00 | JLC quote | 28.00 | JPY | 280.00 | https://www.digikey.jp/ja/products/detail/yageo/CC0603KRX5R6BB475/2833761 | REFERENCE_PRICE_RECHECK_AT_CHECKOUT
JLC_STOCK_SMT | CL05A105KP5NNNC | C14445 | C31 | Capacitor_SMD:C_0402_1005Metric | 1.00 | 5.00 | JLC quote |  | JPY |  |  | PRICE_FROM_JLC_QUOTE_REQUIRED
JLC_STOCK_SMT | CSNP32GCR01-BOW | C5440134 | U11 | Pendant:CSNP32GCR01_LGA8 | 1.00 | 5.00 | JLC quote |  | JPY |  |  | PRICE_FROM_JLC_QUOTE_REQUIRED
JLC_STOCK_SMT | DMN2056U-7 | C332302 | Q6 Q7 | Package_TO_SOT_SMD:SOT-23 | 2.00 | 10.00 | JLC quote |  | JPY |  |  | PRICE_FROM_JLC_QUOTE_REQUIRED
JLC_STOCK_SMT | DMN63D8L-7 | C338876 | Q3 Q4 | Package_TO_SOT_SMD:SOT-23 | 2.00 | 10.00 | JLC quote |  | JPY |  |  | PRICE_FROM_JLC_QUOTE_REQUIRED
JLC_STOCK_SMT | ERJ2RKF1303X |  | R42 | Resistor_SMD:R_0402_1005Metric | 1.00 | 5.00 | JLC quote | 16.00 | JPY | 80.00 | https://www.digikey.jp/en/products/detail/panasonic-industry/ERJ-2RKF1303X/194169 | REFERENCE_PRICE_RECHECK_AT_CHECKOUT
JLC_PREORDER_OR_MANUAL_MATCH | IM69D130V01XTSA1 | C9900015304 | U8 | Pendant:IM69D130_JLC_SMD_trial | 1.00 | 5.00 | JLC quote | 429.00 | JPY | 2145.00 | https://www.digikey.jp/en/products/detail/infineon-technologies/IM69D130V01XTSA1/IM69D130V01XTSA1CT-ND/8030734 | REFERENCE_PRICE_RECHECK_AT_CHECKOUT
JLC_PREORDER_OR_MANUAL_MATCH | MAX4995CAUT+T |  | U13 | Package_TO_SOT_SMD:SOT-23-6 | 1.00 | 5.00 | JLC quote | 1108.00 | JPY | 5540.00 | https://www.digikey.jp/ja/products/detail/analog-devices-inc-maxim-integrated/MAX4995CAUT-T/2137383 | REFERENCE_PRICE_RECHECK_AT_CHECKOUT
JLC_STOCK_SMT | NCU18XH103F60RB | C440252 | TH1 | Resistor_SMD:R_0603_1608Metric | 1.00 | 5.00 | JLC quote | 23.00 | JPY | 115.00 | https://jlcpcb.com/partdetail/NCU18XH103F60RB/C440252 | REFERENCE_PRICE_RECHECK_AT_CHECKOUT
JLC_STOCK_SMT | RC0201FR-07100KL |  | R13 | Resistor_SMD:R_0402_1005Metric | 1.00 | 5.00 | JLC quote |  | JPY |  |  | PRICE_FROM_JLC_QUOTE_REQUIRED
JLC_STOCK_SMT | RC0402FR-07100KL |  | R12 R15 R22 R3 R36 R37 R38 R4 R40 R49 R50 | Resistor_SMD:R_0402_1005Metric | 11.00 | 55.00 | JLC quote | 1.96 | JPY | 107.80 | https://www.digikey.jp/ja/products/detail/yageo/RC0402FR-07100KL/729473 | REFERENCE_PRICE_RECHECK_AT_CHECKOUT
JLC_STOCK_SMT | RC0402FR-0710KL |  | R2 R35 R47 R48 | Resistor_SMD:R_0402_1005Metric | 4.00 | 20.00 | JLC quote | 2.48 | JPY | 49.60 | https://www.digikey.jp/ja/products/detail/yageo/RC0402FR-0710KL/726523 | REFERENCE_PRICE_RECHECK_AT_CHECKOUT
JLC_STOCK_SMT | RC0402FR-071ML |  | R14 R33 R34 | Resistor_SMD:R_0402_1005Metric | 3.00 | 15.00 | JLC quote | 3.40 | JPY | 51.00 | https://www.digikey.jp/en/products/detail/yageo/RC0402FR-071ML/729462 | REFERENCE_PRICE_RECHECK_AT_CHECKOUT
JLC_STOCK_SMT | RC0402FR-0720KL |  | R11 R39 | Resistor_SMD:R_0402_1005Metric | 2.00 | 10.00 | JLC quote | 3.50 | JPY | 35.00 | https://www.digikey.jp/ja/products/detail/yageo/RC0402FR-0720KL/726557 | REFERENCE_PRICE_RECHECK_AT_CHECKOUT
JLC_STOCK_SMT | RC0402FR-0722RL |  | R21 R23 | Resistor_SMD:R_0402_1005Metric | 2.00 | 10.00 | JLC quote | 3.70 | JPY | 37.00 | https://www.digikey.jp/ja/products/detail/yageo/RC0402FR-0722RL/729509 | REFERENCE_PRICE_RECHECK_AT_CHECKOUT
JLC_STOCK_SMT | RC0402FR-0747KL |  | R24 R25 R28 | Resistor_SMD:R_0402_1005Metric | 3.00 | 15.00 | JLC quote | 2.52 | JPY | 37.80 | https://www.digikey.jp/en/products/detail/yageo/RC0402FR-0747KL/726616 | REFERENCE_PRICE_RECHECK_AT_CHECKOUT
JLC_STOCK_SMT | RC0402FR-074K7L | C105871 | R43 | Resistor_SMD:R_0402_1005Metric | 1.00 | 5.00 | JLC quote |  | JPY |  |  | PRICE_FROM_JLC_QUOTE_REQUIRED
JLC_STOCK_SMT | RC0402FR-075K1L |  | R6 R7 | Resistor_SMD:R_0402_1005Metric | 2.00 | 10.00 | JLC quote | 3.40 | JPY | 34.00 | https://www.digikey.jp/ja/products/detail/yageo/RC0402FR-075K1L/726624 | REFERENCE_PRICE_RECHECK_AT_CHECKOUT
JLC_STOCK_SMT | RC0402FR-076K8L |  | R10 | Resistor_SMD:R_0402_1005Metric | 1.00 | 5.00 | JLC quote | 3.60 | JPY | 18.00 | https://www.digikey.jp/ja/products/detail/yageo/RC0402FR-076K8L/726642 | REFERENCE_PRICE_RECHECK_AT_CHECKOUT
JLC_STOCK_SMT | RC0402FR-077K5L |  | R41 | Resistor_SMD:R_0402_1005Metric | 1.00 | 5.00 | JLC quote | 16.00 | JPY | 80.00 | https://www.digikey.jp/ja/products/detail/yageo/RC0402FR-077K5L/726655 | REFERENCE_PRICE_RECHECK_AT_CHECKOUT
JLC_STOCK_SMT | RC0402JR-070RL |  | R1 | Resistor_SMD:R_0402_1005Metric | 1.00 | 5.00 | JLC quote | 16.00 | JPY | 80.00 | https://www.digikey.jp/ja/products/detail/yageo/RC0402JR-070RL/726406 | REFERENCE_PRICE_RECHECK_AT_CHECKOUT
JLC_STOCK_SMT | SN74HCS74DYYR | C5212335 | U14 | Pendant_Input:Texas_DYY0014A | 1.00 | 5.00 | JLC quote | 49.00 | JPY | 245.00 | https://www.digikey.jp/en/products/detail/texas-instruments/SN74HCS74DYYR/16184246 | REFERENCE_PRICE_RECHECK_AT_CHECKOUT
JLC_PREORDER_OR_MANUAL_MATCH | STM32U535CEU6 | C22454224 | U1 | Package_DFN_QFN:QFN-48-1EP_7x7mm_P0.5mm_EP5.6x5.6mm | 1.00 | 5.00 | JLC quote | 1318.00 | JPY | 6590.00 | https://www.digikey.jp/ja/products/detail/stmicroelectronics/STM32U535CEU6/21348967 | REFERENCE_PRICE_RECHECK_AT_CHECKOUT
JLC_PREORDER_OR_MANUAL_MATCH | TLV7042DDFR | C2867856 | U12 | Package_TO_SOT_SMD:SOT-23-8 | 1.00 | 5.00 | JLC quote | 304.00 | JPY | 1520.00 | https://www.digikey.jp/ja/products/detail/texas-instruments/TLV7042DDFR/13173878 | REFERENCE_PRICE_RECHECK_AT_CHECKOUT
JLC_STOCK_SMT | TLV803EB29DBZR | C2869935 | U15 | Package_TO_SOT_SMD:SOT-23 | 1.00 | 5.00 | JLC quote | 82.00 | JPY | 410.00 | https://www.digikey.jp/ja/products/detail/texas-instruments/TLV803EB29DBZR/12352263 | REFERENCE_PRICE_RECHECK_AT_CHECKOUT
JLC_STOCK_SMT | TNPW040219K1BEED |  | R44 | Resistor_SMD:R_0402_1005Metric | 1.00 | 5.00 | JLC quote |  | JPY |  |  | PRICE_FROM_JLC_QUOTE_REQUIRED
JLC_STOCK_SMT | TPS22916CYFPR | C2680319 | U10 | Pendant:TPS22916_YFP4 | 1.00 | 5.00 | JLC quote | 91.00 | JPY | 455.00 | https://www.digikey.jp/ja/products/detail/texas-instruments/TPS22916CYFPR/8105767 | REFERENCE_PRICE_RECHECK_AT_CHECKOUT
JLC_STOCK_SMT | TPS7A0233PDBVR | C2887324 | U4 | Package_TO_SOT_SMD:SOT-23-5 | 1.00 | 5.00 | JLC quote | 137.00 | JPY | 685.00 | https://www.digikey.jp/ja/products/detail/texas-instruments/TPS7A0233PDBVR/12165099 | REFERENCE_PRICE_RECHECK_AT_CHECKOUT
JLC_PREORDER_OR_MANUAL_MATCH | USB4105-GF-A | C3020560 | J1 | PendantD1:USB_C_GCT_USB4105_GroundLand112 | 1.00 | 5.00 | JLC quote | 131.00 | JPY | 655.00 | https://www.digikey.jp/ja/products/detail/gct/USB4105-GF-A/11198441 | REFERENCE_PRICE_RECHECK_AT_CHECKOUT
JLC_STOCK_SMT | USBLC6-2P6 | C15999 | U2 | Package_TO_SOT_SMD:SOT-666 | 1.00 | 5.00 | JLC quote | 113.00 | JPY | 565.00 | https://www.digikey.jp/ja/products/detail/stmicroelectronics/USBLC6-2P6/1007440 | REFERENCE_PRICE_RECHECK_AT_CHECKOUT
DNP | DNP |  | D6 | LED_SMD:LED_0402_1005Metric | 0.00 | 0.00 | 0.00 | 0.00 | JPY | 0.00 |  | FIXED_INPUT_LIMIT_PROTOTYPE; LED OMITTED
DNP | DNP |  | Q5 | Package_TO_SOT_SMD:SOT-23 | 0.00 | 0.00 | 0.00 | 0.00 | JPY | 0.00 |  | FIXED_INPUT_LIMIT_PROTOTYPE; LED OMITTED
DNP | DNP |  | R32 | Resistor_SMD:R_0402_1005Metric | 0.00 | 0.00 | 0.00 | 0.00 | JPY | 0.00 |  | FIXED_INPUT_LIMIT_PROTOTYPE; LED OMITTED
DNP | DNP |  | R45 | Resistor_SMD:R_0402_1005Metric | 0.00 | 0.00 | 0.00 | 0.00 | JPY | 0.00 |  | FIXED_INPUT_LIMIT_PROTOTYPE; LED OMITTED
DNP | DNP |  | R46 | Resistor_SMD:R_0402_1005Metric | 0.00 | 0.00 | 0.00 | 0.00 | JPY | 0.00 |  | FIXED_INPUT_LIMIT_PROTOTYPE; LED OMITTED
BUYER_FINAL_ASSEMBLY | DTP401525-XE |  | BAT1 | 110mAh 3-wire pack | 1.00 | 5.00 | 5.00 | 1500.00 | JPY | 7500.00 |  | USER_SUPPLIED_PACK
BUYER_FINAL_ASSEMBLY | PEBBLE_CASE_V2 |  | CASE | printed enclosure | 1.00 | 5.00 | 5.00 | 150.00 | JPY | 750.00 |  | MATERIAL_ONLY_ESTIMATE; PRINT_LOCALLY
BUYER_FINAL_ASSEMBLY | CORD_2MM |  | CORD | 2 mm necklace cord | 1.00 | 5.00 | 5.00 | 300.00 | JPY | 1500.00 |  | ESTIMATE; CUT_LENGTH_AFTER_WEAR_TEST
