nyanko3141592/pendant-recorder/outputs/xe-canonical-local-review-v1/jlc-bom.csv

Comment | Designator | Footprint | LCSC Part #
STM32U585CIU6 | U1 | UFQFPN-48 | C5271026
IM69D130V01 | U8 | SMD-5P_4x3mm | C536262
MKDV8GIL-AST | U11 | LGA-8_6x8mm | C26159627
BQ25185DLHR | U3 | WSON-10 | C19725033
TPS7A0233PDBVR | U4 | SOT-23-5 | C2887324
TPS22917DBVT | U10 | SOT-23-6 | C2680344
TLV7042DDFR | U12 | SOT-23-8 | C2867856
USBLC6-2P6 | U2 | SOT-666 | C15999
DMN63D8L-7 | Q3,Q4 | SOT-23 | C338876
USB4105-GF-A | J1 | SMD_USB-C | C3020560
781710003 | J2 | SMD_3pin | C564183
B3U-1000P | SW1 | SMD_3x2.5mm | C231329
CC0402KRX7R7BB104 | C1,C2,C3,C6,C9,C22,C26,C29 | 0402 | C60474
CC0402KRX5R6BB105 | C7,C16,C25,C31,C32 | 0402 | C106254
TCC0402X5R225K160AT | C13,C14 | 0402 | C18164594
CC0603KRX5R6BB106 | C4,C15 | 0603 | C326057
HGC0603R7475K160NTHJ | C5,C27 | 0603 | C49333233
CC0402KRX7R9BB103 | C28 | 0402 | C60133
CC0402JRNPO9BN500 | C30 | 0402 | C576707
0402WGF0000TCE | R1 | 0402 | C17168
RC0402FR-0710KL | R2,R35 | 0402 | C60490
RC0402FR-07100KL | R3,R4,R12,R13,R15,R22,R36,R37,R38,R40 | 0402 | C60491
RC0402FR-071ML | R14,R33,R34 | 0402 | C138033
0402WGF220JTCE | R21,R23 | 0402 | C25092
RC0402FR-075K1L | R6,R7 | 0402 | C105872
RC0402FR-076K8L | R32 | 0402 | C93940
RC0402FR-0730KL | R10 | 0402 | C138008
RC0402FR-077K5L | R41 | 0402 | C137934
RC0402FR-0720KL | R11,R39 | 0402 | C93942
TPS2552DBVR-1 | U13 | SOT-23-6 | C140331
RC0402FR-07130KL | R42 | 0402 | C93946
RC0402FR-0747KL | R24,R25,R28 | 0402 | C93943
RC0402FR-074K7L | R43 | 0402 | C105871
TJ-S1005SW4TGLC9Y-A5 | D6 | 0402 | C273600
NCP360SNT1G | U14 | TSOP-5-1.5mm | C603707
GRT155R6YA105KE13D | C33 | 0402 | C6628588
