nyanko3141592/pendant-recorder/hardware/compact-a/bom.csv

Reference | Part/value | Footprint | Design note
U1 | STM32U535CEU6 | Package_DFN_QFN:QFN-48-1EP_7x7mm_P0.5mm_EP5.6x5.6mm | 512KB Flash/274KB RAM; non-SMPS UFQFPN48. PB3/PB4 ADF AF3; PA5/6/7 SPI1 AF5. VDD USB shared 3.3V. JLC acceptance and pin review pending.
C1 | 100n | Capacitor_SMD:C_0402_1005Metric
C4 | 10u | Capacitor_SMD:C_0603_1608Metric | Main bulk capacitor; check startup and effective capacitance.
C9 | 100n | Capacitor_SMD:C_0402_1005Metric
R2 | 10k | Resistor_SMD:R_0402_1005Metric
Y1 | 32.768kHz CL=7pF TBD | Crystal:Crystal_SMD_2012-2Pin_2.0x1.2mm
C11 | 10p tentative | Capacitor_SMD:C_0402_1005Metric
C12 | 10p tentative | Capacitor_SMD:C_0402_1005Metric
J3 | TC2030 SWD target pads | Connector:Tag-Connect_TC2030-IDC-NL_2x03_P1.27mm_Vertical | TC2030-NL/CTX standard; completed STM32-compatible probe/cable; access with battery disconnected.
SW1 | B3U-1000P (candidate) | Button_Switch_SMD:SW_SPST_B3U-1000P
R4 | 100k | Resistor_SMD:R_0402_1005Metric
R5 | 3.3k | Resistor_SMD:R_0402_1005Metric
D1 | red LED | LED_SMD:LED_0402_1005Metric
J1 | USB4105-GF-A (candidate) | PendantD1:USB_C_GCT_USB4105_GroundLand112 | Exact footprint and shield pad numbering pending connector selection
R6 | 5.1k 1% | Resistor_SMD:R_0402_1005Metric
R7 | 5.1k 1% | Resistor_SMD:R_0402_1005Metric
R8 | 0R tuning | Resistor_SMD:R_0402_1005Metric | STM32 integrated USB termination; external series value validate against ST USB layout guidance.
R9 | 0R tuning | Resistor_SMD:R_0402_1005Metric | STM32 integrated USB termination; external series value validate against ST USB layout guidance.
U2 | USBLC6-2P6 | Package_TO_SOT_SMD:SOT-666 | ST DS4260 same 6-pin function diagram; smaller package, LCSC C15999 catalog; orientation/land pattern final audit pending.
C13 | 2.2u 10V | Capacitor_SMD:C_0402_1005Metric
U3 | BQ25101YFPR | Pendant:BQ25101_YFP6 | BQ25101, 21.81mA nominal with 6.19k 1%; TS NTC must contact cell. Temperature/timeout validation pending.
R10 | 6.19k 1% | Resistor_SMD:R_0402_1005Metric | BQ25101 nominal 21.81mA; upper estimate 23.66mA. XE-specific specification lists 110mA max; standard-charge text is inconsistent (0.2C versus 2mA). Temperature compatibility FAIL; not released.
R11 | 100k | Resistor_SMD:R_0402_1005Metric
C14 | 2.2u | Capacitor_SMD:C_0402_1005Metric
J2 | 0781710003 / DTP401525-XE | Connector_Molex:Molex_Pico-EZmate_78171-0003_1x03-1MP_P1.20mm_Vertical | Completed battery: 1 BAT+, 2 NTC, 3 GND. Charger temperature compatibility unresolved. Factory assembly required.
Q2 | 2N7002 (charge inhibit) | Package_TO_SOT_SMD:SOT-23 | High disables charging by pulling TS low; USB suspend policy required
R12 | 100k | Resistor_SMD:R_0402_1005Metric
D2 | BAT54WS (candidate; leakage/forward drop review pending) | Diode_SMD:D_SOD-323 | USB path; characterize leakage and input inrush
Q1 | DMP2035U (candidate; power path review pending) | Package_TO_SOT_SMD:SOT-23 | S=SYS, D=BAT intentionally; body diode BAT -> SYS; exact MPN/pinout pending
R16 | 100k | Resistor_SMD:R_0402_1005Metric
C15 | 4.7u | Capacitor_SMD:C_0603_1608Metric
U4 | TPS7A0233PDBVR | Package_TO_SOT_SMD:SOT-23-5 | 3.3V main rail: 48-pin MCU has no separate USB supply; dropout/capacity measurement required.
U6 | TPS7A0218PDBVR | Package_TO_SOT_SMD:SOT-23-5 | DBV / SOT23-5 prototype; miniaturization later
C16 | 1u | Capacitor_SMD:C_0402_1005Metric
C18 | 1u | Capacitor_SMD:C_0402_1005Metric
C19 | 1u | Capacitor_SMD:C_0402_1005Metric
R17 | 100k | Resistor_SMD:R_0402_1005Metric
U8 | T5838 | Pendant:T5838_LGA7_BottomPort | BOTTOM port; 1.62..1.98V only; SELECT low = right channel
U9 | TXS0104ERUTR | Package_DFN_QFN:Texas_R-PUQFN-N12 | TI SCES651K Table 5-4 RUT pinout. UQFN procurement and PCBA acceptance pending.
R21 | 22R tentative | Resistor_SMD:R_0402_1005Metric
C22 | 100n | Capacitor_SMD:C_0402_1005Metric
C23 | 100n | Capacitor_SMD:C_0402_1005Metric
C24 | 100n | Capacitor_SMD:C_0402_1005Metric
U10 | TPS22916CYFPR | Pendant:TPS22916_YFP4 | Omi SD switch; power-off sequence must tristate ALL SD signals
R22 | 100k | Resistor_SMD:R_0402_1005Metric
C25 | 1u | Capacitor_SMD:C_0402_1005Metric
U11 | CSNP32GCR01-BOW | Pendant:CSNP32GCR01_LGA8 | SPI mode per manufacturer p2; unused DAT1/DAT2 reserved; verify power-up and interrupted-write behavior.
R23 | 22R tentative | Resistor_SMD:R_0402_1005Metric
R24 | 47k | Resistor_SMD:R_0402_1005Metric
R25 | 47k | Resistor_SMD:R_0402_1005Metric
R28 | 47k | Resistor_SMD:R_0402_1005Metric
C26 | 100n | Capacitor_SMD:C_0402_1005Metric
C27 | 22u effective TBD | Capacitor_SMD:C_0603_1608Metric
TP1 | TestPoint | TestPoint:TestPoint_Pad_D1.0mm
TP2 | TestPoint | TestPoint:TestPoint_Pad_D1.0mm
TP3 | TestPoint | TestPoint:TestPoint_Pad_D1.0mm
TP4 | TestPoint | TestPoint:TestPoint_Pad_D1.0mm
TP5 | TestPoint | TestPoint:TestPoint_Pad_D1.0mm
TP6 | TestPoint | TestPoint:TestPoint_Pad_D1.0mm
R32 | 6.8k tentative | Resistor_SMD:R_0402_1005Metric | LED current target 0.1-0.2mA; verify LED Vf, daylight readability and GPIO limits
D6 | amber LED 0402 TBD | LED_SMD:LED_0402_1005Metric | Battery level by blink count; shared charging/error indication; exact LED MPN pending.
C2 | 100n | Capacitor_SMD:C_0402_1005Metric
C3 | 100n | Capacitor_SMD:C_0402_1005Metric
C5 | 4.7u | Capacitor_SMD:C_0603_1608Metric
C6 | 100n | Capacitor_SMD:C_0402_1005Metric
C7 | 1u | Capacitor_SMD:C_0402_1005Metric
R1 | 0R | Resistor_SMD:R_0402_1005Metric
R3 | 100k | Resistor_SMD:R_0402_1005Metric
Q3 | 2N7002 (VBUS detect) | Package_TO_SOT_SMD:SOT-23
R13 | 100k | Resistor_SMD:R_0402_1005Metric
R14 | 1M | Resistor_SMD:R_0402_1005Metric
R15 | 100k | Resistor_SMD:R_0402_1005Metric
R33 | 1M 1% | Resistor_SMD:R_0402_1005Metric | Battery divider 1:2; sample after settling, calibrate with VREFINT; not coulomb counting.
R34 | 1M 1% | Resistor_SMD:R_0402_1005Metric | Battery divider 1:2; sample after settling, calibrate with VREFINT; not coulomb counting.
C28 | 10n | Capacitor_SMD:C_0402_1005Metric | Battery divider 1:2; sample after settling, calibrate with VREFINT; not coulomb counting.
