nyanko3141592/pendant-recorder/hardware/xe-minimal/q5-tmux-placement-trial/tmux-candidate-bom-additions.csv

reference | quantity_per_board | mpn | manufacturer | footprint | schematic_value | status | evidence
U16 | 1 | TMUX1101DCKR | Texas Instruments | TMUXTrial:TMUX1101_DCK0005A_TI_4214834G | TMUX1101DCKR candidate | CANDIDATE_NOT_RELEASED | docs/procurement/xe-q5-tmux1101-candidate.json
C34 | 1 | GRM155R71C104KA88J | Murata | Capacitor_SMD:C_0402_1005Metric | 100n 10V candidate | CANDIDATE_NOT_RELEASED | docs/procurement/xe-c34-murata-candidate.json
