nyanko3141592/pendant-recorder/outputs/prototype-v1-order-readiness/prototype-v1-procurement-estimate-preview.png

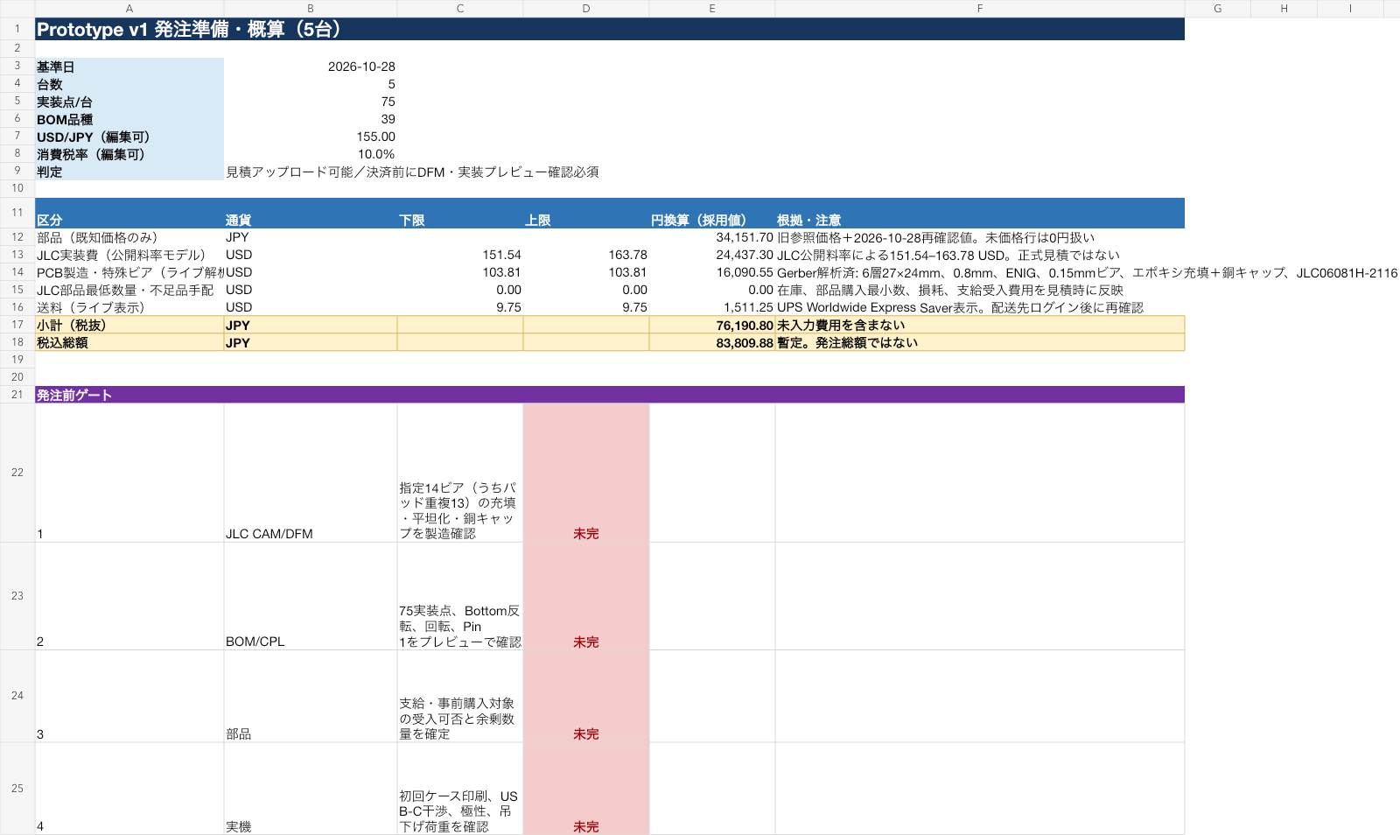
outputs/prototype-v1-order-readiness/prototype-v1-procurement-estimate-preview.png
