nyanko3141592/pendant-recorder/hardware/xe-minimal/preorder-20261029/release-review-20261029-aligned/mechanical-captured-carrier/assembly.step

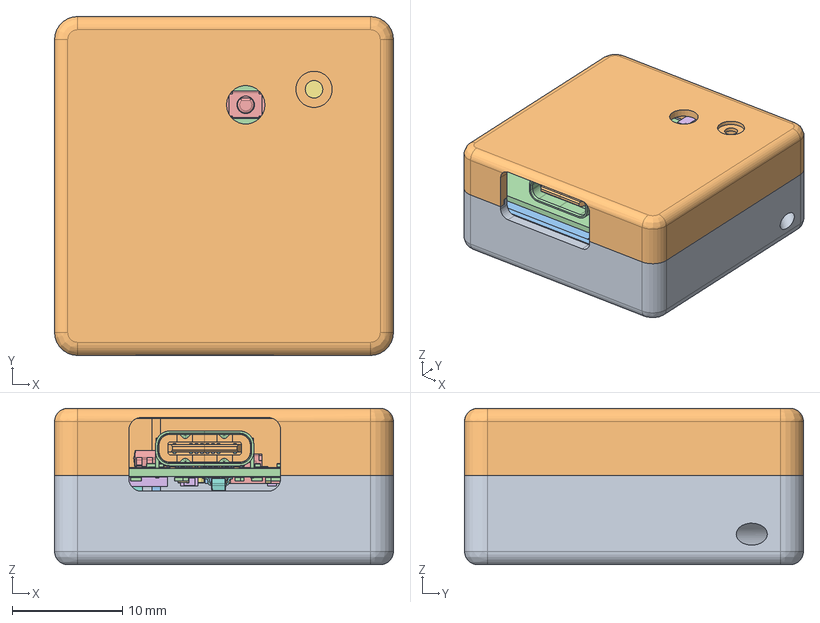
[picture p127: CAD file, 2026-10-29]
hardware/xe-minimal/preorder-20261029/release-review-20261029-aligned/mechanical-captured-carrier/assembly.step
30.8 x 30.8 x 14.2 mm
lower
upper
carrier
pcba
battery
