nyanko3141592/pendant-recorder/hardware/xe-minimal/preorder-20261029/release-review-20261029-aligned/mechanical-first-prototype/assembly.step

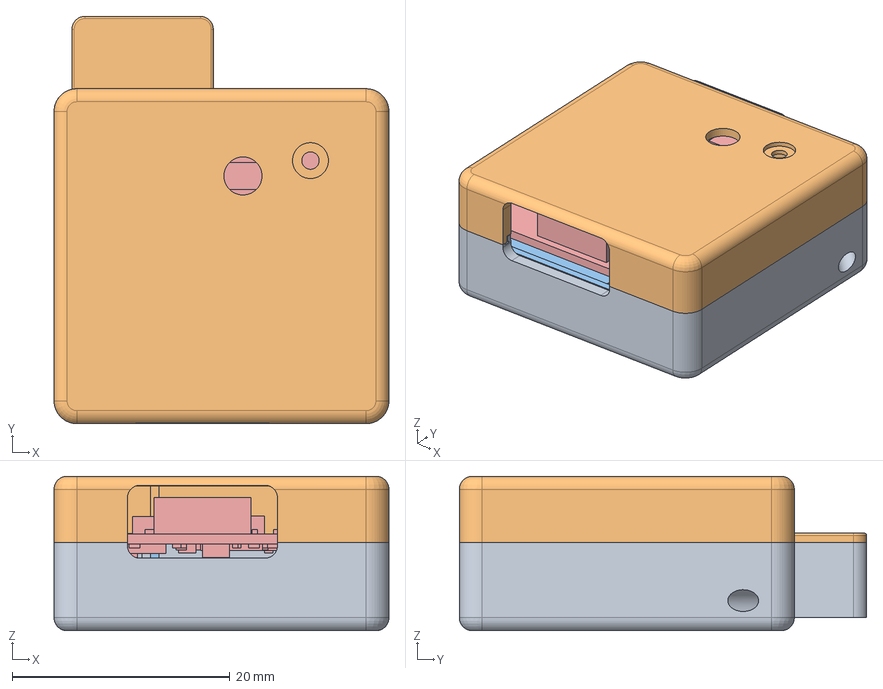
[picture p128: CAD file, 2026-10-29]
hardware/xe-minimal/preorder-20261029/release-review-20261029-aligned/mechanical-first-prototype/assembly.step
30.8 x 37.5 x 14.2 mm
case-lower
case-upper
carrier
battery-max
pcba-max-gauge
harness-clearance-envelope
mated-connector-envelope
insulation
