nyanko3141592/pendant-recorder/mechanical/compact-ab/fit-check/A/assembled.step

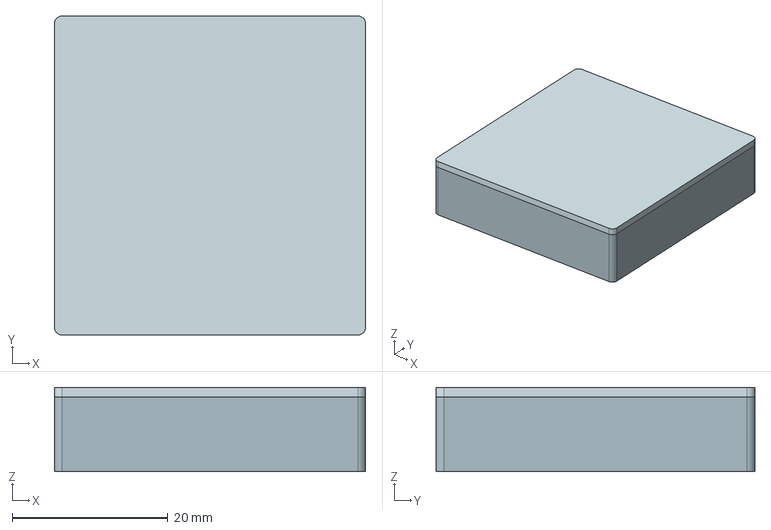
[picture p130: CAD file, 2026-10-25]
mechanical/compact-ab/fit-check/A/assembled.step
40.0 x 41.0 x 10.8 mm
