nyanko3141592/pendant-recorder/mechanical/rounded-v6/print/rounded_whole_26x31x14.step

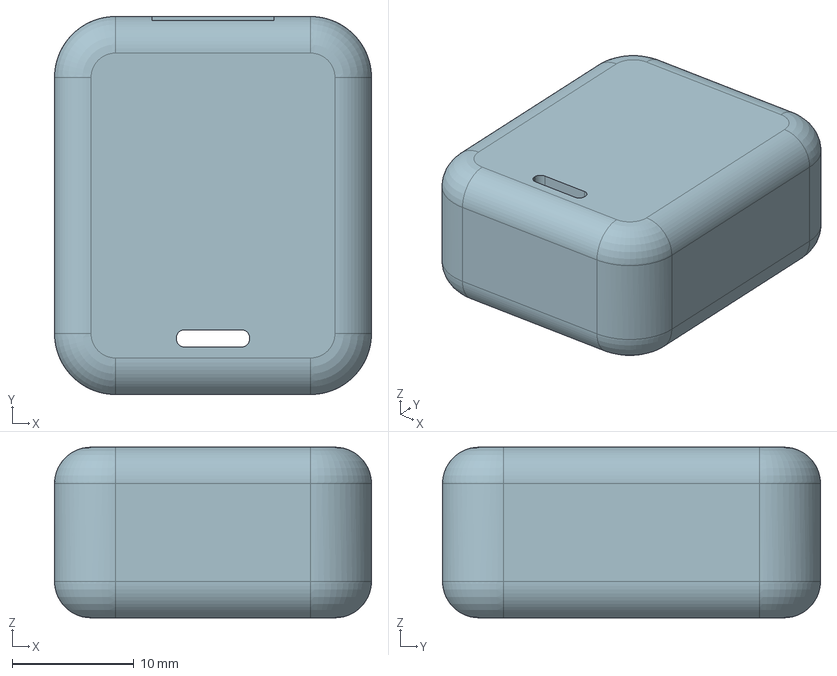
[picture p131: CAD file, 2026-10-25]
mechanical/rounded-v6/print/rounded_whole_26x31x14.step
26.0 x 31.0 x 14.0 mm
