nyanko3141592/pendant-recorder/mechanical/structure-a2/assembled.step

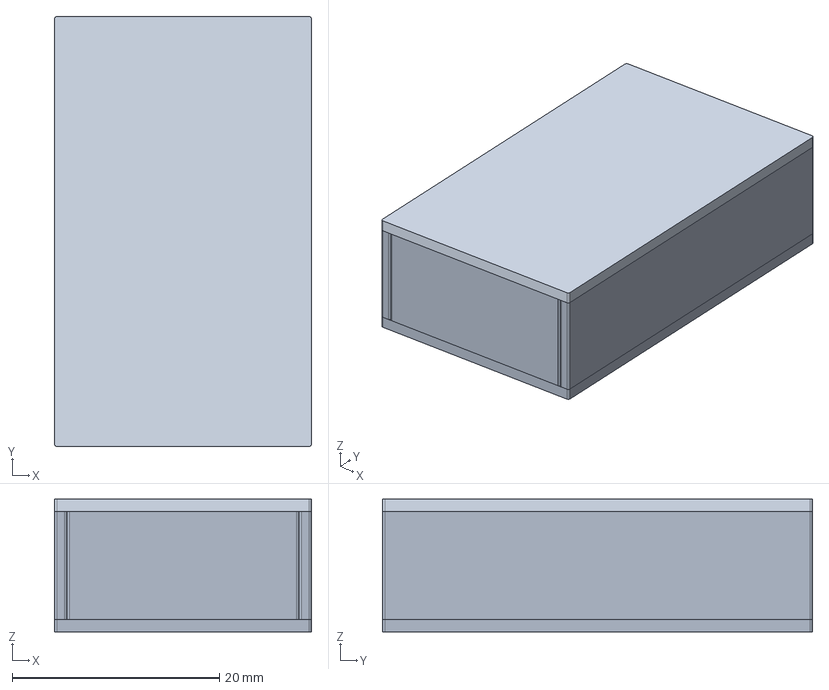
[picture p132: CAD file, 2026-10-24]
mechanical/structure-a2/assembled.step
24.8 x 41.5 x 12.8 mm
