nyanko3141592/pendant-recorder/mechanical/structure-b0/assembled.step

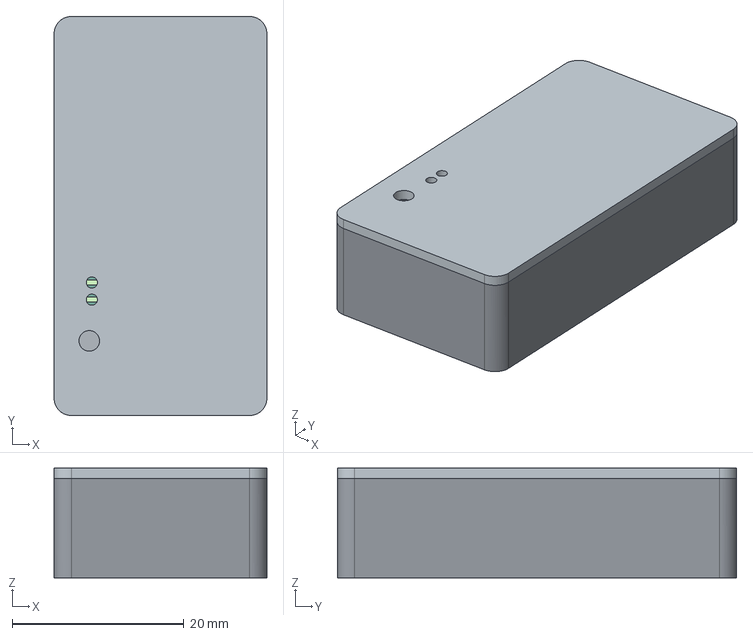
[picture p133: CAD file, 2026-10-24]
mechanical/structure-b0/assembled.step
24.8 x 46.5 x 12.8 mm
