nyanko3141592/pendant-recorder/mechanical/structure-c0/assembled.step

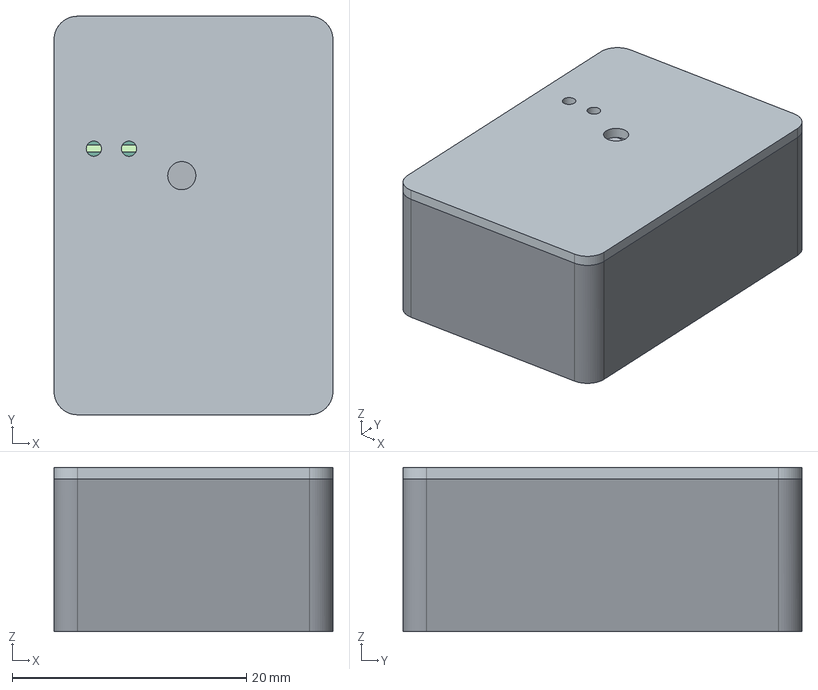
[picture p134: CAD file, 2026-10-24]
mechanical/structure-c0/assembled.step
23.8 x 34.0 x 14.0 mm
