nyanko3141592/pendant-recorder/mechanical/structure-d2/assembled.step

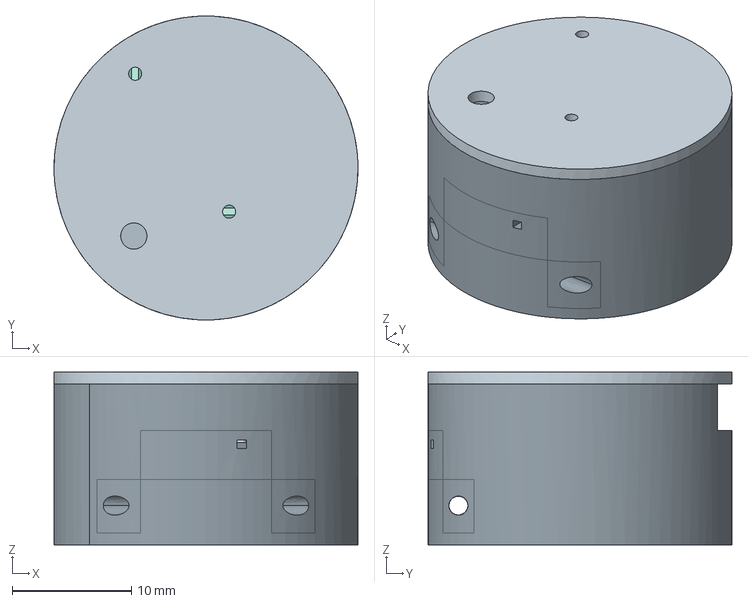
[picture p136: CAD file, 2026-10-24]
mechanical/structure-d2/assembled.step
25.5 x 25.5 x 14.5 mm
