nyanko3141592/pendant-recorder/mechanical/structure-e/assembled.step

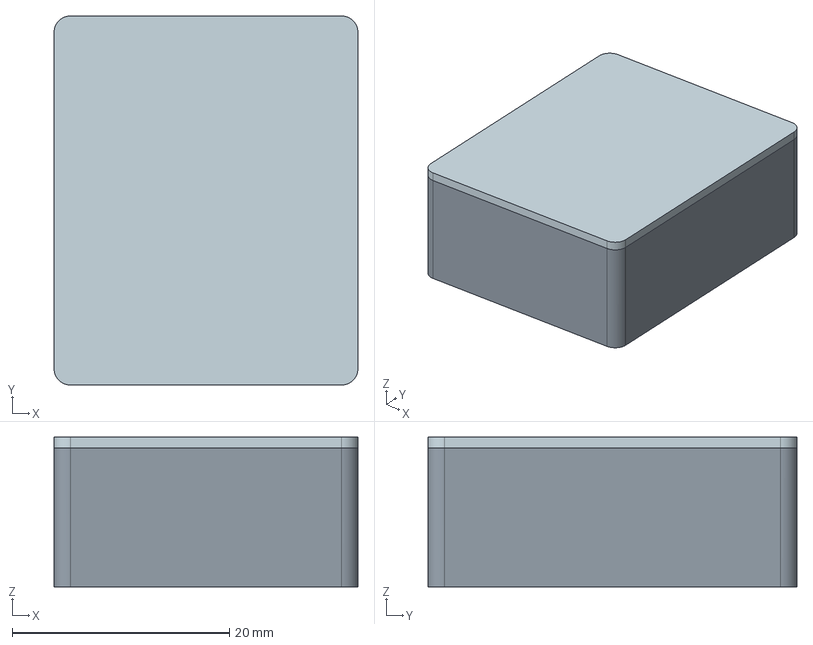
[picture p137: CAD file, 2026-10-24]
mechanical/structure-e/assembled.step
28.0 x 34.0 x 13.8 mm
