nyanko3141592/pendant-recorder/mechanical/xe-minimal/prototype-v1/actual-30mm-prototype/actual-30mm-prototype-assembly.step

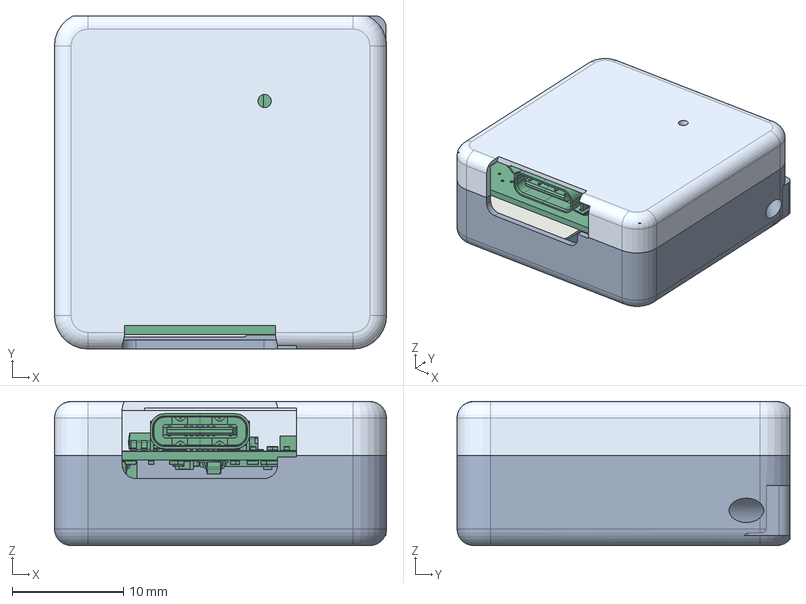
[picture p138: CAD file, 2026-10-29]
mechanical/xe-minimal/prototype-v1/actual-30mm-prototype/actual-30mm-prototype-assembly.step
29.9 x 30.0 x 13.0 mm
lower_integral_corner_cord
canonical_populated_pcb
battery_separator
DTP401525_XE_max_body
factory_harness_reserved_corridor
upper_rounded
