nyanko3141592/pendant-recorder/mechanical/xe-minimal/prototype-v1/case-soft-r20-assembly.step

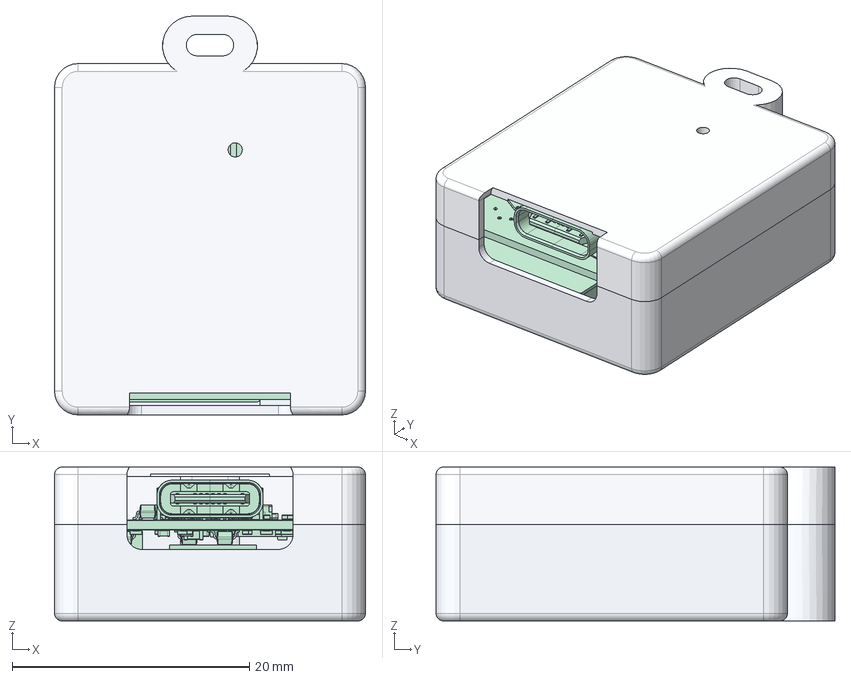
[picture p139: CAD file, 2026-10-29]
mechanical/xe-minimal/prototype-v1/case-soft-r20-assembly.step
26.2 x 33.6 x 13.0 mm
lower_part
internals_part
upper_part
