nyanko3141592/pendant-recorder/mechanical/xe-minimal/prototype-v1/hw-v1.3-physical-mockup/hw-v1.3-physical-mockup-assembly.step

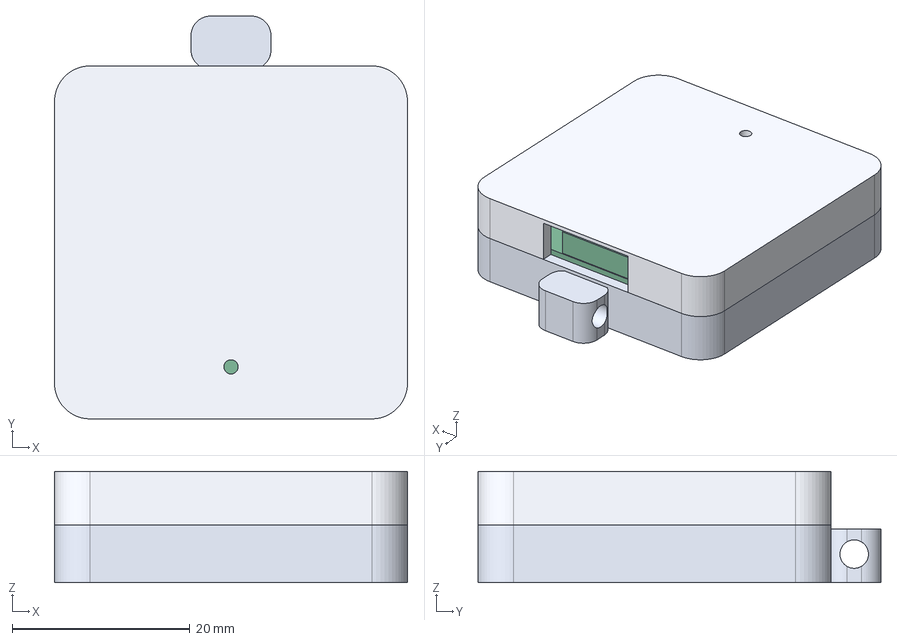
[picture p140: CAD file, 2026-10-29]
mechanical/xe-minimal/prototype-v1/hw-v1.3-physical-mockup/hw-v1.3-physical-mockup-assembly.step
39.7 x 45.3 x 12.5 mm
case_lower
case_upper
pcb_populated_envelope
dtp401525_xe_max
