nyanko3141592/pendant-recorder/mechanical/xe-minimal/prototype-v1/pcb-costdown-comparison-kit/hw-v1-0-v1-1-v1-2-pcb-comparison-assembly.step

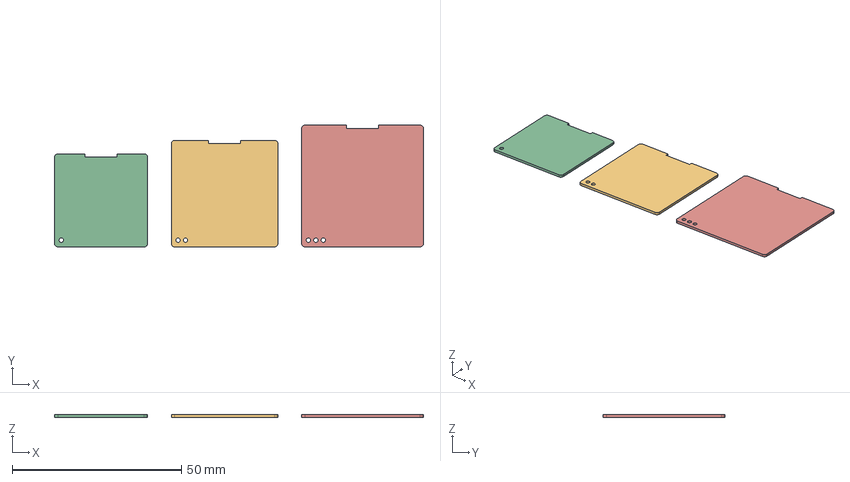
[picture p141: CAD file, 2026-10-29]
mechanical/xe-minimal/prototype-v1/pcb-costdown-comparison-kit/hw-v1-0-v1-1-v1-2-pcb-comparison-assembly.step
109.0 x 36.0 x 0.8 mm
HW-V1.0
HW-V1.1
HW-V1.2
