nyanko3141592/pendant-recorder/mechanical/structure-a1/assembled.step

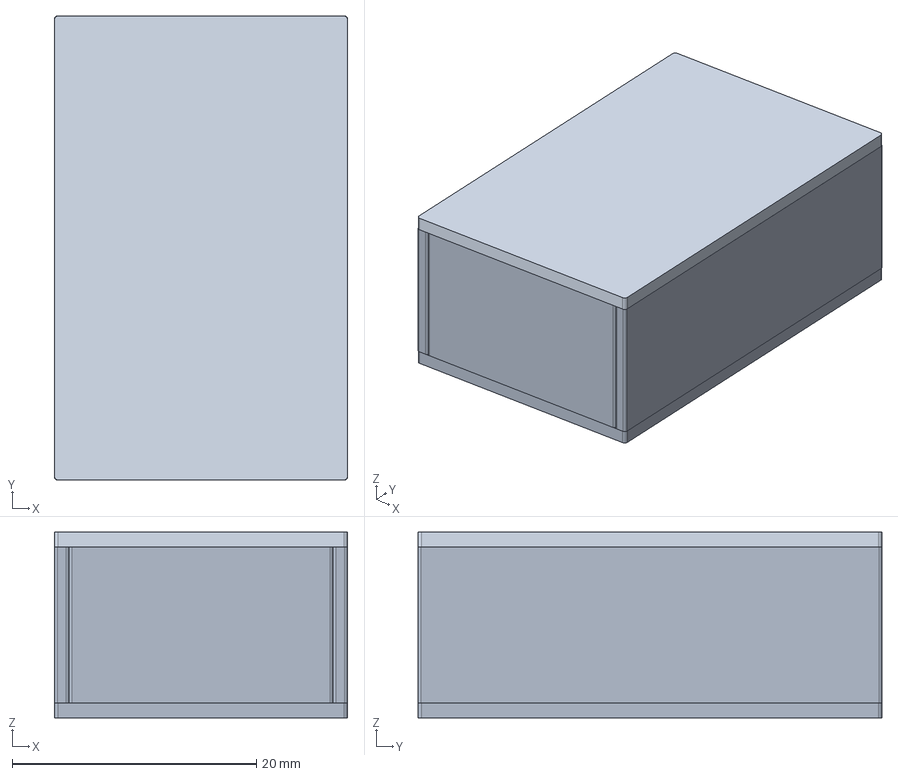
[picture p142: CAD file, 2026-10-24]
mechanical/structure-a1/assembled.step
24.0 x 38.0 x 15.2 mm
