nyanko3141592/pendant-recorder/mechanical/xe-minimal/retained-case-assembly-study.step

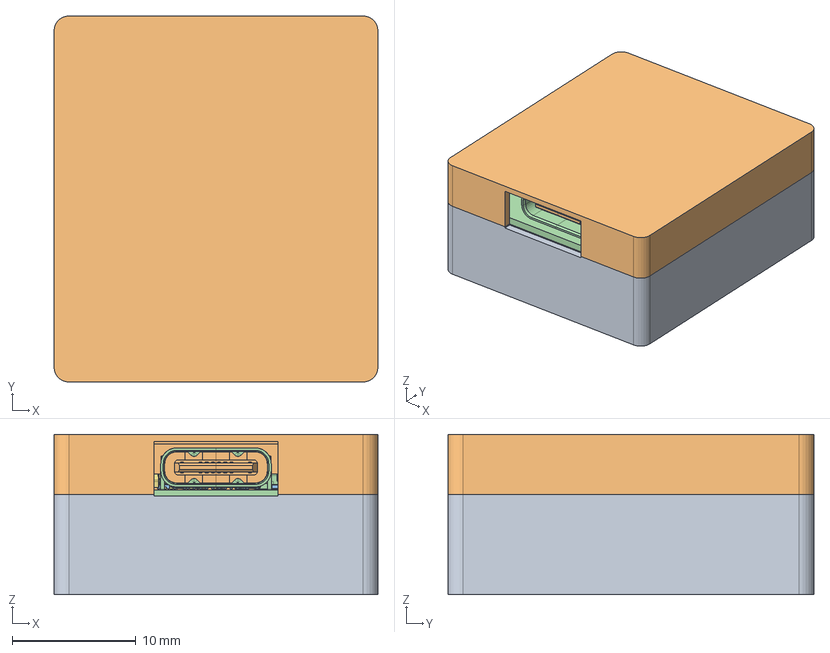
[picture p144: CAD file, 2026-10-29]
mechanical/xe-minimal/retained-case-assembly-study.step
26.2 x 29.6 x 13.0 mm
lower_with_supports
upper_with_stops
electronics_separator_pack
