nyanko3141592/pendant-recorder/mechanical/compact-ab/fit-check/B/assembled.step

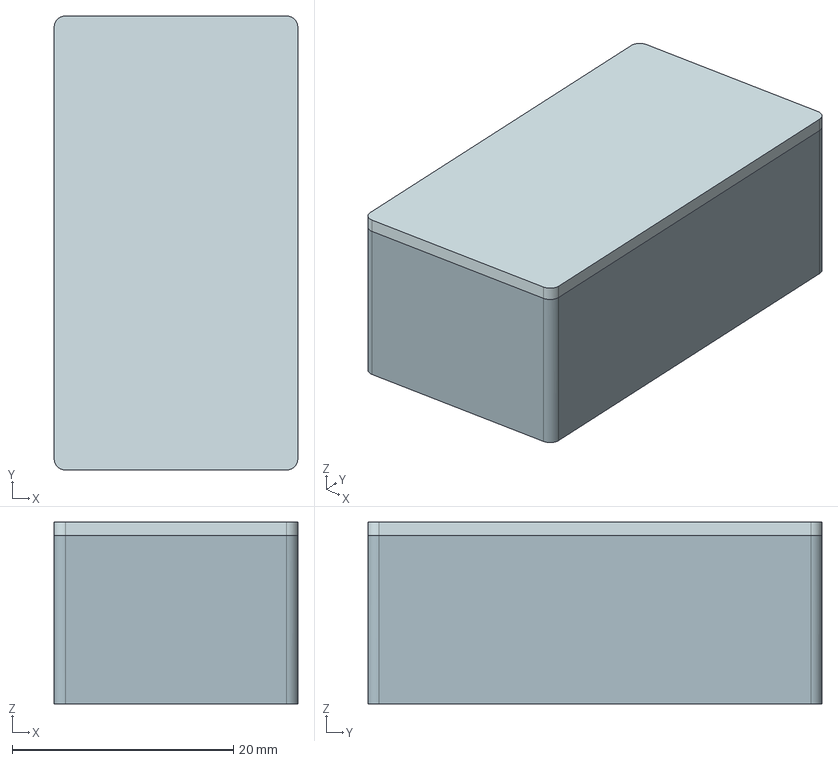
[picture p145: CAD file, 2026-10-25]
mechanical/compact-ab/fit-check/B/assembled.step
22.0 x 41.0 x 16.4 mm
