nyanko3141592/pendant-recorder/mechanical/compact-ab/a-assembled.step

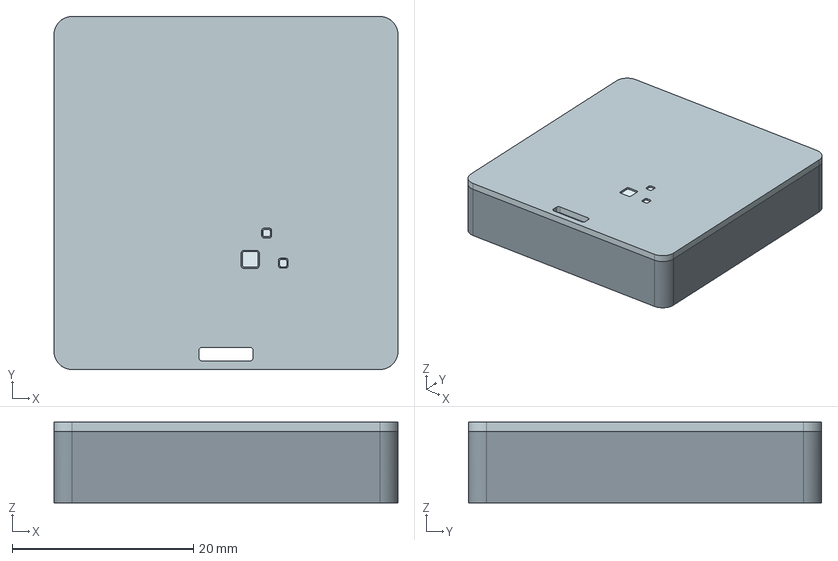
[picture p146: CAD file, 2026-10-24]
mechanical/compact-ab/a-assembled.step
38.0 x 39.0 x 8.90 mm
