nyanko3141592/pendant-recorder/mechanical/xe-minimal/prototype-v1/actual-30mm-prototype/actual-populated-pcb-complete.step

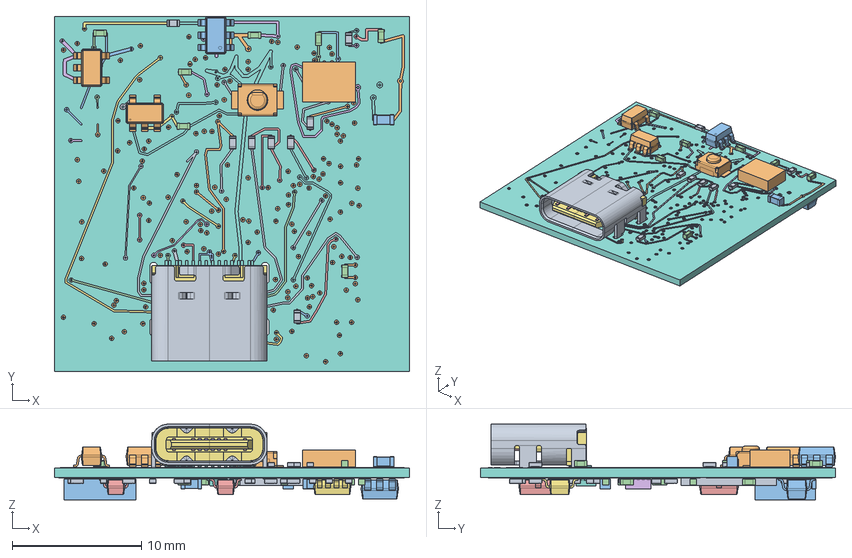
[picture p147: CAD file, 2026-10-29]
mechanical/xe-minimal/prototype-v1/actual-30mm-prototype/actual-populated-pcb-complete.step
27.5 x 27.5 x 5.87 mm
