nyanko3141592/pendant-recorder/mechanical/xe-minimal/prototype-v1/pcb-assembly.step

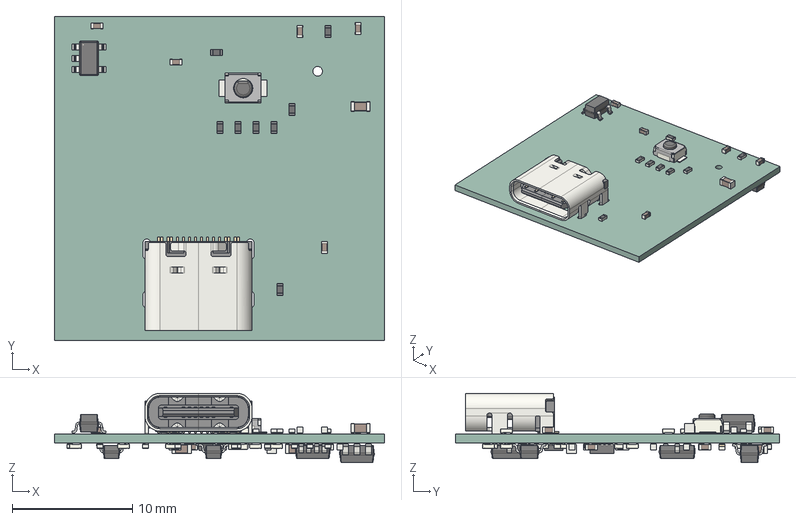
[picture p148: CAD file, 2026-10-29]
mechanical/xe-minimal/prototype-v1/pcb-assembly.step
27.5 x 27.0 x 5.79 mm
R_0402_1005Metric x 31
SW_SPST_B3U-1000P
C_0603_1608Metric x 4
C_0402_1005Metric x 15
USB_C_Receptacle_16P_TopMnt_Horizontal_GCT_USB4105-xx-A
SOT-23-5
LED_0402_1005Metric
SOT-23 x 2
R_0603_1608Metric
Texas_DLH0010A_WSON-10-1EP_2.2x2mm_P0.4mm_EP0.9x1.5mm
SOT-23-8
SOT_666
SOT-23-6
pendant-xe-minimal_PCB
