nyanko3141592/pendant-recorder/mechanical/compact-ab/b-assembled.step

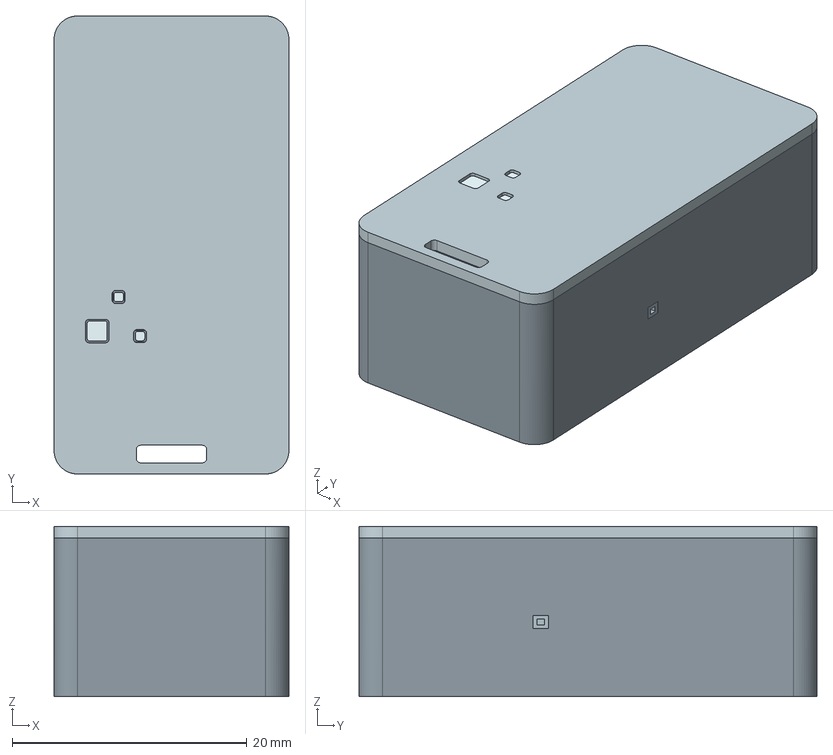
[picture p149: CAD file, 2026-10-24]
mechanical/compact-ab/b-assembled.step
20.0 x 39.0 x 14.5 mm
