nyanko3141592/pendant-recorder/mechanical/compact-100-v5/print/whole_size_26x31x14.step

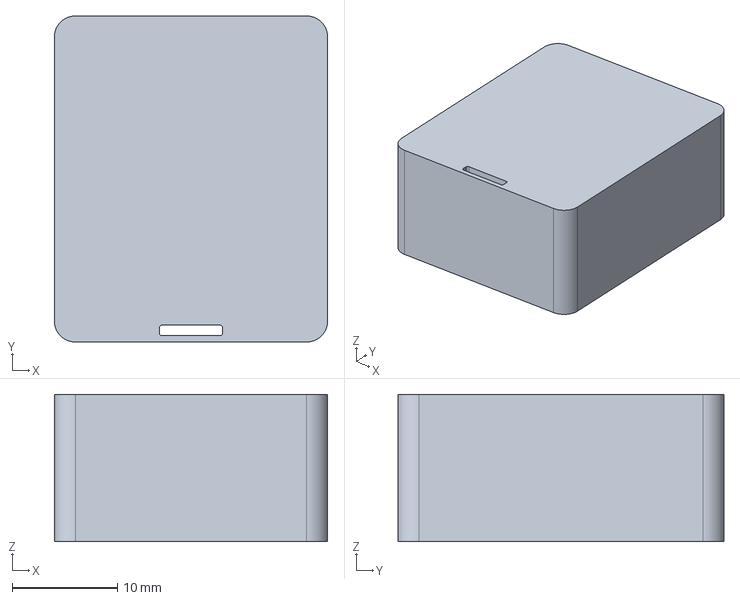
[picture p150: CAD file, 2026-10-25]
mechanical/compact-100-v5/print/whole_size_26x31x14.step
26.0 x 31.0 x 14.0 mm
