nyanko3141592/pendant-recorder/mechanical/xe-minimal/prototype-v1/hw-v1-size-fit-print-kit-v1-assembly.step

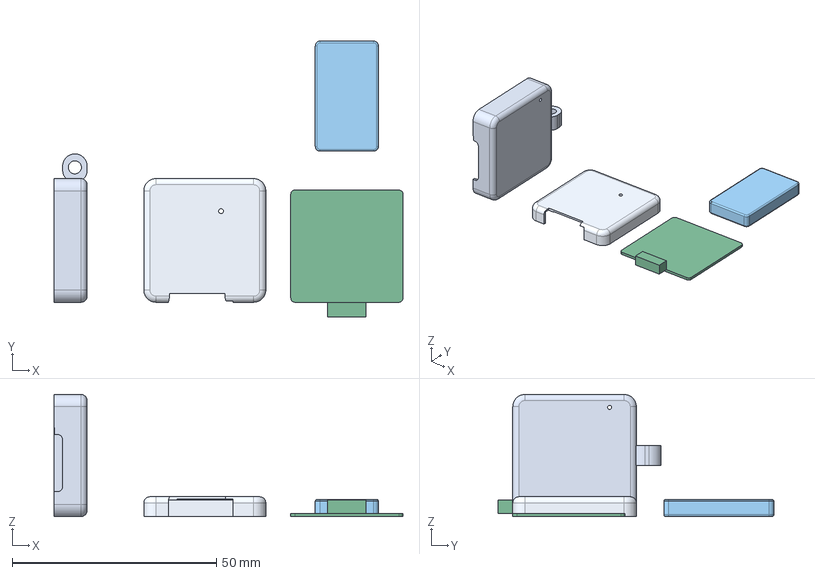
[picture p151: CAD file, 2026-10-29]
mechanical/xe-minimal/prototype-v1/hw-v1-size-fit-print-kit-v1-assembly.step
85.5 x 67.6 x 29.9 mm
case_lower_print_orientation
case_upper
pcb_outline_usb_gauge
battery_max_gauge
