nyanko3141592/pendant-recorder/mechanical/xe-minimal/button-assembly-trial.step

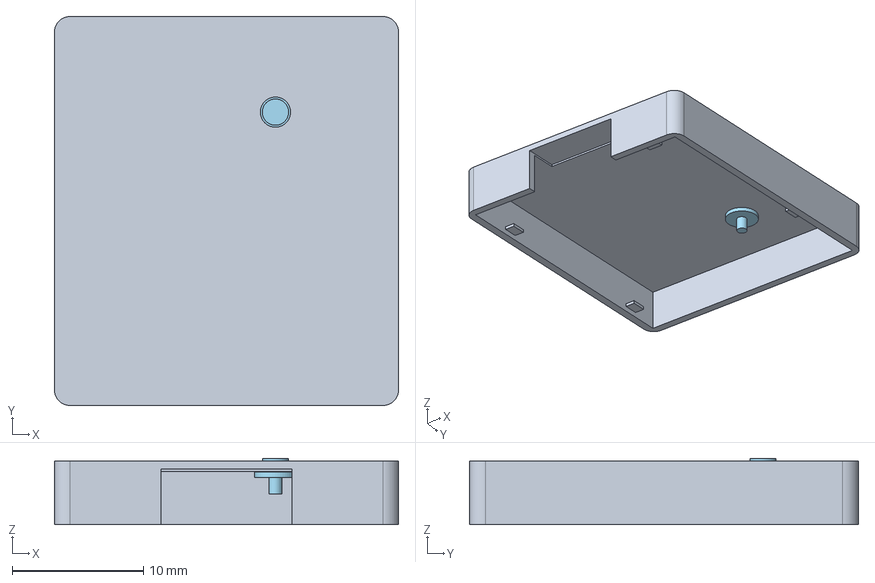
[picture p153: CAD file, 2026-10-29]
mechanical/xe-minimal/button-assembly-trial.step
26.2 x 29.6 x 5.05 mm
upper_case
loose_plunger
