nyanko3141592/pendant-recorder/mechanical/xe-minimal/prototype-v1/integrated-assembly-v1.step

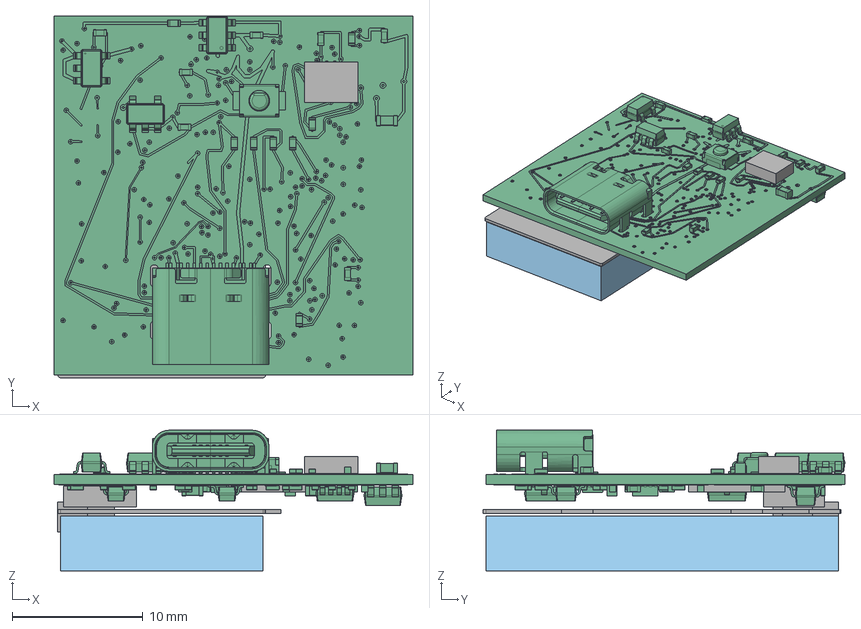
[picture p154: CAD file, 2026-10-29]
mechanical/xe-minimal/prototype-v1/integrated-assembly-v1.step
27.5 x 27.7 x 10.8 mm
pcb
U1_max
U8_max
J2_header
battery_max
sensor_carrier
battery_harness_reserve
