nyanko3141592/pendant-recorder/mechanical/xe-minimal/prototype-v1/case-pebble-v5-assembly.step

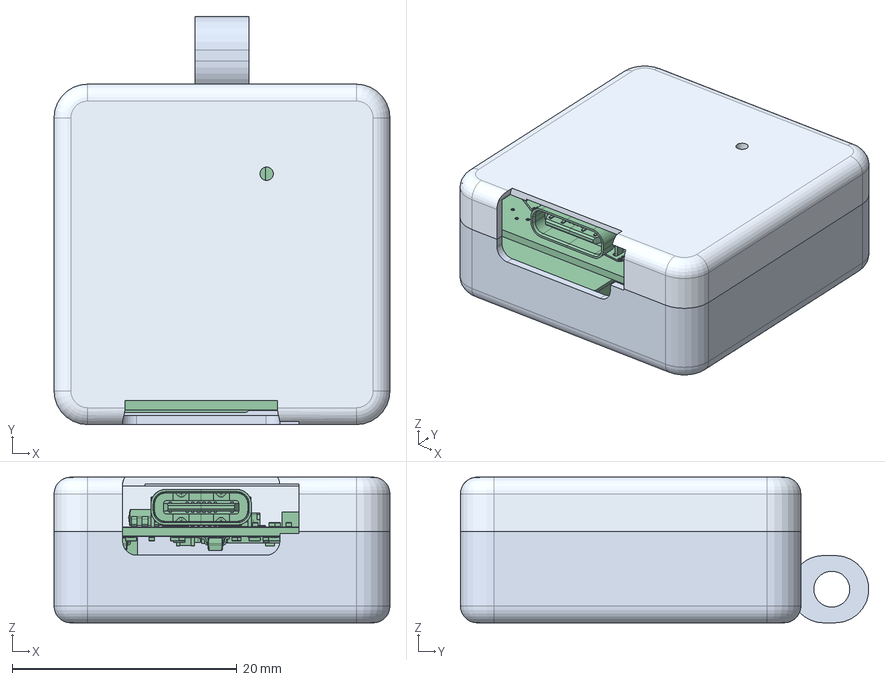
[picture p155: CAD file, 2026-10-29]
mechanical/xe-minimal/prototype-v1/case-pebble-v5-assembly.step
29.9 x 36.3 x 13.0 mm
lower_and_integral_lug
internals
upper
