nyanko3141592/pendant-recorder/mechanical/xe-minimal/exploded-assembly-review.step

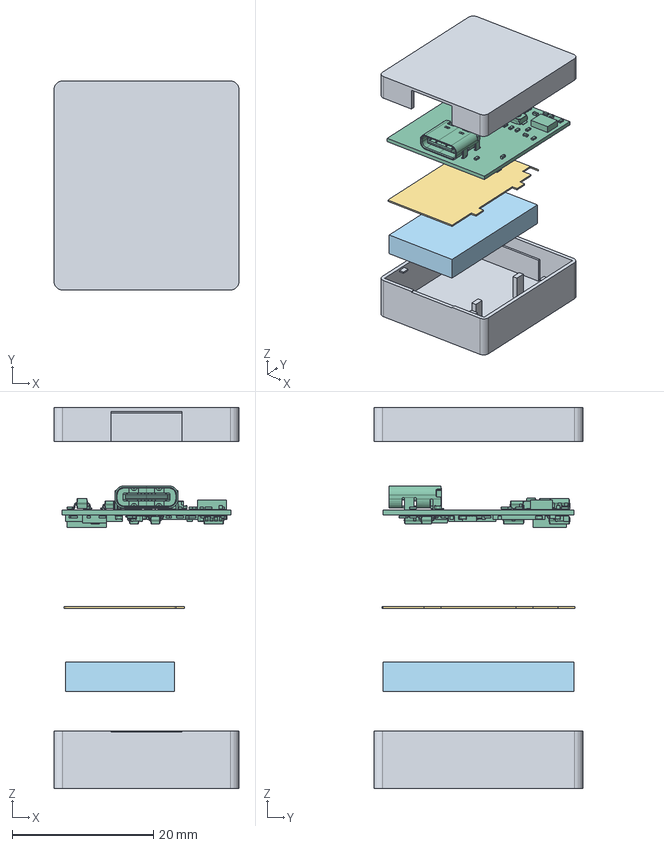
[picture p156: CAD file, 2026-10-29]
mechanical/xe-minimal/exploded-assembly-review.step
26.2 x 29.6 x 54.0 mm
layer_0
layer_1
layer_2
layer_3
layer_4
