nyanko3141592/pendant-recorder/mechanical/xe-minimal/button-accessible-assembly-trial.step

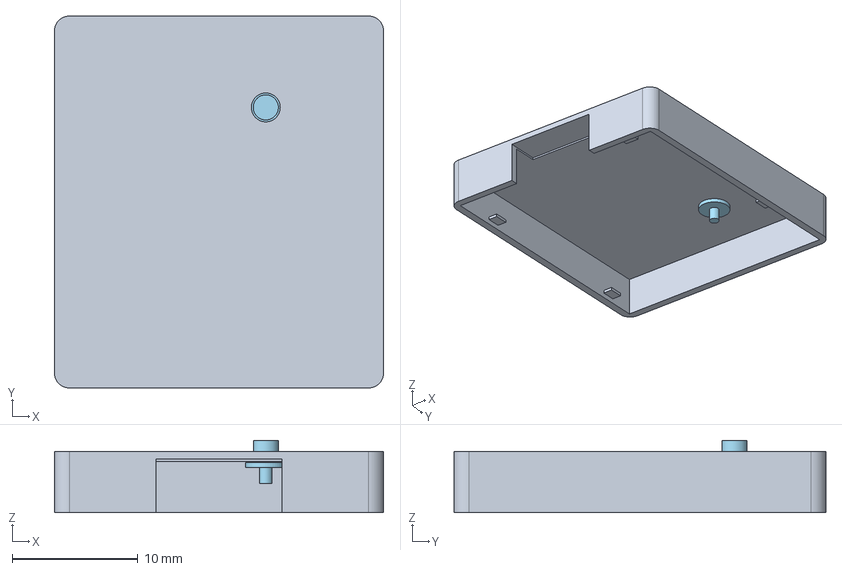
[picture p157: CAD file, 2026-10-29]
mechanical/xe-minimal/button-accessible-assembly-trial.step
26.2 x 29.6 x 5.75 mm
upper_case
loose_plunger
