nyanko3141592/pendant-recorder/mechanical/xe-minimal/film-full-lead-insulation-study.step

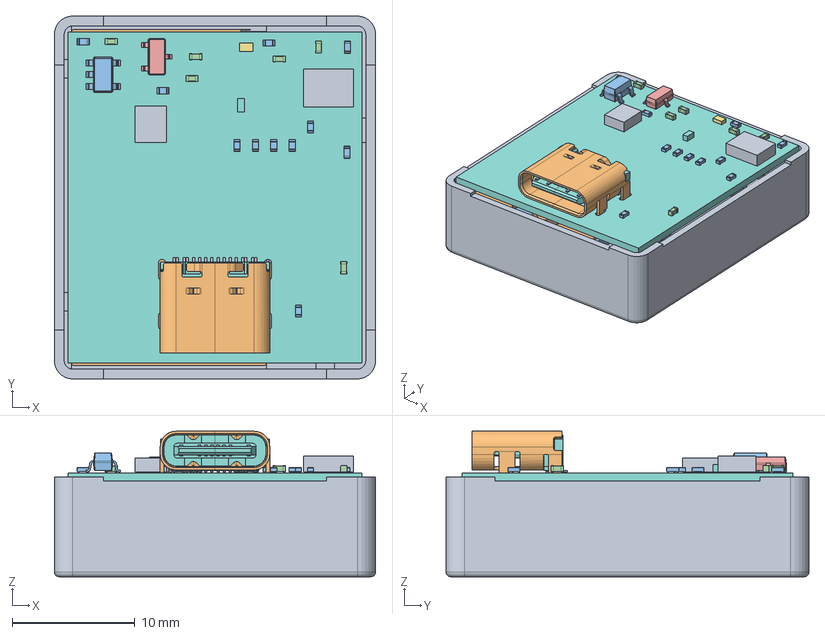
[picture p158: CAD file, 2026-10-29]
mechanical/xe-minimal/film-full-lead-insulation-study.step
26.2 x 29.6 x 11.9 mm
lower
separator
board
battery
wrap_-0.95
wrap_0.95
