nyanko3141592/pendant-recorder/mechanical/xe-minimal/offset-pack-assembly-trial.step

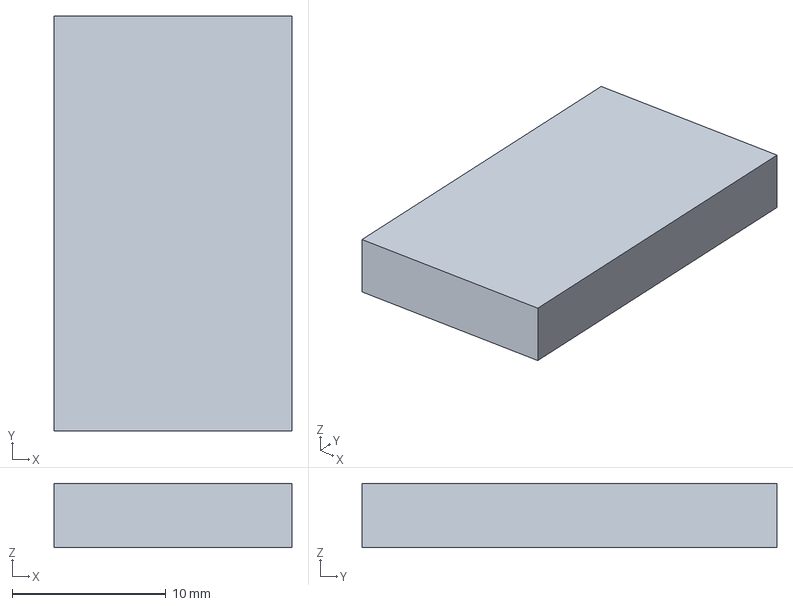
[picture p159: CAD file, 2026-10-29]
mechanical/xe-minimal/offset-pack-assembly-trial.step
15.5 x 27.0 x 4.20 mm
