nyanko3141592/pendant-recorder/mechanical/xe-minimal/assembly-access-lower-trial.step

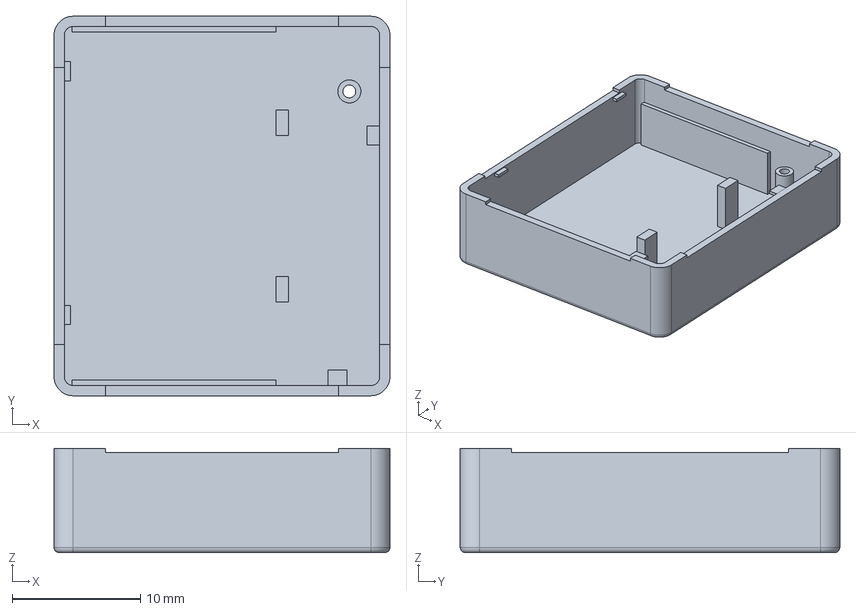
[picture p160: CAD file, 2026-10-29]
mechanical/xe-minimal/assembly-access-lower-trial.step
26.2 x 29.6 x 8.12 mm
