nyanko3141592/pendant-recorder/mechanical/xe-minimal/closure-button-accessible-assembly-trial.step

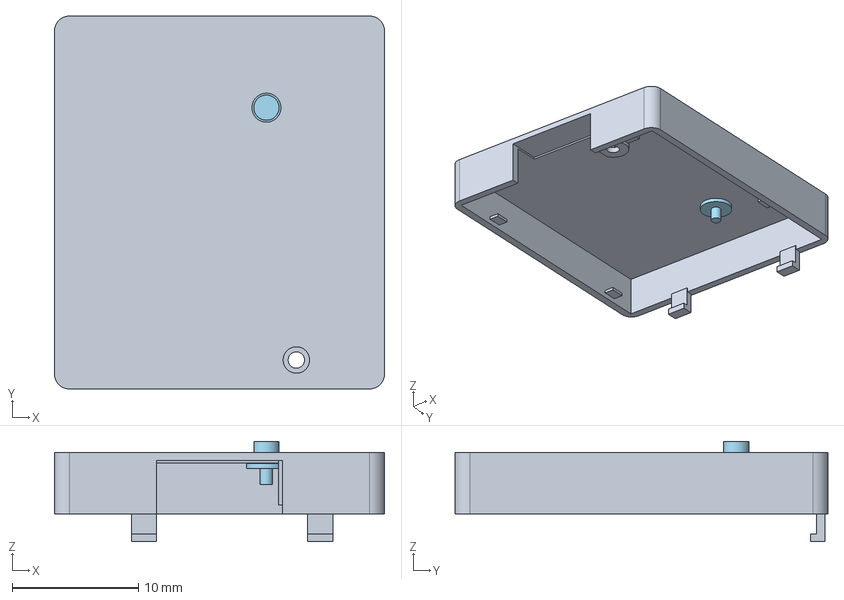
[picture p161: CAD file, 2026-10-29]
mechanical/xe-minimal/closure-button-accessible-assembly-trial.step
26.2 x 29.6 x 7.95 mm
upper_case
loose_plunger
