nyanko3141592/pendant-recorder/mechanical/xe-minimal/case-shell-assembly-study.step

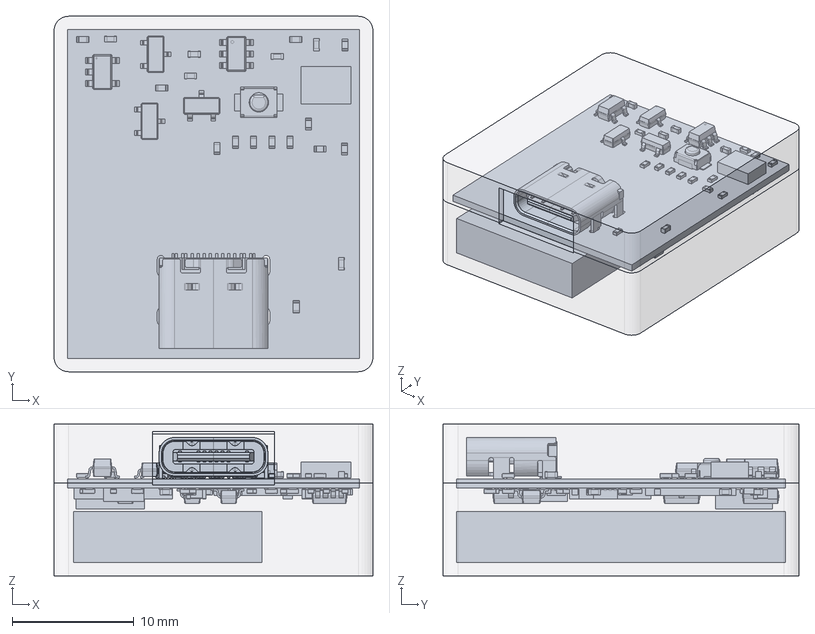
[picture p162: CAD file, 2026-10-29]
mechanical/xe-minimal/case-shell-assembly-study.step
26.2 x 29.2 x 12.5 mm
provisional_electronics_and_pack
lower_shell
upper_shell
