nyanko3141592/pendant-recorder/hardware/xe-minimal/preorder-20261029/release-review-20261029-aligned/current-native-pcba.step

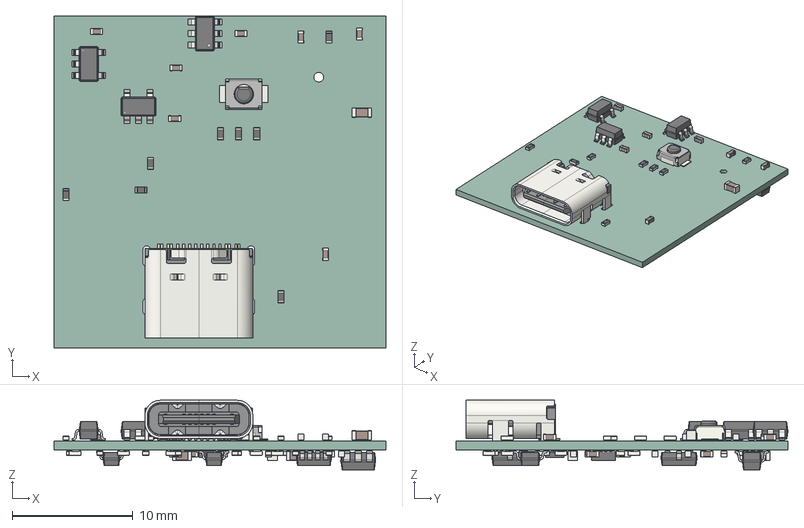
[picture p164: CAD file, 2026-10-29]
hardware/xe-minimal/preorder-20261029/release-review-20261029-aligned/current-native-pcba.step
27.5 x 27.5 x 5.76 mm
R_0402_1005Metric x 30
SW_SPST_B3U-1000P
C_0603_1608Metric x 4
C_0402_1005Metric x 18
USB_C_Receptacle_16P_TopMnt_Horizontal_GCT_USB4105-xx-A
SOT-23-5 x 2
SOT-23-6 x 2
LED_0402_1005Metric
SOT-23 x 2
Texas_DLH0010A_WSON-10-1EP_2.2x2mm_P0.4mm_EP0.9x1.5mm
SOT-23-8
SOT_666
pendant-review_PCB
