nyanko3141592/pendant-recorder/hardware/xe-minimal/preorder-20261029/release-review-20261029-aligned/fit-kit/board-envelope-max.step

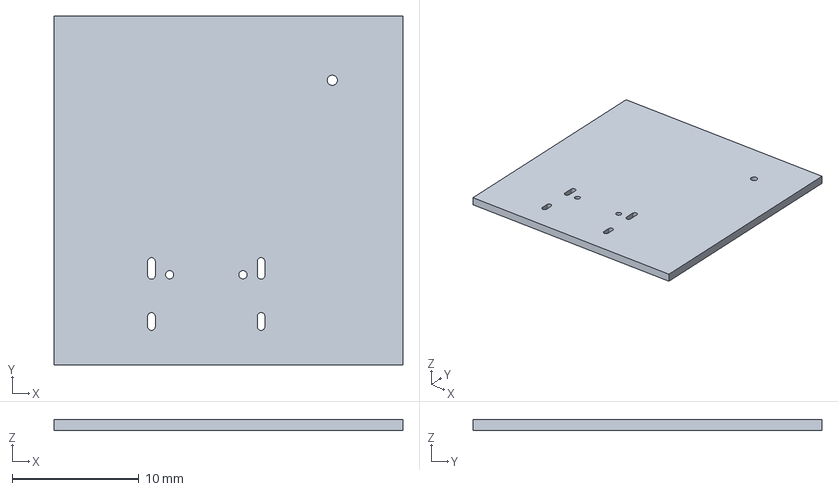
[picture p165: CAD file, 2026-10-29]
hardware/xe-minimal/preorder-20261029/release-review-20261029-aligned/fit-kit/board-envelope-max.step
27.5 x 27.5 x 0.9 mm
