nyanko3141592/pendant-recorder/hardware/xe-minimal/preorder-20261029/release-review-20261029-aligned/fit-kit/fit-kit-a1mini/current-fit-kit.3mf

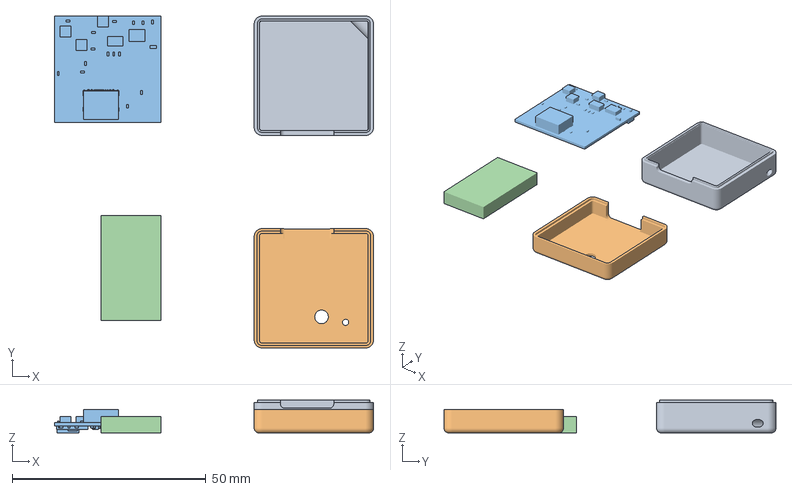
[picture p166: CAD file, 2026-10-29]
hardware/xe-minimal/preorder-20261029/release-review-20261029-aligned/fit-kit/fit-kit-a1mini/current-fit-kit.3mf
82.3 x 85.6 x 8.45 mm
case-lower.stl
case-upper.stl
pcba-max-gauge.stl
battery-max.stl
