nyanko3141592/pendant-recorder/hardware/xe-minimal/preorder-20261029/release-review-20261029-aligned/mechanical-cradle-study/battery-max-positioned.step

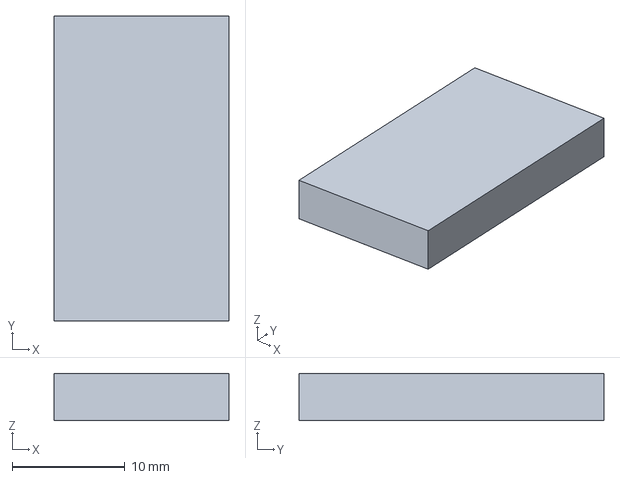
[picture p167: CAD file, 2026-10-29]
hardware/xe-minimal/preorder-20261029/release-review-20261029-aligned/mechanical-cradle-study/battery-max-positioned.step
15.5 x 27.0 x 4.20 mm
