nyanko3141592/pendant-recorder/hardware/xe-minimal/preorder-20261029/release-review-20261029-aligned/mechanical-first-prototype/a1mini-fit-kit/prototype-fit-kit.3mf

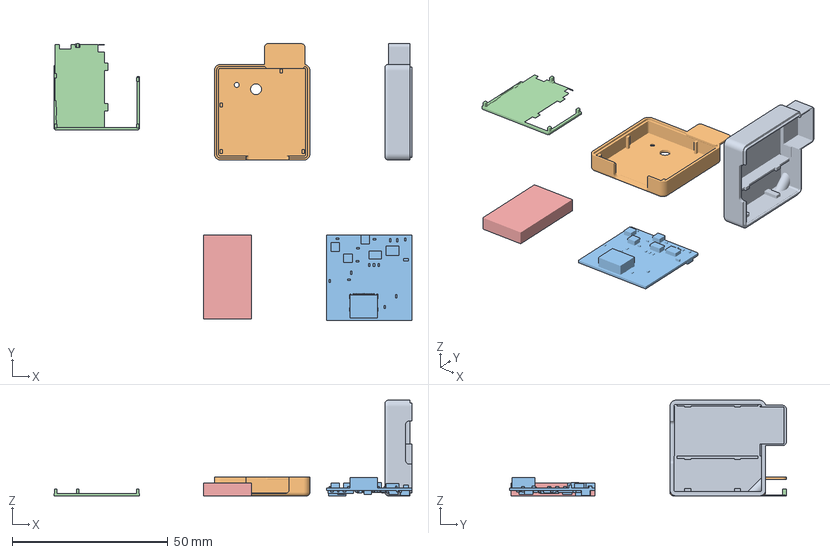
[picture p168: CAD file, 2026-10-29]
hardware/xe-minimal/preorder-20261029/release-review-20261029-aligned/mechanical-first-prototype/a1mini-fit-kit/prototype-fit-kit.3mf
115.1 x 89.0 x 30.8 mm
case-lower.stl
case-upper.stl
pcba-max-gauge.stl
carrier.stl
battery-max.stl
