nyanko3141592/pendant-recorder/hardware/xe-minimal/preorder-20261029/release-review-20261029/fit-kit/u11-max-body.step

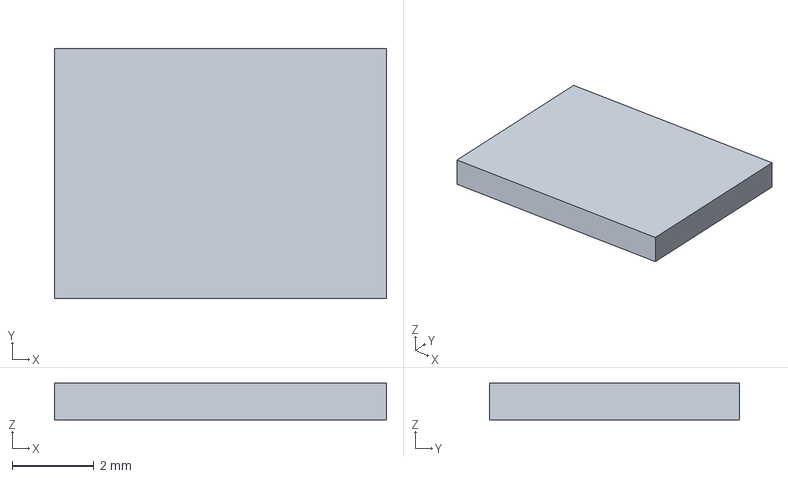
[picture p169: CAD file, 2026-10-29]
hardware/xe-minimal/preorder-20261029/release-review-20261029/fit-kit/u11-max-body.step
8.10 x 6.10 x 0.9 mm
