nyanko3141592/pendant-recorder/hardware/xe-minimal/supported-panel-radius-study.step

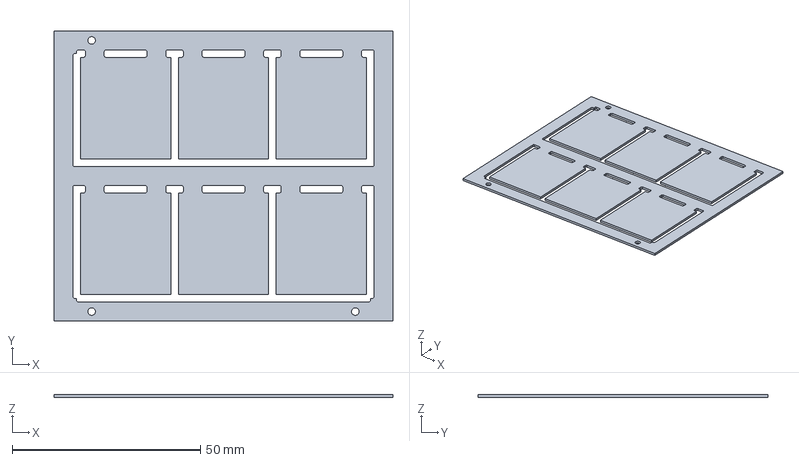
[picture p170: CAD file, 2026-10-29]
hardware/xe-minimal/supported-panel-radius-study.step
90.0 x 77.0 x 0.826 mm
