nyanko3141592/pendant-recorder/mechanical/compact-100-v5/print/case_body.step

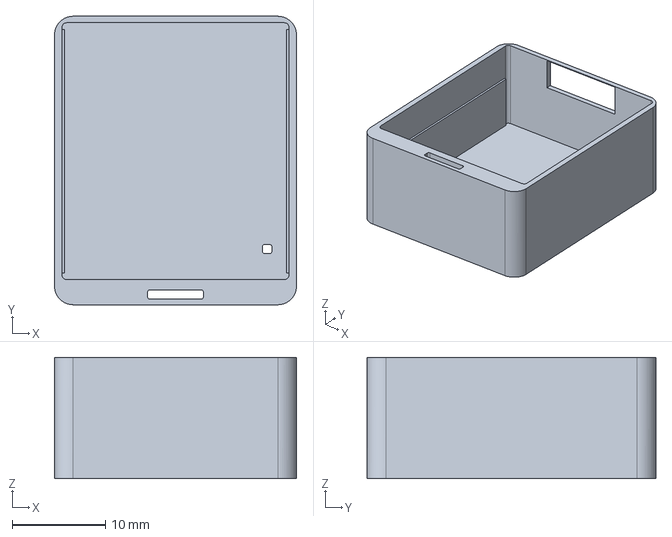
[picture p171: CAD file, 2026-10-25]
mechanical/compact-100-v5/print/case_body.step
26.0 x 31.0 x 13.0 mm
