nyanko3141592/pendant-recorder/mechanical/compact-ab/a-exploded.step

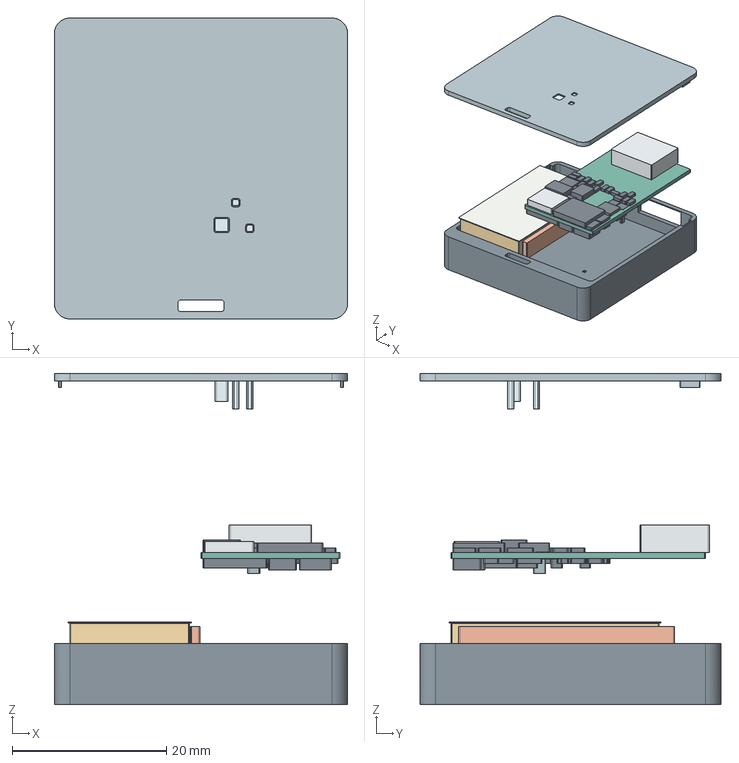
[picture p172: CAD file, 2026-10-24]
mechanical/compact-ab/a-exploded.step
38.0 x 39.0 x 42.9 mm
