nyanko3141592/pendant-recorder/mechanical/compact-ab/fit-check/B/pcb_components.3mf

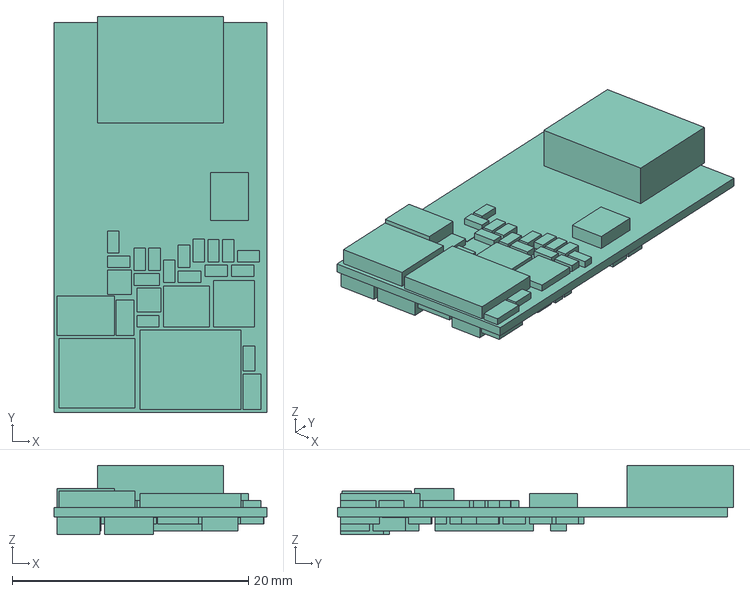
[picture p173: CAD file, 2026-10-25]
mechanical/compact-ab/fit-check/B/pcb_components.3mf
18.0 x 33.5 x 5.86 mm
