nyanko3141592/pendant-recorder/mechanical/compact-ab/fit-check/gauges/lead_18mm.3mf

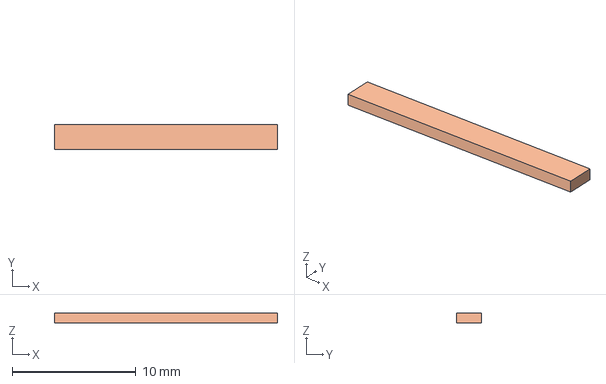
[picture p174: CAD file, 2026-10-25]
mechanical/compact-ab/fit-check/gauges/lead_18mm.3mf
18.0 x 2.00 x 0.8 mm
