nyanko3141592/pendant-recorder/mechanical/compact-ab/fit-check/original-size/Pendant_B_size_20x39x14.5mm.3mf

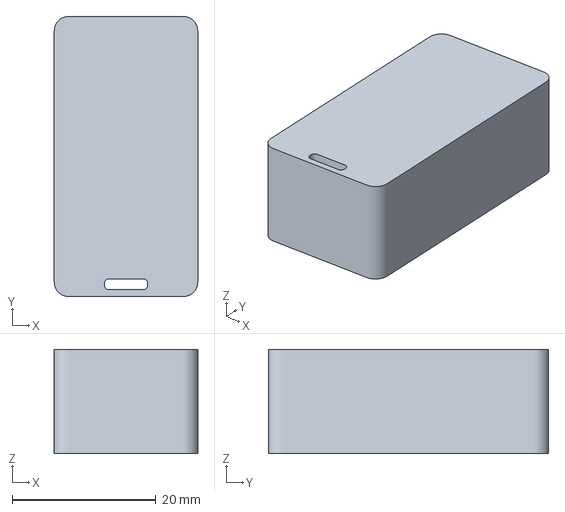
[picture p175: CAD file, 2026-10-25]
mechanical/compact-ab/fit-check/original-size/Pendant_B_size_20x39x14.5mm.3mf
20.0 x 39.0 x 14.5 mm
