nyanko3141592/pendant-recorder/mechanical/compact-ab/fit-check/Pendant_AB_FC1_Bambu_single-plate.3mf

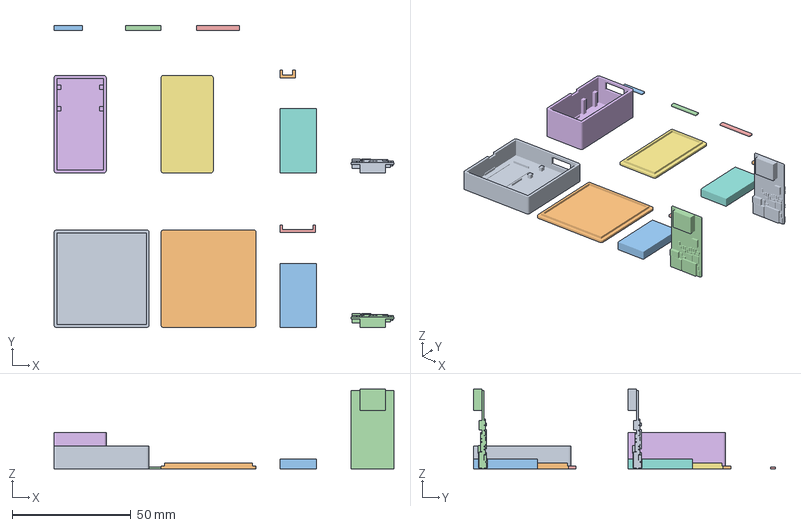
[picture p176: CAD file, 2026-10-25]
mechanical/compact-ab/fit-check/Pendant_AB_FC1_Bambu_single-plate.3mf
143.0 x 127.0 x 33.5 mm
A_body
A_lid
A_battery
A_pcb_components
A_harness_reservation
B_body
B_lid
B_battery
B_pcb_components
B_harness_reservation
lead_12mm
lead_15mm
lead_18mm
