nyanko3141592/pendant-recorder/mechanical/pendant-fit-study.step

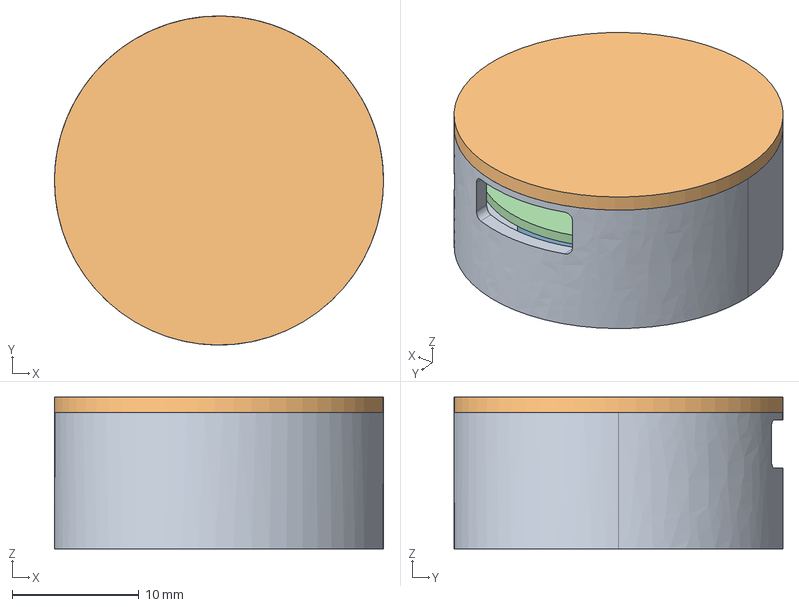
[picture p177: CAD file, 2026-10-24]
mechanical/pendant-fit-study.step
26.0 x 26.0 x 12.0 mm
