nyanko3141592/pendant-recorder/mechanical/structure-d1/exploded.step

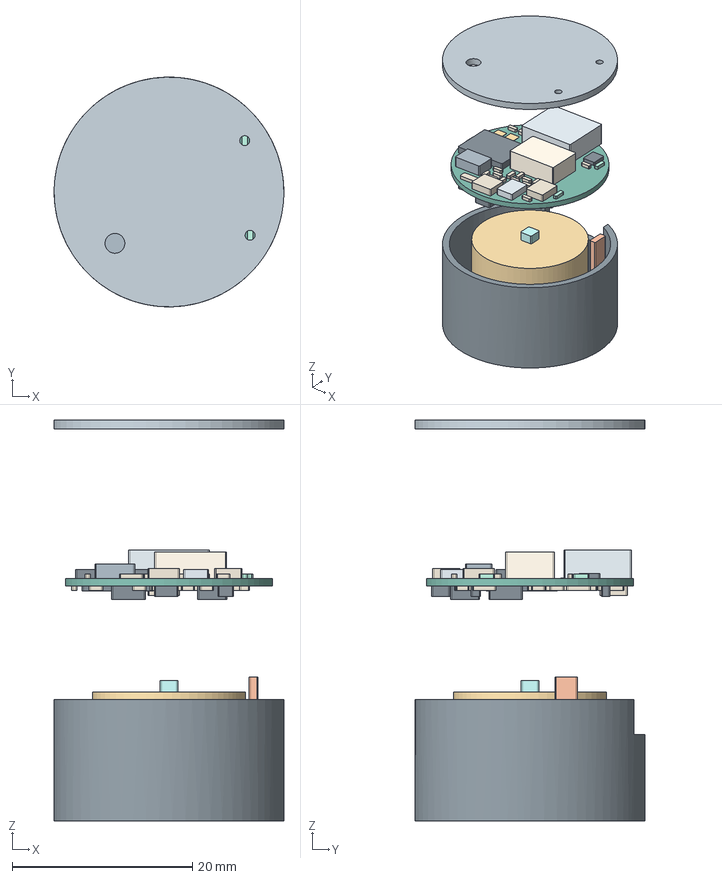
[picture p178: CAD file, 2026-10-24]
mechanical/structure-d1/exploded.step
25.5 x 25.5 x 44.5 mm
