nyanko3141592/pendant-recorder/mechanical/xe-minimal/film-sensor-space-study.step

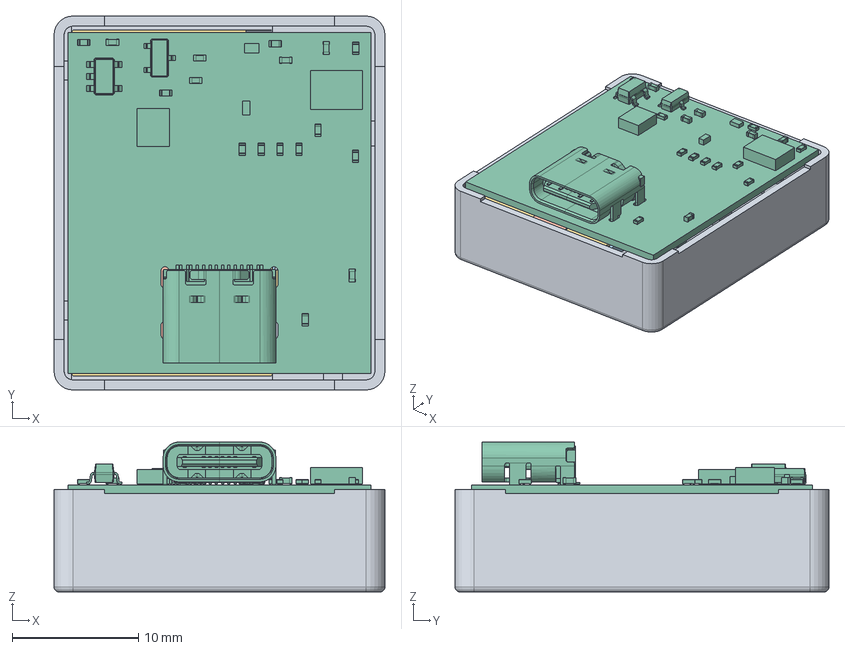
[picture p179: CAD file, 2026-10-29]
mechanical/xe-minimal/film-sensor-space-study.step
26.2 x 29.6 x 11.9 mm
lower
battery
separator
board
UNAPPROVED_sensor_full_envelope
