nyanko3141592/pendant-recorder/mechanical/xe-minimal/home-case-slice-review/current-separator/current-separator.3mf

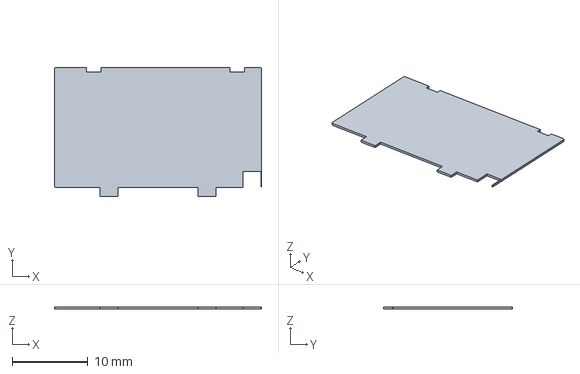
[picture p180: CAD file, 2026-10-29]
mechanical/xe-minimal/home-case-slice-review/current-separator/current-separator.3mf
27.4 x 17.1 x 0.3 mm
