nyanko3141592/pendant-recorder/mechanical/xe-minimal/home-case-slice-review/diagonal-integral-retainer-separator/diagonal-integral-retainer-separator.3mf

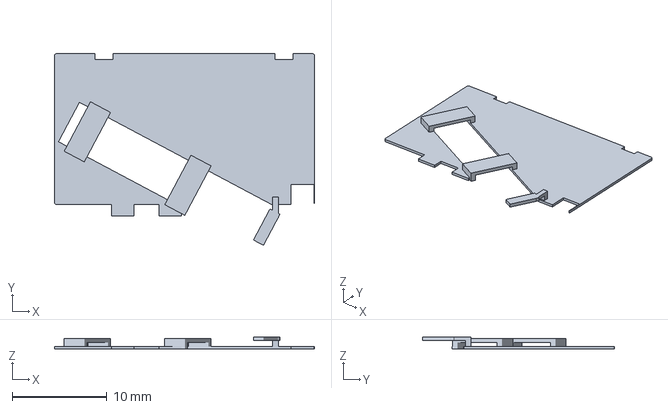
[picture p182: CAD file, 2026-10-29]
mechanical/xe-minimal/home-case-slice-review/diagonal-integral-retainer-separator/diagonal-integral-retainer-separator.3mf
27.4 x 20.2 x 1.30 mm
