nyanko3141592/pendant-recorder/mechanical/xe-minimal/home-case-slice-review/film-axial-stop-relieved-supported-separator/film-axial-stop-relieved-supported-separator.3mf

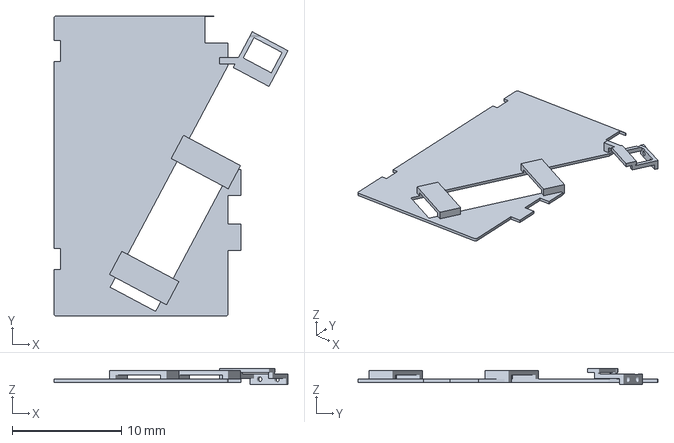
[picture p183: CAD file, 2026-10-29]
mechanical/xe-minimal/home-case-slice-review/film-axial-stop-relieved-supported-separator/film-axial-stop-relieved-supported-separator.3mf
21.4 x 27.4 x 1.50 mm
