nyanko3141592/pendant-recorder/mechanical/xe-minimal/home-case-slice-review/film-battery-end-wide-250um-lower-first018/film-battery-end-wide-250um-lower-first018.3mf

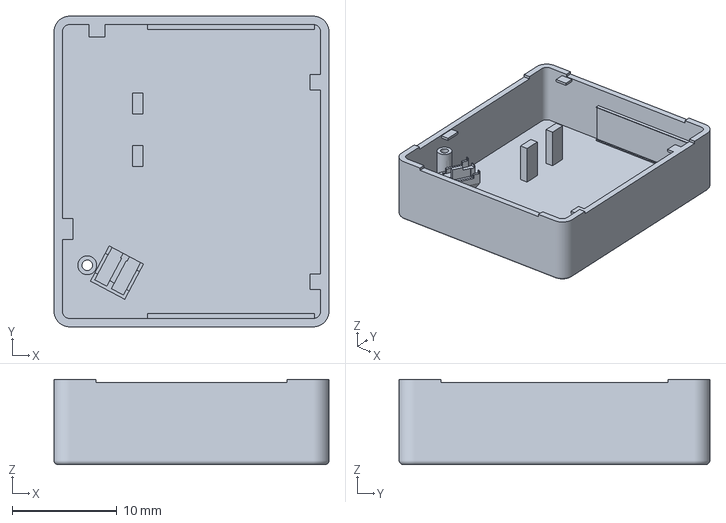
[picture p184: CAD file, 2026-10-29]
mechanical/xe-minimal/home-case-slice-review/film-battery-end-wide-250um-lower-first018/film-battery-end-wide-250um-lower-first018.3mf
26.2 x 29.6 x 8.12 mm
