nyanko3141592/pendant-recorder/mechanical/xe-minimal/home-case-slice-review/film-sensor-body-bridge-supported-flipped-separator/film-sensor-body-bridge-supported-flipped-separator.3mf

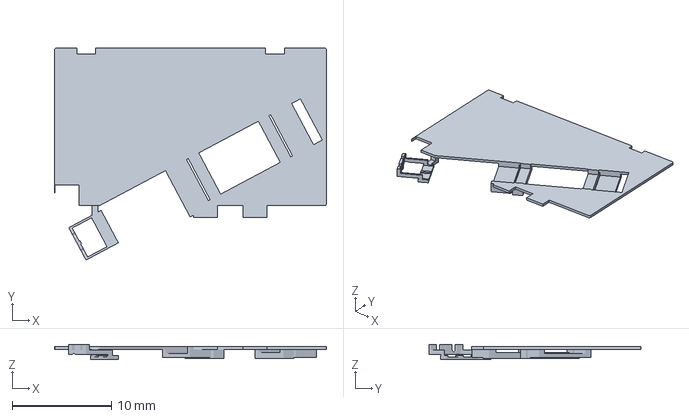
[picture p186: CAD file, 2026-10-29]
mechanical/xe-minimal/home-case-slice-review/film-sensor-body-bridge-supported-flipped-separator/film-sensor-body-bridge-supported-flipped-separator.3mf
27.4 x 21.4 x 1.50 mm
