nyanko3141592/pendant-recorder/mechanical/xe-minimal/home-case-slice-review/film-sensor-clearance-200um-supported-flipped-separator/film-sensor-clearance-200um-supported-flipped-separator.3mf

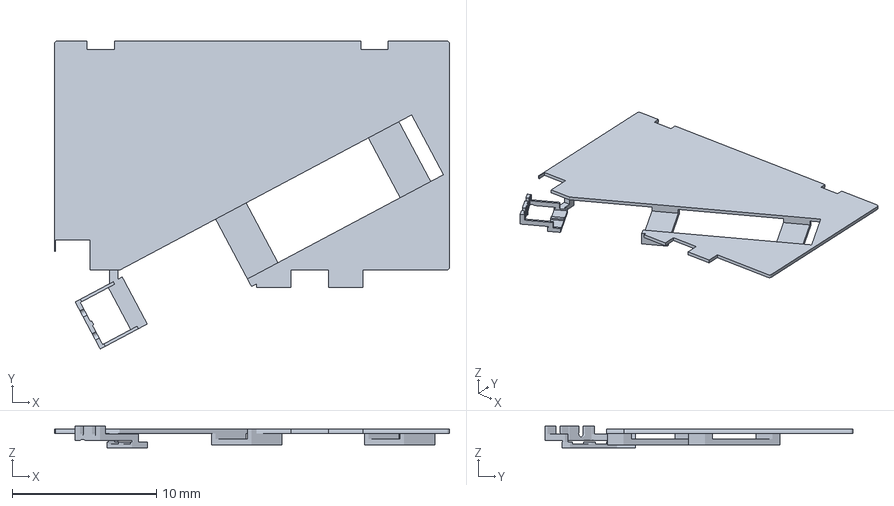
[picture p187: CAD file, 2026-10-29]
mechanical/xe-minimal/home-case-slice-review/film-sensor-clearance-200um-supported-flipped-separator/film-sensor-clearance-200um-supported-flipped-separator.3mf
27.4 x 21.4 x 1.50 mm
