nyanko3141592/pendant-recorder/mechanical/xe-minimal/home-case-slice-review/film-wide-bridge-separator/film-wide-bridge-separator.3mf

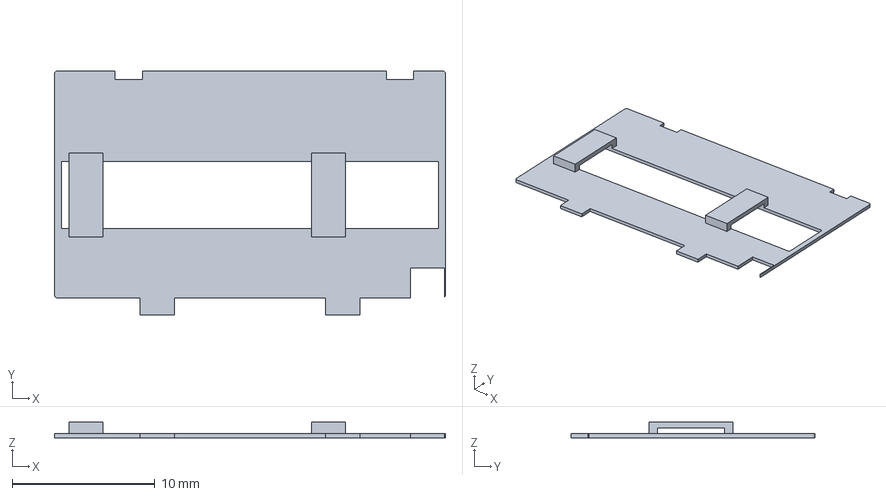
[picture p188: CAD file, 2026-10-29]
mechanical/xe-minimal/home-case-slice-review/film-wide-bridge-separator/film-wide-bridge-separator.3mf
27.4 x 17.1 x 1.10 mm
