nyanko3141592/pendant-recorder/mechanical/xe-minimal/home-case-slice-review/ntcaflex-board-relief-supported-flipped-separator/ntcaflex-board-relief-supported-flipped-separator.3mf

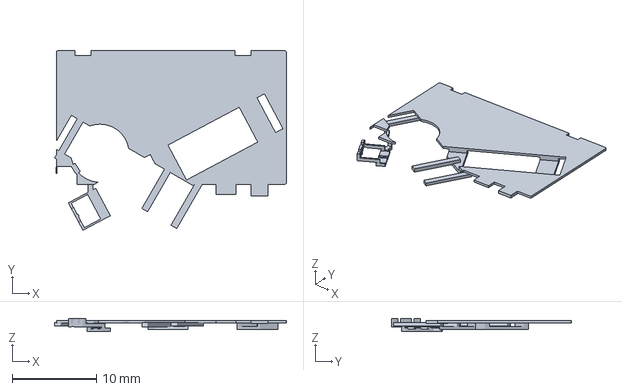
[picture p189: CAD file, 2026-10-29]
mechanical/xe-minimal/home-case-slice-review/ntcaflex-board-relief-supported-flipped-separator/ntcaflex-board-relief-supported-flipped-separator.3mf
27.6 x 21.4 x 1.50 mm
