nyanko3141592/pendant-recorder/mechanical/xe-minimal/home-case-slice-review/ntcaflex-trimmed-supported-flipped-separator/ntcaflex-trimmed-supported-flipped-separator.3mf

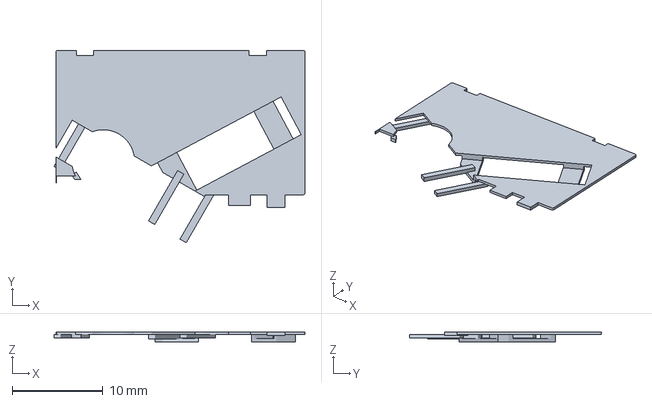
[picture p190: CAD file, 2026-10-29]
mechanical/xe-minimal/home-case-slice-review/ntcaflex-trimmed-supported-flipped-separator/ntcaflex-trimmed-supported-flipped-separator.3mf
27.6 x 21.2 x 1.10 mm
