nyanko3141592/pendant-recorder/mechanical/xe-minimal/home-case-slice-review/tab-clearance-upper/upper.3mf

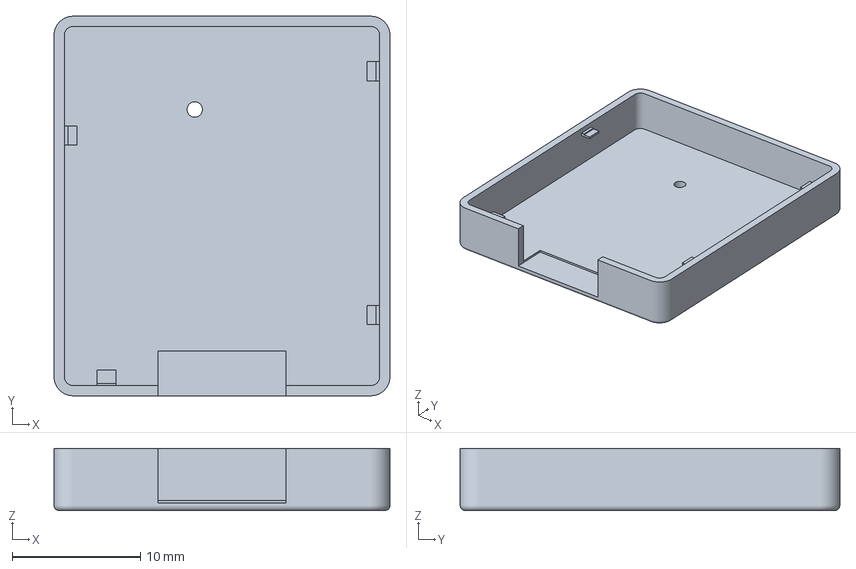
[picture p191: CAD file, 2026-10-29]
mechanical/xe-minimal/home-case-slice-review/tab-clearance-upper/upper.3mf
26.2 x 29.6 x 4.85 mm
