nyanko3141592/pendant-recorder/mechanical/xe-minimal/home-fit-coupons/coupon-layout.step

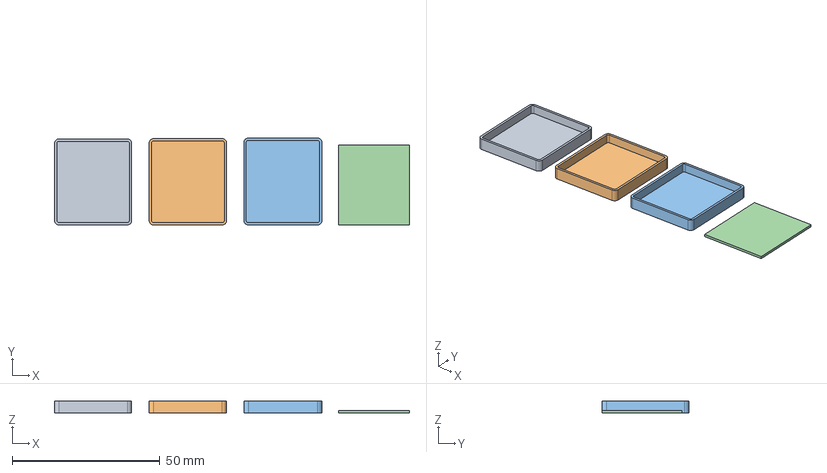
[picture p192: CAD file, 2026-10-29]
mechanical/xe-minimal/home-fit-coupons/coupon-layout.step
120.0 x 29.4 x 4.00 mm
tray-gap-25
tray-gap-30
tray-gap-40
pcb_size_dummy
