nyanko3141592/pendant-recorder/mechanical/xe-minimal/home-fit-coupons/slice-review/coupon-review.3mf

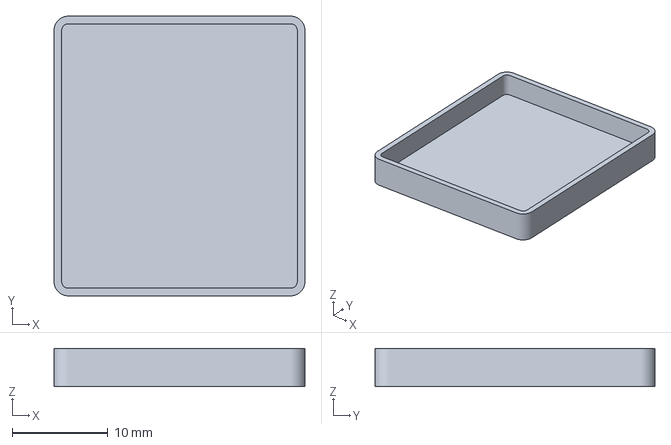
[picture p193: CAD file, 2026-10-29]
mechanical/xe-minimal/home-fit-coupons/slice-review/coupon-review.3mf
26.2 x 29.2 x 4.00 mm
