nyanko3141592/pendant-recorder/mechanical/xe-minimal/preorder-20261029/board-thickness-min.step

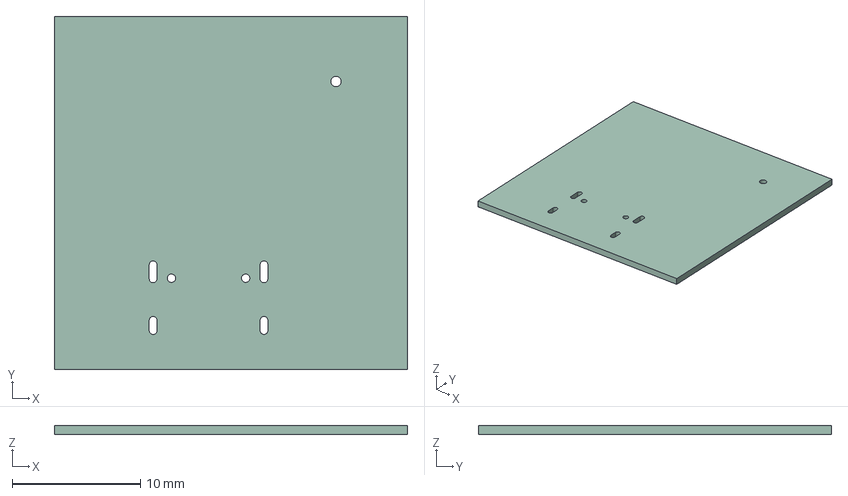
[picture p194: CAD file, 2026-10-29]
mechanical/xe-minimal/preorder-20261029/board-thickness-min.step
27.5 x 27.5 x 0.729 mm
