nyanko3141592/pendant-recorder/mechanical/xe-minimal/preorder-20261029/captured-carrier-case/case-lower.step

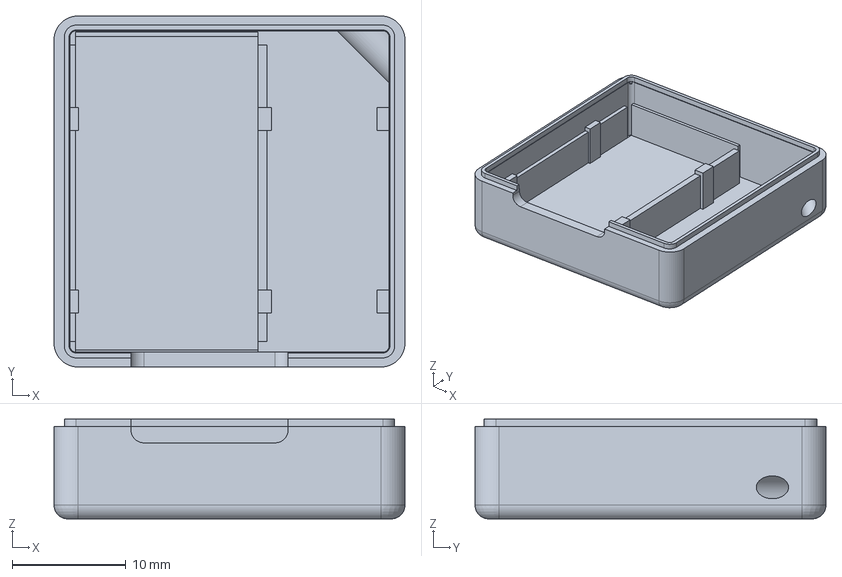
[picture p195: CAD file, 2026-10-29]
mechanical/xe-minimal/preorder-20261029/captured-carrier-case/case-lower.step
30.8 x 30.8 x 8.75 mm
