nyanko3141592/pendant-recorder/mechanical/xe-minimal/preorder-20261029/fit-kit-a1mini/pcba-max-gauge.stl

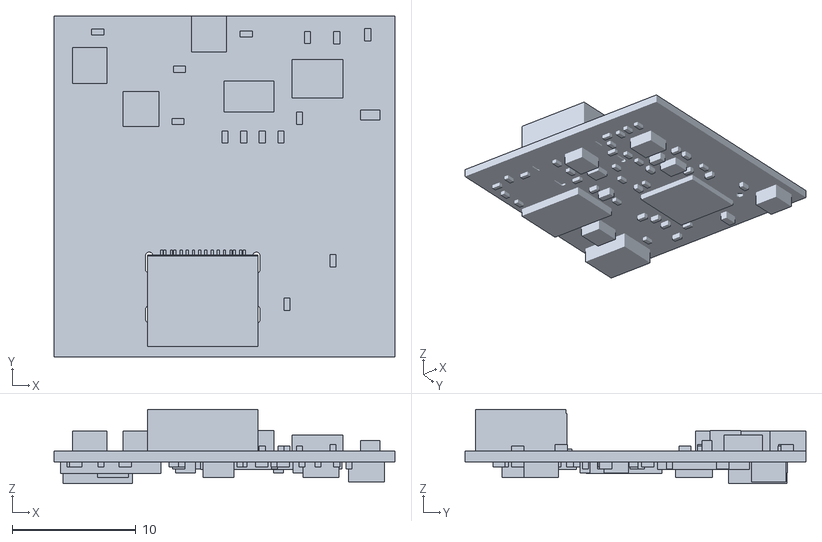
[picture p196: CAD file, 2026-10-29]
mechanical/xe-minimal/preorder-20261029/fit-kit-a1mini/pcba-max-gauge.stl
27.5 x 27.5 x 5.98
