nyanko3141592/pendant-recorder/mechanical/xe-minimal/preorder-20261029/l3-ground-011-fit/current-pcba-envelope.step

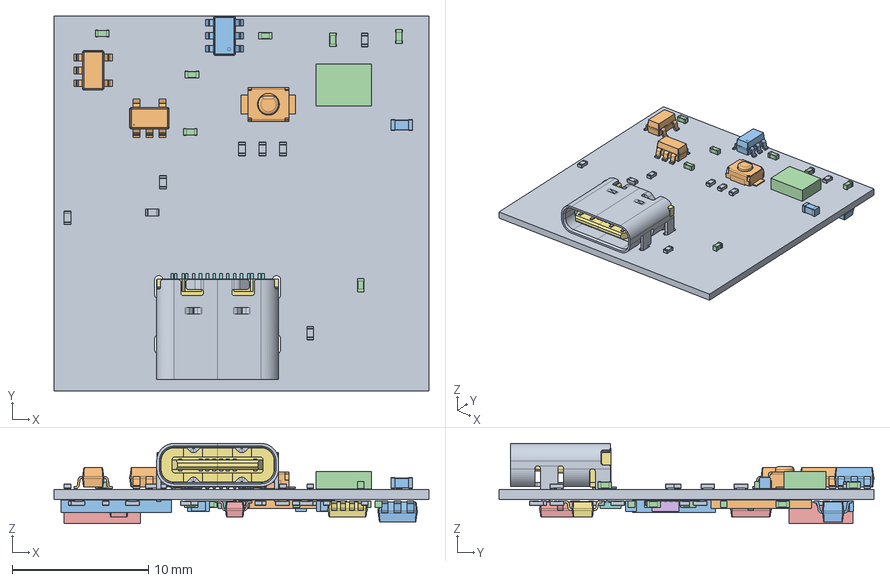
[picture p197: CAD file, 2026-10-29]
mechanical/xe-minimal/preorder-20261029/l3-ground-011-fit/current-pcba-envelope.step
27.5 x 27.5 x 5.88 mm
