nyanko3141592/pendant-recorder/mechanical/xe-minimal/preorder-20261029/prototype-case/a1mini-fit-kit/case-lower.stl

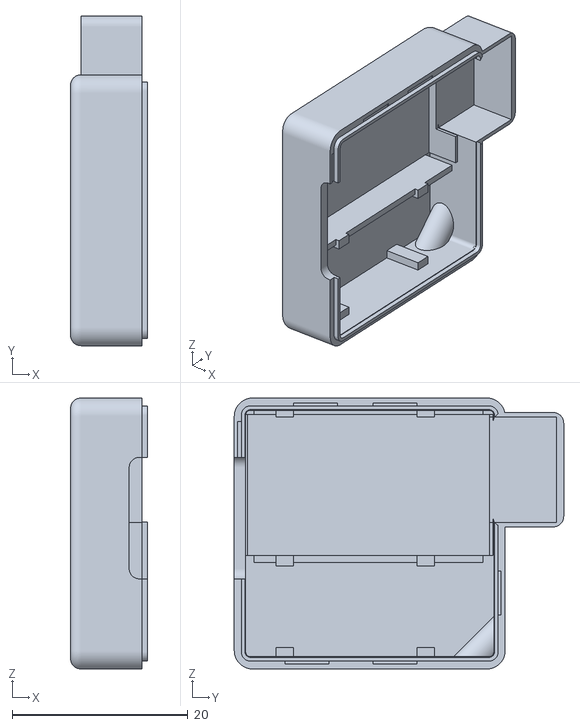
[picture p198: CAD file, 2026-10-29]
mechanical/xe-minimal/preorder-20261029/prototype-case/a1mini-fit-kit/case-lower.stl
8.75 x 37.5 x 30.8
