nyanko3141592/pendant-recorder/mechanical/xe-minimal/preorder-20261029/prototype-case/harness-clearance-envelope.step

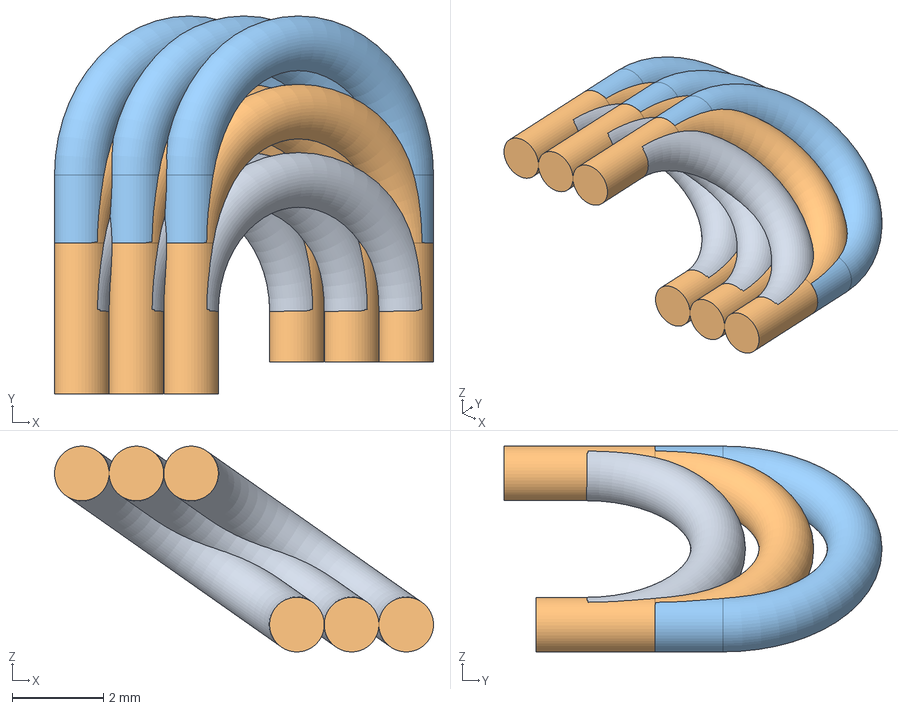
[picture p199: CAD file, 2026-10-29]
mechanical/xe-minimal/preorder-20261029/prototype-case/harness-clearance-envelope.step
8.32 x 8.30 x 4.52 mm
