nyanko3141592/pendant-recorder/mechanical/xe-minimal/preorder-20261029/retained-battery-case/a1mini-fit-kit/case-upper.stl

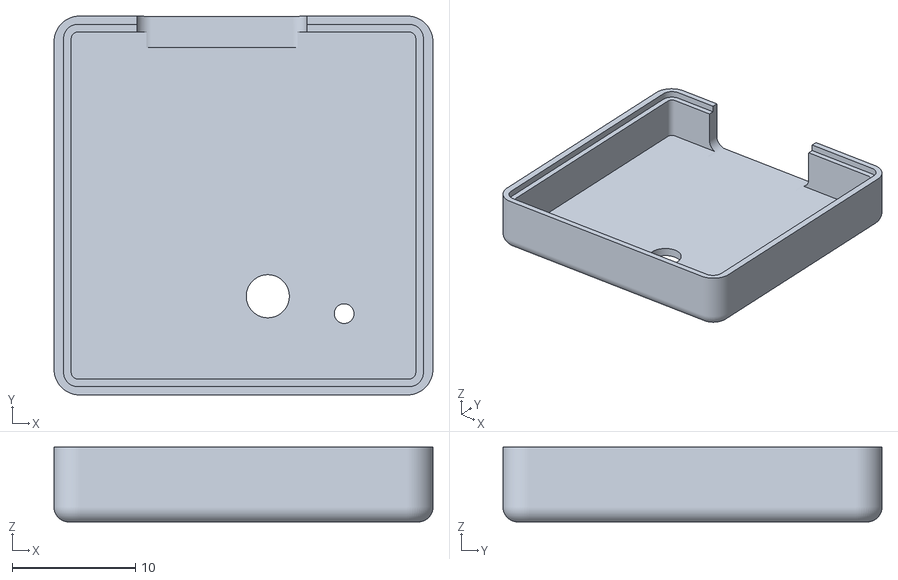
[picture p200: CAD file, 2026-10-29]
mechanical/xe-minimal/preorder-20261029/retained-battery-case/a1mini-fit-kit/case-upper.stl
30.8 x 30.8 x 6.08
