nyanko3141592/pendant-recorder/mechanical/xe-minimal/prototype-v1/actual-30mm-prototype/slice-4objects/actual-30mm-prototype-4objects-a1mini.3mf

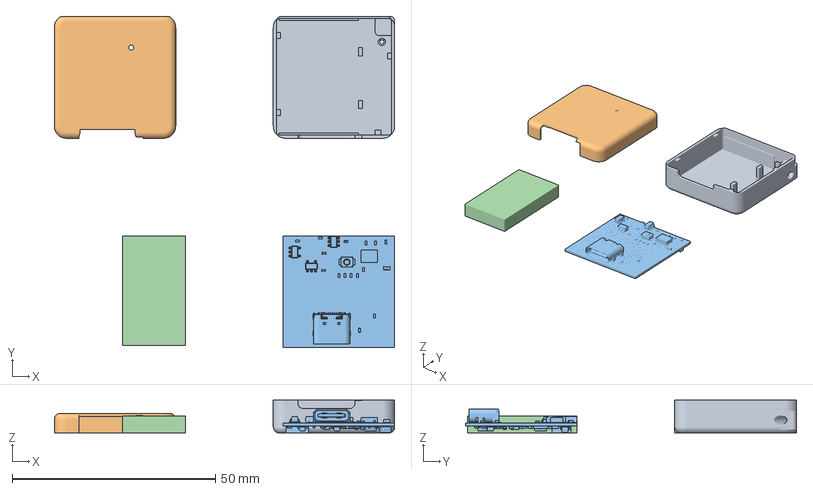
[picture p201: CAD file, 2026-10-29]
mechanical/xe-minimal/prototype-v1/actual-30mm-prototype/slice-4objects/actual-30mm-prototype-4objects-a1mini.3mf
83.8 x 81.5 x 8.12 mm
case-lower-corner-cord.stl
case-upper-rounded.stl
actual-populated-pcb-complete.stl
dtp401525-xe-max-body.stl
