nyanko3141592/pendant-recorder/mechanical/xe-minimal/prototype-v1/actual-30mm-prototype/slice/actual-30mm-prototype-a1mini.3mf

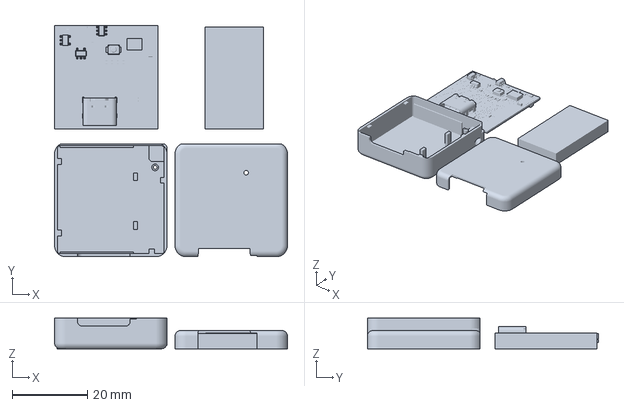
[picture p202: CAD file, 2026-10-29]
mechanical/xe-minimal/prototype-v1/actual-30mm-prototype/slice/actual-30mm-prototype-a1mini.3mf
61.9 x 61.5 x 8.12 mm
