nyanko3141592/pendant-recorder/mechanical/xe-minimal/prototype-v1/actual-fit-case-v3/a1mini-4objects/hw-v1.4-4layer-case-v3-4objects-a1mini.3mf

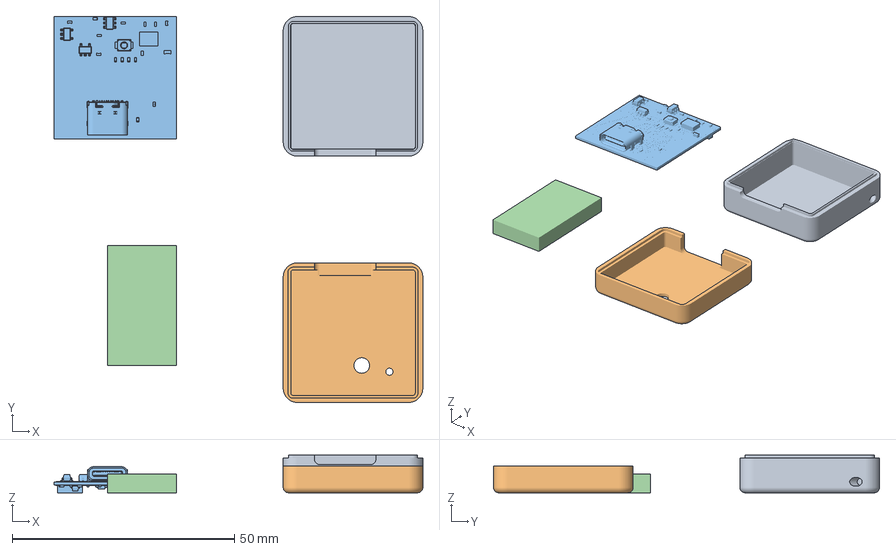
[picture p203: CAD file, 2026-10-29]
mechanical/xe-minimal/prototype-v1/actual-fit-case-v3/a1mini-4objects/hw-v1.4-4layer-case-v3-4objects-a1mini.3mf
82.9 x 86.8 x 8.45 mm
case-v3-lower.stl
case-v3-upper.stl
hw-v1.4-4layer-populated.stl
dtp401525-xe-max-body.stl
