nyanko3141592/pendant-recorder/mechanical/xe-minimal/prototype-v1/fixed-board-compact-review/baseline-upper.step

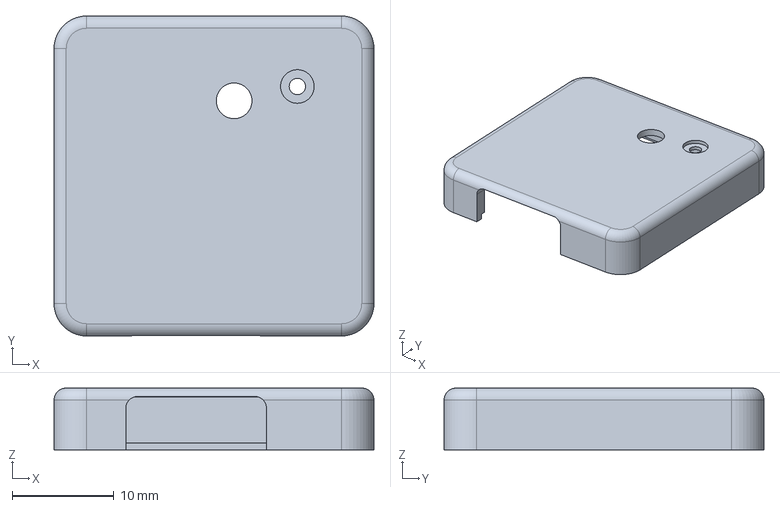
[picture p204: CAD file, 2026-10-29]
mechanical/xe-minimal/prototype-v1/fixed-board-compact-review/baseline-upper.step
31.4 x 31.4 x 6.08 mm
