nyanko3141592/pendant-recorder/mechanical/xe-minimal/prototype-v1/pebble-v5-slice-review/case-pebble-v5-lower/case-pebble-v5-lower.3mf

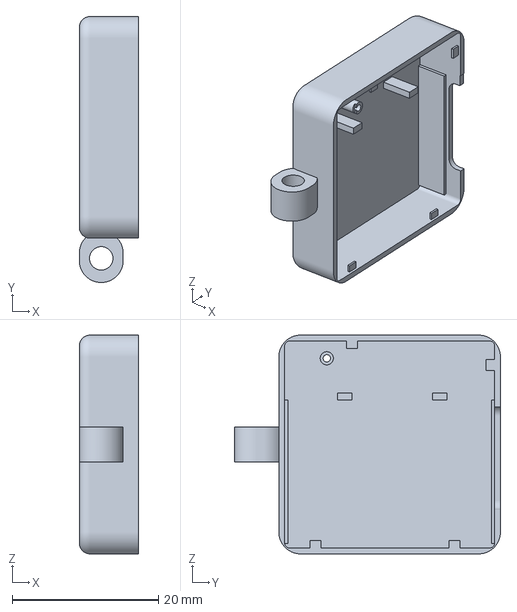
[picture p205: CAD file, 2026-10-29]
mechanical/xe-minimal/prototype-v1/pebble-v5-slice-review/case-pebble-v5-lower/case-pebble-v5-lower.3mf
8.12 x 36.3 x 29.9 mm
