nyanko3141592/pendant-recorder/mechanical/xe-minimal/prototype-v1/pebble-v5-slice-review/case-pebble-v5-upper.stl

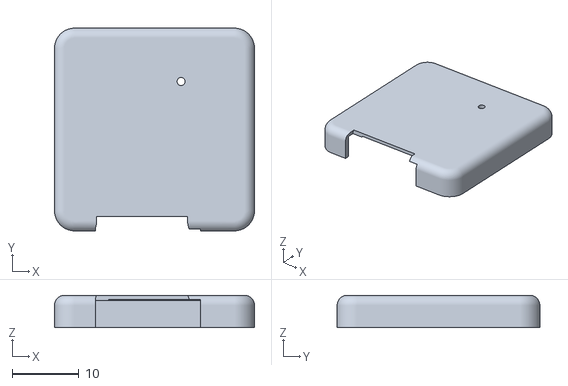
[picture p206: CAD file, 2026-10-29]
mechanical/xe-minimal/prototype-v1/pebble-v5-slice-review/case-pebble-v5-upper.stl
29.9 x 30.3 x 4.85
