nyanko3141592/pendant-recorder/mechanical/xe-minimal/prototype-v1/placement-compact-study/top-battery-outer-envelope-NOT-CASE.step

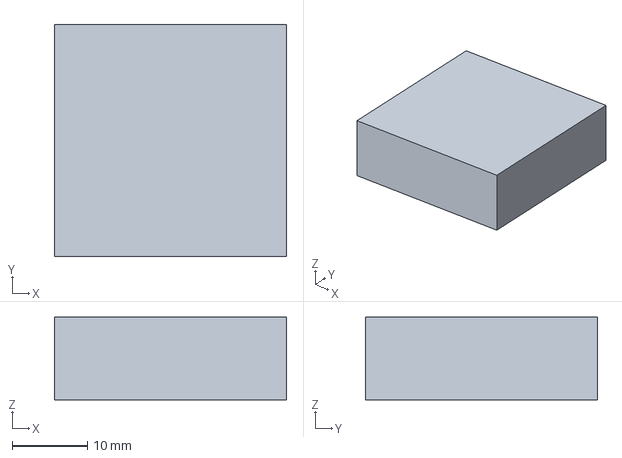
[picture p207: CAD file, 2026-10-29]
mechanical/xe-minimal/prototype-v1/placement-compact-study/top-battery-outer-envelope-NOT-CASE.step
30.8 x 30.8 x 11.0 mm
