nyanko3141592/pendant-recorder/mechanical/xe-minimal/prototype-v1/size-fit-print-kit-v1-slice/job/hw-v1-size-fit-print-kit-v1.3mf

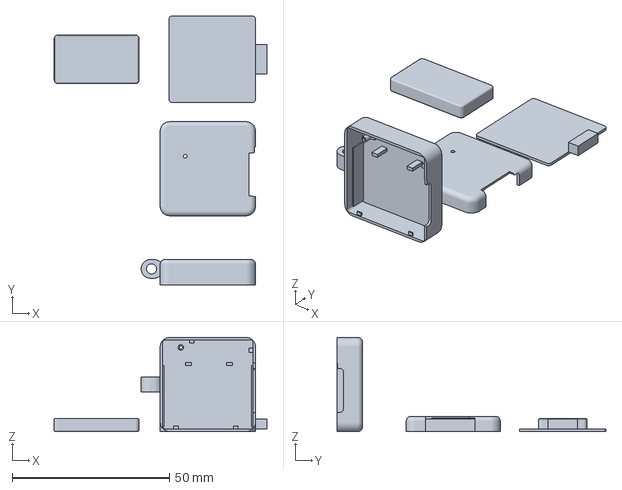
[picture p208: CAD file, 2026-10-29]
mechanical/xe-minimal/prototype-v1/size-fit-print-kit-v1-slice/job/hw-v1-size-fit-print-kit-v1.3mf
67.6 x 85.5 x 29.9 mm
