nyanko3141592/pendant-recorder/mechanical/xe-minimal/prototype-v1/slice-review/case-lower-v1/case-lower-v1.3mf

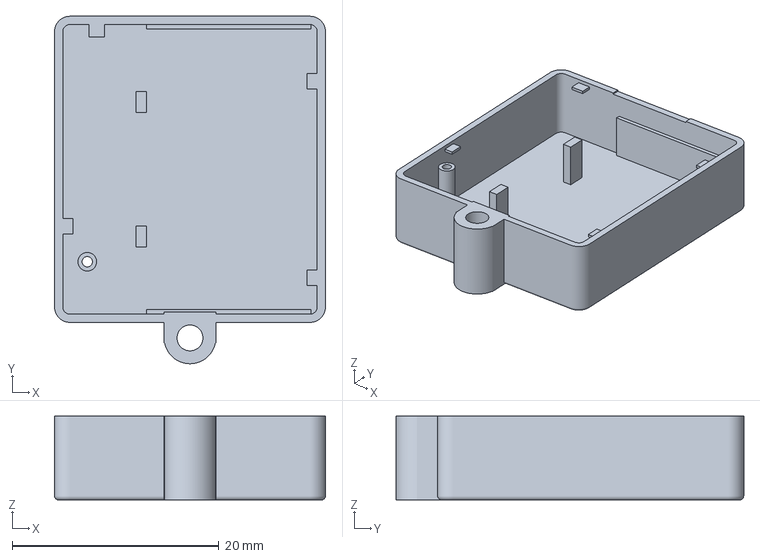
[picture p209: CAD file, 2026-10-29]
mechanical/xe-minimal/prototype-v1/slice-review/case-lower-v1/case-lower-v1.3mf
26.2 x 33.6 x 8.12 mm
