nyanko3141592/pendant-recorder/mechanical/xe-minimal/prototype-v1/slice-review/case-upper-v1.stl

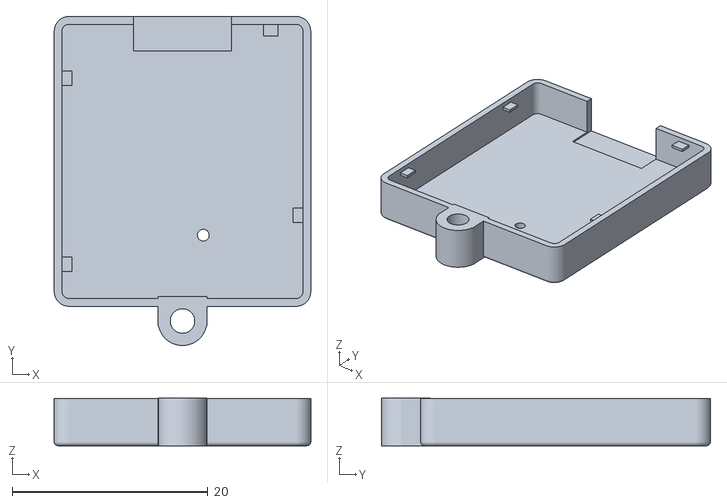
[picture p210: CAD file, 2026-10-29]
mechanical/xe-minimal/prototype-v1/slice-review/case-upper-v1.stl
26.2 x 33.6 x 4.85
