nyanko3141592/pendant-recorder/mechanical/xe-minimal/prototype-v1/slice-review/sensor-carrier-v1/sensor-carrier-v1.3mf

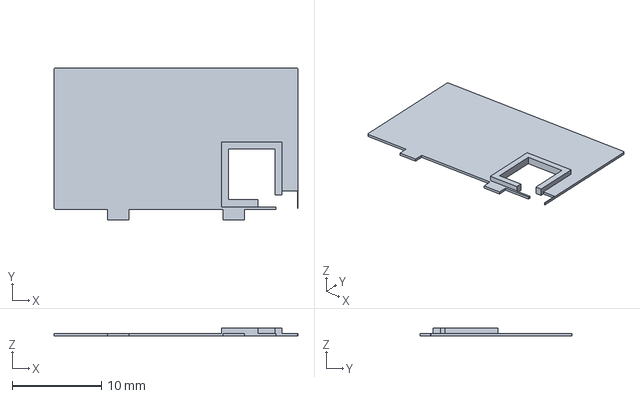
[picture p211: CAD file, 2026-10-29]
mechanical/xe-minimal/prototype-v1/slice-review/sensor-carrier-v1/sensor-carrier-v1.3mf
27.4 x 17.1 x 0.9 mm
