nyanko3141592/pendant-recorder/mechanical/xe-minimal/prototype-v1/styled-slice-review/case-pebble-r23-lower.stl

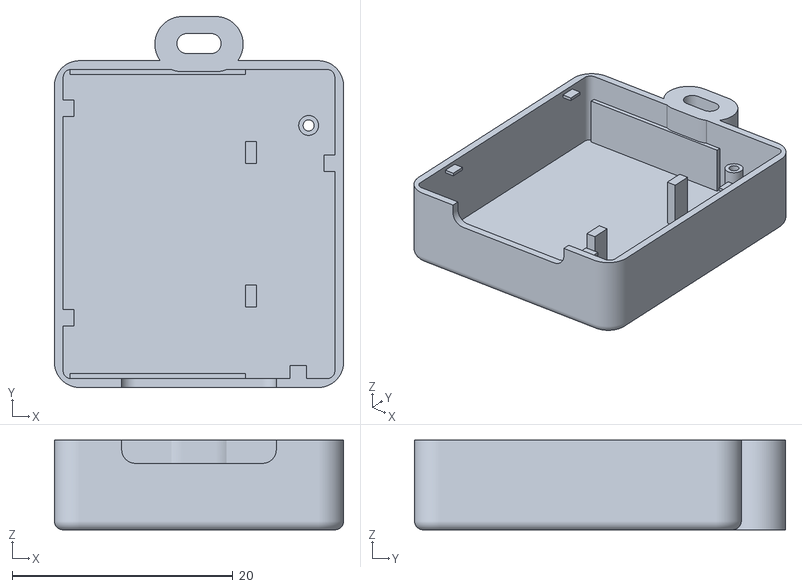
[picture p212: CAD file, 2026-10-29]
mechanical/xe-minimal/prototype-v1/styled-slice-review/case-pebble-r23-lower.stl
26.2 x 33.6 x 8.12
