nyanko3141592/pendant-recorder/mechanical/xe-minimal/prototype-v1/styled-slice-review/case-pebble-r23-upper/case-pebble-r23-upper.3mf

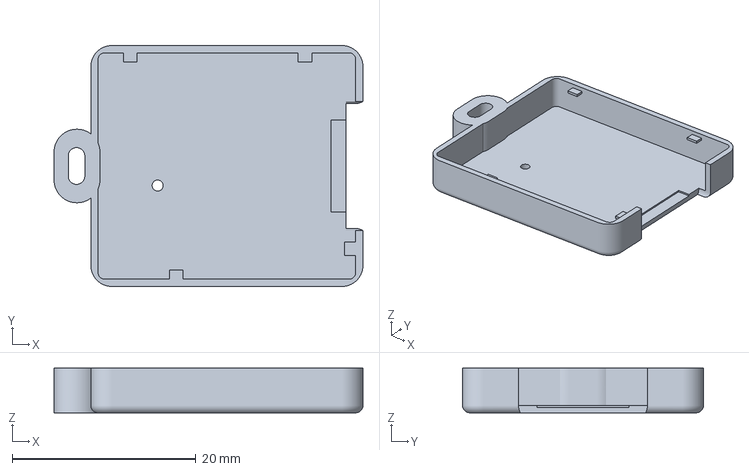
[picture p213: CAD file, 2026-10-29]
mechanical/xe-minimal/prototype-v1/styled-slice-review/case-pebble-r23-upper/case-pebble-r23-upper.3mf
33.6 x 26.2 x 4.85 mm
