nyanko3141592/pendant-recorder/reference/omi/mechanical-size-check/wrapper.step

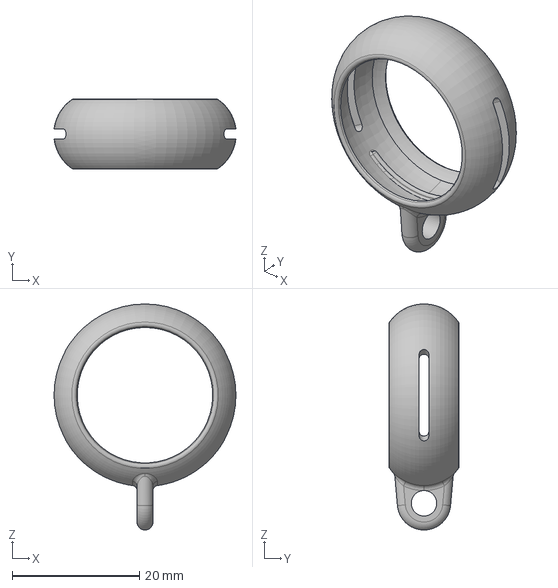
[picture p214: CAD file, 2026-10-29]
reference/omi/mechanical-size-check/wrapper.step
28.6 x 11.0 x 35.5 mm
