nyanko3141592/pendant-recorder/hardware/xe-minimal/current-single-carrier-trial/rounded-fabrication-review/carrier-substrate.step

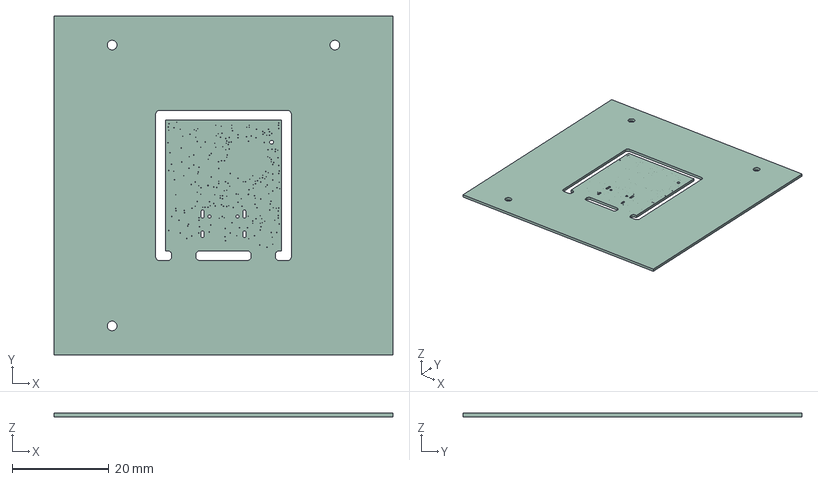
[picture p215: CAD file, 2026-10-29]
hardware/xe-minimal/current-single-carrier-trial/rounded-fabrication-review/carrier-substrate.step
70.0 x 70.0 x 0.756 mm
