nyanko3141592/pendant-recorder/hardware/xe-minimal/preorder-20261029/release-review-20261029-aligned/fit-kit/u1-max-body.step

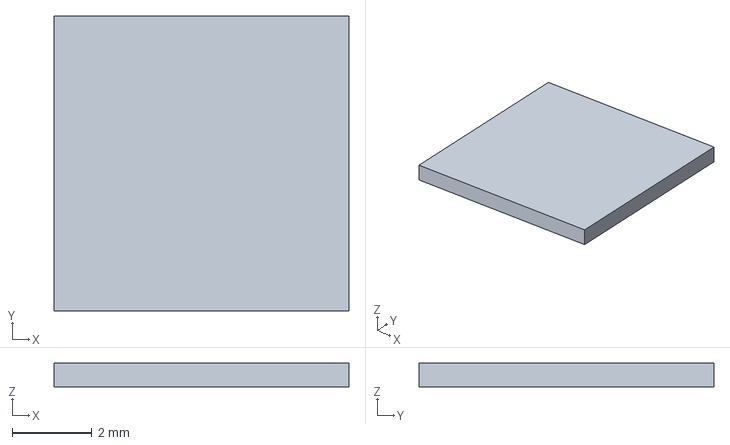
[picture p216: CAD file, 2026-10-29]
hardware/xe-minimal/preorder-20261029/release-review-20261029-aligned/fit-kit/u1-max-body.step
7.40 x 7.40 x 0.6 mm
