nyanko3141592/pendant-recorder/hardware/xe-minimal/preorder-20261029/release-review-20261029-aligned/mechanical-first-prototype/a1mini-fit-kit/case-upper.stl

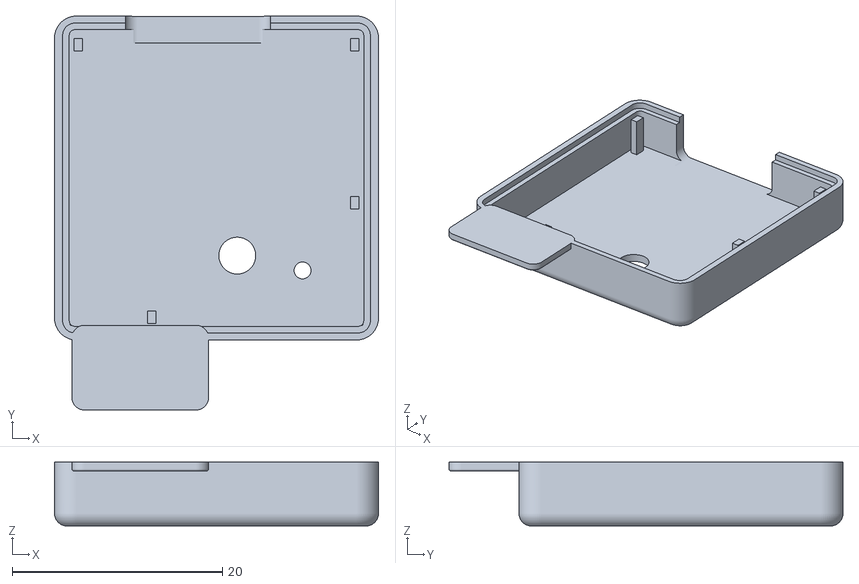
[picture p217: CAD file, 2026-10-29]
hardware/xe-minimal/preorder-20261029/release-review-20261029-aligned/mechanical-first-prototype/a1mini-fit-kit/case-upper.stl
30.8 x 37.5 x 6.08
