nyanko3141592/pendant-recorder/hardware/xe-minimal/preorder-20261029/release-review-20261029/fit-kit/fit-kit-a1mini/case-lower.stl

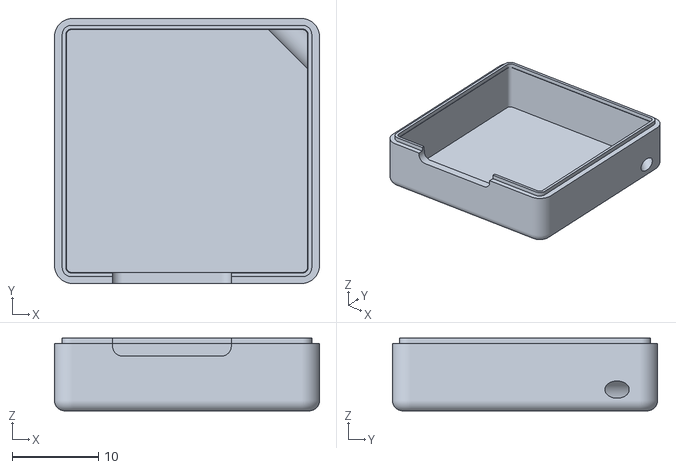
[picture p218: CAD file, 2026-10-29]
hardware/xe-minimal/preorder-20261029/release-review-20261029/fit-kit/fit-kit-a1mini/case-lower.stl
30.8 x 30.8 x 8.45
