nyanko3141592/pendant-recorder/(list of files, cad)

Other CAD files:
mechanical/xe-minimal/prototype-v1/fixed-board-compact-v1/case-compact-v1-actual-assembly.step
mechanical/xe-minimal/preorder-20261029/retained-battery-case/assembly.step
mechanical/xe-minimal/prototype-v1/actual-fit-case-v3/case-v3-actual-assembly.step
mechanical/xe-minimal/prototype-v1/case-pebble-r23-assembly.step
hardware/xe-minimal/preorder-20261029/release-review-20261029-aligned/mechanical-cradle-study/assembly.step
mechanical/xe-minimal/prototype-v1/case-assembly-v1.step
mechanical/xe-minimal/prototype-v1/case-assembly-candidate-v1.step
mechanical/xe-minimal/supported-case-assembly-study.step
mechanical/xe-minimal/separator-case-assembly-study.step
mechanical/xe-minimal/film-integrated-assembly-study.step
hardware/xe-minimal/preorder-20261029/release-review-20261029/current-native-pcba.step
hardware/xe-minimal/preorder-20261029/release-review-20261029/fit-kit/fit-kit-a1mini/current-fit-kit.3mf
mechanical/xe-minimal/home-case-slice-review/adhesive-pocket-032/adhesive-pocket.3mf
mechanical/xe-minimal/home-case-slice-review/adhesive-pocket-aligned/adhesive-pocket.3mf
mechanical/xe-minimal/home-case-slice-review/adhesive-pocket/adhesive-pocket.3mf
mechanical/xe-minimal/home-case-slice-review/arachne-four-wall-lower/arachne-four-wall-lower.3mf
mechanical/xe-minimal/home-case-slice-review/arachne-lower/arachne-lower.3mf
mechanical/xe-minimal/home-case-slice-review/current-lower/current-lower.3mf
mechanical/xe-minimal/home-case-slice-review/diagonal-integral-retainer-supported-separator/diagonal-integral-retainer-supported-separator.3mf
mechanical/xe-minimal/home-case-slice-review/diagonal-recessed-cap-lower/diagonal-recessed-cap-lower.3mf
mechanical/xe-minimal/home-case-slice-review/diagonal-tapered-tray-lower/diagonal-tapered-tray-lower.3mf
mechanical/xe-minimal/home-case-slice-review/diagonal-tray-mounted-lower/diagonal-tray-mounted-lower.3mf
mechanical/xe-minimal/home-case-slice-review/film-axial-stop-relieved-lower/film-axial-stop-relieved-lower.3mf
mechanical/xe-minimal/home-case-slice-review/film-axial-stop-seat-clearance-lower/film-axial-stop-seat-clearance-lower.3mf
mechanical/xe-minimal/home-case-slice-review/film-battery-end-wide-250um-lower/film-battery-end-wide-250um-lower.3mf
mechanical/xe-minimal/home-case-slice-review/film-battery-end-wide-350um-lower-first018/film-battery-end-wide-350um-lower-first018.3mf
mechanical/xe-minimal/home-case-slice-review/film-battery-side-support-lower-first018/film-battery-side-support-lower-first018.3mf
mechanical/xe-minimal/home-case-slice-review/film-battery-side-support-lower/film-battery-side-support-lower.3mf
mechanical/xe-minimal/home-case-slice-review/film-bottom-slot-supported-separator/film-bottom-slot-supported-separator.3mf
mechanical/xe-minimal/home-case-slice-review/film-lead-wrap-clearance-lower/film-lead-wrap-clearance-lower.3mf
mechanical/xe-minimal/home-case-slice-review/film-open-joint-pockets-lower/film-open-joint-pockets-lower.3mf
mechanical/xe-minimal/home-case-slice-review/film-roomier-joint-supported-fine-separator/film-roomier-joint-supported-fine-separator.3mf
mechanical/xe-minimal/home-case-slice-review/film-roomier-joint-supported-flipped-separator/film-roomier-joint-supported-flipped-separator.3mf
mechanical/xe-minimal/home-case-slice-review/film-roomier-joint-supported-no-floating-shell-separator/film-roomier-joint-supported-no-floating-shell-separator.3mf
mechanical/xe-minimal/home-case-slice-review/film-roomier-joint-supported-separator/film-roomier-joint-supported-separator.3mf
mechanical/xe-minimal/home-case-slice-review/film-sensor-clearance-200um-lower-first018/film-sensor-clearance-200um-lower-first018.3mf
mechanical/xe-minimal/home-case-slice-review/fine-lower/fine-lower.3mf
mechanical/xe-minimal/home-case-slice-review/four-wall-lower/four-wall-lower.3mf
mechanical/xe-minimal/home-case-slice-review/lower/lower.3mf
mechanical/xe-minimal/home-case-slice-review/ntcaflex-relocated-support-lower-first018/ntcaflex-relocated-support-lower-first018.3mf
mechanical/xe-minimal/home-case-slice-review/solid-fine-lower/solid-fine-lower.3mf
mechanical/xe-minimal/home-case-slice-review/thickness-clearance-upper/upper.3mf
mechanical/xe-minimal/home-case-slice-review/upper.stl
mechanical/xe-minimal/home-case-slice-review/upper/upper.3mf
mechanical/xe-minimal/home-case-slice-review/wider-right-lower/wider-right-lower.3mf
mechanical/xe-minimal/preorder-20261029/retained-battery-case/separator.step
mechanical/xe-minimal/prototype-v1/actual-fit-case-v3/actual-populated-pcb.step
mechanical/xe-minimal/prototype-v1/fixed-board-compact-v1/a1mini-4objects/case-compact-v1-upper.stl
mechanical/xe-minimal/prototype-v1/pebble-v5-slice-review/case-pebble-v5-upper/case-pebble-v5-upper.3mf
mechanical/xe-minimal/prototype-v1/slice-review/case-upper-v1/case-upper-v1.3mf
mechanical/xe-minimal/prototype-v1/styled-slice-review/case-pebble-r23-lower/case-pebble-r23-lower.3mf
hardware/xe-minimal/preorder-20261029/release-review-20261029-aligned/fit-kit/fit-kit-a1mini/case-upper.stl
hardware/xe-minimal/preorder-20261029/release-review-20261029-aligned/mechanical-captured-carrier/battery-max-positioned.step
hardware/xe-minimal/preorder-20261029/release-review-20261029-aligned/mechanical-cradle-study/pcba-dummy.step
hardware/xe-minimal/preorder-20261029/release-review-20261029-aligned/mechanical-first-prototype/case-lower.step
hardware/xe-minimal/fixed-usb-limit-trial/tps22950-maximum-envelope.step
hardware/xe-minimal/preorder-20261029/release-review-20261029-aligned/evidence/official-connector-models/0781710003-ap203.stp
hardware/xe-minimal/preorder-20261029/release-review-20261029-aligned/evidence/official-connector-models/0781710003.stp
hardware/xe-minimal/preorder-20261029/release-review-20261029-aligned/evidence/official-connector-models/0781720003.stp
hardware/xe-minimal/preorder-20261029/release-review-20261029-aligned/fit-kit/current-pcba-envelope.step
hardware/xe-minimal/preorder-20261029/release-review-20261029-aligned/fit-kit/current-pcba-envelope.stl
hardware/xe-minimal/preorder-20261029/release-review-20261029-aligned/fit-kit/fit-kit-a1mini/pcba-max-gauge.stl
hardware/xe-minimal/preorder-20261029/release-review-20261029-aligned/fit-kit/pcba-max-thickness-connected-gauge.step
hardware/xe-minimal/preorder-20261029/release-review-20261029-aligned/fit-kit/pcba-max-thickness-connected-gauge.stl
hardware/xe-minimal/preorder-20261029/release-review-20261029-aligned/mechanical-captured-carrier/a1mini-fit-kit/captured-carrier-fit-kit.3mf
hardware/xe-minimal/preorder-20261029/release-review-20261029-aligned/mechanical-captured-carrier/a1mini-fit-kit/carrier.stl
hardware/xe-minimal/preorder-20261029/release-review-20261029-aligned/mechanical-captured-carrier/a1mini-fit-kit/case-lower.stl
hardware/xe-minimal/preorder-20261029/release-review-20261029-aligned/mechanical-captured-carrier/a1mini-fit-kit/case-upper.stl
hardware/xe-minimal/preorder-20261029/release-review-20261029-aligned/mechanical-captured-carrier/a1mini-fit-kit/pcba-max-gauge.stl
hardware/xe-minimal/preorder-20261029/release-review-20261029-aligned/mechanical-captured-carrier/battery-growth-reserve.step
hardware/xe-minimal/preorder-20261029/release-review-20261029-aligned/mechanical-captured-carrier/battery-growth-reserve.stl
hardware/xe-minimal/preorder-20261029/release-review-20261029-aligned/mechanical-captured-carrier/carrier.step
hardware/xe-minimal/preorder-20261029/release-review-20261029-aligned/mechanical-captured-carrier/carrier.stl
hardware/xe-minimal/preorder-20261029/release-review-20261029-aligned/mechanical-captured-carrier/case-lower.stl
hardware/xe-minimal/preorder-20261029/release-review-20261029-aligned/mechanical-captured-carrier/case-upper.step
hardware/xe-minimal/preorder-20261029/release-review-20261029-aligned/mechanical-captured-carrier/case-upper.stl
hardware/xe-minimal/preorder-20261029/release-review-20261029-aligned/mechanical-captured-carrier/pcba-max-gauge.step
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
