nyanko3141592/pendant-recorder/docs/v1-build.md

# v1 — 個人製作と基板密度を優先

> **履歴資料・発注禁止。** この文書は円形、21mm基板、Rev A、個人書込みを含む旧方針の時系列記録。現行の単一候補と優先順位は [`requirements.md`](requirements.md)、製造可否は [`prototype-v1-order-decision.json`](prototype-v1-order-decision.json)を正本とする。

> 最新追加: [保存時暗号化と初期外観設計](decisions/0002-encryption-and-industrial-design.md)を優先。登録PCの鍵で復号する暗号化保存をv1要件に追加（未実装）。従来の平文WAV直読・外観後回しの記述は旧仕様。樹脂3Dプリントから始め、金属外装への移行を考慮する。

> 最新のv1定義: [製品方針](decisions/0001-product-and-v1.md)と[開発フロー](development-flow.md)を優先。v1は実装済み基板を購入し、無はんだで書込み・試験する最初の反復。書込み/計測治具も自作はんだ不要。旧円形/22mm固定・50mA設定は現要件ではない。

> 製造方針: [JLCPCBで部品実装まで依頼](jlcpcb-assembly.md)。両面Standard PCBAを第一候補とし、実装用在庫・全フットプリント・製造レビューを確認して採用する。現回路の全品番受理は未確認。

> 最新: [既製電池の調達を起点に最小化](battery-sourcing.md)。DTP401525(PHR) 110mAhを第一候補とし、外形24×24×14mm・基板21×21mmへの固定を解除。メーカー最大充電55mAに対する現回路50mAの公差確認は未完了。

> 最新追記: 円形制約を解除。Omi相当の小ささで密度を優先し、24×24×14mm角丸外形・21×21mm両面基板を第一の検討枠とする。未配置・未検証。以下の円形寸法は従来の比較案として保持。[最新方針](density-study.md)。

2026-10-24のユーザー指示: 「個人で作れる範囲まで」「v1なのでデザインは一旦おいておいてシンプルで」「回路的に密度高ければいい」。外観4案の選定・仕上げは保留する。追記指示「Omiと同じサイズを目指す」により、装着用v1もOmi相当のサイズを目標にする。

> 録音目標は[連続24時間](runtime-target.md)。100mAh級を初期配置候補に80〜150mAhを比較する。旧48時間比較は履歴であり現在の要件ではない。

## 製作方針

個人製作は、小ロットの基板製造・部品実装を外注し、ケースへの組み付け、ファーム書込み、計測を自分で行う方式を設計上の前提とする。全端子の手はんだを前提にはしない。業者の対応可否、部品調達、費用はまだ確認していない。発注は未実施。

- 単一のカスタム基板に集約。開発モジュールの積み重ねを完成形にしない。
- 装着用v1はOmi Consumer相当の直径約25.5mm・厚さ約15mmを目標にする（[既存調査と出典](omi-reference.md)）。内部基板は直径22mmを初期の配置枠とし、USB-C・固定部・壁厚を含めて検証する。30mm角・4層版は電気検証用に限定する。
- 通常の貫通ビアで設計する。v1はHDI、ブラインドビア、ビアインパッド充填を必要とする密度を狙わない。
- 両面実装も候補に含め、電池との絶縁・膨張余裕を含めて高さを見積もる。片面実装への固定で本体を大型化しない。
- STM32U535RCT6 / LQFP64は電気検証用。装着用は22mm枠への配置成立を確認し、不成立なら小型パッケージを再選定する。BGAも実装業者の対応と通常ビアでの配線可否を確認して比較する。48ピンCBU6にはSDMMC端子がないため戻さない。
- 0402などの微小部品は実装業者が扱う。手作業の電池接続・書込み・測定箇所には作業空間を残す。密度より検証可能性を優先する箇所を明確にする。

## 現回路の実装難度

以下はRev A0の候補パッケージ。フットプリントと実装業者の受入条件は未確定。小さいことと、個人が安価に調達・製造できることは別に確認する。

| 部品 | 現候補 | v1での扱い |
|---|---|---|
| MCU | STM32U535RCT6 / LQFP64 | 電気検証用。装着用のパッケージは22mm枠への配置検証後に確定 |
| 充電IC | BQ25101 / DSBGA6 | 手はんだ対象外。調達・実装可否を先に照会し、不成立なら回路ごと代替検討 |
| マイク信号変換 | TXS0104E / WCSP12 | 同上。必要なら大きいパッケージ候補を端子表から再検証 |
| SD電源スイッチ | TPS22916 / WCSP4 | 同上。代替時は漏れ電流・突入電流・電源断時の挙動も比較 |
| マイク | T5838 / 底面音孔LGA | 業者実装。基板音孔とケースまでの音響経路を配置時に確保 |
| 内蔵ストレージ | SD NAND 4GB / LGA8 | 業者実装。調達と書込電力を確認して採用確定 |
| 残量計 | MAX17048 / TDFN | 業者実装。残量表示の要件を維持 |
| USB-C | 型番未選定 | 補強用固定脚があり、ケースと共に挿抜荷重を支える実部品を選定 |
| 電池 | 保護付き1S LiPo、100mAh級目標 | 寸法・許容充電電流・温度検知を確認。セル本体への直接はんだ付けを組立工程にしない |

候補の根拠・一次資料は[回路README](../hardware/rev-a/README.md#一次資料)。この方針変更だけで回路の型番・ピン接続を変更したことにはしない。

## Omi相当の外形内で基板とケースを合わせる

無地の円形ケースを3Dプリントする方針。蓋の固定は小ネジを第一候補にし、固定部の体積も配置に含める。形状は配置と電池を決めてからSolidCraftで作る。首紐穴、本体USB-C、ボタン1個、録音・残量・状態の発光窓、マイク音孔を設ける。装飾、金属仕上げ、専用充電台、複雑なクリップはv1の作業に含めない。

USBのケーブル根元、ネジ、電池の絶縁・膨張余裕、マイクガスケット、LEDの遮光は必要な機構として残す。現存する26×12mmのSolidCraftモデルと外観4案は将来用の参考資料で、v1の製造データには使わない。

v1の外形目標は直径約25.5mm・厚さ約15mm。既存の26×12mmモデルは、より薄い案の未検証モデルでありOmiと同じ厚さではない。12gは引き続き軽量化目標。サイズの成立は未確認で、実配置と電池の実寸から検証する。24時間録音、USB-Cの充電のみ／同期、全インジケーターは引き続き検証対象。

## 次に確定する順番

1. 微小パッケージの部品調達・小ロット実装可否を照会できるBOMにする。USB-C、電池、Q1、D2、水晶を実型番で選定する。
2. 全フットプリントをメーカー端子図と照合し、装着用22mm円形枠で実配置する。電気検証用30mm角とは分ける。USB・音孔・LED・ボタン・SWDと電流測定パッドの位置を先に確保する。
3. 電源経路と録音経路の試作検証を進め、実装レビュー・配線・DRCを完了してから基板発注資料を出す。ERC合格だけでは発注しない。
4. 電源・充電・USB挿抜・SD所有権の切替を確認し、実際の電池で24時間の録音を検証する。失敗時は電池容量や回路を見直す。
5. Omi相当の外形内で成立した基板・電池に合わせて簡易ケースを作り、装着と音質を確認する。外観の磨き込みはその後。

現在は回路ドラフトまで。PCB配置・製造用ケース・実機の成立は未完了。
