nyanko3141592/pendant-recorder/hardware/xe-minimal/fabrication-process-notes-historical-pre-refresh.txt

DRAFT — NOT RELEASED FOR FABRICATION

Six-layer PCB. Required process at the following through vias: nonconductive epoxy fill, planarization, copper cap, ENIG finish. Solder-mask ink plugging or tenting alone is not a substitute. Coordinates in KiCad board coordinates, mm.

U1.36 V3V3: X20.700 Y10.600; drill0.150, copper diameter0.350.
U1.40 PDM_DATA: X18.100 Y11.500; drill0.150, copper diameter0.350.

Preserve component-pad paste apertures; do not add a circular paste aperture for either via. These are partially overlapping pad/via geometries; final solder mask registration, stencil and surface flatness must be reviewed for UFQFPN48 assembly. PCB metadata is not a replacement for selecting the fabrication process and inspecting final production files.

No board-size, battery, recording-time or component-placement change. Final stackup, manufacturing outputs, cost and assembly qualification remain pending. Do not order from this draft.

Added U13.4 USB_INPUT_ON: X15.0125 Y3.000; drill0.150, copper diameter0.350; same required epoxy-fill/planarize/copper-cap/ENIG process.

USB_RESUME_PULSE route adds filled/capped vias at U1.19 (17.15,4.35 mm) and R50.1 (0.745,0.795 mm), each copper diameter0.35 mm/drill0.15 mm. Total five flagged pad-overlap vias. Same resin fill, planarization, copper cap, ENIG and stencil qualification requirements apply; not fabrication-qualified.

USB_ILIM_SET route adds filled/capped via at R45.1 (12.35,10.2 mm), copper diameter0.35 mm/drill0.15 mm. Total six flagged pad-overlap vias. Same resin fill, planarization, copper cap, ENIG and stencil qualification requirements apply; not fabrication-qualified.

USB_LATCH_CLEAR_N route adds filled/capped via at R48.2 (8.25,4.5 mm), copper diameter0.35 mm/drill0.15 mm. Total seven flagged pad-overlap vias. Same resin fill, planarization, copper cap, ENIG and stencil qualification requirements apply; not fabrication-qualified.

USB_LATCH_CLOCK adds filled/capped via at U14.3(2.8,20.7 mm), copper0.35/drill0.15mm. Total eight flagged overlap vias; same resin-fill, planarize, copper-cap and stencil qualification requirements. Not manufacturing-qualified.

USB_HIGH_BUDGET adds filled/capped vias at Q5.1 (9.9,6.8mm) and U1.42 (17.1,11.15mm), copper0.35/drill0.15mm. Total ten flagged overlap vias; resin-fill, planarize, copper-cap and stencil qualification required. Not manufacturing-qualified.

VBUS_N adds filled/capped via at U1.10 (13.15,5.95mm), copper0.35/drill0.15mm. Total eleven flagged overlap vias; resin-fill, planarize, copper-cap and stencil qualification required. Not manufacturing-qualified.

USB_SUSPEND_PULSE adds filled/capped via at U1.12 (13.0,5.05mm), copper0.35/drill0.15mm. Total twelve flagged overlap vias; resin-fill, planarize, copper-cap and stencil qualification required. Not manufacturing-qualified.

CHG_N adds filled/capped via at U3.9 (21.35,15.2mm), copper0.35/drill0.15mm. Total thirteen flagged overlap vias; resin-fill, planarize, copper-cap and stencil qualification required. Not manufacturing-qualified.

VBUS_GATE includes a filled/capped off-pad via at (13.2,3.6mm), copper0.35/drill0.15mm. Total thirteen flagged overlap vias unchanged; resin-fill, planarize, copper-cap and stencil qualification required. Not manufacturing-qualified.
