nyanko3141592/pendant-recorder/mechanical/compact-100-v5/print/PRINT-README.txt

Compact 100mAh v5 — サイズ・収納検討用 / 2026-10-25

全てmm単位、100%スケール。現在の外形26×31×14mm。
1 whole_size_26x31x14.stl / .3mf: 持った大きさ・装着感だけを見る一体モデル
2 case_body.stl / .3mf: ケース本体、USB開口・紐穴・PCB支持レール付き
3 case_lid.stl / .3mf: 蓋（固定爪なし。仮止めテープで評価）
4 battery_100mAh_15x17x6.stl / .3mf: YDL601515掲載寸法の電池ダミー
5 pcb_with_component_envelopes.stl / .3mf: 基板＋87点の部品包絡ダミー（一体）
6 pcb_bare_24x27x0.8.stl / .3mf: 基板外形だけの比較用ダミー

電池は底面から1.4mm、PCB下面は8.2mm、蓋下面は13mmが組立CAD位置。
電池底の0.2mmは絶縁/位置決め材の予約。PCBは両側の細いレールに載せる。
PCB付きダミーは背面も突起あり。必要なサポートをスライサーで確認。
0.4mmノズルでは小さい抵抗/LEDの細部は再現できない場合あり。
穴や小部品の細部が省略されてもサイズ比較として扱い、機能検証に使わない。

実電池を入れて充電するモデルではない。電池ダミーは通電不可。
配線・コネクタ・追加NTCの完成寸法は未確定。ハーネスはCAD予約領域のみ。
部品の幅/長さはKiCadフットプリント包絡、部品高さは種別による仮定。
実部品メーカーの最大公差やSTEPで検証済みという意味ではない。
バッテリー下は部品禁止領域（接点/書込みランドを除く）。書込み治具は電池を外して使用する想定。
蓋の保持、マイク密閉/音道、プランジャ、電池保持・膨張余裕、紐強度は未資格化。

メッシュ検査はmesh-validation.json参照。全STLが閉じた単一連結メッシュ、
正の体積、反転/縮退三角形なし、ベッド面Z=0。実印刷・全自己交差検査ではない。
