nyanko3141592/pendant-recorder/mechanical/xe-minimal/preorder-20261029/prototype-case/ASSEMBLY.md

# 配線用端部付き初号ケースの組立

対象：同フォルダのlower/carrier/upper、固定DTP401525-XE、b3cdfc…基板、C30=C501830。同じ基板配置の最大厚0.9mmゲージを使用する。旧ケースの組立手順ではなく本書を使う。

## CADの前提と現物確認

外形約30.8×37.5×14.2mm。既存ケースの基板/電池位置は維持し、電池線が出る側だけ配線bayを追加。下ケース・キャリア・蓋は各1solid。0.15mm接着ポケット6か所を設け、他の合わせ面を停止面として残した。

出荷時線長12/15/18mmの通路を、半径2.887mmのU字でモデル化。最短12mmでも電池側1.115mm/プラグ側1.815mmの直線部を残す。被覆径0.8mm以下・根元必要直線1mm以下という仮定。実際の根元処理、出口位置、束の並び、プラグ嵌合最大包絡はメーカー保証値ではない。透明/赤の通路モデルは形状確認用で、電線加工用の治具ではない。3本の個別線を同じ長さで拘束せず、自然に束を曲げて通路へ置く。

組付け前に実電池の無加工線が、根元に引張力を掛けず、最短部でも鋭角に折れずにU字になることを確認する。線径や根元が前提を超える、プラグが包絡を超える、蓋を押さないと閉まらない場合は不適合。削ってセルを押し込んだり線を短縮しない。これは初号のfit検査であり、机上保証ではない。

## キットと造形

`a1mini-fit-kit/prototype-fit-kit.3mf` はlower、upper、carrier、最大厚PCBAゲージ、15.5×27×4.2mm電池ダミーの5物体。ケースとダミーの単体STEP/STL、assembly.step、exploded.stepも付属。harness/plug/insulationのSTEP/STLは説明用包絡で、5物体の印刷対象に含まない。

A1 mini、PETG Basic、0.4mm nozzle、0.16mm layer、6walls、40%gyroid、support。lowerはCAD X軸をbuild Zへ向ける設定。紐穴の積層方向を維持する。オフラインsliceは約9.76g/65.6分、警告なし。実印刷は未実施。接着ポケット0.15mmは造形層厚に近いため、印刷後に深さと閉鎖停止位置を必ず確認する。ポケットが潰れたものを電池入りで強く締めない。

## 工場/キット供給側の準備

- 電子部品とファーム、媒体format/identityは実装基板側で完了させる。買い手へはんだ・圧着・初回flashを要求しない。
- キャリア裏の14.5×25.5mm範囲（CAD x1..15.5, y-26.5..-1）へ3M5413の単層片を貼る。公表総厚は約0.07mm典型、設計許容総厚は0.10mm以下。気泡・折返し・多重貼りなし。セルへ貼らない。包装の絶縁を剥がさない。金属部とセルの間にPETG仕切りが連続していることも確認する。
- 接着剤はセメダイン スーパーX2クリアAX-083。PETG印刷面での接着性能は未認定。メーカーはPETボトル工作用途を掲載しているが、これだけでPETG強度を保証しない。清浄乾燥した同条件PETG試験片と空ケースで先に確認する。接着するのは内側の指定ポケットのみ。肌・セル・線・端子・USB・マイクへ接着剤を触れさせない。
- まずダミーケースで完全硬化後に蓋保持、紐引張/落下を試す。外へ残った接着剤、剥離、蓋の浮きがあれば不適合。製品内の長期強度や汗耐性は別評価。

## 組立順（机上で具体化した手順、現物作業未実施）

1. USBを外す。下ケースのサポート材/バリ/異物を除き、空ケースで蓋が停止面まで無理なく閉まることを確認する。ダミーを使って保持と取出しを先に試す。
2. 外で電池、絶縁済みキャリア、基板を最終位置関係に重ねる。下向きJ2へ純正プラグを挿す際は基板を支え、電池や線で基板を吊らない。必要なら横から見える程度だけ傾け、線を引かない。嵌合はこの外作業で済ませる。
3. 電池線を端部bay側へU字に回す。最短線では根元の直線部分を優先し、長い線はUの高さで吸収する。キャリアの切欠きを通し、線を基板支持柱や蓋の合わせ面へ乗せない。12/15/18mmモデルを同時に入れるのではない。
4. 接続済み電池・キャリア・PCBAを一体で下ケースへ垂直に下ろす。相対位置を崩さず、プラグを引っ張らない。CADはz=0/0.1/0.5/1/2/4/8/12mmの配置サンプルで干渉0。連続掃引や実物の指作業全体を保証した結果ではない。
5. 電池が面で底受けされ、線がbay内、キャリアが支持面上、基板が4支柱上であることを確認する。最大厚電池上の予約は絶縁材分を引いて0.4mm。圧縮材でこの隙間を埋めない。
6. 接着前にUSBとマイク/スイッチ開口、NTC、安全動作、録音/取込みを確認する。初号評価では接着前の開放状態で電気試験を済ませる。開放状態の首掛け評価はしない。
7. 6個の凹ポケット内だけに薄く接着剤を塗り、bay/内周側には塗らない。ポケットXYはreview.json参照。蓋を停止面まで合わせ、外形を軽く保持する。セル上へクランプ荷重を掛けない。接着剤が停止面に厚く乗って蓋を持ち上げたらやり直す。
8. 当該接着剤の使用説明に従って硬化させる。初号の確認条件は23℃前後で少なくとも24h、試験片の硬化と接着が不十分ならさらに待つ。未硬化で充電/装着しない。閉鎖後、ケース浮き、線の挟み込み、USB全挿入、異常発熱がないことを確認する。

買い手は完成電池を接続して収め、指定接着面で閉鎖し、完成breakawayコードを通すだけ。接着済みケースを刃物でセル付近からこじ開けない。初号の再作業は基板・電池を安全に取り出せる未接着段階で行い、接着後のケースは消耗部品として扱う。

参照：
- https://www.cemedine.co.jp/home/products/superx/superx2.html
- https://multimedia.3m.com/mws/media/136011O/3m-polyimide-film-tape-5413-tds.pdf

再生成はリポジトリ側の `mechanical/xe-minimal/preorder-20261029/build_prototype_case.py` → `slice_prototype_fit_kit.py` → `audit_prototype_fit_kit.py prototype-caseの絶対パス` の順。パッケージ同梱のPythonはソース来歴用の写しであり、入力ファイルを含むリポジトリ側のパスで実行する。CadQuery2.8.0、KiCad10.0.7の元データ、BambuStudioを使用。
