nyanko3141592/pendant-recorder/mechanical/xe-minimal/preorder-20261029/captured-carrier-case/FIT-CHECK-INSTRUCTIONS.txt

一体キャリア・基板拘束付きケース候補：実寸ダミー確認

現優先機構候補。量産/実電池使用は未認定。製造用リリースではない。
元の薄い仕切り板を、仕切り・補強枠・基板支持柱が一体になったキャリアに置換する。
ケースは下・キャリア・上の3部品。追加ネジ/配線部品なし。旧2分割ケースよりケース部品は1点増える。
外形約30.8×30.8×14.2mm。基板27.5mm角、基準PCB hash b3cdfc064b4321aa6d32c2ff579efeaaf709f36dbfe7255380feec880741eee0。

組立確認用ファイル
- assembly.step：組立座標のケース・キャリア・現PCBA・最大電池包絡。
- a1mini-fit-kit/captured-carrier-fit-kit.3mf：ケース3点＋連結PCBAゲージ＋電池ダミーの5物体。
- pcba-max-gauge.step/stl：0.9mm基板厚条件。コネクタ穴を埋めたゲージで、実嵌合検査用ではない。
- battery-growth-reserve.step/stl：最大電池上方0.5mmの予約体。印刷用セットには含めない。

ダミー組立順序（未実行）
1. 下ケースの平らな底受けへ最大電池ダミーを上から置く。
2. 一体キャリアを上から入れ、左右の受け面へ載せる。支持柱のある面が上。電池ダミーを押さえ込まない。
3. PCBAゲージをUSB方向に合わせ、キャリアの4本の支持柱に載せる。電子部品に相当する突起を支点にしない。
4. 上ケースを仮合わせする。蓋の4本の柱が基板の上方移動を制限する。無理な押込みや接着は、この寸法確認段階では行わない。
5. ケース合わせ目、電池上の隙間、キャリアの反り、基板のガタ、USB/マイク/ボタン位置を記録する。

確認済み範囲
- ケース3部品がそれぞれCAD valid1solid。現PCBA/最大厚ゲージ/最大電池/成長予約体との静的干渉0。
- 電池本体・キャリア・各PCBA部品の保守的な上方掃引体と、先に置く部材との干渉0。
- 閉じた蓋の上ストッパー：基板厚0.9mmで隙間0.1mm、公称0.7992mmで隙間0.2008mm。
- 基板＋キャリアを共にXY各±0.1mmへ動かした4隅条件でケース干渉0。相対ずれや全公差を認定したものではない。
- carrier-print-connectivity.json：支持材を除いた公称押出ビードが1連結。実際の接着/剛性を意味しない。
- A1 mini/PETG/0.4mmノズル/0.16mm層/6周壁/40%gyroid/tree support、offline slice警告0。実印刷はしていない。

未解決・実機確認
- 純正15±3mmハーネスと781720003プラグを接続したままの挿入経路、曲げ、挿抜、挟み込みを確認する。上記の掃引検証は配線を含まない。
- 蓋の接合方法と強度、キャリア剛性、印刷公差、上下動/横ずれ、落下と紐荷重を認定する。
- 0.5mmは電池膨張用の設計予約値。メーカー保証や電池の衝撃安全性の認定ではない。
- 16時間録音、実媒体30時間保存、温度・異常USB入力・実ケーブルは未実測。
