nyanko3141592/pendant-recorder/mechanical/xe-minimal/preorder-20261029/fit-kit-a1mini/FIT-CHECK-INSTRUCTIONS.txt

実寸収納確認キット（設計中・実印刷未実施）

内容：30.8mmケース上下、最大0.9mm基板厚PCBA外形ダミー、DTP401525-XE最大本体ダミー。
プロファイル：A1 mini、PETG、0.4mmノズル、0.16mm積層、6壁、40%gyroid、tree support。

使用目的：外形、ケース収納、部品のおおまかな位置を確認する。
USB/J2は中実なのでコネクタを挿入しない。実電池や実PCBAをこの未認定ケースへ組み込まない。

将来の実寸確認手順：
1. 印刷後に支持材とバリを取り、ケース外形、ダミー基板外形27.5mm、電池15.5x27x4.2mmを測る。
2. 設計座標で電池の長辺はY方向、PCBAのUSB側はケース切欠き側へ向ける。無理な押込みをしない。
3. 上下ケースを接着せず仮合わせし、外形、隙間、反り、各開口位置を記録する。
4. 現在は電池・基板の保持機構が未完成なので、内部が動かないことや落下保護の合格を判断しない。

未収録：純正ハーネスと嵌合済みコネクタ、保持構造、実装公差、安全な電池膨張余裕。
この4部品のみで完成組立を証明しない。電気・熱・音響・紐強度の試験には使用しない。
今回の実行はオフラインスライスのみ。印刷・発注・送信は実行していない。
