nyanko3141592/pendant-recorder/mechanical/xe-minimal/preorder-20261029/retained-battery-case/FIT-CHECK-INSTRUCTIONS.txt

電池受け付きケース候補：実寸ダミー組立の確認手順

状態：未採用。仕切り板の抜け止めと純正ハーネス経路は未完成。
この手順はダミーによる寸法確認用。実電池を入れて使用する完成ケースではない。
基準PCB: b3cdfc064b4321aa6d32c2ff579efeaaf709f36dbfe7255380feec880741eee0
基板27.5mm角、公称0.8mm。ダミーは基板厚0.9mm条件の連結形状。
外形約30.8×30.8×14.2mm。旧案より厚さ0.3mm増、幅は維持。

データ
- assembly.step: 組立座標。pcba-dummy STEP/STLは詳細包絡の参照用で、単独印刷しない。
- a1mini-fit-kit/retained-battery-fit-kit.3mf: 上下ケース、連結PCBAゲージ、最大電池ダミー、仕切り板の5物体。
- battery-growth-reserve.step: 最大4.2mm電池の上に0.5mmを予約した検討体。製品の一部ではない。
- PETG/A1 mini/0.4mmノズル/0.16mm層/6周壁/40%gyroid/tree supportでoffline slice済み。実印刷なし。

将来のダミー確認順序
1. ケース底受け・側壁・仕切り板の反り、造形欠け、サポート残りを確認する。
2. 最大電池ダミーを下ケースへ上から下ろす。平面の底受けに載り、横ガイドに押し込まず収まることを確認する。
3. 仕切り板を上から下ろし、左右4箇所の支持面に載せる。電池上面との設計隙間は0.5mm。板厚0.3mmの反りやたわみで隙間を消費していないか測定する。
4. PCBAゲージをUSB位置に合わせて置き、上ケースを仮合わせする。仕切り板や電池へ力を加えないと閉まらない場合は不合格。
5. USB・マイク・ボタン位置を確認する。ただしゲージのコネクタは実際の嵌合を再現しない。
6. 実測した外形、XYガタ、電池上の隙間、仕切り板変形、ケース合わせ目を記録する。

CADで確認した範囲
- 最大電池、0.5mm上方予約体、現基板包絡、最大厚ゲージ、仕切り板とケースの体積干渉0。
- 電池本体・仕切り板の上方からの連続直線挿入は、保守的な矩形掃引体と下ケースの干渉0。
- 配線とプラグを伴う挿入経路は未確認。

残る設計作業
- 仕切り板を追加のユーザー作業なしで保持する方法、およびPCBの支持・抜け止めを完成させる。
- 純正15±3mm配線と781720003プラグの経路・曲げ・挿抜を確定する。
- 0.5mmが電池の膨張・公差・落下に十分かを別途認定する。CAD干渉0では証明できない。
- 電池保護、絶縁、衝撃、紐、USB実ケーブル、温度、16h録音を実機で確認する。
