nyanko3141592/pendant-recorder/mechanical/compact-ab/fit-check/original-size/PRINT-README.txt

ペンダント録音機 A/B サイズ確認用 / 2026-10-25

A: 38 × 39 × 8.9 mm
B: 20 × 39 × 14.5 mm

STLはmm単位、100%（倍率1.0）でスライサーに読み込んでください。
広い平面が下、Z=0に配置済み。サポート不要の一体モデルです。
PLA、0.4mmノズル、積層0.2mm、外周3本、上下4層、インフィル10〜15%を開始値にできます。
温度・速度は使用プリンタとフィラメントの既定プロファイルに従ってください。
原寸を保つため、ベッドへの自動フィット/拡大縮小は無効にしてください。

STLには単位情報がないため、単位付き3MFもZIPに同梱しました。
それぞれ同一形状です。STLと3MFを両方印刷する必要はありません。

目的は外形・厚さ・首掛け時のサイズ感の比較です。
内部空洞、電子部品、USB穴、ボタン、蓋は印刷モデルから省いています。
紐穴は外形内の6×1.5mm。印刷後に閉塞や割れがないことを確認してください。
部品収納/蓋嵌合確認用ケースではありません。製品の重さや重心も再現しません。
電池や基板は入れないでください。電子機器として使用できません。

検証: 寸法、底面Z=0、閉じたメッシュ、1連結成分、面の向き、ゼロ面積面なし。
mesh-validation.jsonに結果を同梱。実際の印刷試験は未実施です。
プリンタ固有のG-codeは含めていません。
