nyanko3141592/pendant-recorder/hardware/xe-minimal/assembly-panel-layout-study.png

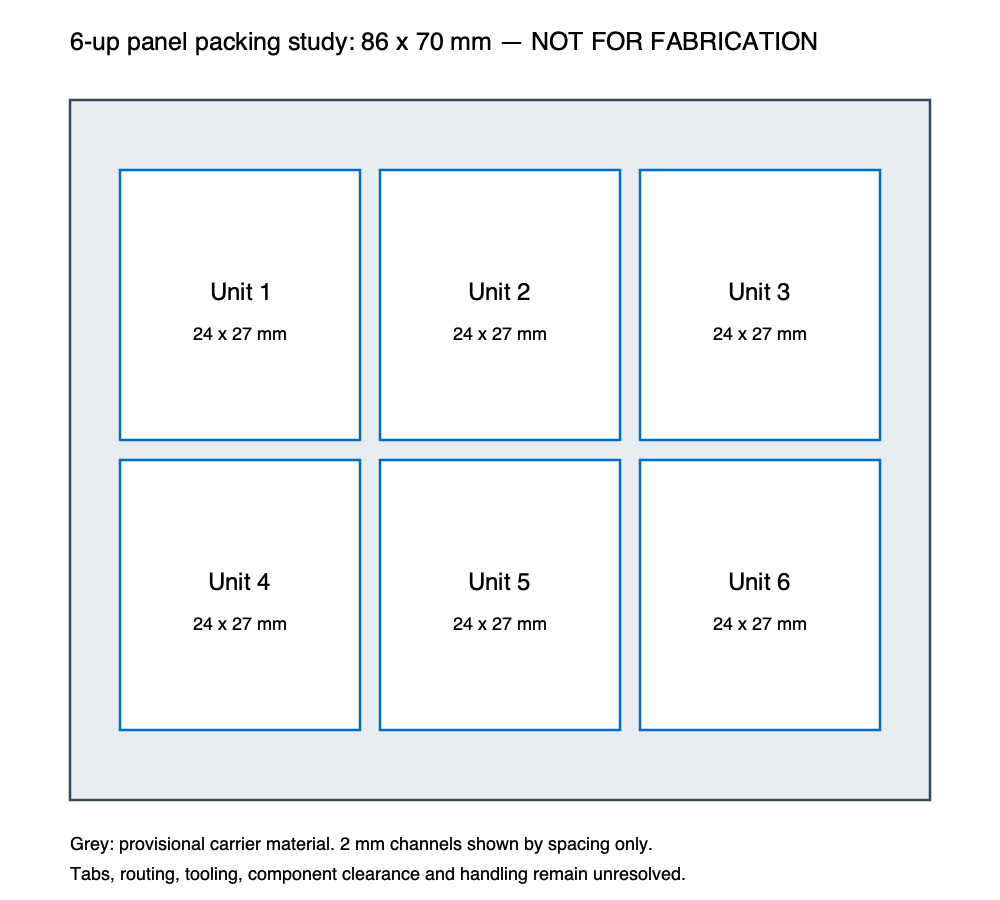
hardware/xe-minimal/assembly-panel-layout-study.png
