nyanko3141592/pendant-recorder/hardware/xe-minimal/current-single-carrier-trial/rounded-fabrication-review/gerber-render-review/all-layers.png

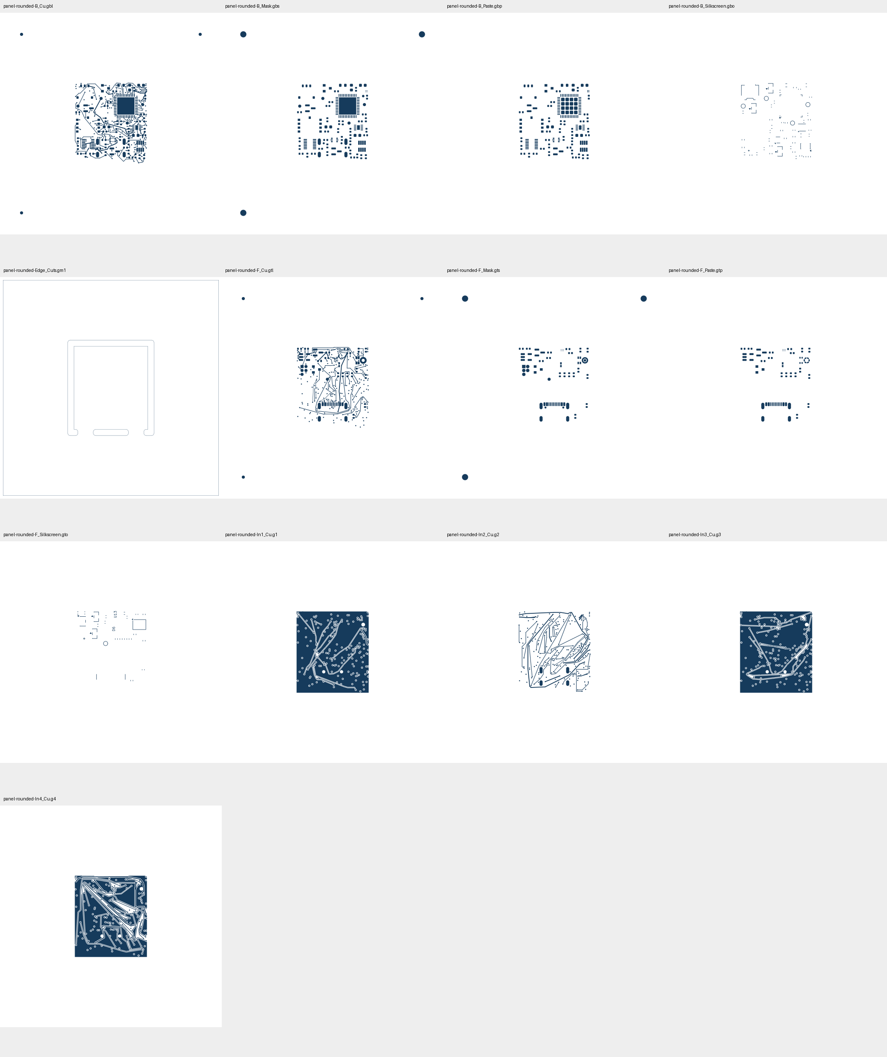
hardware/xe-minimal/current-single-carrier-trial/rounded-fabrication-review/gerber-render-review/all-layers.png
