nyanko3141592/pendant-recorder/hardware/xe-minimal/electrical-panel-candidate-v3/fabrication-review-ac715808f9dc/gerber-render-review/panel-B_Mask.png

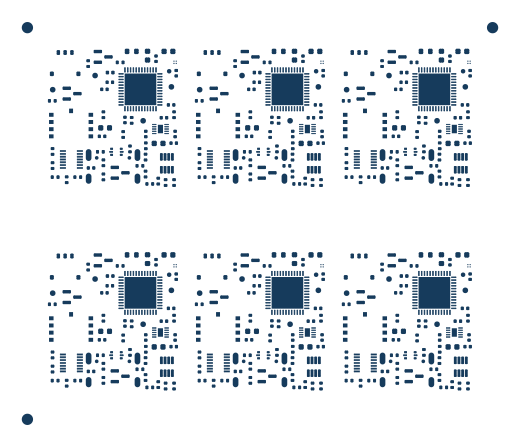
hardware/xe-minimal/electrical-panel-candidate-v3/fabrication-review-ac715808f9dc/gerber-render-review/panel-B_Mask.png
