nyanko3141592/pendant-recorder/hardware/xe-minimal/fabrication-review-31ebfc3b1041/drill-review.png

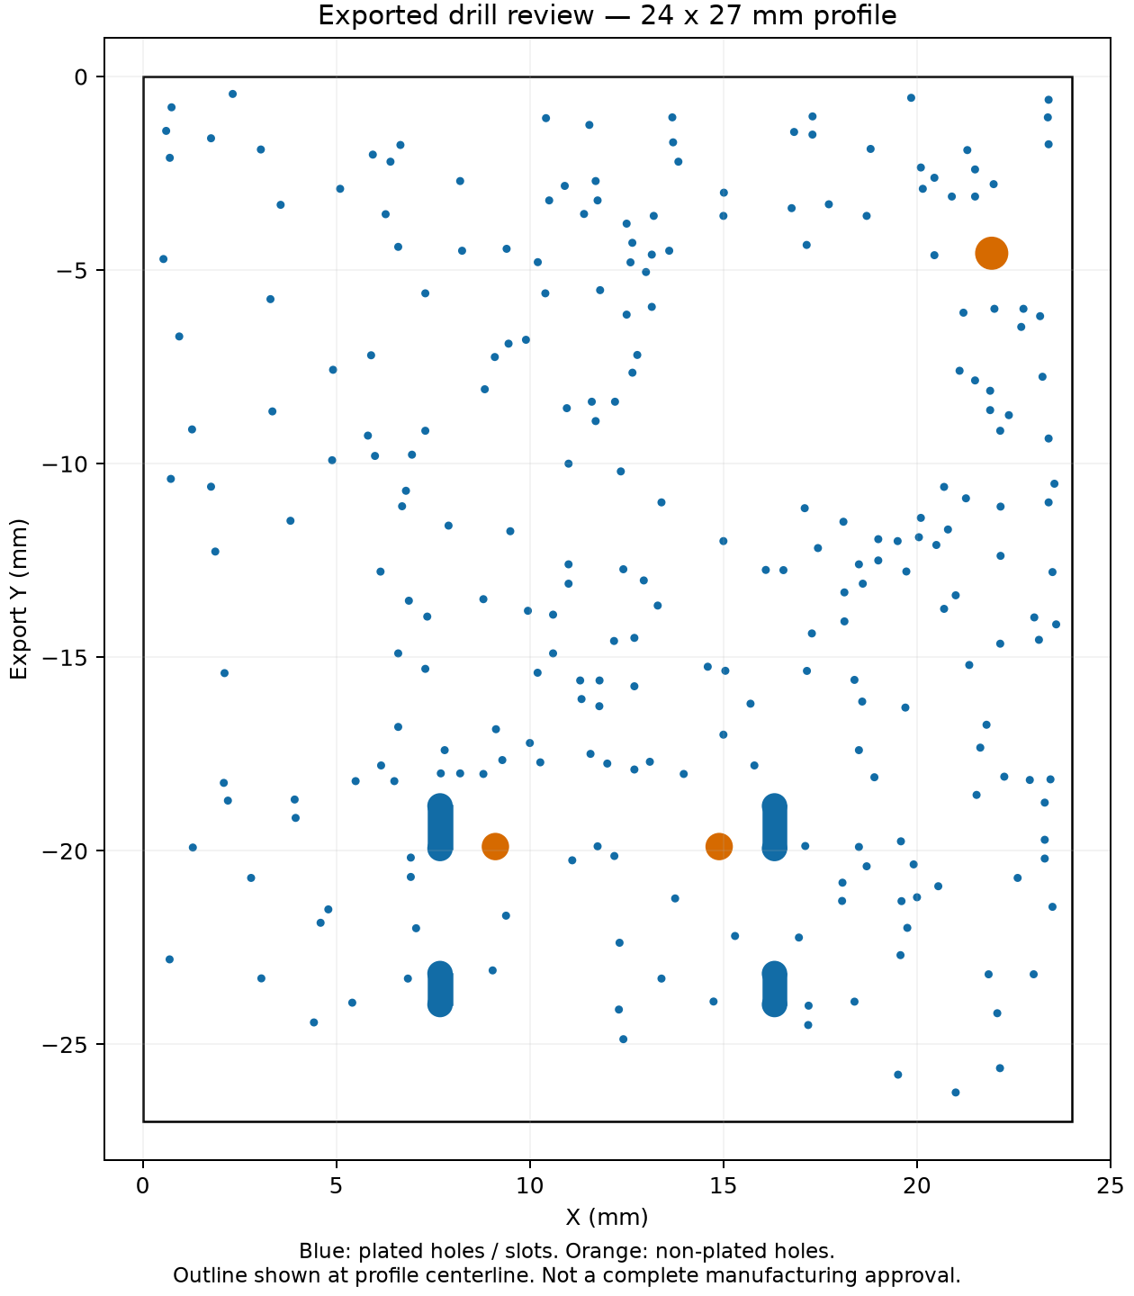
hardware/xe-minimal/fabrication-review-31ebfc3b1041/drill-review.png
