nyanko3141592/pendant-recorder/hardware/xe-minimal/fabrication-review-31ebfc3b1041/gerber-render-review/pendant-xe-minimal-Edge_Cuts.png

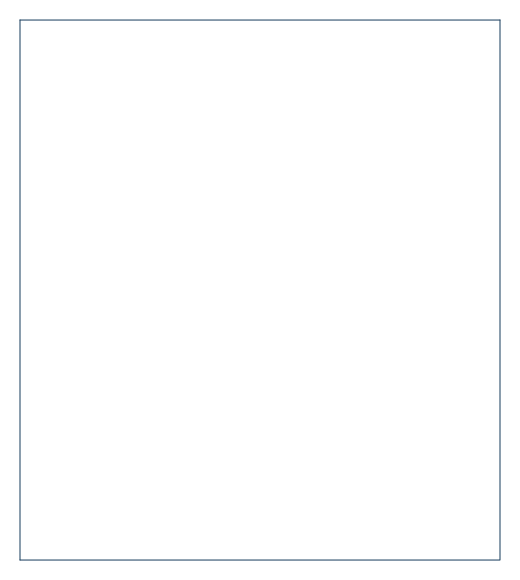
hardware/xe-minimal/fabrication-review-31ebfc3b1041/gerber-render-review/pendant-xe-minimal-Edge_Cuts.png
