nyanko3141592/pendant-recorder/hardware/xe-minimal/fabrication-review-54a4a093db0a/assembly-terminal-orientation.png

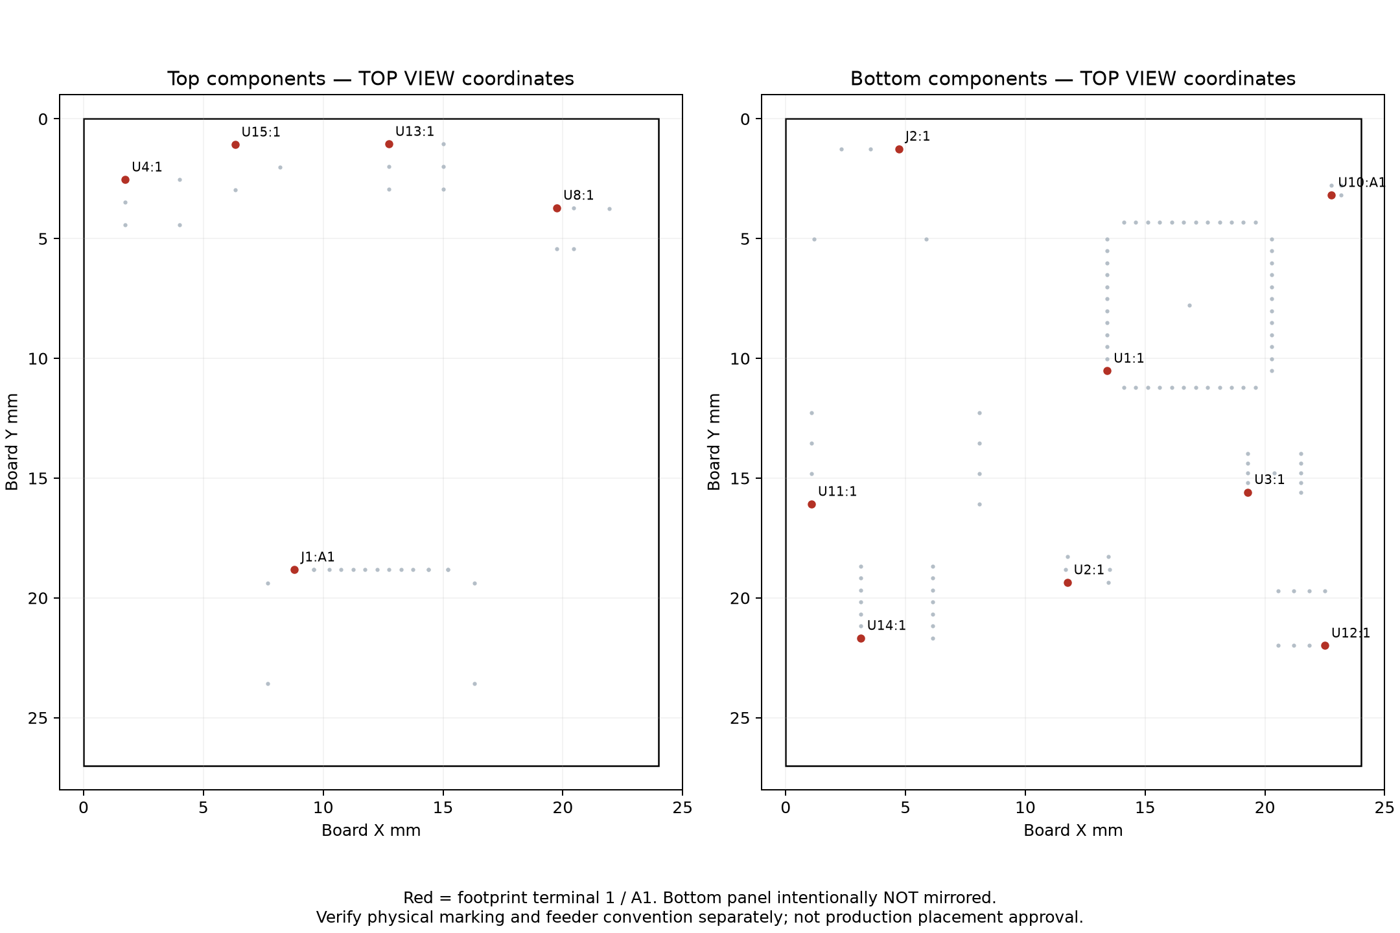
hardware/xe-minimal/fabrication-review-54a4a093db0a/assembly-terminal-orientation.png
