nyanko3141592/pendant-recorder/hardware/xe-minimal/fixed-usb-limit-trial/r44-capped-trial/fabrication-review-dedfe7ece3be/filled-capped-via-map.png

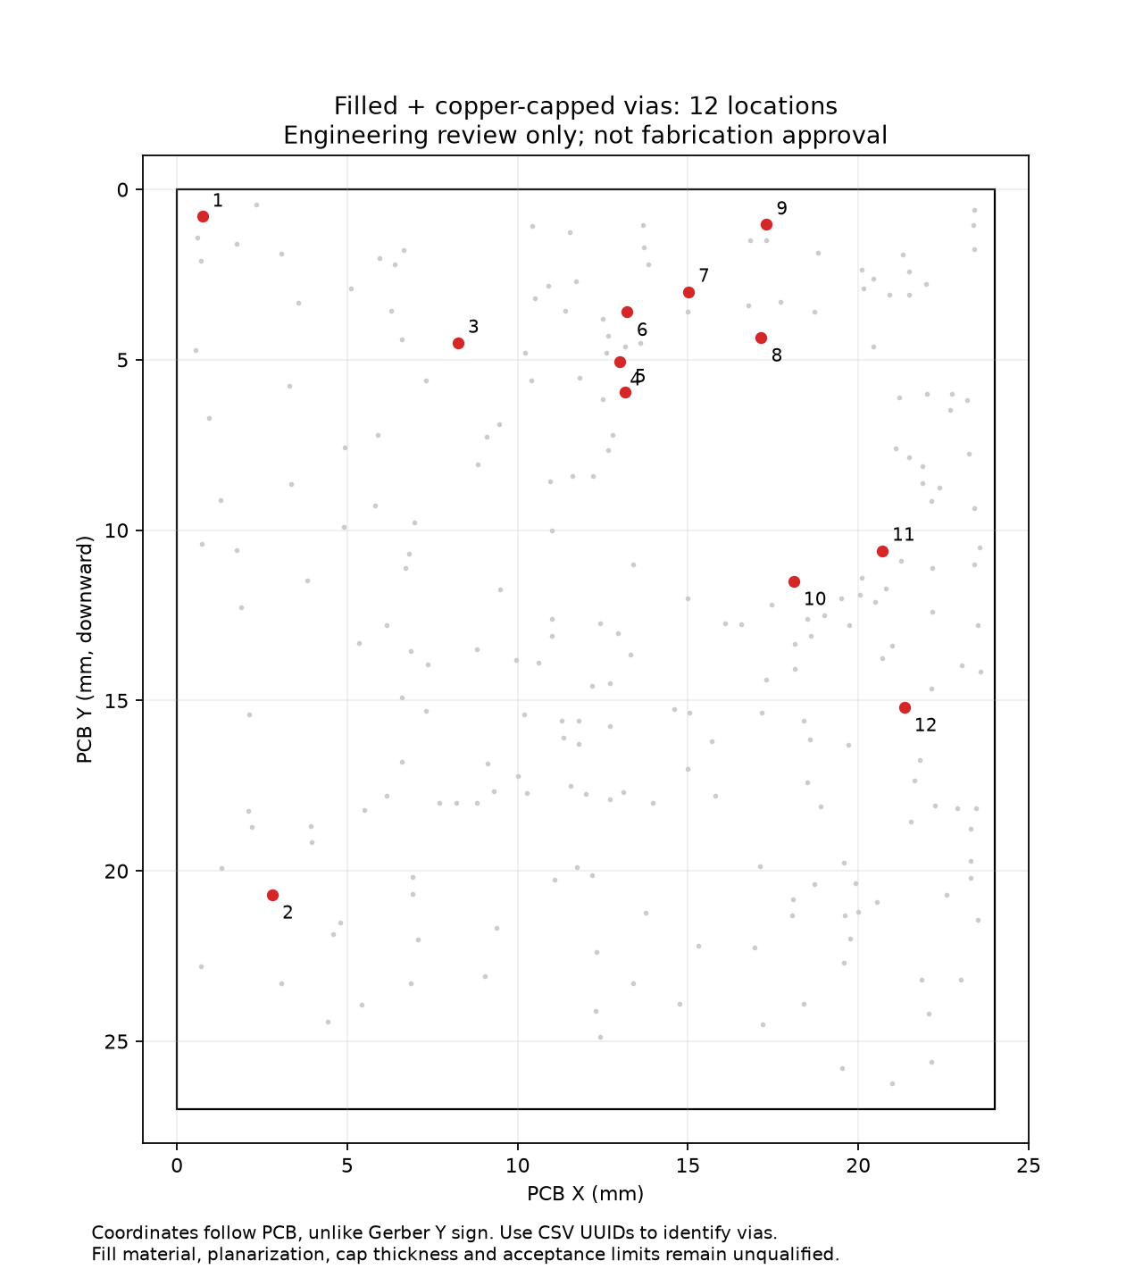
hardware/xe-minimal/fixed-usb-limit-trial/r44-capped-trial/fabrication-review-dedfe7ece3be/filled-capped-via-map.png
