nyanko3141592/pendant-recorder/hardware/xe-minimal/preorder-20261029/release-review-20261029-aligned/mechanical-captured-carrier/assembly-order.png

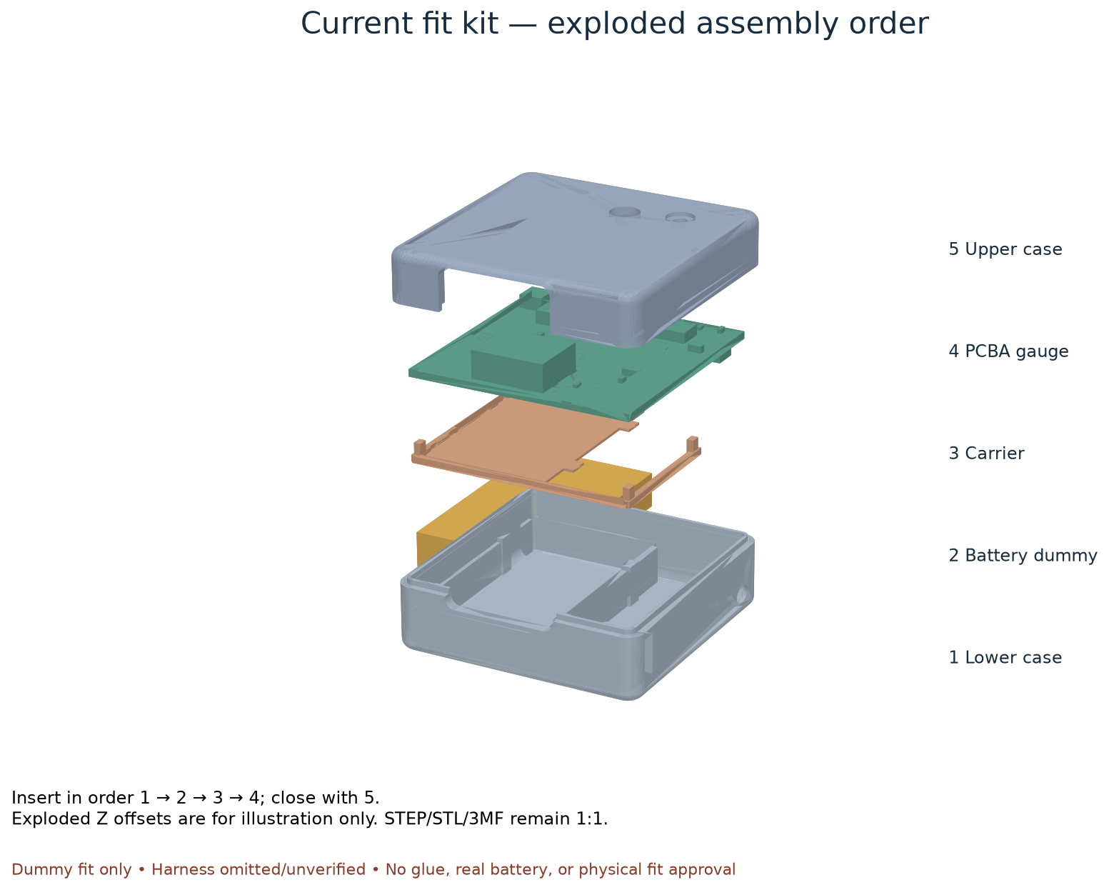
hardware/xe-minimal/preorder-20261029/release-review-20261029-aligned/mechanical-captured-carrier/assembly-order.png
