nyanko3141592/pendant-recorder/hardware/xe-minimal/q5-tmux-placement-trial/tmux-dck-land-manufacturer.png

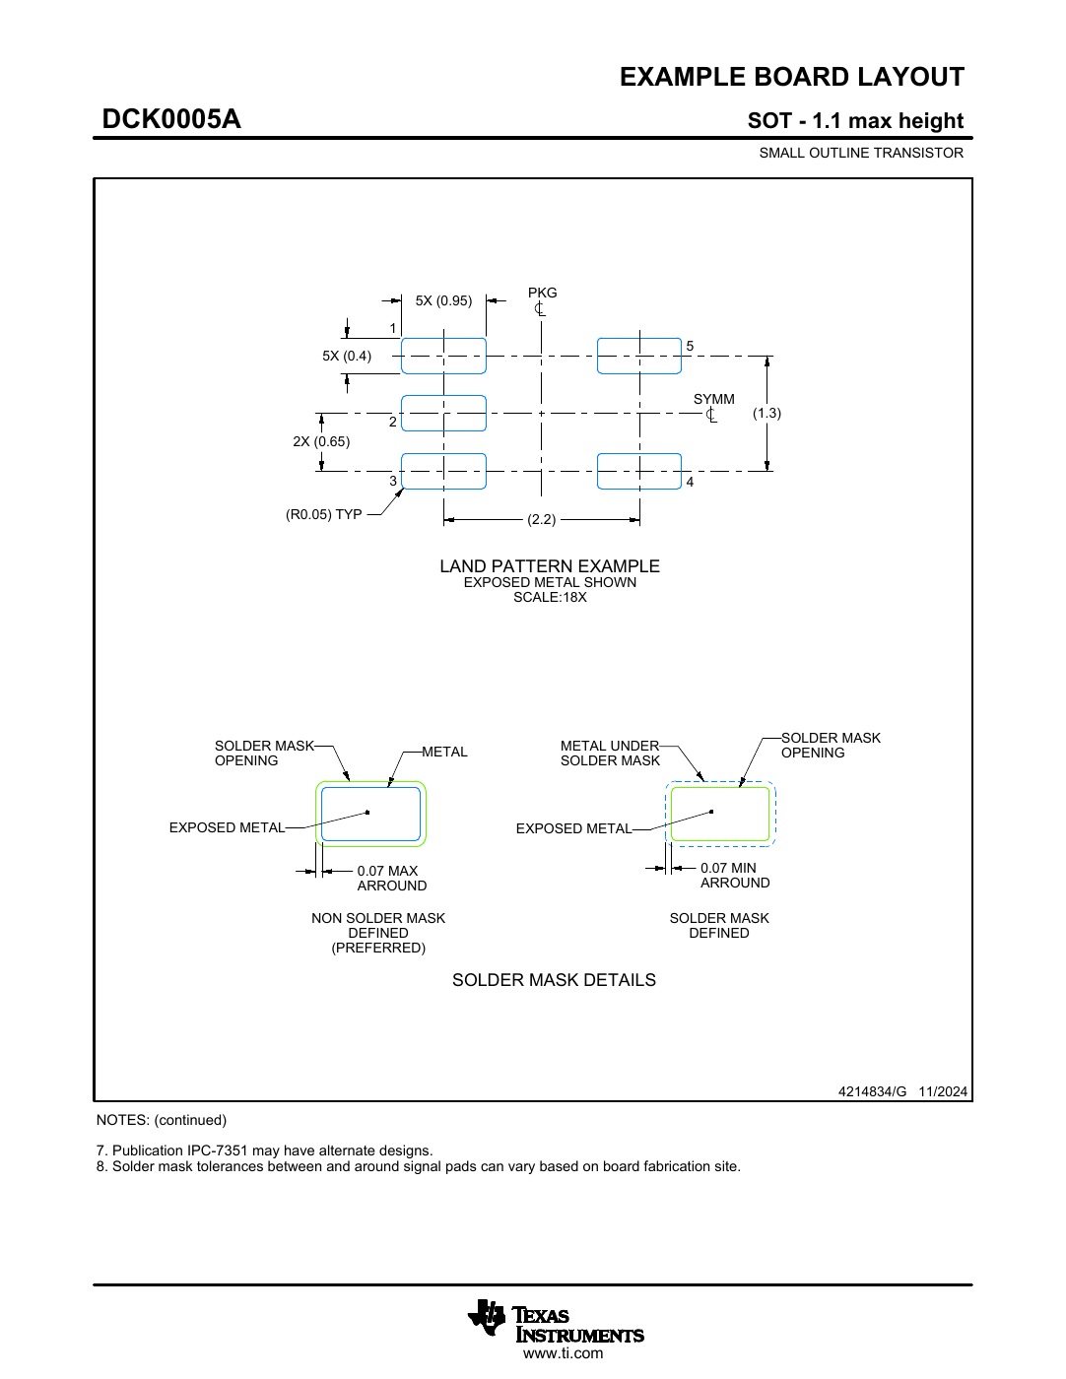
hardware/xe-minimal/q5-tmux-placement-trial/tmux-dck-land-manufacturer.png
