nyanko3141592/pendant-recorder/mechanical/compact-100-v5/assembled.png

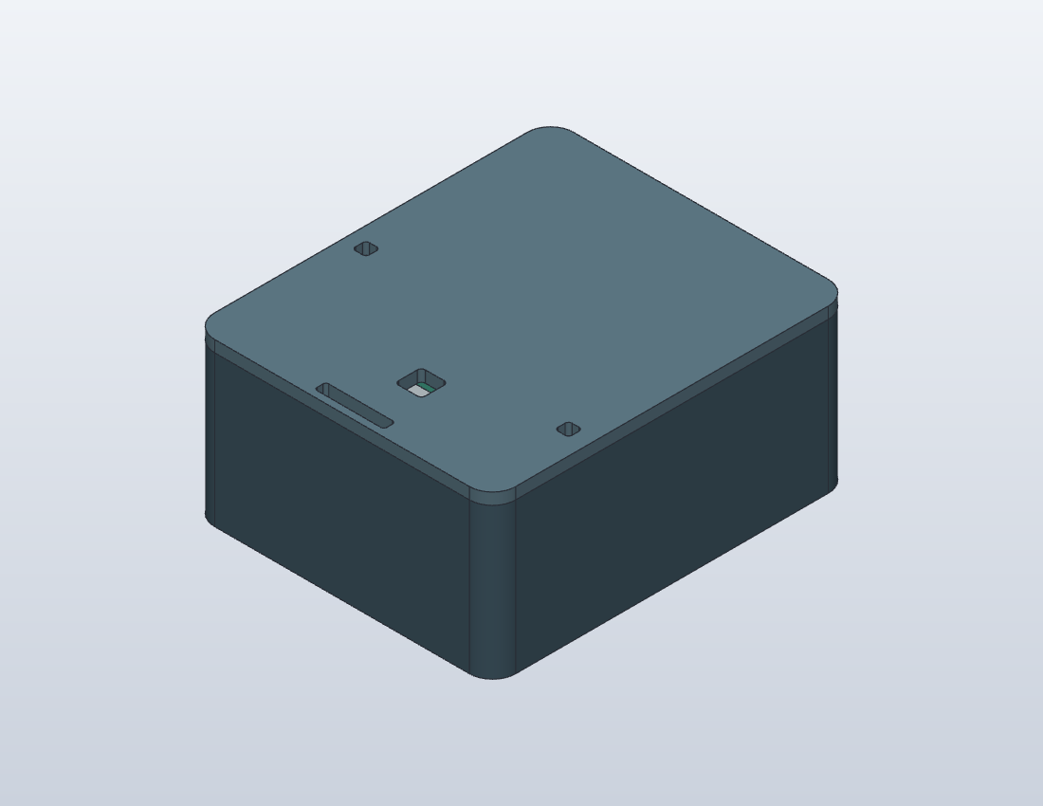
mechanical/compact-100-v5/assembled.png
