nyanko3141592/pendant-recorder/mechanical/compact-ab/a-assembled.png

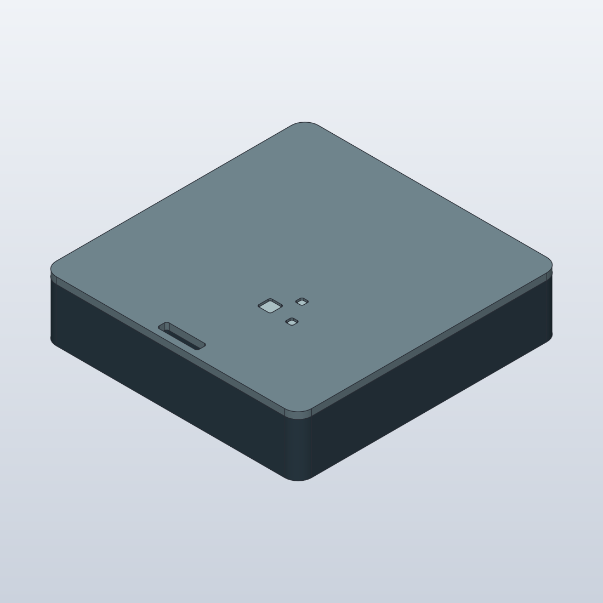
mechanical/compact-ab/a-assembled.png
