nyanko3141592/pendant-recorder/mechanical/compact-ab/b-assembled.png

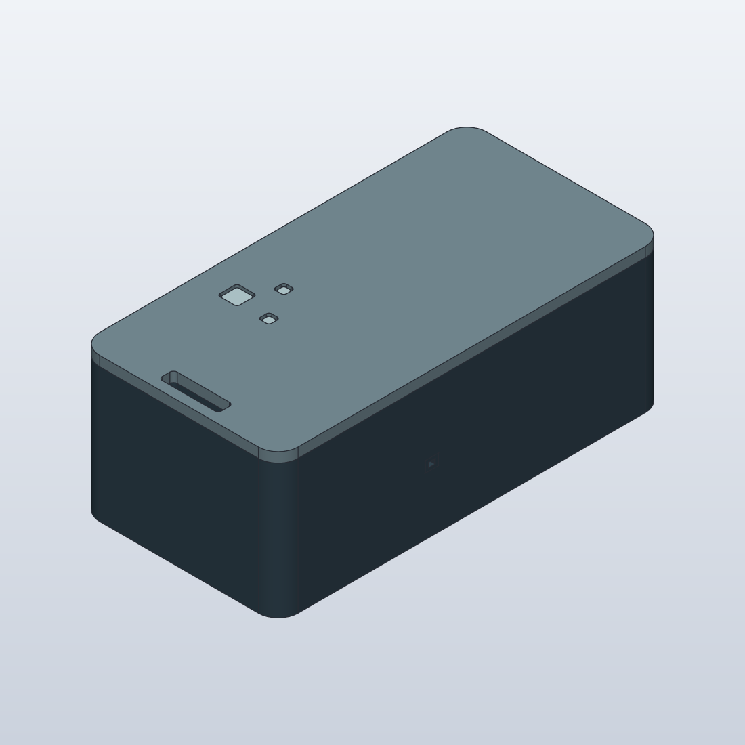
mechanical/compact-ab/b-assembled.png
