nyanko3141592/pendant-recorder/mechanical/compact-ab/print-size/A-preview.png

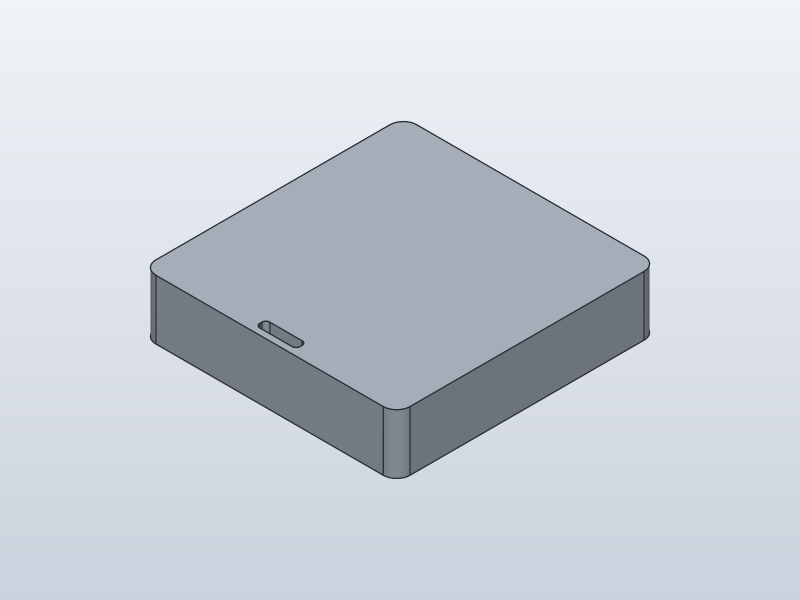
mechanical/compact-ab/print-size/A-preview.png
