nyanko3141592/pendant-recorder/mechanical/compact-ab/print-size/B-preview.png

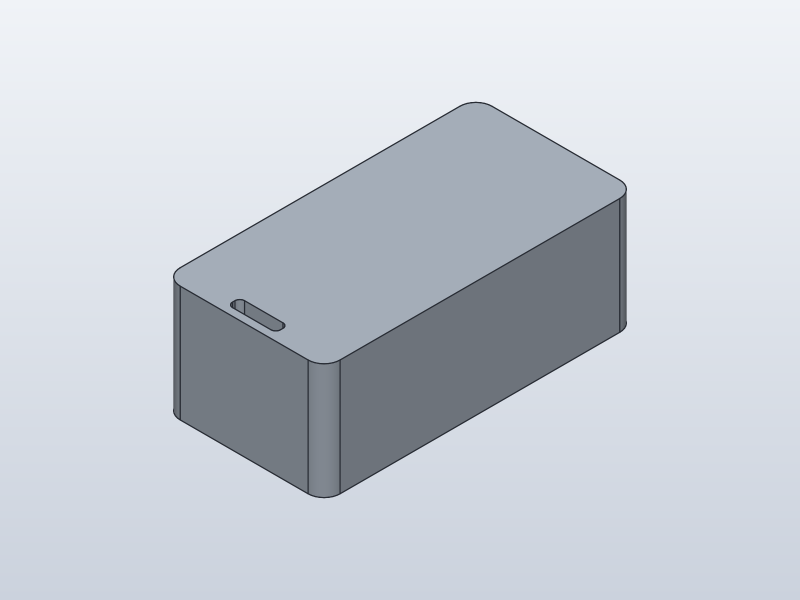
mechanical/compact-ab/print-size/B-preview.png
