nyanko3141592/pendant-recorder/mechanical/xe-minimal/film-axial-stop-printed-holes.png

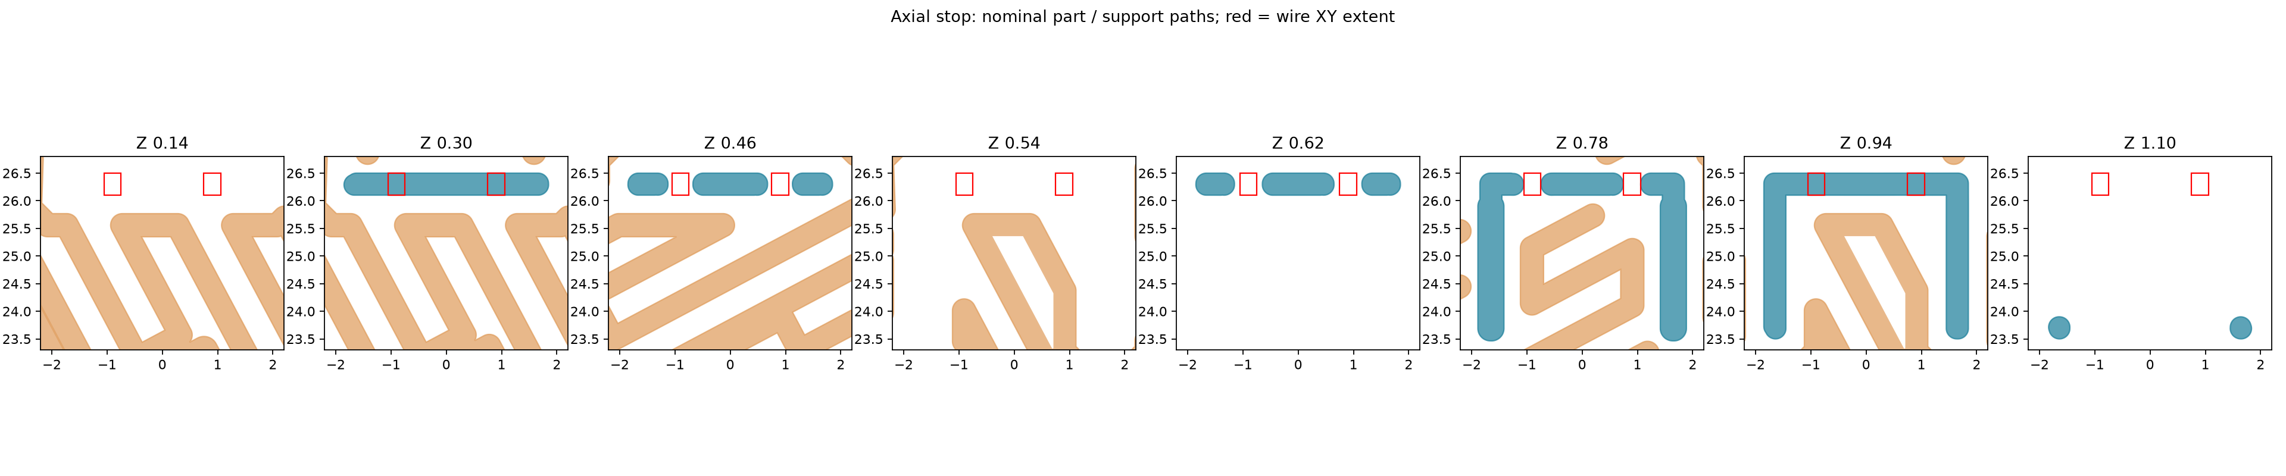
mechanical/xe-minimal/film-axial-stop-printed-holes.png
