nyanko3141592/pendant-recorder/mechanical/xe-minimal/film-integrated-assembly-review.png

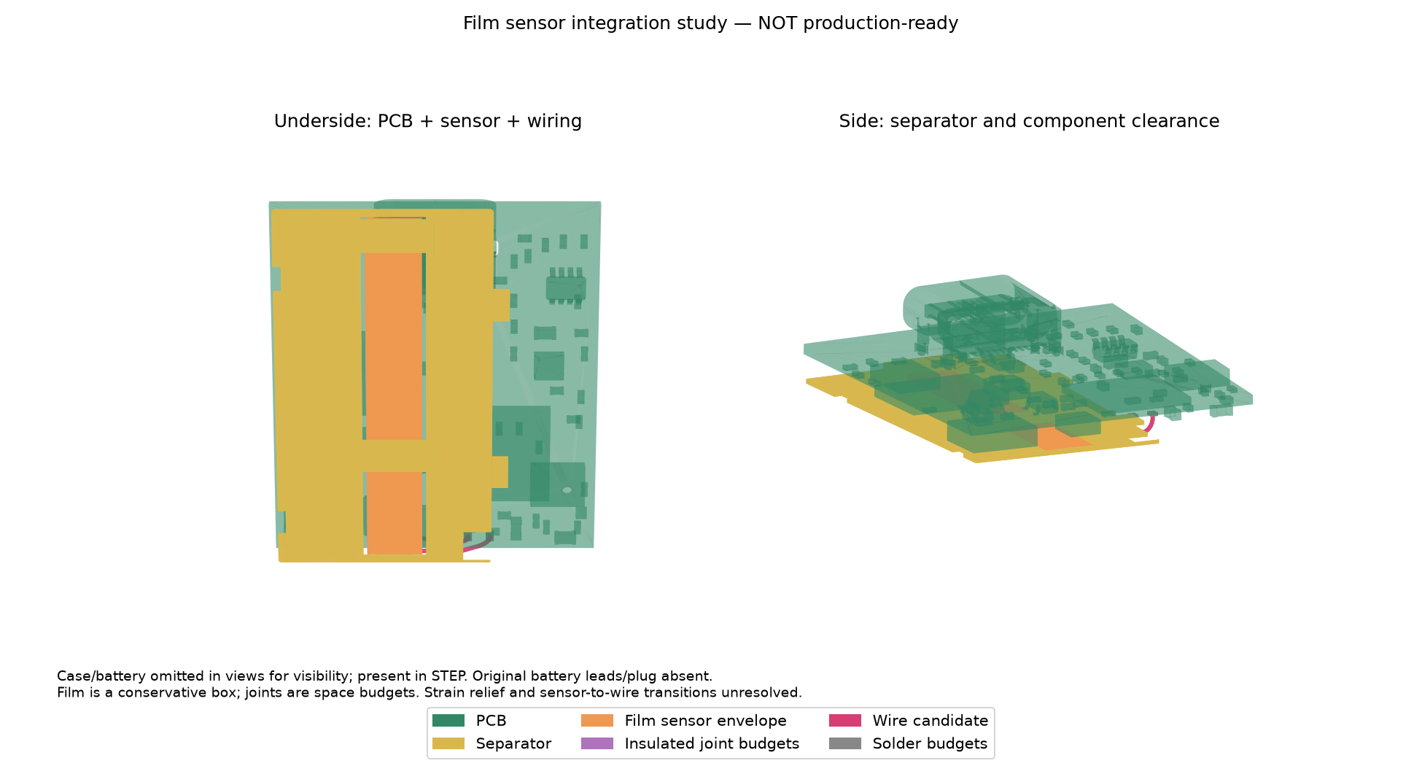
mechanical/xe-minimal/film-integrated-assembly-review.png
