nyanko3141592/pendant-recorder/mechanical/xe-minimal/pcb-partial-assembly-study.png

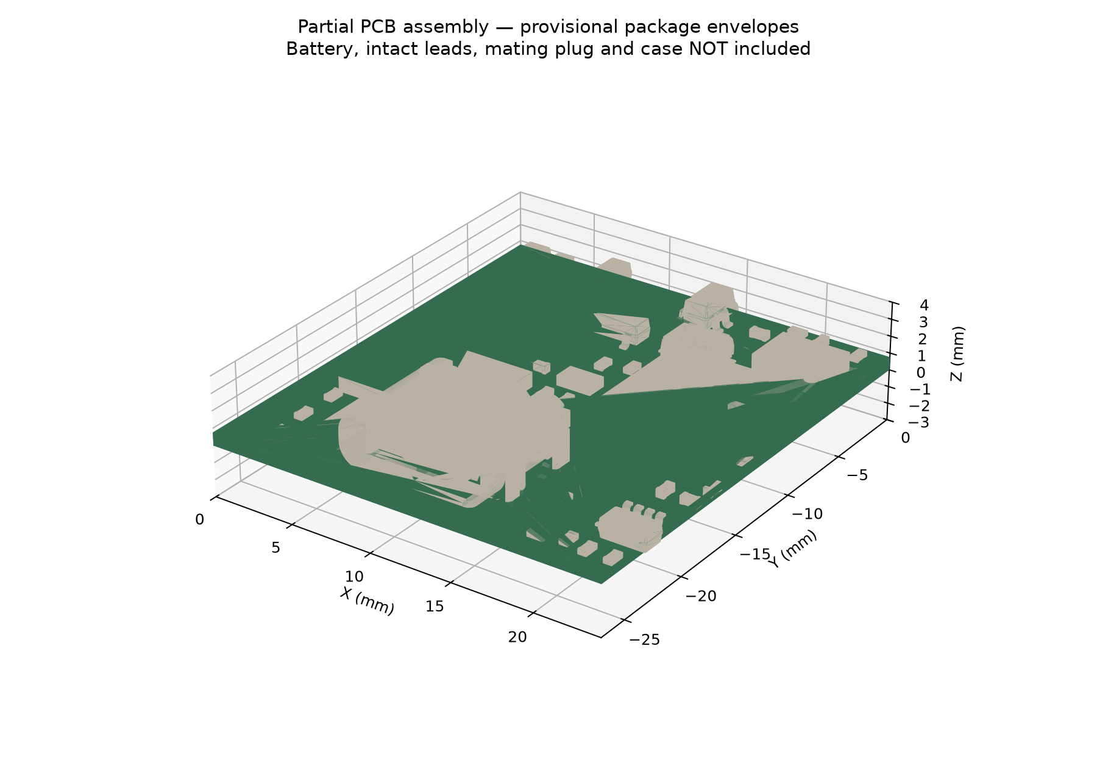
mechanical/xe-minimal/pcb-partial-assembly-study.png
