nyanko3141592/pendant-recorder/mechanical/xe-minimal/prototype-v1/hw-v1-size-fit-print-kit-v1-preview.png

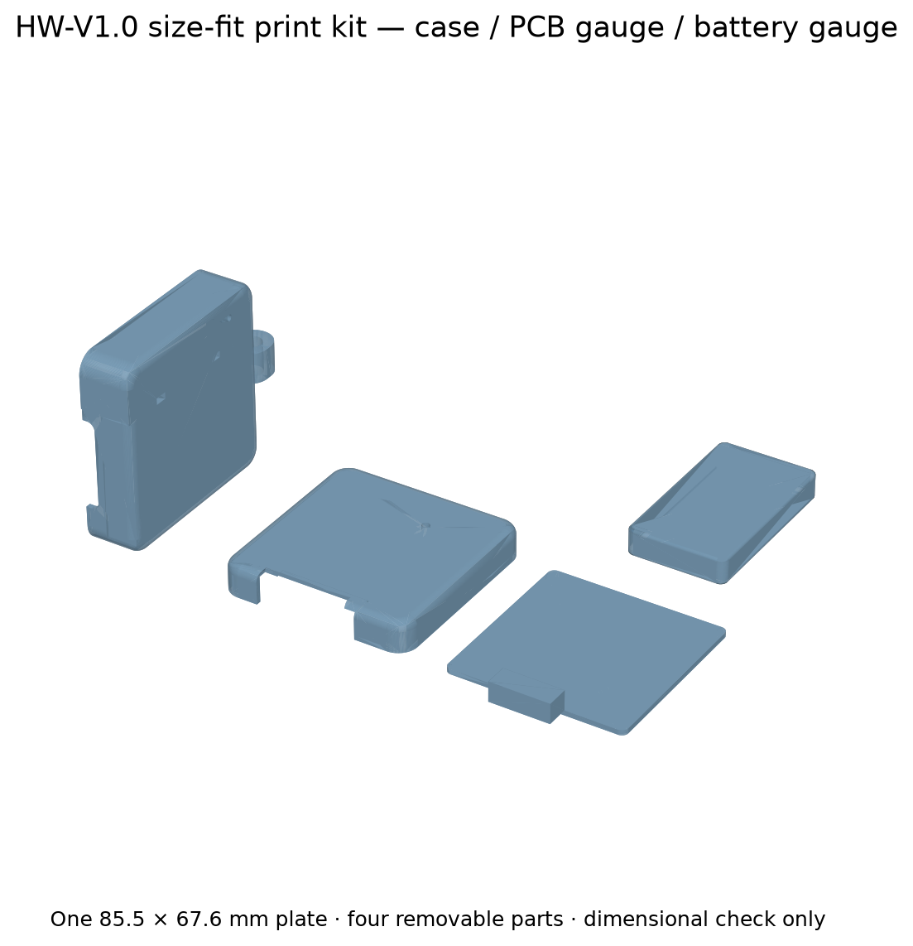
mechanical/xe-minimal/prototype-v1/hw-v1-size-fit-print-kit-v1-preview.png
