nyanko3141592/pendant-recorder/docs/validation/2026-10-24-d1-circular.md

# 円形D1の検証記録

2026-10-24。D0角丸をユーザーが却下、円形基板・円形ケースへ再設計。

- 全76参照、69実装部品を保持。U9をTXS0104ERUTRへ変更しTI表5-4で再割当。TP1〜6は1mmパッド。MCU/メモリ/マイク/充電/NTCは維持。
- 直径23mm基板。USBボディ張出しを許容し、全パッドは円内。既存courtyardの外への追加余白を0.02mmに整理。基板製造ルール/DRC除外は変更せず。
- KiCad10 ERC0、schematic parity0、独立ネット/外形包含照合0。DRC4（USB穴間クリアランス）、未接続182、配線0、発注不可。
- SolidCraft円形ケースD25.5×14.5mm、PCB、電池予約、全部品包絡、USB口、LED/ボタン穴を作成。STEP組立/分解出力と画像出力成功。画像を目視確認。
- 旧C/角丸D0/円形D1/Omi近似/500円玉を同縮尺で比較。外形体積概算D1はD0比20.2%減、C0比34.4%減。Omi実製品の曲面・装着部体積の比較ではない。
- 配線予約とC15の包絡干渉を検出して予約位置変更。これは全体の厳密なBRep干渉検証ではない。

未実施: PCB配線/実装受理/調達、実電池収納・公差・USBケーブル嵌合、ケース固定・装着部・音道、NTC応答、実録音ファーム、16h動作/36h保存/暗号化/電源断/3OS同期試験。実測なしで16h達成とはしない。
