nyanko3141592/pendant-recorder/docs/validation/2026-10-24-d0-fit-study.md

# D0 配置・構造検討の検証記録

ユーザー依頼: 「設計してシミュ見せて」。対象 `hardware/omi-fit-d0`、`mechanical/structure-d0`。日付2026-10-24。

## 実行と結果

- KiCad 10 pcbnew: Rev C由来76参照を23mm角R2基板へ再配置、J2のみSH横型へ置換。初回の円形23mm探索150 seedでは全数配置案を得られず、角丸案で全数配置。探索不成立を幾何学的不可能とは判定しない。
- 初回DRCでUSB貫通パッドと裏面MCU等の干渉を検出。USB貫通穴/パッドの裏面予約を追加して配置を再生成。
- 最終DRC: 4件、全てUSB穴間クリアランス。未接続182、配線0。Rev Cと同じルール・除外なし。発注不可。
- 独立 `verify.py`: 全参照、パッドネット割当、最終フットプリント矩形の角丸基板内包含を検証。不一致/外形逸脱0。回路図parityは未確認。
- SolidCraft: 配置JSONからケース、PCB、全部品の簡略包絡、丸形パックと配線/PCM予約を生成。組立/分解モデルのSTEP出力成功、透過/分解/寸法比較画像を目視確認。
- matplotlib: 電流と使用可能容量の感度図、実配置図を生成。150mAh×70%÷5mA=21h、÷6mA=17.5h、÷7mA=15h。これは電流予測ではない。
- 角丸外形体積概算: D0 9276mm³、C0 11281mm³、Omi円柱近似7661mm³。D0はC比約18%減、Omi近似比約21%増。

## 未実施/未成立

電気過渡/熱/SPICEシミュレーション、実録音ファーム、消費電流・実電池試験、ルーティング、JLC受理、完成パック調達、詳細部品3D公差監査、全体干渉解析、USBケーブル嵌合、ケース固定・音道・装着部、NTC熱応答。発注可否は `hardware/omi-fit-d0/order-status.json`。本結果は16h達成や完成外形の保証ではない。
