nyanko3141592/pendant-recorder/mechanical/xe-minimal/assembly-validation-plan-ja.txt

XE固定電池レコーダー：組立検証手順案（開発者用・購入者向け未公開）
対象：current-model-delivery.jsonに記録した基板・ケース候補。
目的：DTP401525-XE / DTP401525(EZ3)の出荷状態の電池を、配線加工なしで取り付けられるかを確認する。
現状：純正プラグ全体とリード線を含む経路は未検証。この文書は組立可能の証明ではない。

開発側で先に確定する事項
・純正プラグの突起を含む最大外形、嵌合方向・押す位置、電池側と基板側の極性。
・各リード線の実際の可とう部分の長さ、出口方向、線径、曲げ条件。図面の15±3mmを可とう長に代用しない。
・基板の電源保護と温度監視の検証。電池をつなぐと給電されるため、機械検討はまず非通電の寸法模型で行う。
・温度センサー接触材、絶縁材、ケース接着剤の型番と厚さ。未確定の材料を購入者に選ばせない。
・A1 mini / PLA / 0.4mmで印刷したケースの実寸。CADの非干渉を印刷後の嵌合保証に代用しない。

検証する組立順序（採用前）
1. 下ケース、仕切り板、基板、上ケースを電池なしで確認する。止め部・開口・仕切り板の位置を記録する。
2. ケース外で電池と基板を接続する案を確認する。プラグを指定方向に押せること、コネクター直下の基板を支えられること、部品や線を押さずに完全嵌合を確認できることが必要。
3. 接続した電池と基板の間に仕切り板を配置できる順序を確認する。仕切り板を通すために電池の線を外したり加工したりする案は不採用。
4. 接続済みの組を下ケースへ入れる。電池、仕切り板、基板をそれぞれ支持部へ着座させる。線が届く最終位置だけでなく、挿入途中にも張力や挟み込みがないことを確認する。
5. 完全着座と配線を目視確認する。基板下面の端子、仕切り板端、ケース止め部、接着面に線を挟まない。電池を押して部品との隙間を作る構造は不採用。
6. 上ケースを接着せずに仮合わせする。蓋を押し込む力で電池やプラグを押し下げない。USB開口、音道、温度接触材の位置を確認する。
7. 電気設計の検証を済ませた実装基板と実電池で、閉鎖前の動作確認を行う。条件と測定結果は別の電気試験記録に残す。
8. 接着剤・塗布量・硬化条件を確定後、ケース合わせ面だけを接着する。電池・配線・プラグを接着しない。硬化後の外形・USB挿抜・音道・温度接触を再確認する。

記録と判定
5台の試作それぞれについて、電池購入SKUとロット、ケース印刷条件、部品実寸、挿入経路、完全嵌合、線の余裕、閉鎖前後の状態を記録する。
未測定項目は未測定のまま残す。失敗時に電池の線を短縮・延長・交換して合格にしない。
一個の試作が入っただけで購入者全員の無加工組立を保証しない。公開最大寸法と印刷・組立のばらつきを別途確認する。
現状のモデルにある5部材は最終位置で互いに非干渉。電池と仕切り板の単独垂直挿入も公称形状で非干渉。ただし、接続済み配線を含む手順2〜4は未成立。

購入者向け説明書へ移す内容
検証済みの同梱部材と電池購入先、写真付きの向き・押す位置・完全嵌合の見分け方、挿入順、配線の収め方、閉鎖方法、USB接続とPC初回設定。
購入者に寸法測定、極性の電気測定、はんだ付け、配線加工、部材選定を要求しない。

コネクター資料の適用確認（2026-10-27追加）
AS-78172-001 rev Cは冒頭で500*系列を指定し、今回の0003への適用は未確認。公式AS-78172-006-001.pdfは本文番号AS-78172-007・暫定版のため、記載の角度数値を今回の合否基準に転用しない。詳細はplug-application-spec-review.json。ケースの蓋を押してコネクターを嵌合させる工程は設けず、閉鎖前に嵌合状態を目視できる配置を維持する。
