nyanko3141592/pendant-recorder/hardware/rev-a/verification.md

# 検査記録 — Rev A1、2026-10-24

- KiCad 10.0.7で回路図・基板読込、SVG描画に成功。
- 回路図ERC: **0件**、除外ルールなし。
- ネットリストとdesign.json照合: **92実部品、282接続端子、26 NC端子、60ネットが一致**。4個のPWR_FLAGは実部品/BOMから除外。
- 基板生成時、全308論理端子と実フットプリントの端子番号を照合。USB重複端子等を許容。
- PCB: **20×34×0.8mm、4層、未配線（配線0本）**。
- PCB DRC: **19違反、221未接続項目**。未合格。詳細は[配置レビュー](layout-review.md)。マイク環状パッドの不正形状と反対面部品の音孔干渉を修正した。
- ST公式端子データとの照合はpackage-pin-audit.json。以前の48ピンSDMMC誤りを修正済み。

未実施: 部品の全品番監査、JLC実装受理、配線、信号/電源品質、USB動作試験、充電温度試験、連続24時間録音・平均電流測定、音響測定、現基板と既製電池/配線を含む筐体干渉確認。ERC合格を製造承認と扱わない。

旧SolidCraftモデル（26×26×12mm）は過去の寸法検討用。現基板・既製パックの適合モデルではない。

追記: J3をメーカーTC2030-CTX対応6点へ更新。SWOは追加NC、NRST=3/GND=5へ変更。J3の反対面にも位置決め穴用領域を予約した。ERC0、DRC19、未配線221を再確認。order-preflight.jsonは発注不可の検査記録。
