nyanko3141592/pendant-recorder/hardware/mini-usb-v9/schematic.pdf

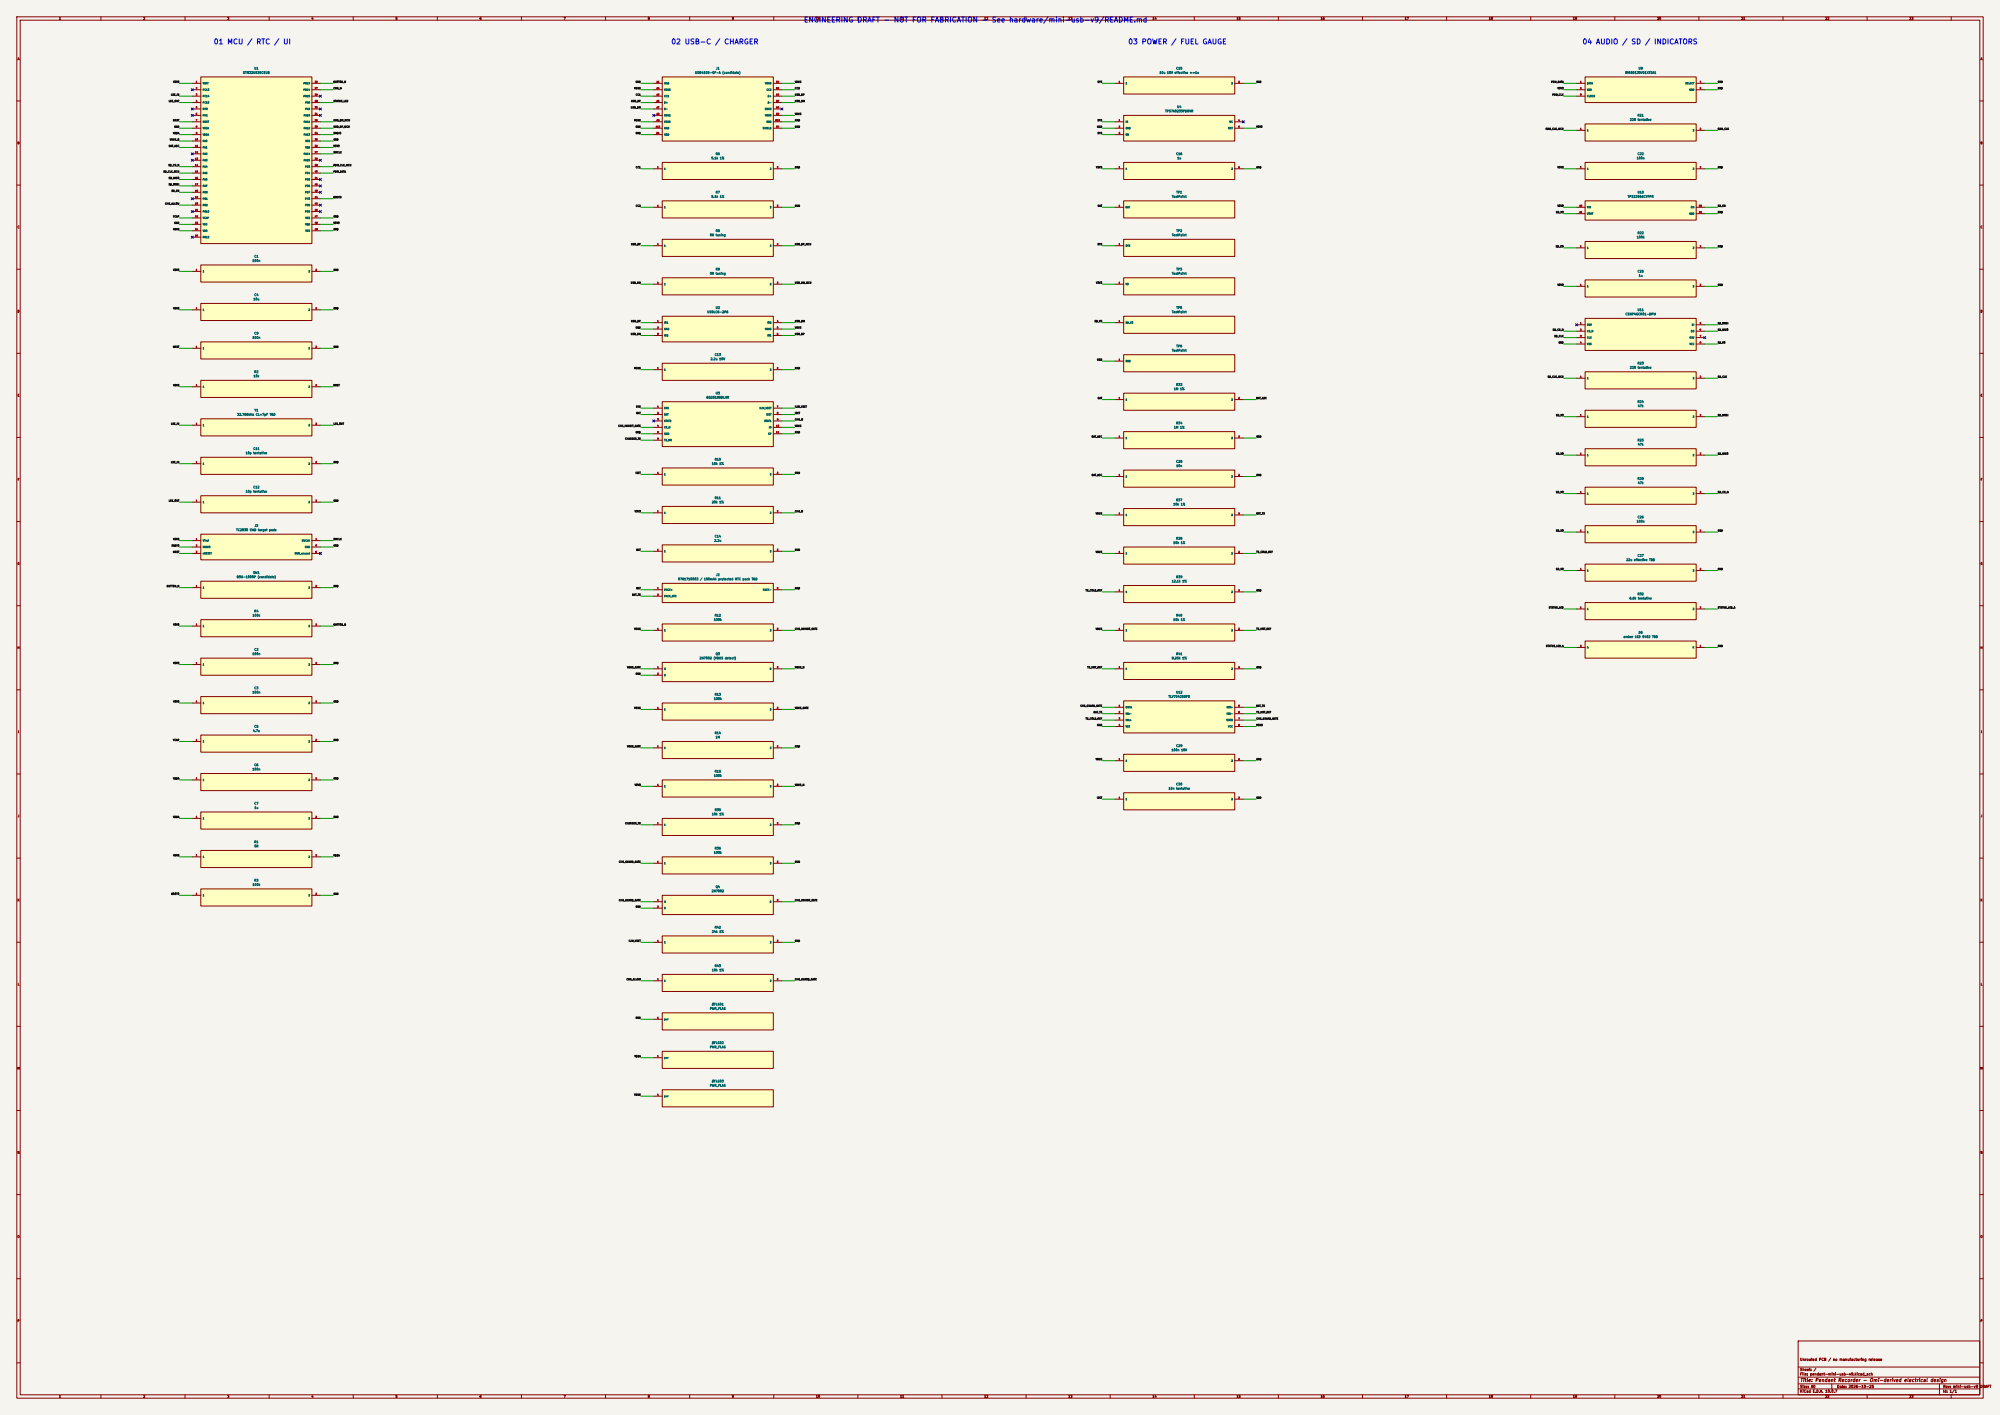
[picture p274: page 1]

ENGINEERING DRAFT - NOT FOR FABRICATION - See hardware/mini-usb-v9/README.md

0781710003 / 100mAh protected NTC pack TBD

Unrouted PCB / no manufacturing release

Sheet: /
File: pendant-mini-usb-v9.kicad_sch
Title: Pendant Recorder - Omi-derived electrical design
