nyanko3141592/pendant-recorder/hardware/compact-100-v5/schematic.pdf

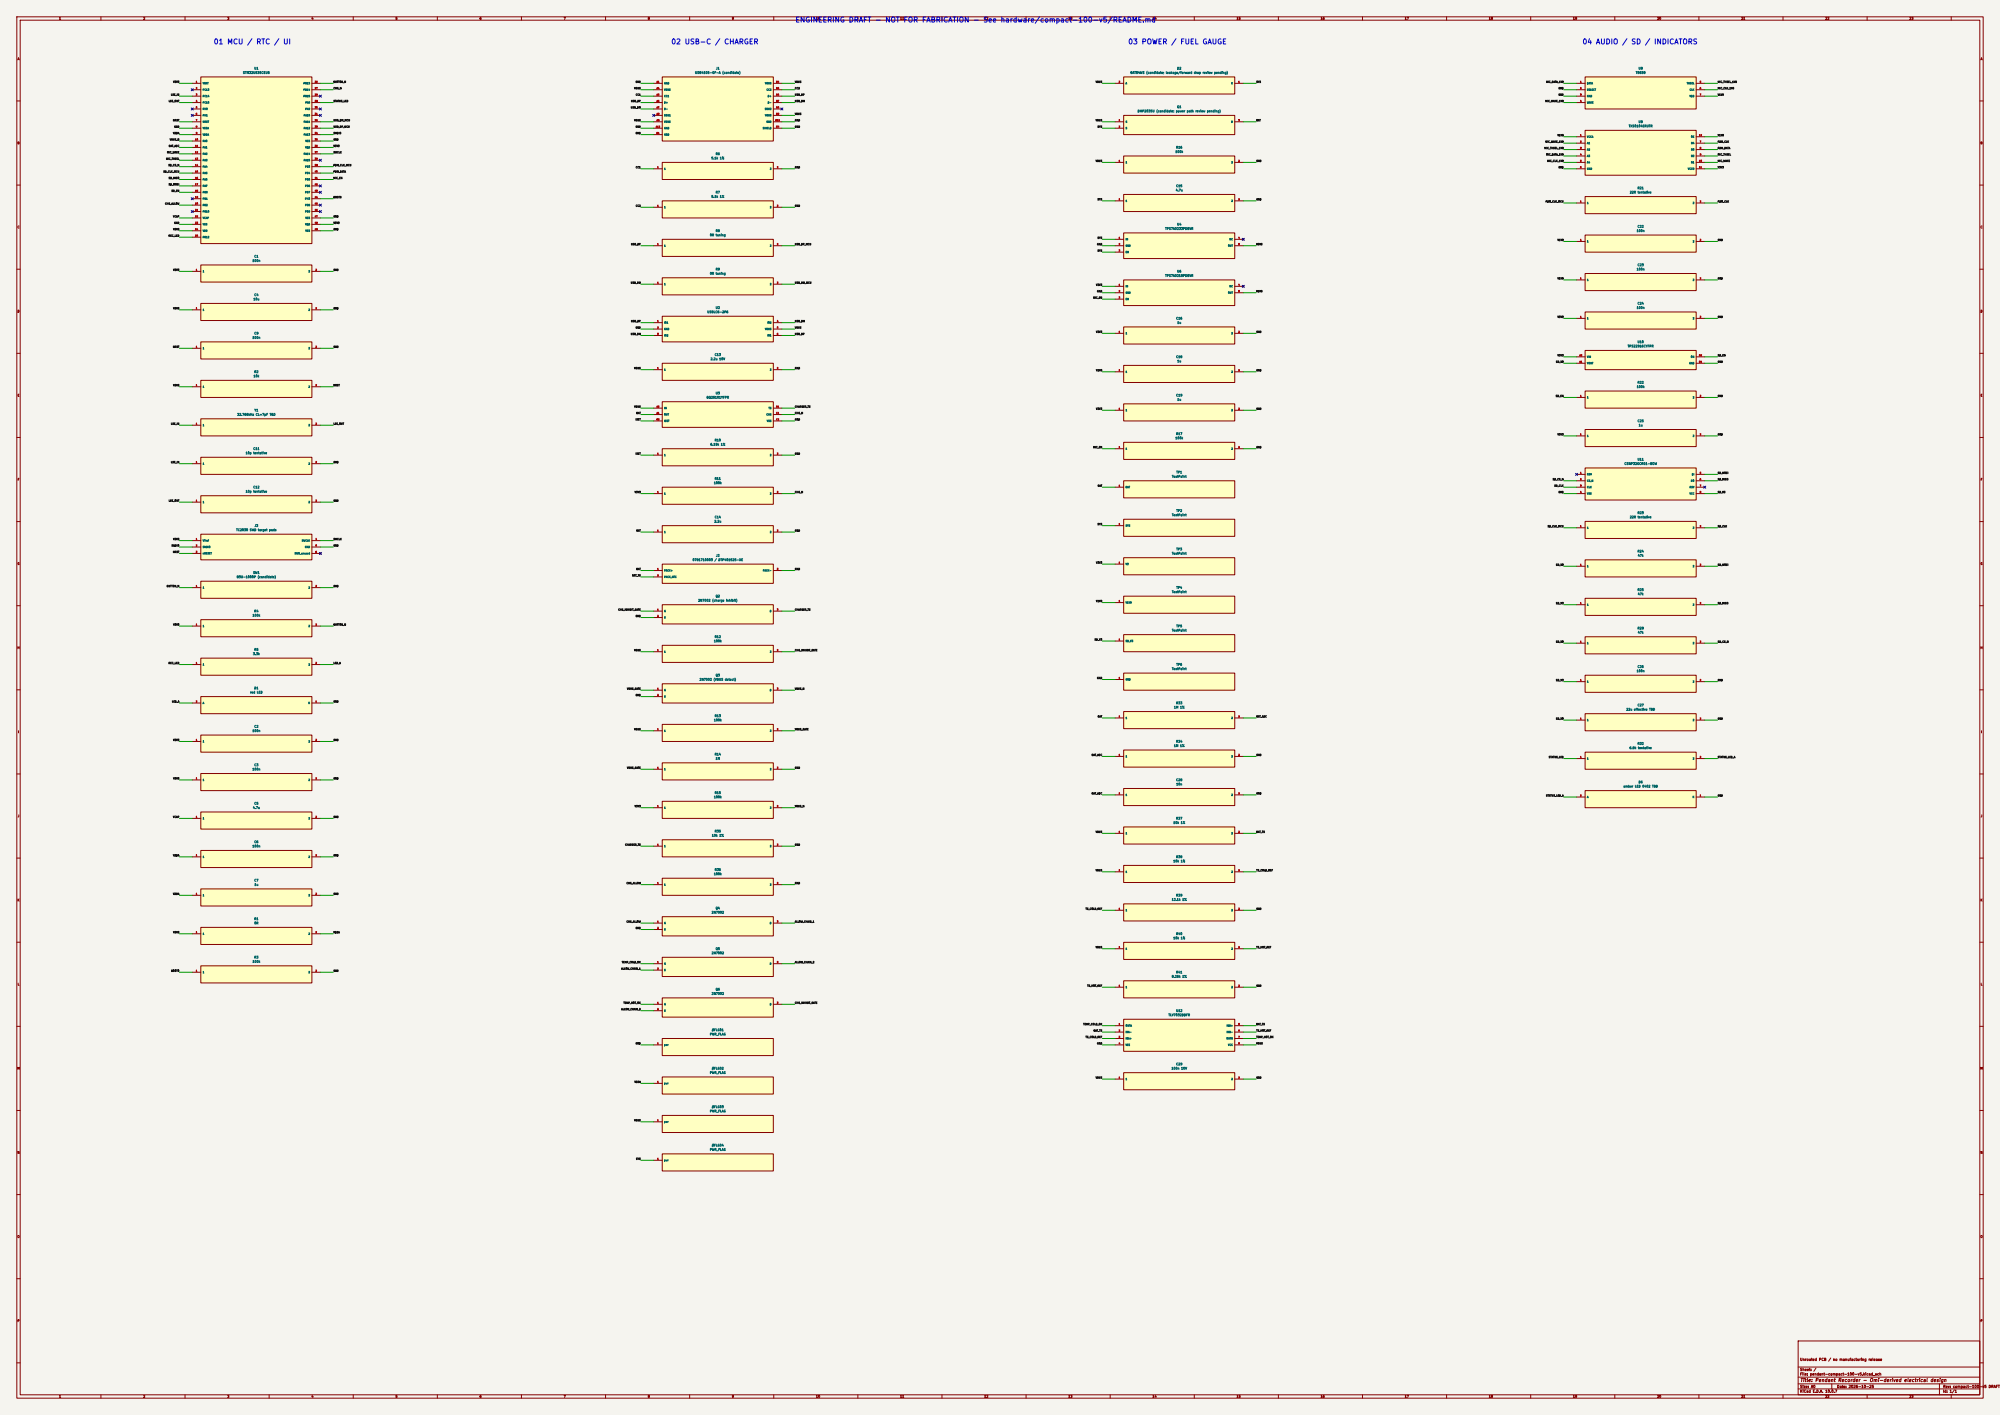
[picture p275: page 1]

ENGINEERING DRAFT - NOT FOR FABRICATION - See hardware/compact-100-v5/README.md

Unrouted PCB / no manufacturing release

Sheet: /
File: pendant-compact-100-v5.kicad_sch
Title: Pendant Recorder - Omi-derived electrical design
KiCad E.D.A. 10.0.7
