nyanko3141592/pendant-recorder/hardware/charge-guard-v4/schematic-review.pdf

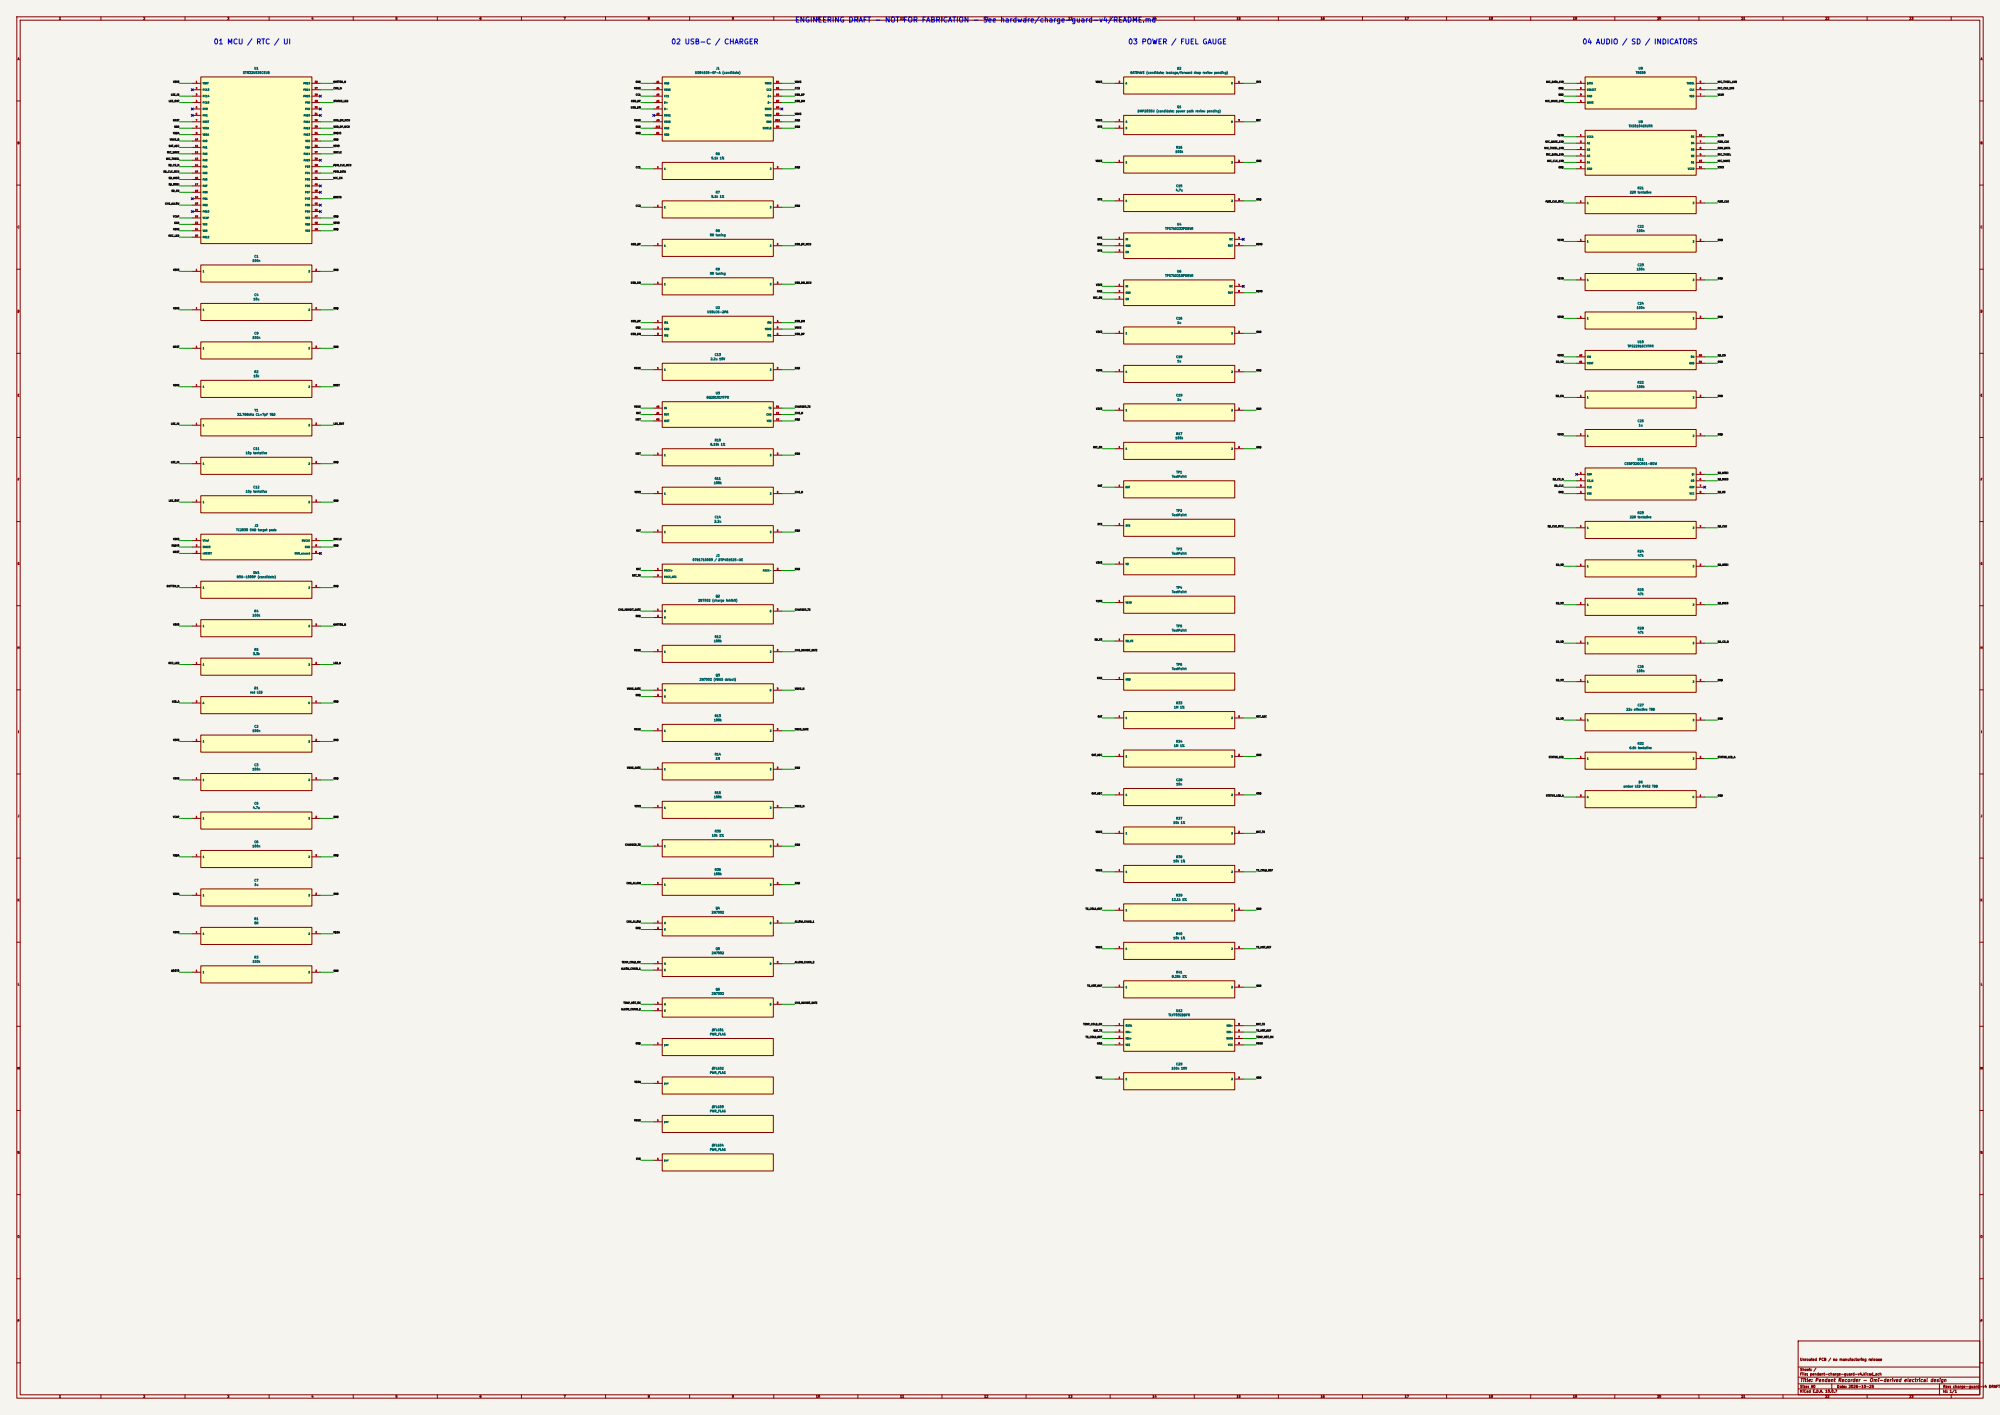
[picture p276: page 1]

ENGINEERING DRAFT - NOT FOR FABRICATION - See hardware/charge-guard-v4/README.md

Unrouted PCB / no manufacturing release

Sheet: /
File: pendant-charge-guard-v4.kicad_sch
Title: Pendant Recorder - Omi-derived electrical design
KiCad E.D.A. 10.0.7
