nyanko3141592/pendant-recorder/hardware/compact-a/schematic.pdf

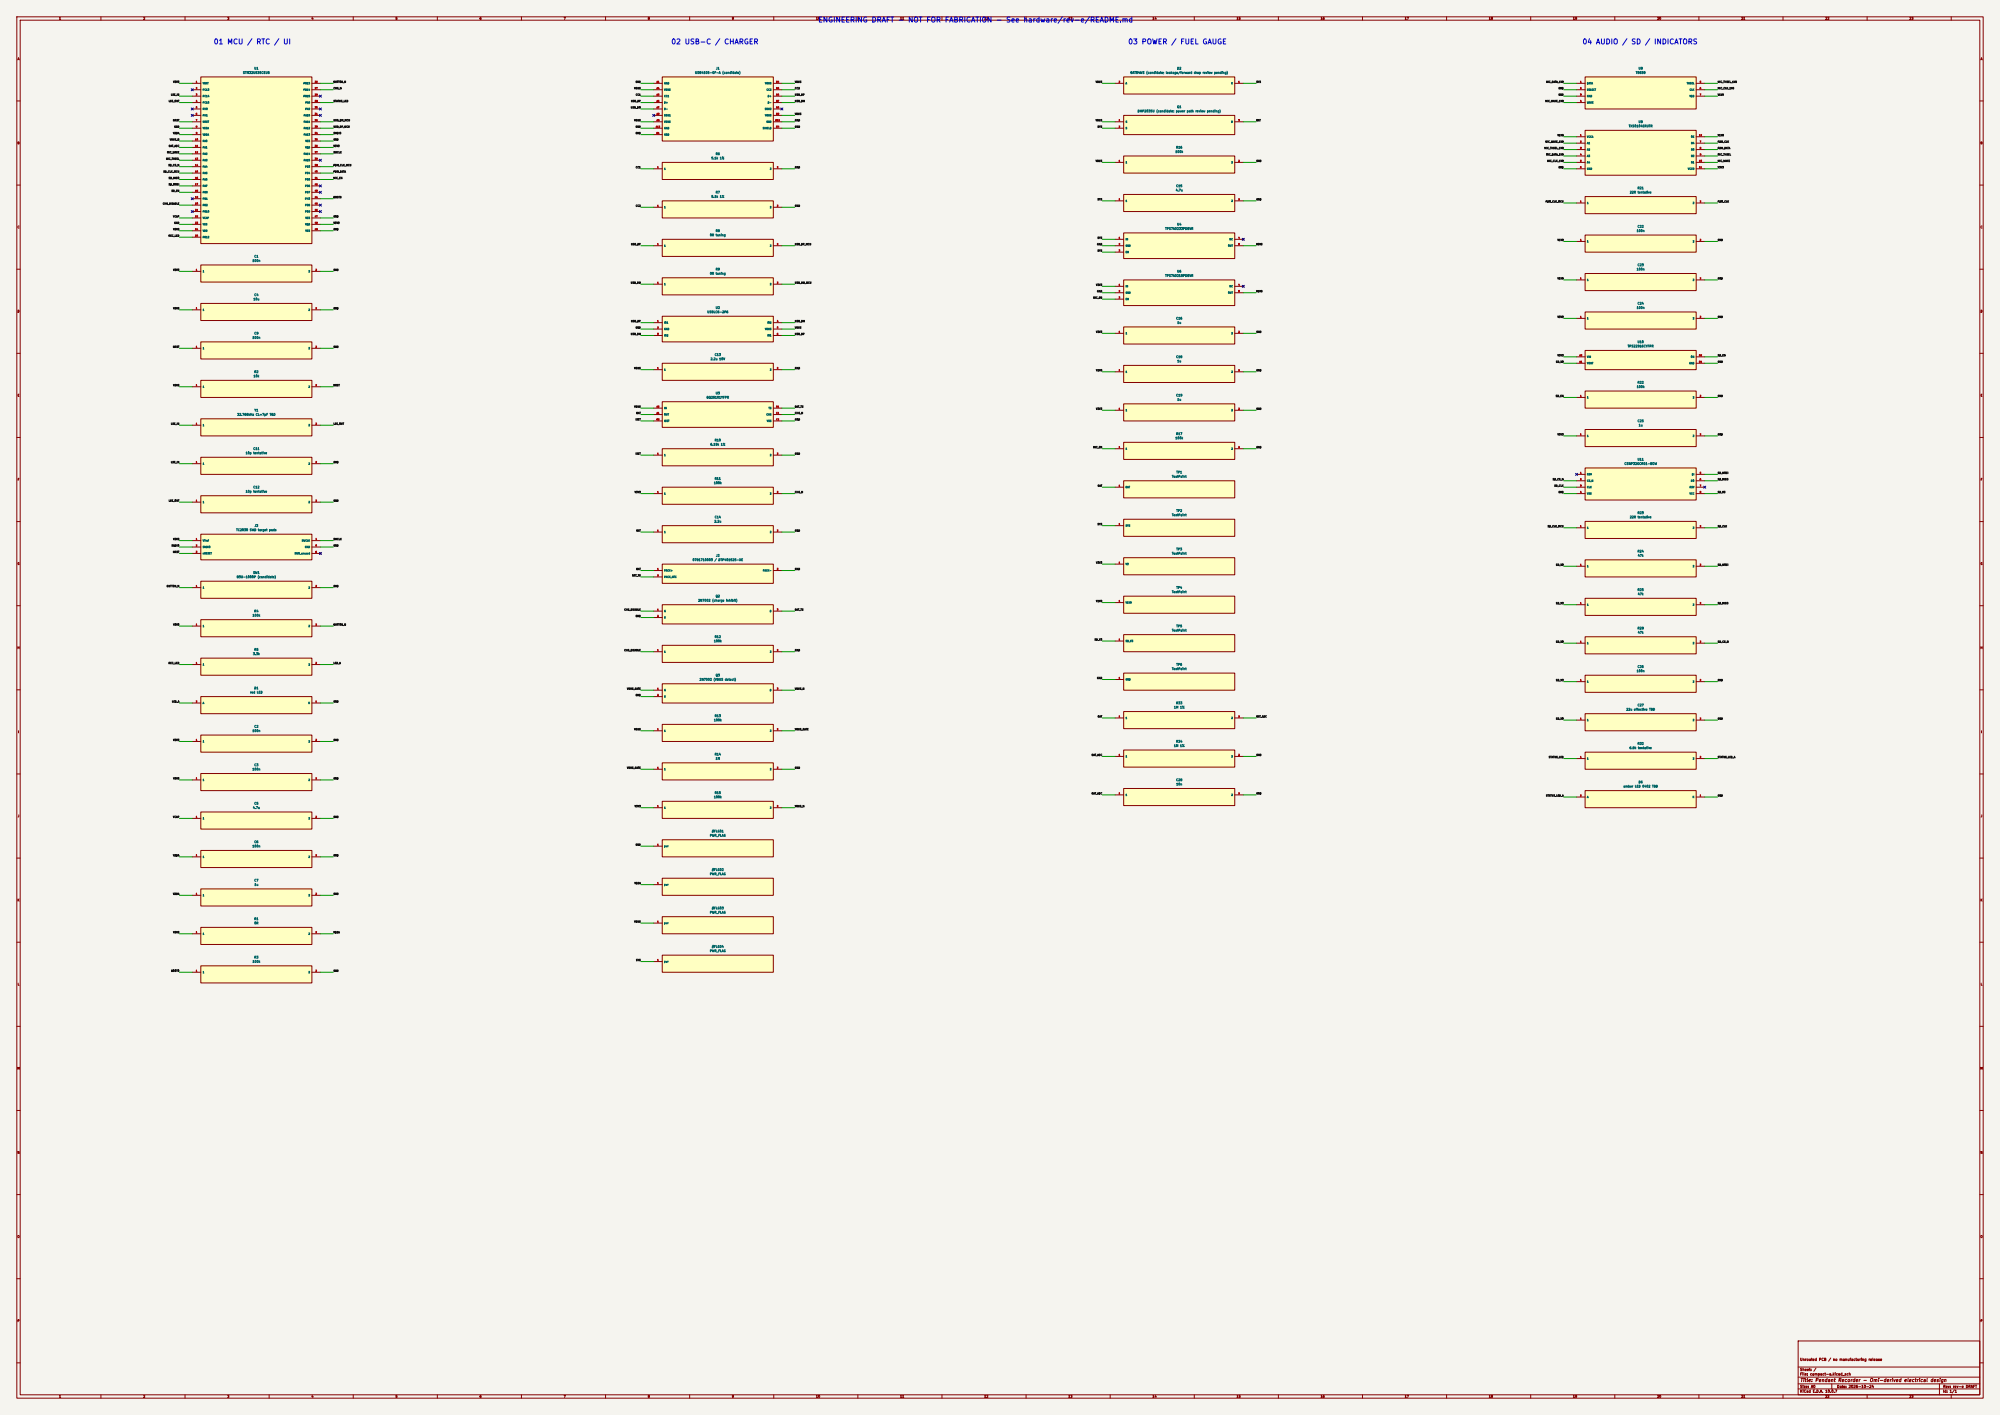
[picture p277: page 1]

Unrouted PCB / no manufacturing release

Sheet: /
File: compact-a.kicad_sch
Title: Pendant Recorder - Omi-derived electrical design

Size: A0 | Rev: rev-e DRAFT
KiCad E.D.A. 10.0.7 | Id: 1/1
