nyanko3141592/pendant-recorder/hardware/compact-b/schematic.pdf

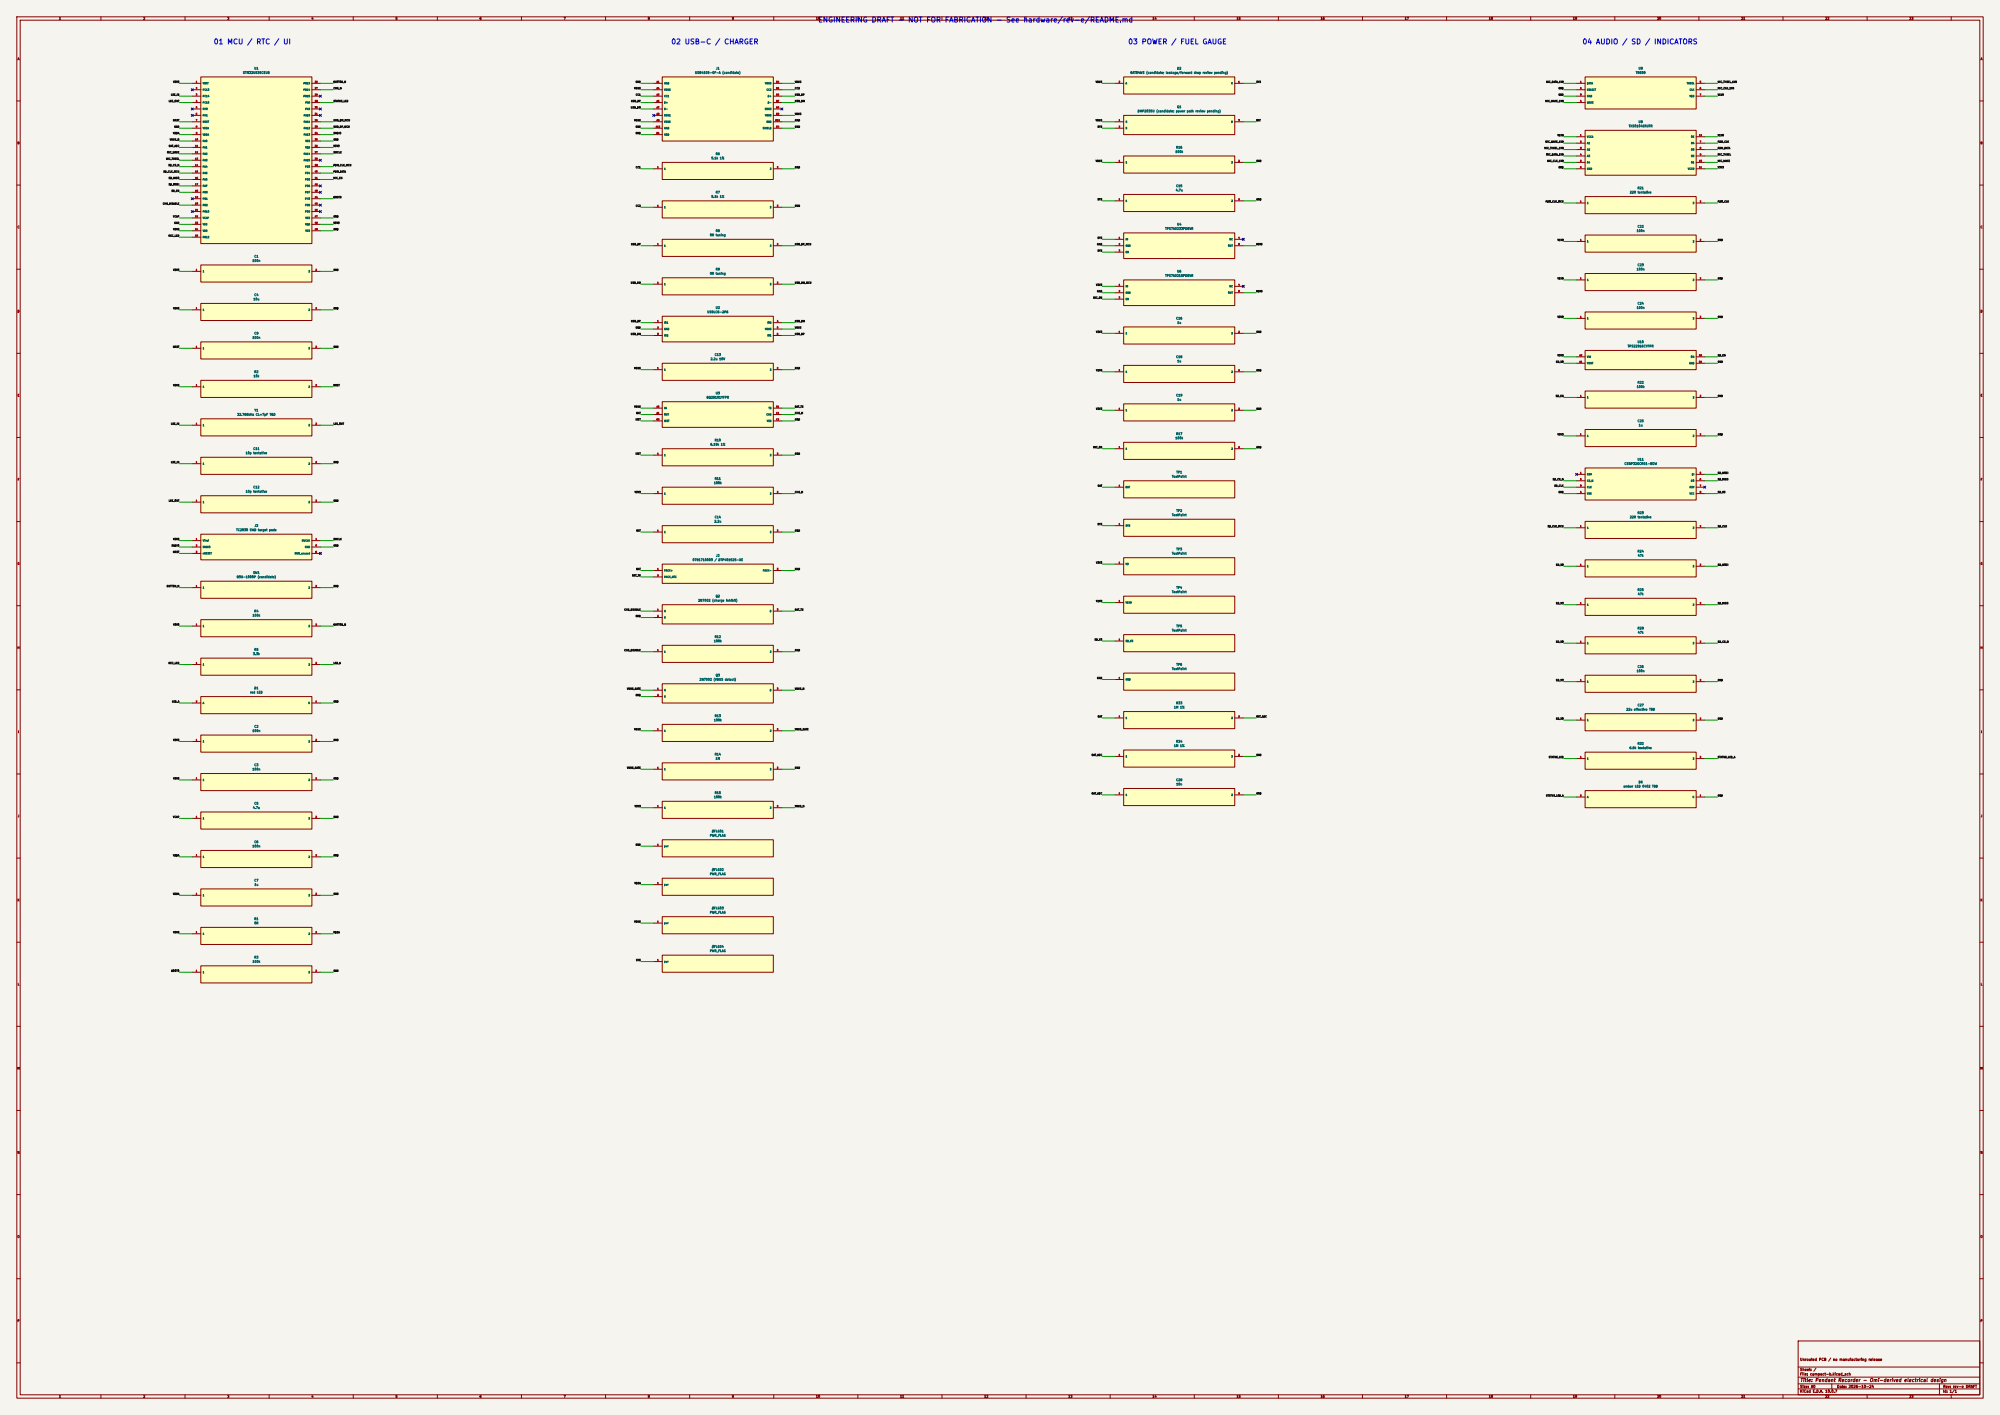
[picture p278: page 1]

Unrouted PCB / no manufacturing release

Sheet: /
File: compact-b.kicad_sch
Title: Pendant Recorder - Omi-derived electrical design

Size: A0 | Rev: rev-e DRAFT
KiCad E.D.A. 10.0.7 | Id: 1/1
