nyanko3141592/pendant-recorder/hardware/omi-fit-d1/schematic.pdf

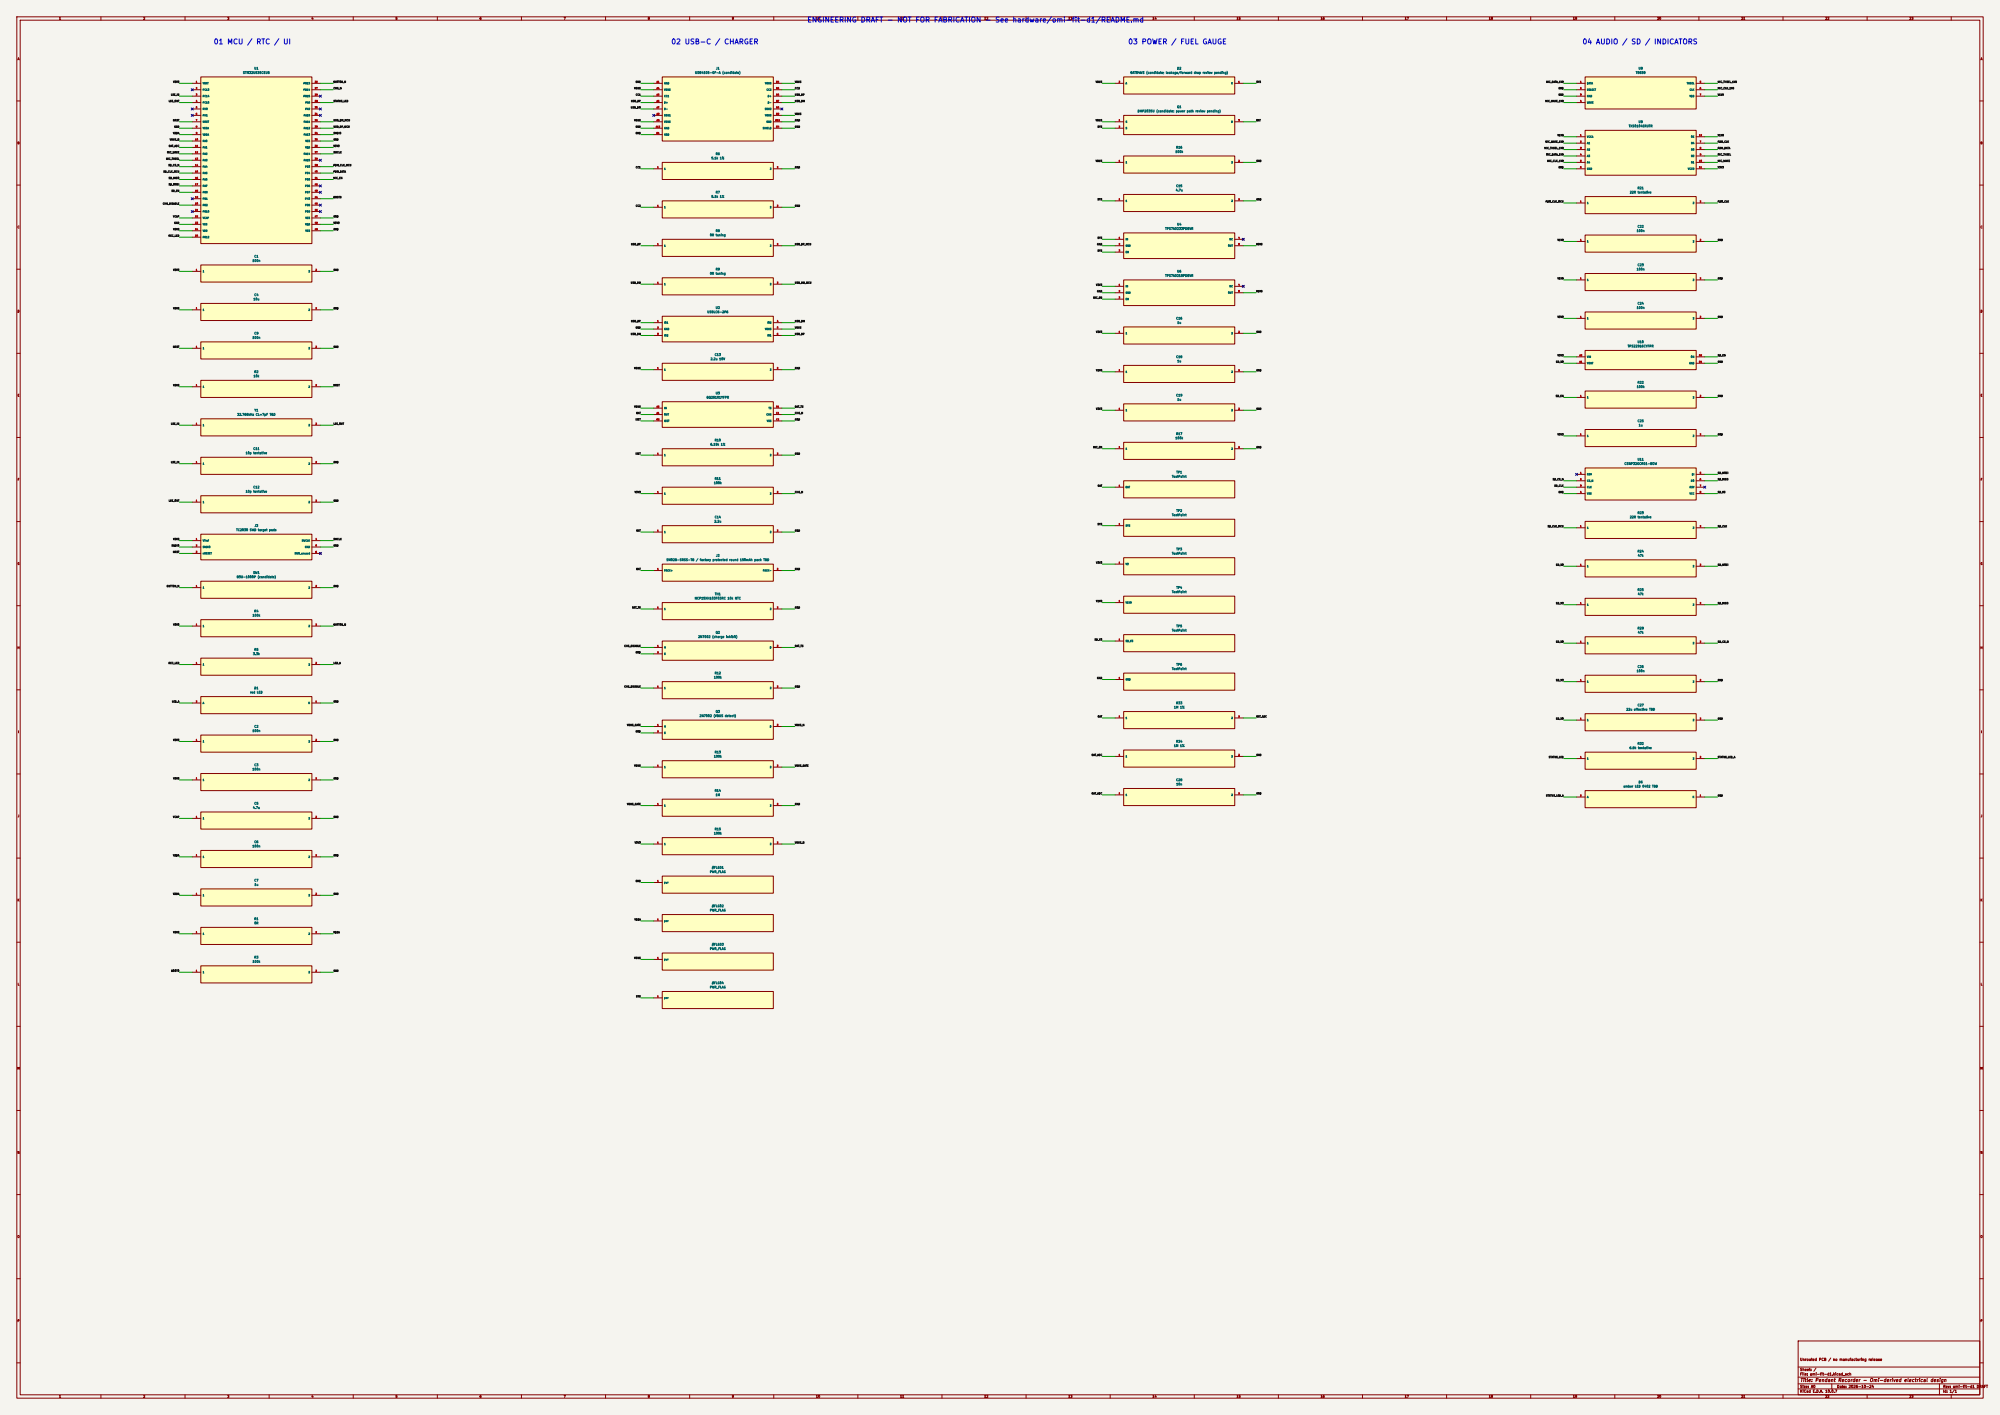
[picture p279: page 1]

3 Q1 DMP2035U (candidate; power path review pending) GND

SM02B-SRSS-TB / factory protected round 150mAh pack TBD

Unrouted PCB / no manufacturing release

Sheet: /
File: omi-fit-d1.kicad_sch
Title: Pendant Recorder - Omi-derived electrical design
