nyanko3141592/pendant-recorder/hardware/rev-c/pendant-rev-c.pdf

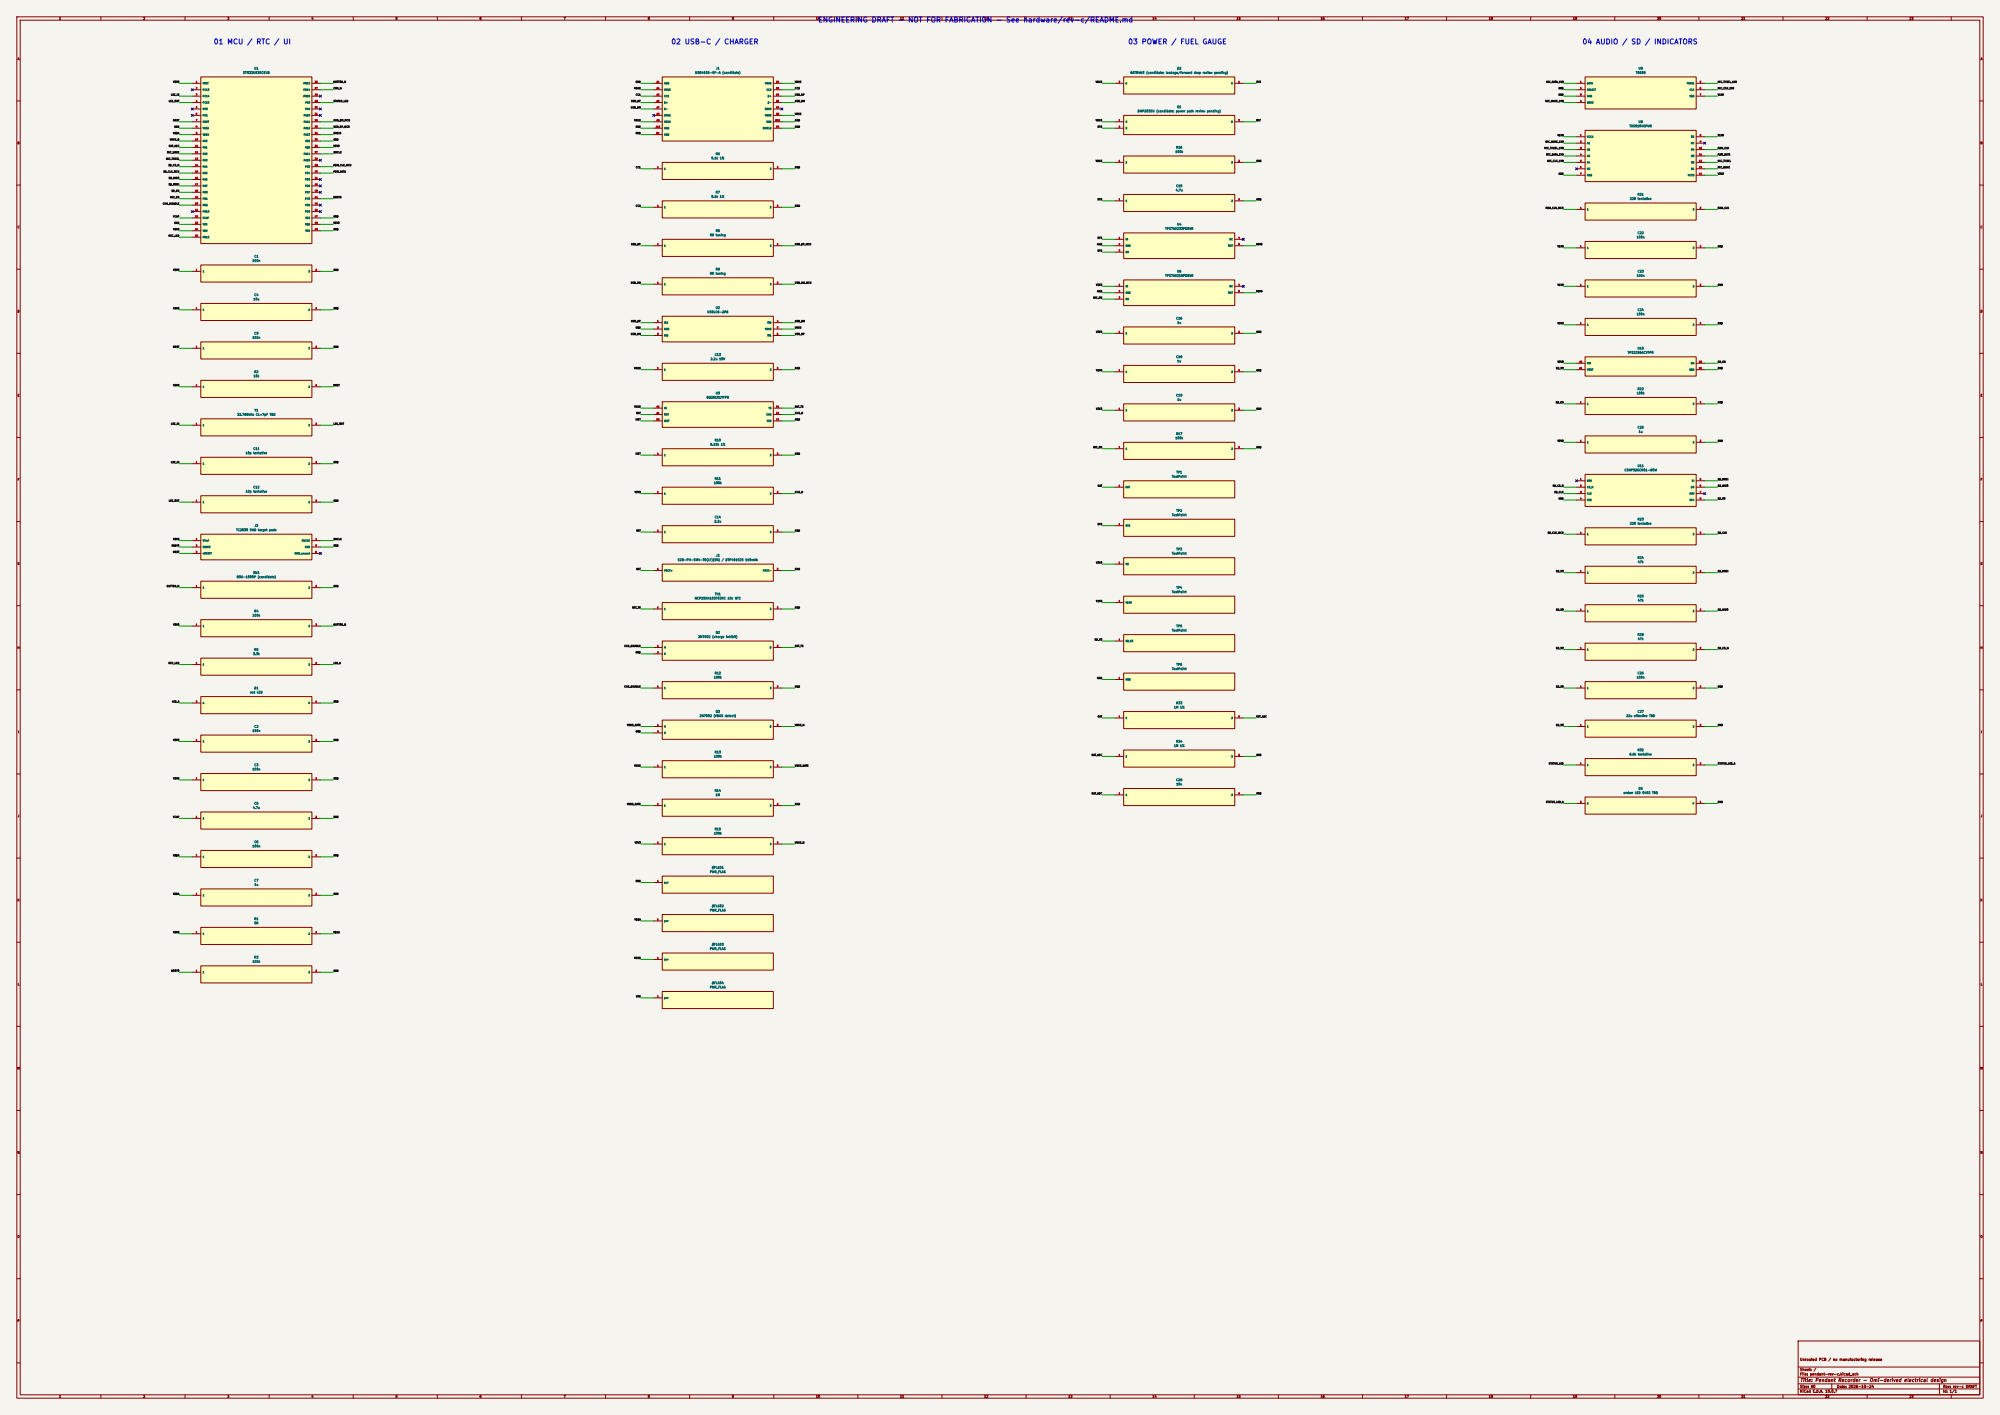
[picture p280: page 1]

3 Q1 DMP2035U (candidate; power path review pending) GND

S2B-PH-SM4-TB(LF)(SN) / DTP401525 110mAh

Unrouted PCB / no manufacturing release

Sheet: /
File: pendant-rev-c.kicad_sch
Title: Pendant Recorder - Omi-derived electrical design

Size: A0 | Rev: rev-c DRAFT
KiCad E.D.A. 10.0.7 | Id: 1/1
