nyanko3141592/pendant-recorder/(list of files, drawings)

Other design files:
hardware/charge-guard-v4/route.dsn
hardware/compact-100-v5/route.dsn
hardware/compact-a/route.dsn
hardware/compact-b/electrical-placement-v3/route.dsn
hardware/compact-b/routing-v2/input.dsn
hardware/mini-rect-v11/plane6-fixedvia.dsn
hardware/mini-rect-v11/plane6-trial.dsn
hardware/mini-rect-v11/plane-trial.dsn
hardware/mini-rect-v11/route-trial.dsn
hardware/mini-rect-v12/route-trial.dsn
hardware/mini-rect-v13/charger-plane-continuation.dsn
hardware/mini-rect-v13/charger-route-trial.dsn
hardware/mini-rect-v13/critical-first.dsn
hardware/mini-rect-v13/plane-continuation.dsn
hardware/mini-rect-v13/route-trial.dsn
hardware/mini-rect-v13/schematic-verification.json
hardware/mini-rect-v15/input-control-gpio/global-route.dsn
hardware/mini-rect-v15/input-control/input-route.dsn
hardware/mini-rect-v15/xe-route.dsn
hardware/mini-usb-v9/route-trial.dsn
hardware/omi-fit-d1/routing/input.dsn
hardware/omi-fit-d1/routing/refine.dsn
hardware/rev-b/pcb-net-audit.json
hardware/rev-b/routing/input.dsn
hardware/rev-c/pcb-net-audit.json
hardware/rev-c/routing/input.dsn
hardware/rounded-fit-v7/route-035.dsn
hardware/rounded-fit-v7/route.dsn
hardware/xe-minimal/button-pa15-trial/digital-rebuild.dsn
hardware/xe-minimal/button-pa15-trial/pa15-router-broad.dsn
hardware/xe-minimal/button-pa15-trial/pa15-router-screen.dsn
hardware/xe-minimal/costdown/HW-V1.1-EVT-COSTDOWN/hw-v1.1-evt-costdown-4layer-unrouted.dsn
hardware/xe-minimal/costdown/HW-V1.2-EVT-ULTRACOST/hw-v1.2-evt-ultracost-4layer-single-side-unrouted.dsn
hardware/xe-minimal/costdown/HW-V1.3-EVT-ECONOMIC/functional-placement/hw-v1.3-functional-placement.dsn
hardware/xe-minimal/costdown/HW-V1.4-EVT-4LAYER-27P5/route/hw-v1.4-evt-4layer-27p5-unrouted.dsn
hardware/xe-minimal/preorder-20261029/escape-first-unrouted.dsn
hardware/xe-minimal/preorder-20261029/fixed-critical-corridor-unrouted.dsn
hardware/xe-minimal/preorder-20261029/ilim-escape-unrouted.dsn
hardware/xe-minimal/preorder-20261029/iset-ilim-unrouted.dsn
hardware/xe-minimal/preorder-20261029/mixed-global-unrouted.dsn
hardware/xe-minimal/preorder-20261029/mixed-l3-unrouted.dsn
hardware/xe-minimal/preorder-20261029/pdm-source-unrouted.dsn
hardware/xe-minimal/preorder-20261029/pdm-tp6-unrouted.dsn
hardware/xe-minimal/preorder-20261029/plane-first-unrouted.dsn
hardware/xe-minimal/preorder-20261029/plane-power-unrouted.dsn
hardware/xe-minimal/preorder-20261029/plane-repair-unrouted.dsn
hardware/xe-minimal/preorder-20261029/r42-escape-unrouted.dsn
hardware/xe-minimal/preorder-20261029/signal-corridor-unrouted.dsn
hardware/xe-minimal/preorder-20261029/source-clock-unrouted.dsn
hardware/xe-minimal/preorder-20261029/spi-cluster-unrouted.dsn
hardware/xe-minimal/preorder-20261029/usb-back-corridor-unrouted.dsn
hardware/xe-minimal/preorder-20261029/usb-corridor-unrouted.dsn
hardware/xe-minimal/schematic-erc.json
hardware/xe-minimal/schematic-review.json
mechanical/compact-100-v5/print/pcb_bare_24x27x0.8.json
mechanical/compact-100-v5/print/pcb_with_component_envelopes.json
mechanical/compact-ab/fit-check/A/pcb_components.json
mechanical/compact-ab/fit-check/B/pcb_components.json
mechanical/mini-rect-v15/pcb-retention-sites.json
mechanical/xe-minimal/home-case-slice-review/arachne-four-wall-lower/pcb-seat-layer-review.json
mechanical/xe-minimal/home-case-slice-review/arachne-lower/pcb-seat-layer-review.json
mechanical/xe-minimal/home-case-slice-review/fine-lower/pcb-seat-layer-review.json
mechanical/xe-minimal/home-case-slice-review/four-wall-lower/pcb-seat-layer-review.json
mechanical/xe-minimal/home-case-slice-review/solid-fine-lower/pcb-seat-layer-review.json
mechanical/xe-minimal/home-case-slice-review/wider-right-lower/pcb-seat-layer-review.json
mechanical/xe-minimal/pcb-omi-comparison-review.json
mechanical/xe-minimal/pcb-retention-study-review.json
mechanical/xe-minimal/pcb-support-pad-review.json
mechanical/xe-minimal/pcb-support-screen.json
