nyanko3141592/pendant-recorder/hardware/mini-usb-v9/pendant-mini-usb-v9.kicad_sch

## KiCad design hardware/mini-usb-v9/pendant-mini-usb-v9.kicad_sch (2026-10-29)

Schematic: pendant-mini-usb-v9.kicad_sch

Parts:
C1, C2, C3, C6, C9, C22, C26: 100n; C_0402_1005Metric
C4: 10u; C_0603_1608Metric
C5: 4.7u; C_0603_1608Metric
C7, C16, C25: 1u; C_0402_1005Metric
C11, C12: 10p tentative; C_0402_1005Metric
C13: 2.2u 10V; C_0402_1005Metric
C14: 2.2u; C_0402_1005Metric
C15: 10u 10V effective >=1u; C_0603_1608Metric
C27: 22u effective TBD; C_0603_1608Metric
C28: 10n; C_0402_1005Metric
C29: 100n 10V; C_0402_1005Metric
C30: 10n tentative; C_0402_1005Metric
D6: amber LED 0402 TBD; LED_0402_1005Metric
J1: USB4105-GF-A (candidate); USB_C_GCT_USB4105_GroundLand112
J2: 0781710003 / 100mAh protected NTC pack TBD; Molex_Pico-EZmate_78171-0003_1x03-1MP_P1.20mm_Vertical
J3: TC2030 SWD target pads; Tag-Connect_TC2030-IDC-NL_2x03_P1.27mm_Vertical
Q3: 2N7002 (VBUS detect); SOT-23
Q4: 2N7002; SOT-23
R1: 0R; R_0402_1005Metric
R2: 10k; R_0402_1005Metric
R3, R4, R12, R13, R15, R22, R36: 100k; R_0402_1005Metric
R6, R7: 5.1k 1%; R_0402_1005Metric
R8, R9: 0R tuning; R_0402_1005Metric
R10: 15k 1%; R_0402_1005Metric
R11: 20k 1%; R_0402_1005Metric
R14: 1M; R_0402_1005Metric
R21, R23: 22R tentative; R_0402_1005Metric
R24, R25, R28: 47k; R_0402_1005Metric
R32: 6.8k tentative; R_0402_1005Metric
R33, R34: 1M 1%; R_0402_1005Metric
R35, R37, R38, R40, R43: 10k 1%; R_0402_1005Metric
R39: 12.1k 1%; R_0402_1005Metric
R41: 8.25k 1%; R_0402_1005Metric
R42: 24k 1%; R_0402_1005Metric
SW1: B3U-1000P (candidate); SW_SPST_B3U-1000P
TP1, TP2, TP3, TP5, TP6: TestPoint; TestPoint_Pad_D1.0mm
U1: STM32U535CEU6; QFN-48-1EP_7x7mm_P0.5mm_EP5.6x5.6mm
U2: USBLC6-2P6; SOT-666
U3: BQ25185DLHR; Texas_DLH0010A_WSON-10-1EP_2.2x2mm_P0.4mm_EP0.9x1.5mm
U4: TPS7A0233PDBVR; SOT-23-5
U8: IM69D130V01XTSA1; Infineon_PG-LLGA-5-1
U10: TPS22916CYFPR; TPS22916_YFP4
U11: CSNP4GCR01-DPW; CSNP4GCR01_DPW_LGA8
U12: TLV7042DDFR; SOT-23-8
Y1: 32.768kHz CL=7pF TBD; Crystal_SMD_2012-2Pin_2.0x1.2mm

Connections:
BAT: C14.1, J2.1 (PACK+), R33.1, TP1.1, U3.2 (BAT)
BAT_ADC: C28.1, R33.2, R34.1, U1.11 (PA1)
BAT_TS: J2.2 (PACK_NTC), R37.2, U12.2 (INA-), U12.5 (INB+)
BOOT0: R3.1, U1.44 (PH3)
BUTTON_N: R4.2, SW1.1, U1.26 (PB13)
CC1: J1.A5 (CC1), R6.1
CC2: J1.B5 (CC2), R7.1
CHARGER_TS: R35.1, U3.6 (TS_MR)
CHG_ALLOW: R43.1, U1.20 (PB2)
CHG_GUARD_GATE: Q4.1 (G), R36.1, R43.2, U12.1 (OUTA), U12.7 (OUTB)
CHG_INHIBIT_GATE: Q4.3 (D), R12.2, U3.4 (CE_N)
CHG_N: R11.2, U1.27 (PB14), U3.9 (STAT1)
GND: C1.2, C2.2, C3.2, C4.2, C5.2, C6.2, C7.2, C9.2, C11.2, C12.2, C13.2, C14.2, C15.2, C16.2, C22.2, C25.2, C26.2, C27.2, C28.2, C29.2, C30.2, D6.1 (K), J1.A1 (GND), J1.A12 (GND), J1.B1 (GND), J1.B12 (GND), J1.SH (SHIELD), J2.3 (PACK-), J3.5 (GND), Q3.2 (S), Q4.2 (S), R3.2, R6.2, R7.2, R10.2, R14.2, R22.2, R34.2, R35.2, R36.2, R39.2, R41.2, R42.2, SW1.2, TP6.1, U1.8 (VSSA), U1.23 (VSS), U1.35 (VSS), U1.47 (VSS), U1.49 (VSS), U2.2 (GND), U3.5 (GND), U3.11 (EP), U4.2 (GND), U8.4 (SELECT), U8.5 (GND), U10.B1 (GND), U11.4 (VSS), U12.4 (VEE)
ILIM_VSET: R42.1, U3.7 (ILIM_VSET)
ISET: C30.1, R10.1, U3.8 (ISET)
LSE_IN: C11.1, U1.3 (PC14), Y1.1
LSE_OUT: C12.1, U1.4 (PC15), Y1.2
NRST: C9.1, J3.3 (nRESET), R2.2, U1.7 (NRST)
PDM_CLK: R21.2, U8.3 (CLOCK)
PDM_CLK_MCU: R21.1, U1.39 (PB3)
PDM_DATA: U1.40 (PB4), U8.1 (DATA)
SD_CLK: R23.2, U11.3 (CLK)
SD_CLK_MCU: R23.1, U1.15 (PA5)
SD_CS_N: R28.2, U1.14 (PA4), U11.2 (CS_N)
SD_EN: R22.1, U1.18 (PB0), U10.B2 (ON)
SD_MISO: R25.2, U1.16 (PA6), U11.6 (DO)
SD_MOSI: R24.2, U1.17 (PA7), U11.5 (DI)
SD_V3: C26.1, C27.1, R24.1, R25.1, R28.1, TP5.1, U10.A1 (VOUT), U11.8 (VCC)
STATUS_LED: R32.1, U1.29 (PA8)
STATUS_LED_A: D6.2 (A), R32.2
SWCLK: J3.4 (SWCLK), U1.37 (PA14)
SWDIO: J3.2 (SWDIO), U1.34 (PA13)
SYS: C15.1, TP2.1, U3.1 (SYS), U4.1 (IN), U4.3 (EN)
TS_COLD_REF: R38.2, R39.1, U12.3 (INA+)
TS_HOT_REF: R40.2, R41.1, U12.6 (INB-)
USB_DM: J1.A7 (D-), J1.B7 (D-), R9.1, U2.3 (IO2), U2.4 (IO2)
USB_DM_MCU: R9.2, U1.32 (PA11)
USB_DP: J1.A6 (D+), J1.B6 (D+), R8.1, U2.1 (IO1), U2.6 (IO1)
USB_DP_MCU: R8.2, U1.33 (PA12)
V3V3: C1.1, C2.1, C3.1, C4.1, C16.1, C22.1, C25.1, J3.1 (VTref), R1.1, R2.1, R4.1, R11.1, R15.1, TP3.1, U1.1 (VBAT), U1.24 (VDD), U1.36 (VDD), U1.48 (VDD), U4.5 (OUT), U8.2 (VDD), U10.A2 (VIN)
VBUS: C13.1, C29.1, J1.A4 (VBUS), J1.A9 (VBUS), J1.B4 (VBUS), J1.B9 (VBUS), R12.1, R13.1, R37.1, R38.1, R40.1, U2.5 (VBUS), U3.10 (IN), U12.8 (VCC)
VBUS_GATE: Q3.1 (G), R13.2, R14.1
VBUS_N: Q3.3 (D), R15.2, U1.10 (PA0)
VCAP: C5.1, U1.22 (VCAP)
VDDA: C6.1, C7.1, R1.2, U1.9 (VDDA)

Notes on the sheet:
01 MCU / RTC / UI
02 USB-C / CHARGER
03 POWER / FUEL GAUGE
04 AUDIO / SD / INDICATORS
ENGINEERING DRAFT - NOT FOR FABRICATION - See hardware/mini-usb-v9/README.md
