nyanko3141592/pendant-recorder/firmware/stm32/board/storage_power_pins.h

#ifndef PENDANT_STORAGE_POWER_PINS_H
#define PENDANT_STORAGE_POWER_PINS_H
/* Canonical xe-minimal: U1 PB5 -> SD_EN -> U10 TPS22917DBVT. */
#define STORAGE_ENABLE_PORT GPIOB
#define STORAGE_ENABLE_PIN GPIO_PIN_5
#endif
