nyanko3141592/pendant-recorder/(commit log)

2026-10-24 設計のたたき台
2026-10-24 Omi調査を追加し、Omi-clone(nRF52840/Zephyr)パスを本命に: docs/omi-reference.md, reference/omi, AGENTS.md, Cursor rules
    [omi-bom.csv]
2026-10-24 要件確定とカスタム基板設計: STM32U535+T5838+SD NAND案, requirements.md, custom-pcb.md
2026-10-24 Add Omi-derived Rev A circuit draft and SolidCraft enclosure fit study
    [bom.csv, connections.csv, pendant-fit-study.step, pendant-rev-a.kicad_sch]
2026-10-24 Specify charge-only default with explicit USB sync selection
2026-10-24 Require on-device indicators and add battery and status LED circuits
    [bom.csv, connections.csv, pendant-rev-a.kicad_sch]
2026-10-24 Define practical DIY v1 scope with dense PCB and simple enclosure
2026-10-24 Target Omi-sized wearable enclosure for v1
2026-10-24 Target 48-hour recording and compare Omi-sized battery envelopes
2026-10-24 Prioritize procurable DTP401525 pack and derive enclosure from battery
2026-10-24 Plan JLCPCB assembly with sourcing and manufacturing acceptance gates
2026-10-24 Prioritize solder-free final assembly with fitted connectors
2026-10-24 Add A1 netted PCB placement study and package footprints
    [bom.csv, connections.csv, pendant-rev-a.kicad_pcb, pendant-rev-a.kicad_sch, placement-review.csv]
2026-10-24 Add explodable A1 structure viewer and SolidCraft models
    [assembled.step, exploded.step]
2026-10-24 Model thinner A2 stack with battery and PH connector side by side
    [assembled.step, exploded.step]
2026-10-24 Define solder-free v1 validation cycle and open-source product model
2026-10-24 Advance v1 sourcing audit, standard SWD connection and audio profile validation
    [bom.csv, connections.csv, pendant-rev-a.kicad_pcb, pendant-rev-a.kicad_sch, placement-review.csv]
2026-10-24 Require standard storage formats and power-loss recovery validation
2026-10-24 Separate 36-hour storage from battery runtime and prioritize BLE evaluation
2026-10-24 Select integrated antenna for Rev B hardware
2026-10-24 Build Rev B electrical and routed PCB draft with SolidCraft enclosure study
    [assembled.step, bom.csv, connections.csv, exploded.step, input.dsn, interior.step, pcb-net-audit.json, pendant-rev-b.kicad_pcb]
2026-10-24 Add same-scale A2 and Rev B CAD comparison with 500 yen coin
    [comparison.step]
2026-10-24 Include Omi official size envelope in CAD comparison
    [comparison.step]
2026-10-24 Prioritize smallest enclosure with 16h recording and optional wireless
2026-10-24 Define minimal 16h V1 and add Rev C circuit, placement and size comparison
    [assembled.step, bom.csv, comparison.step, connections.csv, exploded.step, input.dsn, pcb-net-audit.json, pendant-rev-c.kicad_pcb]
2026-10-24 Document Omi-size battery and continuous-recording power feasibility
2026-10-24 Add Omi-scale D0 footprint study, SolidCraft structure and runtime analysis
    [assembled.step, exploded.step, omi-fit-d0.kicad_pcb]
2026-10-24 Redesign D1 with circular PCB, compact translator and round SolidCraft enclosure
    [assembled.step, bom.csv, connections.csv, exploded.step, omi-fit-d1.kicad_pcb, omi-fit-d1.kicad_sch]
2026-10-24 Specify pendant attachment and worn-use design requirements
2026-10-24 Add pendant case retention and acoustic duct; record partial routing and order gates
    [assembled.step, exploded.step, first-pass.kicad_pcb, input.dsn, omi-fit-d1.kicad_pcb, refine-base.kicad_pcb, refine.dsn]
2026-10-24 Route circular D1.1 and prepare unreleased DFM package
    [BOM-CANDIDATE-NOT-RELEASED.csv, assembled.step, bom.csv, connections.csv, exploded.step, kicad-positions.csv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]
2026-10-24 Normalize review CSV outputs and refresh checksums
    [BOM-CANDIDATE-NOT-RELEASED.csv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]
2026-10-24 Document pre-order gates and reproducible five-unit prototype budget
2026-10-24 Select stocked battery design baseline and calculate runtime sensitivity
    [runtime.csv]
2026-10-24 Create Rev E circuit and placement draft with stocked battery enclosure model
    [assembled.step, bom.csv, connections.csv, exploded.step, pendant-rev-e.kicad_pcb, pendant-rev-e.kicad_sch]
2026-10-24 Add compact A/B placement, partial routing and SolidCraft comparison studies
    [a-assembled.step, a-exploded.step, b-assembled.step, b-exploded.step, bom.csv, compact-a.kicad_pcb, compact-a.kicad_sch, compact-b.kicad_pcb]
2026-10-25 Add printable A/B size mockups and refine compact PCB placement
    [Pendant_A_size_38x39x8.9mm.3mf, Pendant_A_size_38x39x8.9mm.stl, Pendant_B_size_20x39x14.5mm.3mf, Pendant_B_size_20x39x14.5mm.stl, bom.csv, compact-b.kicad_pcb, compact-b.kicad_sch, connections.csv]
2026-10-25 Add separate printable A/B fit-check case kits
    [Pendant_A_size_38x39x8.9mm.3mf, Pendant_A_size_38x39x8.9mm.stl, Pendant_B_size_20x39x14.5mm.3mf, Pendant_B_size_20x39x14.5mm.stl, assembled.step, battery.3mf, battery.stl, body.3mf]
2026-10-25 Add single-plate A/B 3MF verified with Bambu Studio
    [Pendant_AB_FC1_Bambu_single-plate.3mf]
2026-10-25 Implement and route default-inhibited NTC charging guard prototype
    [bom.csv, connections.csv, pendant-charge-guard-v4.kicad_pcb, pendant-charge-guard-v4.kicad_sch, route.dsn]
2026-10-25 Prepare v4 quotation package and separate prototype validation gates
    [BOM-QUOTE-NOT-RELEASED.csv, kicad-positions.csv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]
2026-10-25 Record authorized JLC upload and assembly quotation prerequisites
2026-10-25 Create compact 100mAh circuit and separate printable fit models
    [assembled.step, battery_100mAh_15x17x6.3mf, battery_100mAh_15x17x6.step, battery_100mAh_15x17x6.stl, bom.csv, case_body.3mf, case_body.step, case_body.stl]
2026-10-25 Bundle custom footprints for portable v5 CAD archive
2026-10-25 Add rounded edge v6 appearance models for print evaluation
    [rounded_back_half_print_flat.3mf, rounded_back_half_print_flat.step, rounded_back_half_print_flat.stl, rounded_front_half_print_flat.3mf, rounded_front_half_print_flat.step, rounded_front_half_print_flat.stl, rounded_whole_26x31x14.3mf, rounded_whole_26x31x14.step]
2026-10-29 Consolidate first-prototype design and prioritize usability, size and cost
    [0781710003-ap203.stp, 0781710003.stp, 0781720003.stp, ASSEMBLY-NOT-PRINT-RELEASE.step, ASSEMBLY-NOT-RELEASED.step, BOM-ENGINEERING-REVIEW.csv, BOM-JLC-CANDIDATE-NOT-RELEASED.csv, BOM-JLC-QUOTE.csv]
2026-10-29 Complete conditional first-prototype design with wire bay and sourced C30
    [assembly-bom-review.csv, assembly.step, battery-max.step, battery-max.stl, carrier.step, carrier.stl, case-lower.step, case-lower.stl]
